RealTimeAudioLab/RTAL-EAI-004-Phoenix-Sound-Sampler/doc/Phoenix_v1_1_0_Arduino_Settings.pdf

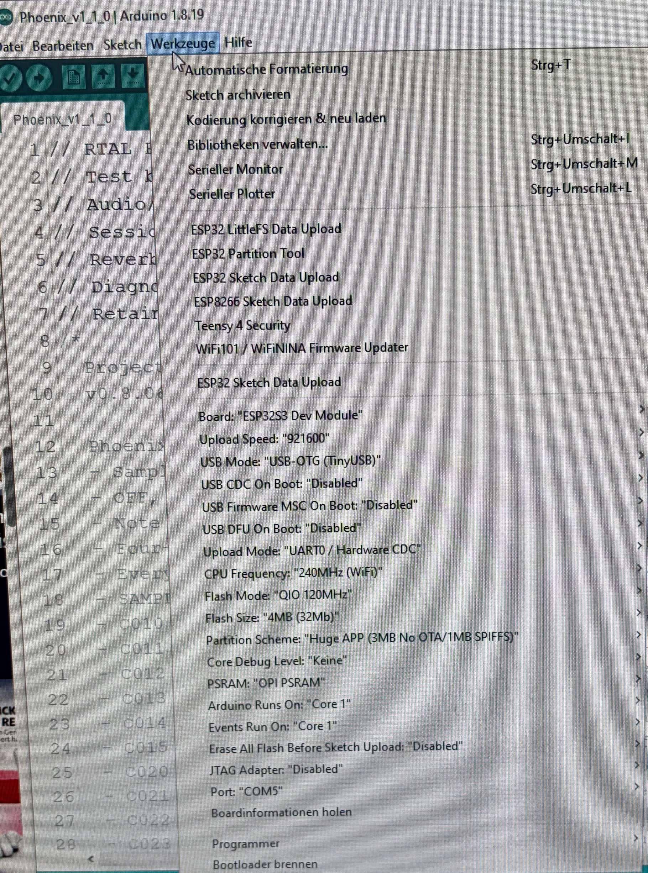
[picture p6: figure]
