RealTimeAudioLab/RTAL-EAI-004-Phoenix-Sound-Sampler/schematic/Phoenix_v1_0_0_Schaltplan.pdf

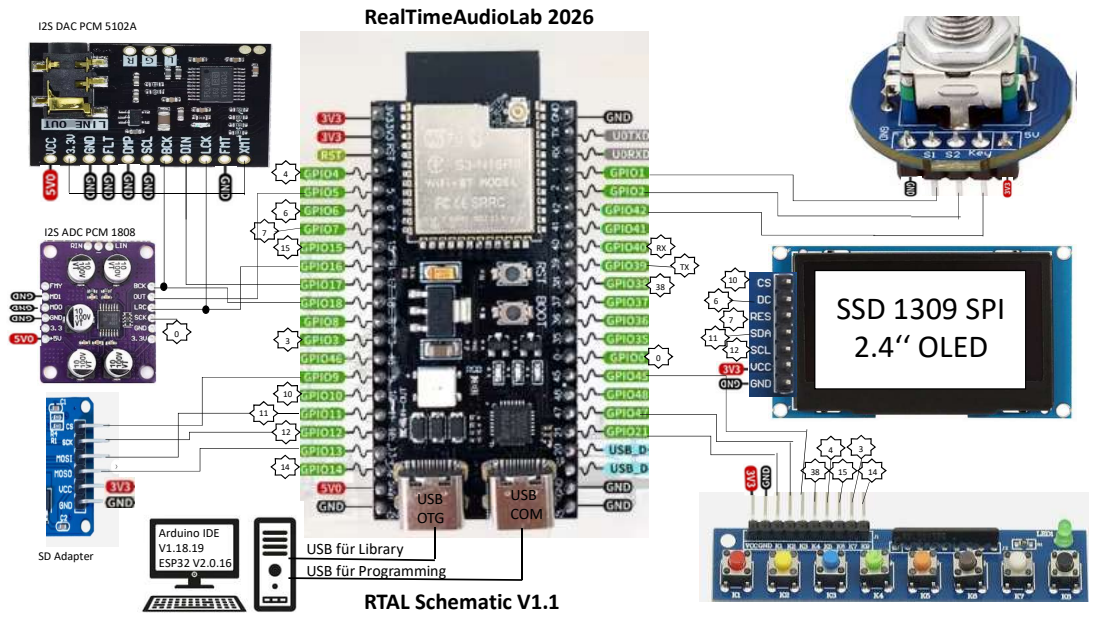
[picture p7: page 1]
Arduino IDE V1.18.19 ESP32 V2.0.16; SSD 1309 SPI 2.4‘‘ OLED; I2S ADC PCM 1808; SD Adapter; USB OTG; USB COM

RealTimeAudioLab 2026 I2S DAC PCM 5102A

USB für Library
USB für Programming
RTAL Schematic V1.1

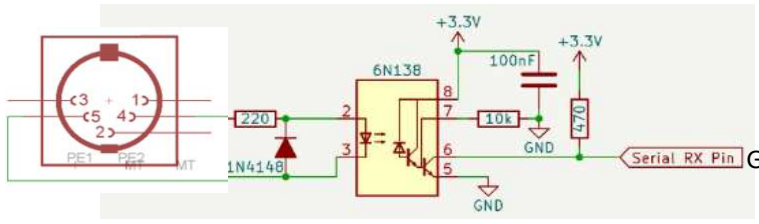
[picture p8: figure]
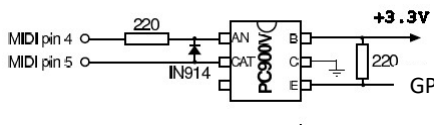
[picture p9: figure]

GPIO 40

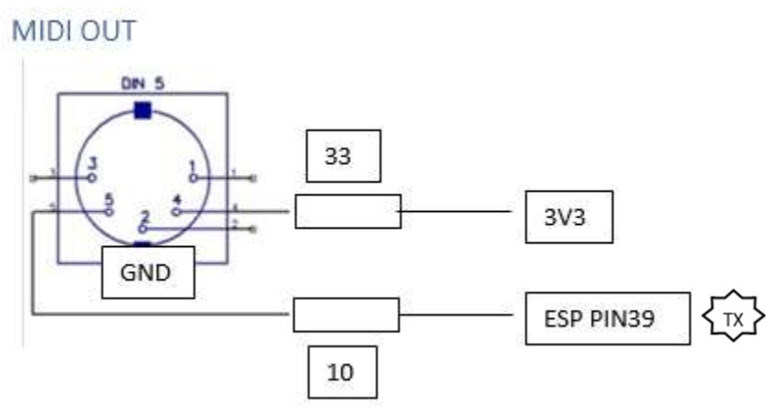
[picture p10: figure]

GPIO 40

MIDI Input mit 6N138 Optokoppler

(alternativ) MIDI Input mit PC900 Optokoppler

MIDI Output
