RealTimeAudioLab/RTAL-EAI-004-Phoenix-Sound-Sampler/sd_card_content/PHOENIX/BANKS/BANK01/BANK.CFG

PROJECT_PHOENIX_BANK=1
BANK_VERSION=15
[GLOBAL]
ECHO_DELAY_MS=375
ECHO_FEEDBACK=30
ECHO_MIX=22
TRIGGER_AUTO=1
TRIGGER_LEVEL=4
REPLAY_REVERSE=0
QUATTRO_MODE=1
[SLOT1]
RECORDED=0
SAMPLE_RATE=32000
FRAME_COUNT=0
SAMPLE_START=0
SAMPLE_END=0
TRIM_ENABLED=0
DC_ENABLED=0
NORMALIZE_ENABLED=0
LOOP=0
LOOP_MODE=0
LOOP_XFADE_MS=0
LOOP_START=0
LOOP_END=0
COARSE=0
FINE=0
ROOT=60
PITCH_BEND_RANGE=2
KEY_LOW=0
KEY_HIGH=127
MIDI_CHANNEL=1
OCTAVE=0
PITCH_TRACK=1
ATTACK_MS=0
DECAY_MS=35
SUSTAIN_PCT=100
RELEASE_MS=35
VINTAGE_PRESET=1
VINTAGE_RATE=4
VINTAGE_BITS=4
VINTAGE_FILTER=1
VINTAGE_JITTER=7
ECHO_SEND=5
SAMPLE_GAIN=100
VELOCITY_AMOUNT=100
LEVEL=92
PAN=0
FILTER_CUTOFF=90
FILTER_RESONANCE=5
FILTER_ENV_AMOUNT=0
FILTER_VELOCITY=0
FILTER_KEYTRACK=0
FILTER_ATTACK_MS=0
FILTER_DECAY_MS=90
FILTER_SUSTAIN=0
FILTER_RELEASE_MS=70
VOICE_MODE=0
VOICE_LIMIT=12
NOTE_PRIORITY=0
GLIDE_MS=0
REPLAY_REVERSE=0
[SLOT2]
RECORDED=0
SAMPLE_RATE=32000
FRAME_COUNT=0
SAMPLE_START=0
SAMPLE_END=0
TRIM_ENABLED=0
DC_ENABLED=0
NORMALIZE_ENABLED=0
LOOP=0
LOOP_MODE=0
LOOP_XFADE_MS=0
LOOP_START=0
LOOP_END=0
COARSE=0
FINE=0
ROOT=60
PITCH_BEND_RANGE=2
KEY_LOW=0
KEY_HIGH=127
MIDI_CHANNEL=2
OCTAVE=0
PITCH_TRACK=1
ATTACK_MS=2
DECAY_MS=60
SUSTAIN_PCT=88
RELEASE_MS=80
VINTAGE_PRESET=2
VINTAGE_RATE=3
VINTAGE_BITS=3
VINTAGE_FILTER=1
VINTAGE_JITTER=3
ECHO_SEND=4
SAMPLE_GAIN=100
VELOCITY_AMOUNT=100
LEVEL=94
PAN=0
FILTER_CUTOFF=56
FILTER_RESONANCE=24
FILTER_ENV_AMOUNT=24
FILTER_VELOCITY=8
FILTER_KEYTRACK=20
FILTER_ATTACK_MS=5
FILTER_DECAY_MS=170
FILTER_SUSTAIN=18
FILTER_RELEASE_MS=250
VOICE_MODE=0
VOICE_LIMIT=12
NOTE_PRIORITY=0
GLIDE_MS=0
REPLAY_REVERSE=0
[SLOT3]
RECORDED=0
SAMPLE_RATE=32000
FRAME_COUNT=0
SAMPLE_START=0
SAMPLE_END=0
TRIM_ENABLED=0
DC_ENABLED=0
NORMALIZE_ENABLED=0
LOOP=0
LOOP_MODE=0
LOOP_XFADE_MS=0
LOOP_START=0
LOOP_END=0
COARSE=0
FINE=0
ROOT=60
PITCH_BEND_RANGE=2
KEY_LOW=0
KEY_HIGH=127
MIDI_CHANNEL=3
OCTAVE=0
PITCH_TRACK=1
ATTACK_MS=5
DECAY_MS=90
SUSTAIN_PCT=85
RELEASE_MS=210
VINTAGE_PRESET=0
VINTAGE_RATE=0
VINTAGE_BITS=0
VINTAGE_FILTER=0
VINTAGE_JITTER=0
ECHO_SEND=34
SAMPLE_GAIN=100
VELOCITY_AMOUNT=100
LEVEL=78
PAN=-8
FILTER_CUTOFF=62
FILTER_RESONANCE=14
FILTER_ENV_AMOUNT=24
FILTER_VELOCITY=8
FILTER_KEYTRACK=16
FILTER_ATTACK_MS=12
FILTER_DECAY_MS=250
FILTER_SUSTAIN=40
FILTER_RELEASE_MS=360
VOICE_MODE=0
VOICE_LIMIT=12
NOTE_PRIORITY=0
GLIDE_MS=0
REPLAY_REVERSE=0
[SLOT4]
RECORDED=0
SAMPLE_RATE=32000
FRAME_COUNT=0
SAMPLE_START=0
SAMPLE_END=0
TRIM_ENABLED=0
DC_ENABLED=0
NORMALIZE_ENABLED=0
LOOP=0
LOOP_MODE=0
LOOP_XFADE_MS=0
LOOP_START=0
LOOP_END=0
COARSE=0
FINE=0
ROOT=60
PITCH_BEND_RANGE=2
KEY_LOW=0
KEY_HIGH=127
MIDI_CHANNEL=4
OCTAVE=0
PITCH_TRACK=1
ATTACK_MS=1
DECAY_MS=55
SUSTAIN_PCT=82
RELEASE_MS=110
VINTAGE_PRESET=3
VINTAGE_RATE=5
VINTAGE_BITS=4
VINTAGE_FILTER=2
VINTAGE_JITTER=9
ECHO_SEND=46
SAMPLE_GAIN=100
VELOCITY_AMOUNT=100
LEVEL=82
PAN=16
FILTER_CUTOFF=78
FILTER_RESONANCE=18
FILTER_ENV_AMOUNT=20
FILTER_VELOCITY=14
FILTER_KEYTRACK=12
FILTER_ATTACK_MS=2
FILTER_DECAY_MS=120
FILTER_SUSTAIN=25
FILTER_RELEASE_MS=220
VOICE_MODE=0
VOICE_LIMIT=12
NOTE_PRIORITY=0
GLIDE_MS=0
REPLAY_REVERSE=0
