RealTimeAudioLab/RTAL-EAI-004-Phoenix-Sound-Sampler/sd_card_content/PHOENIX/BANKS/BANK01/MULTISAMPLE.CFG

VERSION=10

[SLOT1_GROUP1]
LOW=36
HIGH=36
ROOT=36
TRANSPOSE=0
FINE_CENT=0
KEYTRACK_PCT=100
CHOKE=0
ONE_SHOT=1
CHOKE_FADE_MS=8
PLAY_MODE=0
EXCLUSIVE_GROUP=0
RETRIGGER=0
START_PCT=0
END_PCT=100
REVERSE=0
ENABLED=1

[SLOT1_GROUP1_LAYER1]
VEL_LOW=1
VEL_HIGH=127
LEVEL=94
PAN=0
ENABLED=1
RR_MODE=0
LOOP_MODE=0
LOOP_START_PCT=0
LOOP_END_PCT=100
LOOP_XFADE_MS=0
VEL_TO_LEVEL=30
VEL_TO_FILTER=0
RR1_FILE=/PHOENIX/BANKS/BANK01/Kick.wav

[SLOT1_GROUP2]
LOW=38
HIGH=38
ROOT=38
TRANSPOSE=0
FINE_CENT=0
KEYTRACK_PCT=100
CHOKE=0
ONE_SHOT=1
CHOKE_FADE_MS=8
PLAY_MODE=0
EXCLUSIVE_GROUP=0
RETRIGGER=0
START_PCT=0
END_PCT=100
REVERSE=0
ENABLED=1

[SLOT1_GROUP2_LAYER1]
VEL_LOW=1
VEL_HIGH=127
LEVEL=84
PAN=-8
ENABLED=1
RR_MODE=0
LOOP_MODE=0
LOOP_START_PCT=0
LOOP_END_PCT=100
LOOP_XFADE_MS=0
VEL_TO_LEVEL=30
VEL_TO_FILTER=0
RR1_FILE=/PHOENIX/BANKS/BANK01/Snare.wav

[SLOT1_GROUP3]
LOW=46
HIGH=46
ROOT=46
TRANSPOSE=0
FINE_CENT=0
KEYTRACK_PCT=100
CHOKE=0
ONE_SHOT=1
CHOKE_FADE_MS=8
PLAY_MODE=0
EXCLUSIVE_GROUP=0
RETRIGGER=0
START_PCT=0
END_PCT=100
REVERSE=0
ENABLED=1

[SLOT1_GROUP3_LAYER1]
VEL_LOW=1
VEL_HIGH=127
LEVEL=66
PAN=25
ENABLED=1
RR_MODE=0
LOOP_MODE=0
LOOP_START_PCT=0
LOOP_END_PCT=100
LOOP_XFADE_MS=0
VEL_TO_LEVEL=30
VEL_TO_FILTER=0
RR1_FILE=/PHOENIX/BANKS/BANK01/OpenHiHat.wav

[SLOT1_GROUP4]
LOW=56
HIGH=56
ROOT=56
TRANSPOSE=0
FINE_CENT=0
KEYTRACK_PCT=100
CHOKE=0
ONE_SHOT=1
CHOKE_FADE_MS=8
PLAY_MODE=0
EXCLUSIVE_GROUP=0
RETRIGGER=0
START_PCT=0
END_PCT=100
REVERSE=0
ENABLED=1

[SLOT1_GROUP4_LAYER1]
VEL_LOW=1
VEL_HIGH=127
LEVEL=57
PAN=-24
ENABLED=1
RR_MODE=0
LOOP_MODE=0
LOOP_START_PCT=0
LOOP_END_PCT=100
LOOP_XFADE_MS=0
VEL_TO_LEVEL=30
VEL_TO_FILTER=0
RR1_FILE=/PHOENIX/BANKS/BANK01/Cowbell.wav

[SLOT2_GROUP1]
LOW=36
HIGH=72
ROOT=60
TRANSPOSE=0
FINE_CENT=0
KEYTRACK_PCT=100
CHOKE=0
ONE_SHOT=0
CHOKE_FADE_MS=8
PLAY_MODE=0
EXCLUSIVE_GROUP=0
RETRIGGER=0
START_PCT=0
END_PCT=100
REVERSE=0
ENABLED=1

[SLOT2_GROUP1_LAYER1]
VEL_LOW=1
VEL_HIGH=127
LEVEL=100
PAN=0
ENABLED=1
RR_MODE=0
LOOP_MODE=0
LOOP_START_PCT=0
LOOP_END_PCT=100
LOOP_XFADE_MS=0
VEL_TO_LEVEL=30
VEL_TO_FILTER=0
RR1_FILE=/PHOENIX/BANKS/BANK01/Bass_C3.wav

[SLOT3_GROUP1]
LOW=48
HIGH=84
ROOT=60
TRANSPOSE=0
FINE_CENT=0
KEYTRACK_PCT=100
CHOKE=0
ONE_SHOT=0
CHOKE_FADE_MS=8
PLAY_MODE=0
EXCLUSIVE_GROUP=0
RETRIGGER=0
START_PCT=0
END_PCT=100
REVERSE=0
ENABLED=1

[SLOT3_GROUP1_LAYER1]
VEL_LOW=1
VEL_HIGH=80
LEVEL=82
PAN=-15
ENABLED=1
RR_MODE=0
LOOP_MODE=0
LOOP_START_PCT=0
LOOP_END_PCT=100
LOOP_XFADE_MS=0
VEL_TO_LEVEL=30
VEL_TO_FILTER=0
RR1_FILE=/PHOENIX/BANKS/BANK01/Glide_C3.wav

[SLOT3_GROUP1_LAYER2]
VEL_LOW=81
VEL_HIGH=127
LEVEL=72
PAN=12
ENABLED=1
RR_MODE=0
LOOP_MODE=0
LOOP_START_PCT=0
LOOP_END_PCT=100
LOOP_XFADE_MS=0
VEL_TO_LEVEL=30
VEL_TO_FILTER=0
RR1_FILE=/PHOENIX/BANKS/BANK01/Space_C3.wav

[SLOT4_GROUP1]
LOW=48
HIGH=96
ROOT=60
TRANSPOSE=0
FINE_CENT=0
KEYTRACK_PCT=100
CHOKE=0
ONE_SHOT=1
CHOKE_FADE_MS=8
PLAY_MODE=0
EXCLUSIVE_GROUP=0
RETRIGGER=0
START_PCT=0
END_PCT=100
REVERSE=0
ENABLED=1

[SLOT4_GROUP1_LAYER1]
VEL_LOW=1
VEL_HIGH=127
LEVEL=82
PAN=18
ENABLED=1
RR_MODE=0
LOOP_MODE=0
LOOP_START_PCT=0
LOOP_END_PCT=100
LOOP_XFADE_MS=0
VEL_TO_LEVEL=30
VEL_TO_FILTER=0
RR1_FILE=/PHOENIX/BANKS/BANK01/Rave_C3.wav
