RealTimeAudioLab/RTAL-EAI-004-Phoenix-Sound-Sampler/sd_card_content/PHOENIX/BANKS/BANK01/PATTERNS.CFG

VERSION=1
CURRENT_PATTERN=1
CLOCK_MODE=INT
BPM=120

[P1]
TRACK1_LENGTH=16
T1_STEP1=1,36,112,100
T1_STEP2=0,60,100,50
T1_STEP3=1,46,48,100
T1_STEP4=0,60,100,50
T1_STEP5=1,38,88,100
T1_STEP6=0,60,100,50
T1_STEP7=1,46,54,100
T1_STEP8=0,60,100,50
T1_STEP9=1,36,105,100
T1_STEP10=0,60,100,50
T1_STEP11=1,46,50,100
T1_STEP12=0,60,100,50
T1_STEP13=1,38,92,100
T1_STEP14=0,60,100,50
T1_STEP15=1,46,58,100
T1_STEP16=0,60,100,50
TRACK2_LENGTH=16
T2_STEP1=1,48,98,80
T2_STEP2=0,60,100,50
T2_STEP3=0,60,100,50
T2_STEP4=0,60,100,50
T2_STEP5=0,60,100,50
T2_STEP6=0,60,100,50
T2_STEP7=0,60,100,50
T2_STEP8=0,60,100,50
T2_STEP9=1,43,90,80
T2_STEP10=0,60,100,50
T2_STEP11=0,60,100,50
T2_STEP12=0,60,100,50
T2_STEP13=1,46,82,55
T2_STEP14=0,60,100,50
T2_STEP15=0,60,100,50
T2_STEP16=0,60,100,50
TRACK3_LENGTH=16
T3_STEP1=1,60,62,100
T3_STEP2=0,60,100,50
T3_STEP3=0,60,100,50
T3_STEP4=0,60,100,50
T3_STEP5=1,63,66,100
T3_STEP6=0,60,100,50
T3_STEP7=0,60,100,50
T3_STEP8=0,60,100,50
T3_STEP9=1,67,70,100
T3_STEP10=0,60,100,50
T3_STEP11=0,60,100,50
T3_STEP12=0,60,100,50
T3_STEP13=1,58,64,100
T3_STEP14=0,60,100,50
T3_STEP15=0,60,100,50
T3_STEP16=0,60,100,50
TRACK4_LENGTH=16
T4_STEP1=0,60,100,50
T4_STEP2=0,60,100,50
T4_STEP3=0,60,100,50
T4_STEP4=0,60,100,50
T4_STEP5=0,60,100,50
T4_STEP6=0,60,100,50
T4_STEP7=0,60,100,50
T4_STEP8=0,60,100,50
T4_STEP9=0,60,100,50
T4_STEP10=0,60,100,50
T4_STEP11=0,60,100,50
T4_STEP12=0,60,100,50
T4_STEP13=0,60,100,50
T4_STEP14=0,60,100,50
T4_STEP15=0,60,100,50
T4_STEP16=0,60,100,50

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
T4_STEP4=0,60,100,50
T4_STEP5=0,60,100,50
T4_STEP6=0,60,100,50
T4_STEP7=0,60,100,50
T4_STEP8=1,79,92,70
T4_STEP9=0,60,100,50
T4_STEP10=0,60,100,50
T4_STEP11=0,60,100,50
T4_STEP12=0,60,100,50
T4_STEP13=0,60,100,50
T4_STEP14=0,60,100,50
T4_STEP15=0,60,100,50
T4_STEP16=1,72,100,70
