RealTimeAudioLab/RTAL-EAI-004-Phoenix-Sound-Sampler/firmware/Phoenix_v1.1.0/src/PhoenixOS/PhoenixOS.cpp

#include "../PhoenixSystem/PhoenixSerial.h"
#include "../PhoenixSystem/PhoenixFactoryDefaults.h"
#include "PhoenixOS.h"

static constexpr bool PHX_ENABLE_MIDI_CC_DEBUG = false;
static constexpr uint32_t PHX_MIDI_CC_DEBUG_MIN_MS = 100UL;
#include <esp_heap_caps.h>
#include <SD.h>
#include <SPI.h>
#include <stddef.h>
#include <string.h>
#include <strings.h>

static bool phxEnsureSD();
static bool phxBuildBankDir(uint8_t bank, char *out, size_t outSize);


// v1.1.0 DEV1: editable NEW BANK sound template. The format is intentionally
// not BANK.CFG and cannot contain WAV/sample file paths.
static const char *PHX_INIT_SOUND_CFG_PATH = "/PHOENIX/INIT_SOUND.CFG";
static constexpr uint8_t PHX_INIT_SOUND_CFG_VERSION = 1;

struct PhxInitSlotCfg {
  bool multisampleEnabled; uint8_t multisampleLow, multisampleHigh, multisampleRoot;
  int8_t coarse; int16_t fineCent; uint8_t rootNote; int8_t octave; bool pitchTracking; uint8_t pitchBendRange;
  uint16_t attackMs, decayMs; uint8_t sustainPct; uint16_t releaseMs;
  uint8_t level; int8_t pan; uint8_t sampleGainPct, velocityAmountPct;
  uint8_t filterCutoff, filterResonance; int8_t filterEnvAmount; uint8_t filterVelocityAmount, filterKeytrack;
  uint16_t filterAttackMs, filterDecayMs; uint8_t filterSustainPct; uint16_t filterReleaseMs;
  uint8_t vintagePreset, vintageSampleRate, vintageBitDepth, vintageFilter, vintageJitter;
  uint8_t voiceMode, voiceLimit, notePriority; uint16_t glideMs;
  uint8_t echoSend; uint8_t reverbSend; uint8_t quattroLow, quattroHigh, quattroMidiChannel;
};
struct PhxInitSoundCfg {
  uint8_t quattroMode; uint16_t echoDelayMs; uint8_t echoFeedback, echoMix; uint8_t reverbSize,reverbDecay,reverbDamp,reverbMix; PhxInitSlotCfg slot[4];
};

static void phxInitSoundFactory(PhxInitSoundCfg &c) {
  c.quattroMode=PhoenixFactoryDefaults::QUATTRO_MODE;
  c.echoDelayMs=PhoenixFactoryDefaults::ECHO_DELAY_MS; c.echoFeedback=PhoenixFactoryDefaults::ECHO_FEEDBACK; c.echoMix=PhoenixFactoryDefaults::ECHO_MIX; c.reverbSize=PhoenixFactoryDefaults::REVERB_SIZE; c.reverbDecay=PhoenixFactoryDefaults::REVERB_DECAY; c.reverbDamp=PhoenixFactoryDefaults::REVERB_DAMP; c.reverbMix=PhoenixFactoryDefaults::REVERB_MIX;
  for(uint8_t i=0;i<4;++i){ const auto &d=PhoenixFactoryDefaults::SLOT[i]; auto &o=c.slot[i];
    o.multisampleEnabled=d.multisampleEnabled; o.multisampleLow=d.multisampleLow; o.multisampleHigh=d.multisampleHigh; o.multisampleRoot=d.multisampleRoot;
    o.coarse=d.coarse;o.fineCent=d.fineCent;o.rootNote=d.rootNote;o.octave=d.octave;o.pitchTracking=d.pitchTracking;o.pitchBendRange=d.pitchBendRange;
    o.attackMs=d.attackMs;o.decayMs=d.decayMs;o.sustainPct=d.sustainPct;o.releaseMs=d.releaseMs;o.level=d.level;o.pan=d.pan;o.sampleGainPct=d.sampleGainPct;o.velocityAmountPct=d.velocityAmountPct;
    o.filterCutoff=d.filterCutoff;o.filterResonance=d.filterResonance;o.filterEnvAmount=d.filterEnvAmount;o.filterVelocityAmount=d.filterVelocityAmount;o.filterKeytrack=d.filterKeytrack;
    o.filterAttackMs=d.filterAttackMs;o.filterDecayMs=d.filterDecayMs;o.filterSustainPct=d.filterSustainPct;o.filterReleaseMs=d.filterReleaseMs;
    o.vintagePreset=d.vintagePreset;o.vintageSampleRate=d.vintageSampleRate;o.vintageBitDepth=d.vintageBitDepth;o.vintageFilter=d.vintageFilter;o.vintageJitter=d.vintageJitter;
    o.voiceMode=d.voiceMode;o.voiceLimit=d.voiceLimit;o.notePriority=d.notePriority;o.glideMs=d.glideMs;o.echoSend=d.echoSend;o.reverbSend=d.reverbSend;
    o.quattroLow=d.quattroLow;o.quattroHigh=d.quattroHigh;o.quattroMidiChannel=d.quattroMidiChannel;
  }
}
static int phxInitInt(const String &v,int lo,int hi){return constrain(v.toInt(),lo,hi);}
static bool phxLoadInitSoundCfg(PhxInitSoundCfg &c) {
  phxInitSoundFactory(c);
  if(!phxEnsureSD()) return false;
  File f=SD.open(PHX_INIT_SOUND_CFG_PATH,FILE_READ);
  if(!f) return false;
  String section=""; bool versionOk=false;
  while(f.available()){
    String line=f.readStringUntil('\n'); line.trim();
    if(!line.length()||line[0]=='#'||line[0]==';') continue;
    if(line[0]=='[' && line.endsWith("]")){section=line.substring(1,line.length()-1);section.toUpperCase();continue;}
    int eq=line.indexOf('='); if(eq<1) continue;
    String k=line.substring(0,eq); k.trim(); k.toUpperCase(); String v=line.substring(eq+1); v.trim();
    if(section.length()==0){if(k=="VERSION") versionOk=(v.toInt()==PHX_INIT_SOUND_CFG_VERSION); continue;}
    if(section=="GLOBAL"){if(k=="QUATTRO_MODE") c.quattroMode=(uint8_t)phxInitInt(v,0,1); continue;}
    if(section=="FX"){
      if(k=="ECHO_DELAY_MS") c.echoDelayMs=(uint16_t)phxInitInt(v,1,2000);
      else if(k=="ECHO_FEEDBACK") c.echoFeedback=(uint8_t)phxInitInt(v,0,95);
      else if(k=="ECHO_MIX") c.echoMix=(uint8_t)phxInitInt(v,0,100);
      else if(k=="REVERB_SIZE") c.reverbSize=(uint8_t)phxInitInt(v,0,100);
      else if(k=="REVERB_DECAY") c.reverbDecay=(uint8_t)phxInitInt(v,0,100);
      else if(k=="REVERB_DAMP") c.reverbDamp=(uint8_t)phxInitInt(v,0,100);
      else if(k=="REVERB_MIX") c.reverbMix=(uint8_t)phxInitInt(v,0,100);
      continue;
    }
    if(section.startsWith("SLOT")){
      int si=section.substring(4).toInt()-1; if(si<0||si>3) continue; auto &d=c.slot[si];
      if(k=="MULTISAMPLE_ENABLED")d.multisampleEnabled=(v.toInt()!=0); else if(k=="LOW")d.multisampleLow=(uint8_t)phxInitInt(v,0,127); else if(k=="HIGH")d.multisampleHigh=(uint8_t)phxInitInt(v,0,127); else if(k=="ROOT")d.multisampleRoot=(uint8_t)phxInitInt(v,0,127);
      else if(k=="COARSE")d.coarse=(int8_t)phxInitInt(v,-24,24); else if(k=="FINE_CENT")d.fineCent=(int16_t)phxInitInt(v,-100,100); else if(k=="ROOT_NOTE")d.rootNote=(uint8_t)phxInitInt(v,0,127); else if(k=="OCTAVE")d.octave=(int8_t)phxInitInt(v,-2,2); else if(k=="PITCH_TRACKING")d.pitchTracking=(v.toInt()!=0); else if(k=="PITCH_BEND_RANGE")d.pitchBendRange=(uint8_t)phxInitInt(v,0,24);
      else if(k=="ATTACK_MS")d.attackMs=(uint16_t)phxInitInt(v,0,2000); else if(k=="DECAY_MS")d.decayMs=(uint16_t)phxInitInt(v,0,2000); else if(k=="SUSTAIN_PCT")d.sustainPct=(uint8_t)phxInitInt(v,0,100); else if(k=="RELEASE_MS")d.releaseMs=(uint16_t)phxInitInt(v,0,2000);
      else if(k=="LEVEL")d.level=(uint8_t)phxInitInt(v,0,100); else if(k=="PAN")d.pan=(int8_t)phxInitInt(v,-100,100); else if(k=="SAMPLE_GAIN_PCT")d.sampleGainPct=(uint8_t)phxInitInt(v,0,200); else if(k=="VELOCITY_AMOUNT_PCT")d.velocityAmountPct=(uint8_t)phxInitInt(v,0,100);
      else if(k=="FILTER_CUTOFF")d.filterCutoff=(uint8_t)phxInitInt(v,0,100); else if(k=="FILTER_RESONANCE")d.filterResonance=(uint8_t)phxInitInt(v,0,100); else if(k=="FILTER_ENV_AMOUNT")d.filterEnvAmount=(int8_t)phxInitInt(v,-100,100); else if(k=="FILTER_VELOCITY")d.filterVelocityAmount=(uint8_t)phxInitInt(v,0,100); else if(k=="FILTER_KEYTRACK")d.filterKeytrack=(uint8_t)phxInitInt(v,0,100);
      else if(k=="FILTER_ATTACK_MS")d.filterAttackMs=(uint16_t)phxInitInt(v,0,2000); else if(k=="FILTER_DECAY_MS")d.filterDecayMs=(uint16_t)phxInitInt(v,0,2000); else if(k=="FILTER_SUSTAIN_PCT")d.filterSustainPct=(uint8_t)phxInitInt(v,0,100); else if(k=="FILTER_RELEASE_MS")d.filterReleaseMs=(uint16_t)phxInitInt(v,0,2000);
      else if(k=="VINTAGE_PRESET")d.vintagePreset=(uint8_t)phxInitInt(v,0,15); else if(k=="VINTAGE_SAMPLE_RATE")d.vintageSampleRate=(uint8_t)phxInitInt(v,0,100); else if(k=="VINTAGE_BIT_DEPTH")d.vintageBitDepth=(uint8_t)phxInitInt(v,0,100); else if(k=="VINTAGE_FILTER")d.vintageFilter=(uint8_t)phxInitInt(v,0,100); else if(k=="VINTAGE_JITTER")d.vintageJitter=(uint8_t)phxInitInt(v,0,100);
      else if(k=="VOICE_MODE")d.voiceMode=(uint8_t)phxInitInt(v,0,2); else if(k=="VOICE_LIMIT")d.voiceLimit=(uint8_t)phxInitInt(v,1,12); else if(k=="NOTE_PRIORITY")d.notePriority=(uint8_t)phxInitInt(v,0,2); else if(k=="GLIDE_MS")d.glideMs=(uint16_t)phxInitInt(v,0,2000);
      else if(k=="ECHO_SEND")d.echoSend=(uint8_t)phxInitInt(v,0,100); else if(k=="REVERB_SEND")d.reverbSend=(uint8_t)phxInitInt(v,0,100); else if(k=="QUATTRO_LOW")d.quattroLow=(uint8_t)phxInitInt(v,0,127); else if(k=="QUATTRO_HIGH")d.quattroHigh=(uint8_t)phxInitInt(v,0,127); else if(k=="MIDI_CHANNEL")d.quattroMidiChannel=(uint8_t)phxInitInt(v,1,16);
    }
  }
  f.close();
  if(!versionOk){phxInitSoundFactory(c);return false;}
  for(uint8_t i=0;i<4;++i){if(c.slot[i].multisampleHigh<c.slot[i].multisampleLow)c.slot[i].multisampleHigh=c.slot[i].multisampleLow;if(c.slot[i].quattroHigh<c.slot[i].quattroLow)c.slot[i].quattroHigh=c.slot[i].quattroLow;}
  return true;
}

PhoenixOS::PhoenixOS(PhoenixGUI &gui, PhoenixScreenManager &screens, PhoenixInputManager &input, PhoenixAudioManager &audio)
: _gui(gui), _screens(screens), _input(input), _audio(audio), _lastDrawMs(0), _perfWindowStartMs(0), _perfLoopAccumUs(0), _perfLoopCount(0), _perfLoopMaxUs(0), _perfDrawAccumUs(0), _perfDrawCount(0), _perfDrawMaxUs(0), _diagStartMs(0), _diagLoopAvgUs(0), _diagLoopPeakUs(0), _diagDrawAvgUs(0), _diagDrawPeakUs(0), _diagGuiFps10(0), _diagLastPublishMs(0), _midiCounter(nullptr), _seqLastStepMs(0), _seqWasRunning(false), _seqPreviewHeld(false), _seqPreviewTrack(0), _seqPreviewNote(60), _seqPreviewOffMs(0), _seqMidiTransportPending(0), _seqMidiLastClockUs(0), _seqMidiClockPeriodUs(0), _seqExtTickPhase(0), _seqExtLastSeenMs(0), _seqLastPattern(0), _seqDroppedClockTicks(0), _seqIdleClockTicksIgnored(0), _seqTransportStartCount(0), _seqTransportContinueCount(0), _seqTransportStopCount(0), _seqPatternTransitionCount(0), _seqGateRecycleCount(0), _seqForcedGateReleaseCount(0), _seqClockQueueDrops(0), _seqClockBatchMax(0), _seqStepLateMaxUs(0), _seqStepEventCount(0), _seqLastStepClockUs(0), _integrationBankQuiesceCount(0), _integrationBankLoadFailCount(0), _integrationBankSaveFailCount(0), _integrationStaleClockTicksCleared(0), _integrationActiveVoiceGuardCount(0), _songPatternStepCounter(0), _lastProgressPercent(255), _lastProgressDrawMs(0), _bootSessionRestoreActive(false), _bootSessionBank(0), _lastSessionSaveMs(0), _sessionBankCache(0), _sessionScreenCache(255), _sessionSlotCache(255), _sessionPendingBank(0), _sessionPendingScreen(255), _sessionPendingSlot(255), _sessionDirty(false), _sessionLastChangeMs(0) {
  _progressLabel[0] = 0;
  _midiEchoSync = false;
  _midiEchoTimeValue = 32;
  _midiModulationValue = 0;
  _midiLearnActive = false;
  _midiLearnParameter = 0;
  _midiLearnCcPending = -1;
  _sampleAnalysisPending = false;
  _sampleAnalysisSlot = 0;
  memset(_sampleProcessingRecalcDue, 0, sizeof(_sampleProcessingRecalcDue));
  _recordActivePrev = false;
  _recordActiveSlot = 0;
  _newBankPendingSave = false;
  _msConfigDirty = false;
  _msConfigDirtyBank = 1;
  _msConfigLastEditMs = 0;
  _msConfigDeferredSaveCount = 0;
  memset(_waveBins, 0, sizeof(_waveBins));
  memset((void*)_seqClockUs,0,sizeof(_seqClockUs)); _seqClockWrite=_seqClockRead=0;
  memset((void*)_seqRtStepOn,0,sizeof(_seqRtStepOn));
  memset((void*)_seqRtStepNote,60,sizeof(_seqRtStepNote));
  memset((void*)_seqRtStepVelocity,100,sizeof(_seqRtStepVelocity));
  memset((void*)_seqRtStepGate,80,sizeof(_seqRtStepGate));
  memset(_midiNormalizeArmed, 1, sizeof(_midiNormalizeArmed));
}



void PhoenixOS::markMultisampleConfigDirty() {
  _msConfigDirty = true;
  _msConfigDirtyBank = _screens.selectedBank();
  _msConfigLastEditMs = millis();
  _screens.setBankDirty(true);
}

bool PhoenixOS::saveDirtyMultisampleConfig() {
  if (!_msConfigDirty) return true;
  char dir[40];
  if (!phxEnsureSD() || !phxBuildBankDir(_msConfigDirtyBank, dir, sizeof(dir))) return false;
  SD.mkdir(dir);
  const bool ok = _audio.saveMultisampleConfig(dir);
  if (ok) {
    _msConfigDirty = false;
    ++_msConfigDeferredSaveCount;
  }
  return ok;
}

void PhoenixOS::processDeferredMultisampleConfigSave() {
  if (!_msConfigDirty) return;

  // Do not perform FAT/SD writes while either internal or external sequencer
  // transport (or Song playback) is active. The live edit is already applied
  // to the audio engine in RAM, so there is nothing timing-critical to do here.
  const bool sequencerBusy = _screens.sequencerRunning() || _seqRtRunning ||
                             _seqWasRunning || _songManager.playing();
  if (sequencerBusy) return;

  // Coalesce fast encoder detents into one atomic MULTISAMPLE.CFG write.
  // 1200 ms feels immediate after editing, while eliminating write storms.
  const uint32_t now = millis();
  if ((uint32_t)(now - _msConfigLastEditMs) < 1200UL) return;

  (void)saveDirtyMultisampleConfig();
}

void PhoenixOS::progressCallback(uint8_t percent, void *context) {
  if (!context) return;
  static_cast<PhoenixOS*>(context)->showProgress(percent);
}

void PhoenixOS::showProgress(uint8_t percent) {
  const uint32_t now = millis();
  if (percent == _lastProgressPercent && percent != 100) return;
  if (_lastProgressPercent != 255 && percent < _lastProgressPercent && percent != 0) return;
  if (percent != 0 && percent != 100 && (uint32_t)(now - _lastProgressDrawMs) < 60UL) return;
  _lastProgressPercent = percent;
  _lastProgressDrawMs = now;
  char msg[24];
  snprintf(msg, sizeof(msg), "%s %u%%", _progressLabel[0] ? _progressLabel : "WORKING", (unsigned)percent);
  if (_bootSessionRestoreActive) {
    char bootMsg[24];
    snprintf(bootMsg, sizeof(bootMsg), "BANK %02u SAMPLES %u%%", (unsigned)_bootSessionBank, (unsigned)percent);
    // Keep the boot screen authoritative during automatic session restore.
    // The audio loader's percentage now becomes visible instead of drawing a
    // transient Disk Utilities page behind the splash screen.
    const uint8_t activity = (uint8_t)(55U + (((uint16_t)percent * 35U) / 100U));
    _gui.drawBootStatus(bootMsg, activity);
  } else {
    if (!strncmp(_progressLabel, "IMPORTING", 9)) _screens.setBrowserStatus(msg);
    else if (!strncmp(_progressLabel, "MS LOAD", 7)) _screens.setMultisampleLoadStatus(msg);
    else _screens.setDiskStatus(msg);
    drawScreensTimed();
  }
}


static bool phxEnsureSD() {
  // v0.7.36: Do not permanently lock the storage layer into a failed state.
  // A card that was missing during boot can be inserted later and is retried
  // at a deliberately low rate to avoid blocking the control loop.
  static uint32_t lastTryMs = 0;
  const uint32_t now = millis();
  if (SD.cardType() != CARD_NONE) return true;
  if (lastTryMs != 0 && (uint32_t)(now - lastTryMs) < 2000UL) return false;
  lastTryMs = now;
  return SD.begin(9, SPI, 10000000UL);
}


// v1.1.0 FINAL baseline: Phoenix session persistence lives entirely on SD.
// The ESP32 default NVS partition may legitimately belong to another firmware,
// so Phoenix session persistence must not
// create, modify, enumerate or erase NVS for bank/screen/slot restore.
//
// Two alternating fixed-size binary records provide power-loss resilience:
// the newest valid CRC record wins, while an interrupted write can invalidate
// only the target slot. LASTBANK.CFG remains a legacy bank-only fallback.
static const char *PHX_LASTBANK_PATH = "/PHOENIX/LASTBANK.CFG";
static const char *PHX_SESSION_A_PATH = "/PHOENIX/SESSION_A.BIN";
static const char *PHX_SESSION_B_PATH = "/PHOENIX/SESSION_B.BIN";
static constexpr uint32_t PHX_SESSION_SD_MAGIC = 0x31535850UL; // "PXS1" LE
static constexpr uint16_t PHX_SESSION_SD_VERSION = 1U;

struct __attribute__((packed)) PhxSessionSdRecord {
  uint32_t magic;
  uint16_t version;
  uint16_t size;
  uint32_t sequence;
  uint8_t bank;
  uint8_t screen;
  uint8_t slot;
  uint8_t reserved;
  uint32_t crc32;
};
static_assert(sizeof(PhxSessionSdRecord) == 20, "PhxSessionSdRecord size");

static uint32_t phxSessionCrc32Bytes(const uint8_t *data, size_t len) {
  uint32_t crc = 0xFFFFFFFFUL;
  for (size_t i = 0; i < len; ++i) {
    crc ^= (uint32_t)data[i];
    for (uint8_t bit = 0; bit < 8U; ++bit)
      crc = (crc >> 1) ^ (0xEDB88320UL & (uint32_t)-(int32_t)(crc & 1U));
  }
  return ~crc;
}

static uint32_t phxSessionRecordCrc(const PhxSessionSdRecord &r) {
  return phxSessionCrc32Bytes((const uint8_t *)&r, offsetof(PhxSessionSdRecord, crc32));
}

static bool phxSessionSequenceNewer(uint32_t a, uint32_t b) {
  return (int32_t)(a - b) > 0;
}

static bool phxValidateSessionRecord(const PhxSessionSdRecord &r) {
  if (r.magic != PHX_SESSION_SD_MAGIC || r.version != PHX_SESSION_SD_VERSION ||
      r.size != sizeof(PhxSessionSdRecord)) return false;
  if (r.bank < 1U || r.bank > 99U || r.slot > 3U) return false;
  return r.crc32 == phxSessionRecordCrc(r);
}

static bool phxReadSessionRecord(const char *path, PhxSessionSdRecord &out) {
  memset(&out, 0, sizeof(out));
  if (!path || !phxEnsureSD() || !SD.exists(path)) return false;
  File f = SD.open(path, FILE_READ);
  if (!f) return false;
  if ((size_t)f.size() != sizeof(PhxSessionSdRecord)) { f.close(); return false; }
  const size_t got = f.read((uint8_t *)&out, sizeof(out));
  f.close();
  return got == sizeof(out) && phxValidateSessionRecord(out);
}

static bool phxWriteSessionRecord(const char *path, const PhxSessionSdRecord &r) {
  if (!path || !phxEnsureSD()) return false;
  SD.mkdir("/PHOENIX");
  // Remove only the target A/B slot. The other slot remains the rollback copy.
  if (SD.exists(path)) SD.remove(path);
  File f = SD.open(path, FILE_WRITE);
  if (!f) return false;
  const size_t wrote = f.write((const uint8_t *)&r, sizeof(r));
  f.flush();
  const bool ioOk = (wrote == sizeof(r)) && (bool)f;
  f.close();
  if (!ioOk) return false;
  PhxSessionSdRecord verify = {};
  return phxReadSessionRecord(path, verify) &&
         memcmp(&verify, &r, sizeof(r)) == 0;
}

// Cached journal position. It is initialized by phxReadSessionSd() during boot
// or lazily before the first write if no session existed yet.
static bool phxSessionJournalReady = false;
static uint32_t phxSessionLastSequence = 0;
static uint8_t phxSessionNextSlot = 0; // 0=A, 1=B

static bool phxReadSessionSd(uint8_t &bankOut, uint8_t &screenOut,
                             uint8_t &slotOut) {
  bankOut = 0;
  screenOut = 5; // SCR_MAIN
  slotOut = 0;

  PhxSessionSdRecord a = {}, b = {};
  const bool aOk = phxReadSessionRecord(PHX_SESSION_A_PATH, a);
  const bool bOk = phxReadSessionRecord(PHX_SESSION_B_PATH, b);

  const PhxSessionSdRecord *best = nullptr;
  uint8_t bestSlot = 0;
  if (aOk && bOk) {
    if (phxSessionSequenceNewer(b.sequence, a.sequence)) { best = &b; bestSlot = 1; }
    else { best = &a; bestSlot = 0; }
  } else if (aOk) { best = &a; bestSlot = 0; }
  else if (bOk) { best = &b; bestSlot = 1; }

  phxSessionJournalReady = true;
  if (!best) {
    phxSessionLastSequence = 0;
    phxSessionNextSlot = 0;
    PHX_INFO_PRINTF("PHX SESSION SD LOAD A=%s B=%s selected=NONE\n",
                    aOk ? "OK" : "BAD", bOk ? "OK" : "BAD");
    return false;
  }

  phxSessionLastSequence = best->sequence;
  phxSessionNextSlot = bestSlot ^ 1U;
  bankOut = best->bank;
  screenOut = best->screen;
  slotOut = best->slot & 3U;
  PHX_INFO_PRINTF("PHX SESSION SD LOAD A=%s B=%s selected=%c seq=%lu bank=%u screen=%u slot=%u\n",
                  aOk ? "OK" : "BAD", bOk ? "OK" : "BAD",
                  bestSlot ? 'B' : 'A', (unsigned long)best->sequence,
                  (unsigned)bankOut, (unsigned)screenOut, (unsigned)slotOut);
  return true;
}

static bool phxWriteSessionSd(uint8_t bank, uint8_t screen, uint8_t slot) {
  if (bank < 1U || bank > 99U || slot > 3U || !phxEnsureSD()) return false;

  if (!phxSessionJournalReady) {
    uint8_t rb = 0, rs = 5, rl = 0;
    (void)phxReadSessionSd(rb, rs, rl);
  }

  PhxSessionSdRecord r = {};
  r.magic = PHX_SESSION_SD_MAGIC;
  r.version = PHX_SESSION_SD_VERSION;
  r.size = sizeof(PhxSessionSdRecord);
  r.sequence = phxSessionLastSequence + 1U;
  r.bank = bank;
  r.screen = screen;
  r.slot = slot & 3U;
  r.reserved = 0;
  r.crc32 = phxSessionRecordCrc(r);

  const uint8_t target = phxSessionNextSlot & 1U;
  const char *path = target ? PHX_SESSION_B_PATH : PHX_SESSION_A_PATH;
  const bool ok = phxWriteSessionRecord(path, r);
  PHX_INFO_PRINTF("PHX SESSION SD WRITE target=%c seq=%lu bank=%u screen=%u slot=%u crc=0x%08lX verify=%s\n",
                  target ? 'B' : 'A', (unsigned long)r.sequence,
                  (unsigned)bank, (unsigned)screen, (unsigned)(slot & 3U),
                  (unsigned long)r.crc32, ok ? "OK" : "FAIL");
  if (ok) {
    phxSessionLastSequence = r.sequence;
    phxSessionNextSlot = target ^ 1U;
  }
  return ok;
}

static bool phxWriteLastBankFallback(uint8_t bank) {
  if (bank < 1 || bank > 99 || !phxEnsureSD()) return false;
  SD.mkdir("/PHOENIX");
  // Keep the legacy file compact; an old longer file must not leave trailing text.
  if (SD.exists(PHX_LASTBANK_PATH)) SD.remove(PHX_LASTBANK_PATH);
  File f = SD.open(PHX_LASTBANK_PATH, FILE_WRITE);
  if (!f) return false;
  f.printf("VERSION=1\nBANK=%u\n", (unsigned)bank);
  f.flush();
  const bool ok = (bool)f;
  f.close();
  return ok;
}

static bool phxReadLastBankFallback(uint8_t &bankOut) {
  bankOut = 0;
  if (!phxEnsureSD() || !SD.exists(PHX_LASTBANK_PATH)) return false;
  File f = SD.open(PHX_LASTBANK_PATH, FILE_READ);
  if (!f) return false;
  int version = 0, bank = 0;
  while (f.available()) {
    String line = f.readStringUntil('\n');
    line.trim();
    if (line.startsWith("VERSION=")) version = line.substring(8).toInt();
    else if (line.startsWith("BANK=")) bank = line.substring(5).toInt();
  }
  f.close();
  if (version != 1 || bank < 1 || bank > 99) return false;
  bankOut = (uint8_t)bank;
  return true;
}

// v0.7.13c FIX8D:
// All Phoenix project banks now live below /PHOENIX/BANKS.
// The old legacy path /PHXBNK01 is intentionally no longer used.
static bool phxBuildBankDir(uint8_t bank, char *out, size_t outSize) {
  if (!out || outSize == 0) return false;
  if (bank < 1) bank = 1;
  if (bank > 99) bank = 99;

  SD.mkdir("/PHOENIX");
  SD.mkdir("/PHOENIX/BANKS");
  snprintf(out, outSize, "/PHOENIX/BANKS/BANK%02u", (unsigned)bank);
  return true;
}

static bool phxBankExists(const char *dir) {
  if (!dir || !dir[0] || !SD.exists(dir)) return false;

  char path[96];

  // A conventional Phoenix bank is valid when BANK.CFG exists.
  snprintf(path, sizeof(path), "%s/BANK.CFG", dir);
  if (SD.exists(path)) return true;

  // v0.7.24b: A multisample-only bank is valid as well. This allows a bank
  // containing only MULTISAMPLE.CFG and external WAV references to be loaded.
  snprintf(path, sizeof(path), "%s/MULTISAMPLE.CFG", dir);
  if (SD.exists(path)) return true;

  // Legacy / single-sample banks may consist only of SLOT1.WAV ... SLOT4.WAV.
  for (uint8_t i = 1; i <= 4; ++i) {
    snprintf(path, sizeof(path), "%s/SLOT%u.WAV", dir, (unsigned)i);
    if (SD.exists(path)) return true;
  }

  return false;
}


// v1.0.3: RAM cache for Disk Utilities bank occupancy.
// Browsing/selecting banks must not touch SD/FAT while a song is running.
static bool phxBankUsedCache[100] = { false };
static bool phxBankCacheValid = false;

static inline void phxBankCacheSet(uint8_t bank, bool used) {
  if (bank >= 1U && bank <= 99U) phxBankUsedCache[bank] = used;
}

static inline bool phxBankCacheGet(uint8_t bank) {
  return (bank >= 1U && bank <= 99U && phxBankCacheValid) ? phxBankUsedCache[bank] : false;
}

// v1.0.5: inspect the already-open BANKxx directory instead of issuing
// multiple SD.exists() path lookups for BANK.CFG, MULTISAMPLE.CFG and SLOTx.WAV.
// This keeps boot cache construction responsive on cards with many files.
static bool phxBankDirectoryLooksUsed(File &dirEntry) {
  if (!dirEntry || !dirEntry.isDirectory()) return false;

  File child = dirEntry.openNextFile();
  while (child) {
    if (!child.isDirectory()) {
      const char *fullName = child.name();
      const char *name = fullName ? strrchr(fullName, '/') : nullptr;
      name = name ? name + 1 : fullName;
      if (name) {
        if (!strcasecmp(name, "BANK.CFG") || !strcasecmp(name, "MULTISAMPLE.CFG") ||
            !strcasecmp(name, "SLOT1.WAV") || !strcasecmp(name, "SLOT2.WAV") ||
            !strcasecmp(name, "SLOT3.WAV") || !strcasecmp(name, "SLOT4.WAV")) {
          child.close();
          return true;
        }
      }
    }
    child.close();
    vTaskDelay(pdMS_TO_TICKS(1));
    child = dirEntry.openNextFile();
  }
  return false;
}

static bool phxRefreshBankCache(PhoenixGUI *bootGui = nullptr) {
  memset(phxBankUsedCache, 0, sizeof(phxBankUsedCache));
  phxBankCacheValid = false;

  if (!phxEnsureSD()) {
    PHX_ERROR_PRINTLN("V1.0.5 BANK CACHE no SD");
    return false;
  }

  SD.mkdir("/PHOENIX");
  SD.mkdir("/PHOENIX/BANKS");

  File root = SD.open("/PHOENIX/BANKS");
  if (!root || !root.isDirectory()) {
    if (root) root.close();
    PHX_ERROR_PRINTLN("V1.0.5 BANK CACHE open failed");
    return false;
  }

  uint8_t found = 0;
  uint16_t scannedEntries = 0;
  uint32_t lastBootDrawMs = 0;
  File entry = root.openNextFile();
  while (entry) {
    ++scannedEntries;
    if (entry.isDirectory()) {
      const char *fullName = entry.name();
      const char *name = fullName ? strrchr(fullName, '/') : nullptr;
      name = name ? name + 1 : fullName;

      if (name && strlen(name) == 6U &&
          name[0] == 'B' && name[1] == 'A' && name[2] == 'N' && name[3] == 'K' &&
          name[4] >= '0' && name[4] <= '9' && name[5] >= '0' && name[5] <= '9') {
        const uint8_t bank = (uint8_t)((name[4] - '0') * 10 + (name[5] - '0'));
        if (bank >= 1U && bank <= 99U) {
          const bool used = phxBankDirectoryLooksUsed(entry);
          phxBankUsedCache[bank] = used;
          if (used) ++found;
        }
      }
    }

    // v1.0.5 Boot UX: update at a low rate to show activity without turning
    // OLED SPI traffic itself into the dominant part of the directory scan.
    if (bootGui) {
      const uint32_t now = millis();
      if (lastBootDrawMs == 0U || (uint32_t)(now - lastBootDrawMs) >= 120UL) {
        char status[24];
        snprintf(status, sizeof(status), "SCANNING BANKS %u", (unsigned)found);
        const uint8_t activity = (uint8_t)(20U + ((scannedEntries * 7U) % 76U));
        bootGui->drawBootStatus(status, activity);
        lastBootDrawMs = now;
      }
    }

    entry.close();
    vTaskDelay(pdMS_TO_TICKS(1));
    entry = root.openNextFile();
  }
  root.close();

  phxBankCacheValid = true;
  PHX_INFO_PRINTF("V1.0.5 BANK CACHE ready used=%u\n", (unsigned)found);
  return true;
}


void PhoenixOS::syncNewBankStateToScreens() {
  uint8_t lo[4],hi[4],ch[4],send[4];
  for(uint8_t i=0;i<4;++i){lo[i]=_audio.quattroKeyLow(i);hi[i]=_audio.quattroKeyHigh(i);ch[i]=_audio.quattroMidiChannel(i);send[i]=_audio.echoSend(i);}
  _screens.setQuattroStatus(_audio.quattroMode(),lo,hi,ch);
  _screens.setEchoStatus(_audio.echoDelayMs(),_audio.echoFeedback(),_audio.echoMix(),send);
  uint8_t rsend[4]; for(uint8_t i=0;i<4;++i)rsend[i]=_audio.reverbSend(i); _screens.setReverbStatus(_audio.reverbSize(),_audio.reverbDecay(),_audio.reverbDamp(),_audio.reverbMix(),rsend);
  _screens.setPlaybackReverseMode(_audio.lastReplayReverse());
  for(uint8_t i=0;i<4;++i){
    _screens.setPitchSlotStatus(i,_audio.slotCoarse(i),_audio.slotFine(i),_audio.slotRoot(i),_audio.slotOctave(i),_audio.slotPitchTracking(i),_audio.pitchBendRange(i));
    _screens.setEnvelopeSlotStatus(i,_audio.slotAttackMs(i),_audio.slotDecayMs(i),_audio.slotSustainPct(i),_audio.slotReleaseMs(i));
    _screens.setVintageSlotStatus(i,_audio.slotVintagePreset(i),_audio.slotVintageSampleRate(i),_audio.slotVintageBitDepth(i),_audio.slotVintageFilter(i),_audio.slotVintageJitter(i));
    _screens.setVoiceSlotStatus(i,_audio.slotVoiceMode(i),_audio.slotVoiceLimit(i),_audio.slotNotePriority(i),_audio.slotGlideMs(i));
    _screens.setMixerSlotStatus(i,_audio.slotLevel(i),_audio.slotPan(i),_audio.echoSend(i));
    _screens.setFilterSlotStatus(i,_audio.slotFilterCutoff(i),_audio.slotFilterResonance(i),_audio.slotFilterEnvAmount(i),_audio.slotFilterVelocityAmount(i),_audio.slotFilterKeytrack(i),_audio.slotFilterAttackMs(i),_audio.slotFilterDecayMs(i),_audio.slotFilterSustainPct(i),_audio.slotFilterReleaseMs(i));
  }
  for(uint8_t ms=0;ms<4;++ms)for(uint8_t mg=0;mg<16;++mg){
    _screens.setMultisampleKeygroupStatus(ms,mg,_audio.keygroupEnabled(ms,mg),_audio.keygroupLow(ms,mg),_audio.keygroupHigh(ms,mg),_audio.keygroupRoot(ms,mg),_audio.keygroupChokeGroup(ms,mg),_audio.keygroupOneShot(ms,mg),_audio.keygroupChokeFadeMs(ms,mg),_audio.keygroupPlayMode(ms,mg),_audio.keygroupExclusiveGroup(ms,mg),_audio.keygroupRetriggerLegato(ms,mg),_audio.keygroupStartPct(ms,mg),_audio.keygroupEndPct(ms,mg),_audio.keygroupReverse(ms,mg),_audio.keygroupTranspose(ms,mg),_audio.keygroupFineCent(ms,mg),_audio.keygroupKeytrackPct(ms,mg));
    for(uint8_t ml=0;ml<3;++ml){_screens.setMultisampleLayerStatus(ms,mg,ml,_audio.keygroupLayerEnabled(ms,mg,ml),_audio.keygroupLayerVelocityLow(ms,mg,ml),_audio.keygroupLayerVelocityHigh(ms,mg,ml),_audio.keygroupLayerLevel(ms,mg,ml),_audio.keygroupLayerPan(ms,mg,ml),_audio.keygroupLayerPath(ms,mg,ml),_audio.keygroupLayerRoundRobinMode(ms,mg,ml),_audio.keygroupLayerRoundRobinCount(ms,mg,ml),_audio.keygroupLayerLoopMode(ms,mg,ml),_audio.keygroupLayerLoopStartPct(ms,mg,ml),_audio.keygroupLayerLoopEndPct(ms,mg,ml),_audio.keygroupLayerLoopXfadeMs(ms,mg,ml),_audio.keygroupLayerVelocityToLevelPct(ms,mg,ml),_audio.keygroupLayerVelocityToFilterPct(ms,mg,ml));for(uint8_t mr=0;mr<4;++mr)_screens.setMultisampleVariantPath(ms,mg,ml,mr,_audio.keygroupLayerVariantPath(ms,mg,ml,mr));}
  }
  bool rec[4]={false,false,false,false},rcd[4]={false,false,false,false},ply[4]={false,false,false,false}; uint32_t frames[4]={0},ls[4]={0},le[4]={0},ss[4]={0},se[4]={0}; uint8_t lm[4]={0},lx[4]={0}; bool tr[4]={false},dc[4]={false},nm[4]={false};
  for(uint8_t i=0;i<4;++i){rcd[i]=_audio.slotRecorded(i);rec[i]=_audio.slotRecording(i);ply[i]=_audio.slotPlaying(i);frames[i]=_audio.slotFrames(i);lm[i]=_audio.loopMode(i);lx[i]=_audio.loopCrossfadeMs(i);ls[i]=_audio.loopStart(i);le[i]=_audio.loopEnd(i);ss[i]=_audio.sampleStart(i);se[i]=_audio.sampleEnd(i);tr[i]=_audio.trimEnabled(i);dc[i]=_audio.dcCorrectionEnabled(i);nm[i]=_audio.normalizeEnabled(i);}
  _screens.setSlotStatus(rcd,rec,ply,frames);_screens.setLoopModeStatus(lm);_screens.setLoopCrossfadeStatus(lx);_screens.setLoopRangeStatus(ls,le);_screens.setSampleRangeStatus(ss,se);_screens.setSampleProcessingStatus(tr,dc,nm);
}

void PhoenixOS::initializeNewBank() {
  quiesceForBankIo("NEW_BANK");
  _audio.clearBankContent();
  PhxInitSoundCfg init; const bool templateLoaded=phxLoadInitSoundCfg(init);
  uint8_t qlo[4],qhi[4],qch[4];
  for(uint8_t i=0;i<4;++i){const auto &d=init.slot[i];
    _audio.setInstrumentParams(i,d.coarse,d.fineCent,d.rootNote);_audio.setKeyboardParams(i,d.octave,d.pitchTracking);_audio.setPitchBendRange(i,d.pitchBendRange);_audio.setPitchBend(i,0);
    _audio.setEnvelopeParams(i,d.attackMs,d.decayMs,d.sustainPct,d.releaseMs);_audio.setMixerParams(i,d.level,d.pan);_audio.setSampleGain(i,d.sampleGainPct);_audio.setVelocityAmount(i,d.velocityAmountPct);
    _audio.setFilterParams(i,d.filterCutoff,d.filterResonance,d.filterEnvAmount,d.filterVelocityAmount,d.filterKeytrack);_audio.setFilterEnvelopeParams(i,d.filterAttackMs,d.filterDecayMs,d.filterSustainPct,d.filterReleaseMs);
    _audio.setVintageParams(i,d.vintagePreset,d.vintageSampleRate,d.vintageBitDepth,d.vintageFilter,d.vintageJitter);_audio.setVoiceConfig(i,d.voiceMode,d.voiceLimit,d.notePriority,d.glideMs);_audio.setEchoSend(i,d.echoSend);_audio.setReverbSend(i,d.reverbSend);
    _audio.setKeygroupMapping(i,0,d.multisampleEnabled,d.multisampleLow,d.multisampleHigh,d.multisampleRoot,100,0);_audio.setKeygroupKeytrackPct(i,0,100);
    qlo[i]=d.quattroLow;qhi[i]=d.quattroHigh;qch[i]=d.quattroMidiChannel;
  }
  _audio.setQuattroConfig(init.quattroMode,qlo,qhi,qch);_audio.setEchoParams(init.echoDelayMs,init.echoFeedback,init.echoMix);_audio.setReverbParams(init.reverbSize,init.reverbDecay,init.reverbDamp,init.reverbMix);_audio.selectSlot(0);
  _screens.clearSequencerPattern();_songManager.beginEmptySong();syncSongToScreens();refreshRealtimeSequencerSnapshot();syncNewBankStateToScreens();
  _msConfigDirty=false;
  _newBankPendingSave=true;
  _screens.setBankDirty(true);_screens.setDiskStatus(templateLoaded?"NEW BANK: INIT CFG":"NEW BANK: FACTORY");
  PHX_INFO_PRINTF("V1.1 DEV1 NEW BANK source=%s samples=empty multisample_paths=empty\\n",templateLoaded?"INIT_SOUND.CFG":"FACTORY");
}

void PhoenixOS::quiesceForBankIo(const char *reason) {
  const uint8_t voicesBefore = _audio.activeVoiceCount();
  bool sustainBefore = false;
  for (uint8_t s = 0; s < PhoenixAudioManager::SLOT_COUNT; ++s) sustainBefore |= _audio.sustainDown(s);
  const bool seqBefore = _screens.sequencerRunning();
  if (voicesBefore || sustainBefore || seqBefore) ++_integrationActiveVoiceGuardCount;

  stopSequencerVoices();
  _screens.setSequencerRunning(false);
  stopSongTransport();
  _seqWasRunning = false;
  _seqPreviewHeld = false;
  _audio.stopTransport();

  uint32_t staleTicks = 0;
  portENTER_CRITICAL(&_seqMidiMux);
  const uint8_t cw=_seqClockWrite, cr=_seqClockRead;
  staleTicks=(uint8_t)((cw+kSeqClockQueueSize-cr)%kSeqClockQueueSize); _seqClockRead=cw;
  _seqMidiTransportPending = 0;
  _seqRtRunning = false;
  portEXIT_CRITICAL(&_seqMidiMux);
  _integrationStaleClockTicksCleared += staleTicks;
  _seqExtTickPhase = 0;
  ++_integrationBankQuiesceCount;
  PHX_INFO_PRINTF("V1.0 BANK QUIESCE reason=%s voices=%u sustain=%u seq=%u stale_clk=%lu\n",
                reason ? reason : "?", (unsigned)voicesBefore, sustainBefore ? 1U : 0U,
                seqBefore ? 1U : 0U, (unsigned long)staleTicks);
}

bool PhoenixOS::loadBankForSession(uint8_t bank) {
  if (!phxEnsureSD()) return false;
  char bankDir[40];
  if (!phxBuildBankDir(bank, bankDir, sizeof(bankDir)) || !phxBankExists(bankDir)) {
    phxBankCacheSet(bank, false);
    return false;
  }
  phxBankCacheSet(bank, true);
  quiesceForBankIo("SESSION_LOAD");
  _bootSessionRestoreActive = true;
  _bootSessionBank = bank;
  {
    char bootMsg[24];
    snprintf(bootMsg, sizeof(bootMsg), "LOADING BANK %02u", (unsigned)bank);
    _gui.drawBootStatus(bootMsg, 52);
  }
  snprintf(_progressLabel, sizeof(_progressLabel), "LOADING");
  _lastProgressPercent=255; _lastProgressDrawMs=0;
  _audio.setProgressCallback(&PhoenixOS::progressCallback, this);
  bool ok=_audio.loadBankFromSD(bankDir);
  _audio.setProgressCallback(nullptr,nullptr);
  if(ok) {
    char bootMsg[24];
    snprintf(bootMsg, sizeof(bootMsg), "BANK %02u PATTERNS", (unsigned)bank);
    _gui.drawBootStatus(bootMsg, 92);
    ok=_screens.loadSequencerConfig(bankDir);
  }
  if(ok) {
    char bootMsg[24];
    snprintf(bootMsg, sizeof(bootMsg), "BANK %02u SONG", (unsigned)bank);
    _gui.drawBootStatus(bootMsg, 96);
    ok=_songManager.loadConfig(bankDir);
  }
  if(!ok) {
    _bootSessionRestoreActive = false;
    ++_integrationBankLoadFailCount;
    _gui.drawBootStatus("BANK LOAD FAILED", 100);
    vTaskDelay(pdMS_TO_TICKS(120));
    return false;
  }
  // v1.0.12: only a fully successful bank load becomes active.
  _newBankPendingSave = false;
  _screens.setActiveBank(bank);
  syncSongToScreens();
  uint8_t lo[4],hi[4],ch[4],send[4];
  for(uint8_t i=0;i<4;++i){lo[i]=_audio.quattroKeyLow(i);hi[i]=_audio.quattroKeyHigh(i);ch[i]=_audio.quattroMidiChannel(i);send[i]=_audio.echoSend(i);}
  _screens.setQuattroStatus(_audio.quattroMode(),lo,hi,ch);
  _screens.setEchoStatus(_audio.echoDelayMs(),_audio.echoFeedback(),_audio.echoMix(),send);
  uint8_t rsend[4]; for(uint8_t i=0;i<4;++i)rsend[i]=_audio.reverbSend(i); _screens.setReverbStatus(_audio.reverbSize(),_audio.reverbDecay(),_audio.reverbDamp(),_audio.reverbMix(),rsend);
  _screens.setTriggerStatus(_audio.triggerAuto(),_audio.triggerLevel());
  for(uint8_t i=0;i<4;++i){
    _screens.setPitchSlotStatus(i,_audio.slotCoarse(i),_audio.slotFine(i),_audio.slotRoot(i),_audio.slotOctave(i),_audio.slotPitchTracking(i),_audio.pitchBendRange(i));
    _screens.setEnvelopeSlotStatus(i,_audio.slotAttackMs(i),_audio.slotDecayMs(i),_audio.slotSustainPct(i),_audio.slotReleaseMs(i));
    _screens.setVintageSlotStatus(i,_audio.slotVintagePreset(i),_audio.slotVintageSampleRate(i),_audio.slotVintageBitDepth(i),_audio.slotVintageFilter(i),_audio.slotVintageJitter(i));
    _screens.setVoiceSlotStatus(i,_audio.slotVoiceMode(i),_audio.slotVoiceLimit(i),_audio.slotNotePriority(i),_audio.slotGlideMs(i));
    _screens.setMixerSlotStatus(i,_audio.slotLevel(i),_audio.slotPan(i),_audio.echoSend(i));
  }
  {
    char bootMsg[24];
    snprintf(bootMsg, sizeof(bootMsg), "BANK %02u READY", (unsigned)bank);
    _gui.drawBootStatus(bootMsg, 100);
    // Keep the final restore result visible briefly before the normal screen
    // replaces the boot page.
    vTaskDelay(pdMS_TO_TICKS(180));
  }
  _bootSessionRestoreActive = false;
  return true;
}

void PhoenixOS::restoreLastSession() {
  uint8_t sdBank = 0;
  uint8_t screen = 5; // SCR_MAIN
  uint8_t slot = 0;
  const bool sdSessionValid = phxReadSessionSd(sdBank, screen, slot);

  uint8_t fallbackBank = 0;
  const bool fallbackValid = phxReadLastBankFallback(fallbackBank);
  uint8_t bank = sdSessionValid ? sdBank : fallbackBank;
  const bool haveSessionBank = sdSessionValid || fallbackValid;

  if (haveSessionBank) {
    char msg[24];
    snprintf(msg, sizeof(msg), "LAST BANK %02u", (unsigned)bank);
    _gui.drawBootStatus(msg, 50);
    vTaskDelay(pdMS_TO_TICKS(250));
  } else {
    _gui.drawBootStatus("NO LAST BANK", 50);
    vTaskDelay(pdMS_TO_TICKS(250));
  }

  bool loaded = false;
  if (haveSessionBank) loaded = loadBankForSession(bank);

  // If the newest A/B session points to a removed bank, retain screen/slot but
  // try the independent legacy bank-only fallback before giving up.
  if (!loaded && sdSessionValid && fallbackValid && fallbackBank != sdBank) {
    char msg[24];
    snprintf(msg, sizeof(msg), "FALLBACK BANK %02u", (unsigned)fallbackBank);
    _gui.drawBootStatus(msg, 50);
    vTaskDelay(pdMS_TO_TICKS(200));
    bank = fallbackBank;
    loaded = loadBankForSession(bank);
  }

  if (!loaded) {
    _screens.setSelectedBank(1);
    _gui.drawBootStatus(haveSessionBank ? "SESSION LOAD FAILED" : "NO SESSION - DEFAULT", 100);
    vTaskDelay(pdMS_TO_TICKS(600));
  } else {
    const uint8_t restoredBank = _screens.activeBank();
    // First SD-session boot migrates LASTBANK.CFG into the A/B journal. Also repair
    // a valid session whose bank had to fall back to a different existing bank.
    if (!sdSessionValid || restoredBank != sdBank)
      (void)phxWriteSessionSd(restoredBank, screen, slot & 3U);
    (void)phxWriteLastBankFallback(restoredBank);
  }

  _audio.selectSlot(slot & 3U);
  _screens.restoreSessionView(screen, slot);
  _sessionBankCache = _screens.activeBank();
  _sessionScreenCache = _screens.sessionScreen();
  _sessionSlotCache = _screens.sessionSlot() & 3U;
  _sessionPendingBank = _sessionBankCache;
  _sessionPendingScreen = _sessionScreenCache;
  _sessionPendingSlot = _sessionSlotCache;
  _sessionDirty = false;
  _sessionLastChangeMs = millis();
}

void PhoenixOS::saveSessionNow() {
  const uint8_t bank = _screens.activeBank();
  const uint8_t screen = _screens.sessionScreen();
  const uint8_t slot = _screens.sessionSlot() & 3U;

  const bool ok = phxWriteSessionSd(bank, screen, slot);
  if (ok) {
    _sessionBankCache = bank;
    _sessionScreenCache = screen;
    _sessionSlotCache = slot;
    _sessionPendingBank = bank;
    _sessionPendingScreen = screen;
    _sessionPendingSlot = slot;
    _sessionDirty = false;
  } else {
    // Preserve the desired tuple for a later quiet-time retry.
    _sessionPendingBank = bank;
    _sessionPendingScreen = screen;
    _sessionPendingSlot = slot;
    _sessionDirty = true;
    _sessionLastChangeMs = millis();
  }
  _lastSessionSaveMs = millis();
}

void PhoenixOS::saveSessionIfChanged() {
  const uint32_t now = millis();
  const uint8_t bank = _screens.activeBank();
  const uint8_t screen = _screens.sessionScreen();
  const uint8_t slot = _screens.sessionSlot() & 3U;

  // Observe changes cheaply in RAM. Every new detent/view change restarts the
  // quiet-time timer; no SD I/O occurs here.
  if (bank != _sessionPendingBank || screen != _sessionPendingScreen ||
      slot != _sessionPendingSlot) {
    _sessionPendingBank = bank;
    _sessionPendingScreen = screen;
    _sessionPendingSlot = slot;
    _sessionDirty = true;
    _sessionLastChangeMs = now;
  }
  if (!_sessionDirty) return;

  // If the user returned to the already-persisted tuple, cancel the pending write.
  if (_sessionPendingBank == _sessionBankCache &&
      _sessionPendingScreen == _sessionScreenCache &&
      _sessionPendingSlot == _sessionSlotCache) {
    _sessionDirty = false;
    return;
  }

  // Coalesce rapid encoder/navigation changes. Also keep FAT/SD writes away
  // from active sequencer/song transport just like deferred multisample saves.
  if ((uint32_t)(now - _sessionLastChangeMs) < 1500UL) return;
  const bool transportBusy = _screens.sequencerRunning() || _seqRtRunning ||
                             _seqWasRunning || _songManager.playing();
  if (transportBusy) return;
  // Avoid tight retries if the card is absent or an I/O error occurs.
  if ((uint32_t)(now - _lastSessionSaveMs) < 1000UL) return;
  _lastSessionSaveMs = now;

  if (phxWriteSessionSd(_sessionPendingBank, _sessionPendingScreen,
                        _sessionPendingSlot)) {
    const bool bankChanged = (_sessionPendingBank != _sessionBankCache);
    _sessionBankCache = _sessionPendingBank;
    _sessionScreenCache = _sessionPendingScreen;
    _sessionSlotCache = _sessionPendingSlot;
    _sessionDirty = false;
    if (bankChanged) (void)phxWriteLastBankFallback(_sessionBankCache);
  }
}

void PhoenixOS::begin(bool serviceMode) {
  _events.clear();
  _input.begin();

  // v0.7.40b: Initialize and draw the OLED before the longer audio/storage
  // setup. Previously SCR_BOOT was replaced by session restore before the
  // first physical display update, so the splash screen was never visible.
  _gui.begin(190);
  _screens.begin(serviceMode);
  _diagStartMs = millis();

  // v1.0.5 Boot UX: never leave a static splash on screen while Phoenix is
  // doing real initialization work. A short logo phase is enough to make the
  // startup visible; following phases report actual activity.
  _gui.drawBootStatus("STARTING", 5);
  delay(180);

  _gui.drawBootStatus("MIDI SETUP", 15);
  phxMidiMapBegin();

  _gui.drawBootStatus("AUDIO SETUP", 28);
  _audio.begin();

  // v1.0.5: build the bank cache before normal playback/session restore while
  // showing low-rate progress. Runtime cache refreshes remain display-neutral.
  _gui.drawBootStatus("SD / BANK CACHE", 40);
  phxRefreshBankCache(&_gui);
  _gui.drawBootStatus("RESTORING SESSION", 48);
  delay(40);

  refreshRealtimeSequencerSnapshot();
  if (!_seqRtTaskHandle) xTaskCreatePinnedToCore(realtimeSequencerTaskThunk, "PhoenixSeqRT", 6144, this, 8, &_seqRtTaskHandle, 0);
  syncSongToScreens();
  // v0.7.18a: initialize the audio-side Multi-Mode channels from the
  // base-channel-derived defaults prepared by PhoenixScreens.
  {
    uint8_t lo[4], hi[4], ch[4];
    for (uint8_t i = 0; i < 4; ++i) {
      lo[i] = _screens.quattroKeyLow(i);
      hi[i] = _screens.quattroKeyHigh(i);
      ch[i] = _screens.quattroMidiChannel(i);
    }
    _audio.setQuattroConfig(_screens.quattroMode(), lo, hi, ch);
    for(uint8_t i=0;i<4;++i) { _audio.setVoiceConfig(i,0,PhoenixAudioManager::VOICE_COUNT,0,0); _audio.setMixerParams(i,100,0); }
  }
  // v0.7.13c FIX5: persistent system settings are loaded by PhoenixScreens.
  // Apply trigger settings immediately so recorder/levelmeter are correct after boot.
  _audio.setTriggerSettings(_screens.triggerAuto(), _screens.triggerLevel());
  _gui.setMeter(_audio.peakLevel(), _audio.peakHoldLevel(), _audio.highActive(), _audio.clipActive());
  _gui.setTriggerMarker(_audio.triggerAuto() || _screens.triggerTestActive(), _audio.triggerLevel());
  _gui.setRecordStatus(_audio.waitingForTrigger() ? 1 : (_audio.activelyRecording() ? 2 : 0));
  _gui.setRecording(_audio.recording());
  _gui.setPlaying(_audio.playing());
  _screens.setHardwareStatus(_audio.psramOk(), _audio.psramFreeKb(), _audio.audioOk(), 0, _audio.underruns(), _audio.clipCount());
  _screens.setTransportStatus(_audio.recording(), _audio.playing(), _audio.sampleReady(), _audio.sampleFrames(), _audio.recordFrames(), _audio.sampleCapacityFrames(), _audio.playFrames(), _audio.sampleRate(), _audio.dcOffsetL(), _audio.dcOffsetR(), _audio.selectedSlot());
  _screens.setSamplePlayheadStatus(_audio.samplePlayheadActive(_audio.selectedSlot()), _audio.samplePlayheadFrame(_audio.selectedSlot()));
  _screens.setRecorderUxStatus(_audio.waitingForTrigger(), _audio.activelyRecording());
  _screens.setPlaybackReverse(_audio.playingReverse());
  {
    bool rec[4], rcd[4], ply[4]; uint32_t frames[4];
    for (uint8_t i=0;i<4;++i){ rcd[i]=_audio.slotRecorded(i); rec[i]=_audio.slotRecording(i); ply[i]=_audio.slotPlaying(i); frames[i]=_audio.slotFrames(i); }
    _screens.setSlotStatus(rcd, rec, ply, frames);
    uint8_t loopMode[4], loopXfade[4]; uint32_t ls[4], le[4], ss[4], se[4];
    for (uint8_t i=0;i<4;++i){ loopMode[i]=_audio.loopMode(i); loopXfade[i]=_audio.loopCrossfadeMs(i); ls[i]=_audio.loopStart(i); le[i]=_audio.loopEnd(i); ss[i]=_audio.sampleStart(i); se[i]=_audio.sampleEnd(i); }
    bool tr[4], dc[4], nm[4]; for(uint8_t i=0;i<4;++i){tr[i]=_audio.trimEnabled(i);dc[i]=_audio.dcCorrectionEnabled(i);nm[i]=_audio.normalizeEnabled(i);} _screens.setSampleProcessingStatus(tr,dc,nm);
    _screens.setLoopModeStatus(loopMode);
    _screens.setLoopCrossfadeStatus(loopXfade);
    _screens.setLoopRangeStatus(ls, le);
    _screens.setSampleRangeStatus(ss, se);
  }
  if (!serviceMode) restoreLastSession();
  drawScreensTimed();
}

void PhoenixOS::drawScreensTimed() {
  const uint32_t startUs = micros();
  _screens.draw(_gui);
  const uint32_t elapsedUs = (uint32_t)(micros() - startUs);
  _perfDrawAccumUs += elapsedUs;
  ++_perfDrawCount;
  if (elapsedUs > _perfDrawMaxUs) _perfDrawMaxUs = elapsedUs;
}

void PhoenixOS::updatePerformanceAudit(uint32_t loopStartUs) {
  const uint32_t loopUs = (uint32_t)(micros() - loopStartUs);
  _perfLoopAccumUs += loopUs;
  ++_perfLoopCount;
  if (loopUs > _perfLoopMaxUs) _perfLoopMaxUs = loopUs;

  const uint32_t nowMs = millis();
  if (_perfWindowStartMs == 0) _perfWindowStartMs = nowMs;
  if ((uint32_t)(nowMs - _perfWindowStartMs) < 2000UL) return;

  const uint32_t loopAvgUs = _perfLoopCount ? (uint32_t)(_perfLoopAccumUs / _perfLoopCount) : 0;
  const uint32_t drawAvgUs = _perfDrawCount ? (uint32_t)(_perfDrawAccumUs / _perfDrawCount) : 0;
  const uint32_t guiFps10 = ((uint32_t)_perfDrawCount * 10000UL) /
                            max((uint32_t)1UL, (uint32_t)(nowMs - _perfWindowStartMs));
  const uint32_t freeHeap = ESP.getFreeHeap();
  const uint32_t freePsram = ESP.getFreePsram();

  _diagLoopAvgUs = loopAvgUs;
  if (_perfLoopMaxUs > _diagLoopPeakUs) _diagLoopPeakUs = _perfLoopMaxUs;
  _diagDrawAvgUs = drawAvgUs;
  if (_perfDrawMaxUs > _diagDrawPeakUs) _diagDrawPeakUs = _perfDrawMaxUs;
  _diagGuiFps10 = guiFps10;

  const uint32_t rtLateAvg = _seqRtLateCount ? (uint32_t)(_seqRtLateAccumUs / _seqRtLateCount) : 0U;
#if PHX_SERIAL_LEVEL >= 2
  Serial.printf("PERF audio avg=%luus peak=%luus last=%luus load=%.1f%% voices=%u/%u vpeak=%u risk=%lu overrun=%lu underruns=%lu steals=%lu dup_on=%lu orphan_off=%lu sus_def=%lu panic_kill=%lu midi_cmd_drop=%lu midi_ctl_drop=%lu | fx echo_limit=%lu filter_guard=%lu echo_slew=%lu | ms note_miss=%lu vel_miss=%lu rr_fallback=%lu sanitize=%lu | integ bank_q=%lu load_fail=%lu save_fail=%lu stale_clk=%lu guard=%lu | gui avg=%luus peak=%luus fps=%lu.%lu | loop avg=%luus peak=%luus | heap=%luKB psram=%luKB | seq start=%lu cont=%lu stop=%lu pat=%lu tick_drop=%lu idle_clk=%lu gate_recycle=%lu gate_release=%lu clk_batch=%lu clk_qdrop=%lu step_late_max=%luus seq_cmd_drop=%lu note_on_fail=%lu owner_fail=%lu | rt batch=%lu late_max=%luus late_avg=%luus pred_err=%luus sched_miss=%lu frame_off=%lu owner_stale=%lu\n",
                (unsigned long)_audio.audioLoadAvgUs(),
                (unsigned long)_audio.audioLoadPeakUs(),
                (unsigned long)_audio.audioLoadLastUs(),
                ((float)_audio.audioLoadAvgUs() * 100.0f) / 4000.0f,
                (unsigned)_audio.activeVoiceCount(),
                (unsigned)PhoenixAudioManager::VOICE_COUNT,
                (unsigned)_audio.activeVoicePeak(),
                (unsigned long)_audio.audioRiskCount(),
                (unsigned long)_audio.audioOverrunCount(),
                (unsigned long)_audio.underruns(),
                (unsigned long)_audio.voiceStealCount(),
                (unsigned long)_audio.duplicateNoteOnCount(),
                (unsigned long)_audio.orphanNoteOffCount(),
                (unsigned long)_audio.sustainDeferredNoteOffCount(),
                (unsigned long)_audio.panicKillCount(),
                (unsigned long)_audio.midiCommandDrops(),
                (unsigned long)_midiControlDrops,
                (unsigned long)_audio.echoLimitCount(),
                (unsigned long)_audio.filterGuardCount(),
                (unsigned long)_audio.echoParamSlewCount(),
                (unsigned long)_audio.multisampleNoteMissCount(),
                (unsigned long)_audio.multisampleVelocityMissCount(),
                (unsigned long)_audio.multisampleRrFallbackCount(),
                (unsigned long)_audio.multisampleSanitizeCount(),
                (unsigned long)_integrationBankQuiesceCount,
                (unsigned long)_integrationBankLoadFailCount,
                (unsigned long)_integrationBankSaveFailCount,
                (unsigned long)_integrationStaleClockTicksCleared,
                (unsigned long)_integrationActiveVoiceGuardCount,
                (unsigned long)drawAvgUs,
                (unsigned long)_diagDrawPeakUs,
                (unsigned long)(guiFps10 / 10UL),
                (unsigned long)(guiFps10 % 10UL),
                (unsigned long)loopAvgUs,
                (unsigned long)_diagLoopPeakUs,
                (unsigned long)(freeHeap / 1024UL),
                (unsigned long)(freePsram / 1024UL),
                (unsigned long)_seqTransportStartCount, (unsigned long)_seqTransportContinueCount,
                (unsigned long)_seqTransportStopCount, (unsigned long)_seqPatternTransitionCount,
                (unsigned long)_seqDroppedClockTicks, (unsigned long)_seqIdleClockTicksIgnored, (unsigned long)_seqGateRecycleCount,
                (unsigned long)_seqForcedGateReleaseCount,
                (unsigned long)_seqClockBatchMax, (unsigned long)_seqClockQueueDrops, (unsigned long)_seqStepLateMaxUs,
                (unsigned long)_audio.sequencerCommandDrops(), (unsigned long)_audio.sequencerNoteOnFailCount(), (unsigned long)_audio.sequencerOwnerFailCount(),
                (unsigned long)_seqRtBatchMax, (unsigned long)_seqRtLateMaxUs, (unsigned long)rtLateAvg,
                (unsigned long)_seqRtPredictionErrorMaxUs, (unsigned long)_audio.sequencerScheduleMissCount(),
                (unsigned long)_audio.sequencerFrameOffsetMax(), (unsigned long)_audio.sequencerOwnerStaleCount());
#endif

  _perfWindowStartMs = nowMs;
  _perfLoopAccumUs = 0;
  _perfLoopCount = 0;
  _perfLoopMaxUs = 0;
  _perfDrawAccumUs = 0;
  _perfDrawCount = 0;
  _perfDrawMaxUs = 0;
}

void PhoenixOS::analyzeRecordedSlot(uint8_t slot) {
  slot &= 3U;
  const int16_t *buffer = _audio.slotSampleBuffer(slot);
  const uint32_t frames = _audio.slotFrames(slot);
  PhoenixSampleAnalysisResult result;
  if (!PhoenixSampleAnalysis::analyze(buffer, frames, result)) {
    Serial.printf("SMART SAMPLE S%u: analysis failed\n", (unsigned)(slot + 1U));
    return;
  }

  const bool trimApproved = result.valid &&
                            result.trimConfidence >= 90U &&
                            result.startConfirmed &&
                            result.endConfirmed &&
                            result.suggestedEnd > result.suggestedStart + 1U;

  Serial.printf("SMART SAMPLE S%u frames=%lu peak=%u%% rms=%u dc=%d noise=%u noiseValid=%u threshold=%u trim=%lu..%lu lead=%lu tail=%lu confidence=%u start=%s end=%s analysis=%lums quality=%u crest=%u.%02u clip=%u normalize=%u\n",
                (unsigned)(slot + 1U),
                (unsigned long)result.sampleCount,
                (unsigned)result.peakPercent,
                (unsigned)result.rms,
                (int)result.dcOffset,
                (unsigned)result.noiseFloor,
                result.noiseValid ? 1U : 0U,
                (unsigned)result.detectionThreshold,
                (unsigned long)result.suggestedStart,
                (unsigned long)result.suggestedEnd,
                (unsigned long)result.leadingSilenceFrames,
                (unsigned long)result.trailingSilenceFrames,
                (unsigned)result.trimConfidence,
                result.startConfirmed ? "confirmed" : "open",
                result.endConfirmed ? "confirmed" : "open",
                (unsigned long)result.analysisTimeMs,
                (unsigned)result.qualityScore,
                (unsigned)(result.crestFactorX100 / 100U),
                (unsigned)(result.crestFactorX100 % 100U),
                result.clipped ? 1U : 0U,
                result.normalizeRecommended ? 1U : 0U);

  // v0.7.43b: runtime Smart Processing mode loaded from /PHOENIX/CONFIG.TXT.
  // 0 SAFE, 1 SMART, 2 FORCE. Default is SAFE.
  const uint8_t mode = _screens.smartProcessingMode();
  const char *modeName = (mode == 0U) ? "SAFE" : ((mode == 1U) ? "SMART" : "FORCE");

  bool applyTrim = false;
  bool removeDc = false;
  bool normalize = false;
  bool processAllowed = true;

  if (mode == 0U) { // SAFE
    processAllowed = trimApproved;
    applyTrim = trimApproved;
    removeDc = trimApproved;
    normalize = trimApproved && result.normalizeRecommended;
  } else if (mode == 1U) { // SMART
    applyTrim = trimApproved;
    removeDc = true;
    normalize = result.normalizeRecommended;
  } else { // FORCE
    applyTrim = result.valid &&
                result.suggestedEnd > result.suggestedStart + 1U &&
                (result.suggestedStart > 0U || result.suggestedEnd < frames);
    removeDc = true;
    normalize = result.peakPercent > 0U && !result.clipped;
  }

  const char *qualityName;
  if (result.clipped) qualityName = "CLIPPED";
  else if (!result.startConfirmed || !result.endConfirmed) qualityName = "OPEN";
  else if (result.qualityScore >= 5U) qualityName = "STUDIO";
  else if (result.qualityScore >= 4U) qualityName = "GOOD";
  else if (result.qualityScore >= 3U) qualityName = "FAIR";
  else qualityName = "CHECK";

  if (!processAllowed) {
    _audio.setSampleRange(slot, 0, frames);
    _screens.setSampleAnalysisSummary(result.peakPercent,
                                      result.dcDetected,
                                      result.suggestedStart,
                                      result.suggestedEnd,
                                      false);
    Serial.printf("SMART PROCESSING S%u mode=%s action=protected quality=%s trim=skipped dc=skipped normalize=skipped frames=%lu->%lu dataChanged=0\n",
                  (unsigned)(slot + 1U), modeName, qualityName,
                  (unsigned long)frames, (unsigned long)frames);
    PhoenixSmartReport smartReport;
    smartReport.buildProtected(slot, modeName, qualityName, result);
    smartReport.printSerial();
    return;
  }

  PhoenixAudioManager::SmartProcessResult processed;
  const bool processingOk = _audio.smartProcessSlot(slot,
                                                     result.suggestedStart,
                                                     result.suggestedEnd,
                                                     applyTrim,
                                                     removeDc,
                                                     normalize,
                                                     processed);
  if (!processingOk) {
    _audio.setSampleRange(slot, 0, frames);
    _screens.setSampleAnalysisSummary(result.peakPercent,
                                      result.dcDetected,
                                      result.suggestedStart,
                                      result.suggestedEnd,
                                      false);
    Serial.printf("SMART PROCESSING S%u mode=%s failed quality=%s dataChanged=0\n",
                  (unsigned)(slot + 1U), modeName, qualityName);
    PhoenixSmartReport smartReport;
    smartReport.buildFailed(slot, modeName, qualityName, result);
    smartReport.printSerial();
    return;
  }

  _screens.setSampleAnalysisSummary(result.peakPercent,
                                    processed.dcRemoved,
                                    0,
                                    processed.finalFrames,
                                    processed.trimApplied);

  Serial.printf("SMART PROCESSING S%u mode=%s quality=%s trim=%s removedLead=%lu removedTail=%lu dc=%s dcValue=%d normalize=%s normalizeGain=%lu.%03lux frames=%lu->%lu peak=%u%% dataChanged=%u\n",
                (unsigned)(slot + 1U),
                modeName,
                qualityName,
                processed.trimApplied ? "applied" : "skipped",
                (unsigned long)processed.removedLeadingFrames,
                (unsigned long)processed.removedTrailingFrames,
                processed.dcRemoved ? "removed" : "skipped",
                (int)processed.removedDcOffset,
                processed.normalized ? "applied" : "skipped",
                (unsigned long)(processed.normalizeGainX1000 / 1000U),
                (unsigned long)(processed.normalizeGainX1000 % 1000U),
                (unsigned long)processed.originalFrames,
                (unsigned long)processed.finalFrames,
                (unsigned)((processed.finalPeak * 100UL + 16383UL) / 32767UL),
                processed.dataChanged ? 1U : 0U);

  PhoenixSmartReport smartReport;
  smartReport.buildProcessed(slot, modeName, qualityName, result, processed);
  smartReport.printSerial();

}

void PhoenixOS::routeEvents() {
  PhoenixEvent ev;
  while (_events.poll(ev)) {
    (void)ev;
  }
}


bool PhoenixOS::queueMidiControlChange(uint8_t slot, uint8_t cc, uint8_t value) {
  const uint8_t write = __atomic_load_n(&_midiControlWrite, __ATOMIC_RELAXED);
  const uint8_t next = (uint8_t)((write + 1U) % kMidiControlQueueSize);
  const uint8_t read = __atomic_load_n(&_midiControlRead, __ATOMIC_ACQUIRE);
  if (next == read) {
    __atomic_add_fetch(&_midiControlDrops, 1U, __ATOMIC_RELAXED);
    return false;
  }
  _midiControlQueue[write] = { (uint8_t)(slot & 3U), cc, value };
  __atomic_store_n(&_midiControlWrite, next, __ATOMIC_RELEASE);
  return true;
}

void PhoenixOS::processMidiControlQueue() {
  for (;;) {
    const uint8_t read = __atomic_load_n(&_midiControlRead, __ATOMIC_RELAXED);
    const uint8_t write = __atomic_load_n(&_midiControlWrite, __ATOMIC_ACQUIRE);
    if (read == write) break;
    const MidiControlEvent ev = _midiControlQueue[read];
    __atomic_store_n(&_midiControlRead, (uint8_t)((read + 1U) % kMidiControlQueueSize), __ATOMIC_RELEASE);
    notifyMidiControlChange(ev.slot, ev.cc, ev.value);
  }
}

void PhoenixOS::notifyMidiControlChange(uint8_t slot, uint8_t cc, uint8_t value) {
  slot &= 3U;
  if (_midiLearnActive) { _midiLearnCcPending=(int16_t)cc; return; }
  uint8_t matchStart=0;
  const PhoenixMidiParameterDef *def=nullptr;
  while ((def=phxMidiParameterForCc(cc,matchStart)) != nullptr) {
    matchStart=(uint8_t)def->id+1U;
    switch (def->id) {
    case PHX_PAR_SLOT_VOLUME:
      _audio.setMixerParams(slot, (uint8_t)((value * 100U + 63U) / 127U), _audio.slotPan(slot));
      _screens.setMixerSlotStatus(slot, _audio.slotLevel(slot), _audio.slotPan(slot), _audio.echoSend(slot));
      break;
    case PHX_PAR_SLOT_PAN:
      _audio.setMixerParams(slot, _audio.slotLevel(slot), (int8_t)((int)value * 200 / 127 - 100));
      _screens.setMixerSlotStatus(slot, _audio.slotLevel(slot), _audio.slotPan(slot), _audio.echoSend(slot));
      break;
    case PHX_PAR_SAMPLE_START: {
      const uint32_t frames = _audio.slotFrames(slot); if (!frames) break;
      uint32_t start = (uint32_t)(((uint64_t)value * (frames - 1U)) / 127ULL);
      _audio.setSampleRange(slot, start, _audio.sampleEnd(slot));
      break;
    }
    case PHX_PAR_SAMPLE_END: {
      const uint32_t frames = _audio.slotFrames(slot); if (!frames) break;
      uint32_t end = 1U + (uint32_t)(((uint64_t)value * (frames - 1U)) / 127ULL);
      _audio.setSampleRange(slot, _audio.sampleStart(slot), end);
      break;
    }
    case PHX_PAR_LOOP_START: {
      const uint32_t frames = _audio.slotFrames(slot); if (!frames) break;
      uint32_t start = (uint32_t)(((uint64_t)value * (frames - 1U)) / 127ULL);
      _audio.setLoopRange(slot, start, _audio.loopEnd(slot));
      break;
    }
    case PHX_PAR_LOOP_END: {
      const uint32_t frames = _audio.slotFrames(slot); if (!frames) break;
      uint32_t end = 1U + (uint32_t)(((uint64_t)value * (frames - 1U)) / 127ULL);
      _audio.setLoopRange(slot, _audio.loopStart(slot), end);
      break;
    }
    case PHX_PAR_ROOT_KEY:
      _audio.setInstrumentParams(slot, _audio.slotCoarse(slot), _audio.slotFine(slot), value);
      _screens.setPitchSlotStatus(slot,_audio.slotCoarse(slot),_audio.slotFine(slot),_audio.slotRoot(slot),_audio.slotOctave(slot),_audio.slotPitchTracking(slot),_audio.pitchBendRange(slot));
      break;
    case PHX_PAR_TRANSPOSE:
      _audio.setInstrumentParams(slot, (int8_t)constrain((int)value - 64, -24, 24), _audio.slotFine(slot), _audio.slotRoot(slot));
      _screens.setPitchSlotStatus(slot,_audio.slotCoarse(slot),_audio.slotFine(slot),_audio.slotRoot(slot),_audio.slotOctave(slot),_audio.slotPitchTracking(slot),_audio.pitchBendRange(slot));
      break;
    case PHX_PAR_FINE_TUNE:
      _audio.setInstrumentParams(slot, _audio.slotCoarse(slot), (int16_t)((int)value * 200 / 127 - 100), _audio.slotRoot(slot));
      _screens.setPitchSlotStatus(slot,_audio.slotCoarse(slot),_audio.slotFine(slot),_audio.slotRoot(slot),_audio.slotOctave(slot),_audio.slotPitchTracking(slot),_audio.pitchBendRange(slot));
      break;
    case PHX_PAR_REVERSE:
      _screens.setPlaybackReverseMode(value >= 64);
      break;
    case PHX_PAR_NORMALIZE:
      if (value < 64) _midiNormalizeArmed[slot] = true;
      else if (_midiNormalizeArmed[slot]) { _midiNormalizeArmed[slot] = false; _audio.normalizeSlot(slot); }
      break;
    case PHX_PAR_SAMPLE_GAIN:
      _audio.setSampleGain(slot, (uint8_t)((value * 200U + 63U) / 127U));
      break;
    case PHX_PAR_AMP_ATTACK:
      _audio.setEnvelopeParams(slot, (uint16_t)(((uint32_t)value * 5000U) / 127U), _audio.slotDecayMs(slot), _audio.slotSustainPct(slot), _audio.slotReleaseMs(slot));
      _screens.setEnvelopeSlotStatus(slot,_audio.slotAttackMs(slot),_audio.slotDecayMs(slot),_audio.slotSustainPct(slot),_audio.slotReleaseMs(slot));
      break;
    case PHX_PAR_AMP_DECAY:
      _audio.setEnvelopeParams(slot, _audio.slotAttackMs(slot), (uint16_t)(((uint32_t)value * 5000U) / 127U), _audio.slotSustainPct(slot), _audio.slotReleaseMs(slot));
      _screens.setEnvelopeSlotStatus(slot,_audio.slotAttackMs(slot),_audio.slotDecayMs(slot),_audio.slotSustainPct(slot),_audio.slotReleaseMs(slot));
      break;
    case PHX_PAR_AMP_SUSTAIN:
      _audio.setEnvelopeParams(slot, _audio.slotAttackMs(slot), _audio.slotDecayMs(slot), (uint8_t)((value * 100U + 63U) / 127U), _audio.slotReleaseMs(slot));
      _screens.setEnvelopeSlotStatus(slot,_audio.slotAttackMs(slot),_audio.slotDecayMs(slot),_audio.slotSustainPct(slot),_audio.slotReleaseMs(slot));
      break;
    case PHX_PAR_AMP_RELEASE:
      _audio.setEnvelopeParams(slot, _audio.slotAttackMs(slot), _audio.slotDecayMs(slot), _audio.slotSustainPct(slot), (uint16_t)(((uint32_t)value * 5000U) / 127U));
      _screens.setEnvelopeSlotStatus(slot,_audio.slotAttackMs(slot),_audio.slotDecayMs(slot),_audio.slotSustainPct(slot),_audio.slotReleaseMs(slot));
      break;
    case PHX_PAR_VELOCITY_AMOUNT:
      _audio.setVelocityAmount(slot, (uint8_t)((value * 100U + 63U) / 127U));
      break;
    case PHX_PAR_FILTER_CUTOFF:
      _audio.setFilterParams(slot,(uint8_t)((value*100U+63U)/127U),_audio.slotFilterResonance(slot),_audio.slotFilterEnvAmount(slot),_audio.slotFilterVelocityAmount(slot),_audio.slotFilterKeytrack(slot));
      break;
    case PHX_PAR_FILTER_RESONANCE:
      _audio.setFilterParams(slot,_audio.slotFilterCutoff(slot),(uint8_t)((value*100U+63U)/127U),_audio.slotFilterEnvAmount(slot),_audio.slotFilterVelocityAmount(slot),_audio.slotFilterKeytrack(slot));
      break;
    case PHX_PAR_ECHO_SEND:
      _audio.setEchoSend(slot,(uint8_t)((value*100U+63U)/127U));
      _screens.setMixerSlotStatus(slot,_audio.slotLevel(slot),_audio.slotPan(slot),_audio.echoSend(slot));
      break;
    case PHX_PAR_ECHO_TIME: {
      _midiEchoTimeValue=value;
      uint16_t ms;
      if (_midiEchoSync) {
        static const uint8_t divNum[8]={1,1,1,1,1,1,1,2};
        static const uint8_t divDen[8]={8,6,4,3,2,1,1,1};
        uint8_t idx=(uint8_t)min(7,(int)(value>>4));
        uint32_t quarter=60000UL/max((uint16_t)40,_screens.sequencerBpm());
        ms=(uint16_t)constrain((int)((quarter*divNum[idx])/divDen[idx]),50,1000);
      } else ms=(uint16_t)(50U+((uint32_t)value*950U)/127U);
      _audio.setEchoParams(ms,_audio.echoFeedback(),_audio.echoMix());
      break;
    }
    case PHX_PAR_ECHO_FEEDBACK:
      _audio.setEchoParams(_audio.echoDelayMs(),(uint8_t)((value*90U+63U)/127U),_audio.echoMix());
      break;
    case PHX_PAR_ECHO_MIX:
      _audio.setEchoParams(_audio.echoDelayMs(),_audio.echoFeedback(),(uint8_t)((value*100U+63U)/127U));
      break;
    case PHX_PAR_ECHO_SYNC:
      _midiEchoSync=(value>=64); notifyMidiControlChange(slot,89,_midiEchoTimeValue); break;
    case PHX_PAR_GLIDE:
      _audio.setVoiceConfig(slot,_audio.slotVoiceMode(slot),_audio.slotVoiceLimit(slot),_audio.slotNotePriority(slot),(uint16_t)(((uint32_t)value*2000U)/127U));
      _screens.setVoiceSlotStatus(slot,_audio.slotVoiceMode(slot),_audio.slotVoiceLimit(slot),_audio.slotNotePriority(slot),_audio.slotGlideMs(slot));
      break;
    case PHX_PAR_MODULATION:
      _midiModulationValue=value; // reserved for Phoenix 1.1 modulation system
      break;
      default: break;
    }
    if (PHX_ENABLE_MIDI_CC_DEBUG) {
      static uint32_t lastCcDebugMs = 0;
      const uint32_t nowCcDebugMs = millis();
      if ((uint32_t)(nowCcDebugMs - lastCcDebugMs) >= PHX_MIDI_CC_DEBUG_MIN_MS) {
        lastCcDebugMs = nowCcDebugMs;
        Serial.printf("MIDI CC%03u -> %s value=%u slot=%u\n", (unsigned)cc, def->name, (unsigned)value, (unsigned)(slot+1));
      }
    }
  }
}

void PhoenixOS::notifyMidiClock() {
  const uint32_t nowUs = micros();
  portENTER_CRITICAL(&_seqMidiMux);
  if (_seqMidiLastClockUs != 0) {
    const uint32_t period = nowUs - _seqMidiLastClockUs;
    if (period >= 1000U && period <= 200000U) {
      if (_seqMidiClockPeriodUs == 0) _seqMidiClockPeriodUs = period;
      else _seqMidiClockPeriodUs = (_seqMidiClockPeriodUs * 7U + period) / 8U;
    }
  }
  _seqMidiLastClockUs = nowUs;
  const uint8_t write=_seqClockWrite, next=(uint8_t)((write+1U)%kSeqClockQueueSize);
  if(next==_seqClockRead) ++_seqClockQueueDrops; else { _seqClockUs[write]=nowUs; _seqClockWrite=next; }
  portEXIT_CRITICAL(&_seqMidiMux);
  if (_seqRtTaskHandle) xTaskNotifyGive(_seqRtTaskHandle);
}

void PhoenixOS::notifyMidiStart() {
  portENTER_CRITICAL(&_seqMidiMux);
  // C034b: clocks that arrived before FA belong to STOP/idle time and must not
  // be replayed after START. F8 bytes arriving after FA accumulate normally.
  _seqClockRead = _seqClockWrite;
  _seqMidiTransportPending = 1U;
  portEXIT_CRITICAL(&_seqMidiMux);
  if (_seqRtTaskHandle) xTaskNotifyGive(_seqRtTaskHandle);
}

void PhoenixOS::notifyMidiContinue() {
  portENTER_CRITICAL(&_seqMidiMux);
  // C034b: discard idle clocks before FB; only clocks after CONTINUE advance.
  _seqClockRead = _seqClockWrite;
  _seqMidiTransportPending = 2U;
  portEXIT_CRITICAL(&_seqMidiMux);
  if (_seqRtTaskHandle) xTaskNotifyGive(_seqRtTaskHandle);
}

void PhoenixOS::notifyMidiStop() {
  portENTER_CRITICAL(&_seqMidiMux);
  // C034b: make STOP a hard clock-domain boundary. Pending pre-STOP ticks are
  // irrelevant once transport is stopped and must never become a later burst.
  _seqClockRead = _seqClockWrite;
  _seqMidiTransportPending = 3U;
  portEXIT_CRITICAL(&_seqMidiMux);
  if (_seqRtTaskHandle) xTaskNotifyGive(_seqRtTaskHandle);
}



void PhoenixOS::syncSongToScreens() {
  for (uint8_t i=0;i<PhoenixSongManager::kMaxEntries;++i) {
    const PhoenixSongManager::SongEntry &e=_songManager.entry(i);
    _screens.setSongEntryStatus(i,e.pattern,e.repeats,e.end);
  }
  _screens.setSongLoopStatus(_songManager.loopMode(),_songManager.loopStart(),_songManager.loopEnd());
  _screens.setSongPlaybackStatus(_songManager.playing(),_songManager.position(),_songManager.repeatIndex(),_songManager.currentRepeatTarget());
}

void PhoenixOS::syncScreensToSong() {
  for (uint8_t i=0;i<PhoenixSongManager::kMaxEntries;++i) {
    _songManager.setEntry(i,_screens.songPattern(i),_screens.songRepeats(i),_screens.songEnd(i));
  }
  _songManager.setLoopMode(_screens.songLoopMode(),_screens.songLoopStart(),_screens.songLoopEnd());
}

void PhoenixOS::setSequencerPatternRobust(uint8_t pattern, bool releaseOldGates) {
  const uint8_t next = pattern & 3U;
  const uint8_t old = _screens.sequencerPattern();
  if (releaseOldGates && old != next) stopSequencerVoices();
  _screens.setSequencerPattern(next);
  _seqLastPattern = next;
  if (old != next) ++_seqPatternTransitionCount;
}

void PhoenixOS::startSongTestTransport() {
  _songManager.start();
  _songPatternStepCounter = 0;
  setSequencerPatternRobust(_songManager.currentPattern(), true);
  _screens.setSequencerPlayhead(0);
  syncSongToScreens();
}

void PhoenixOS::pauseSongTransport() {
  _songManager.pause();
  syncSongToScreens();
}

void PhoenixOS::stopSongTransport() {
  _songManager.stop();
  _songPatternStepCounter = 0;
  syncSongToScreens();
}

void PhoenixOS::advanceSongPatternCycle() {
  if (!_songManager.playing()) return;
  uint8_t cycleLength = _screens.sequencerMaxTrackLength();
  if (cycleLength < 1U) cycleLength = 1U;
  if (++_songPatternStepCounter < cycleLength) return;

  _songPatternStepCounter = 0;
  uint8_t nextPattern = _screens.sequencerPattern();
  if (_songManager.onPatternFinished(nextPattern)) {
    setSequencerPatternRobust(nextPattern, true);
    syncSongToScreens();
  } else {
    _screens.setSequencerRunning(false);
    stopSequencerVoices();
    _seqWasRunning = false;
    syncSongToScreens();
  }
}

void PhoenixOS::stopSequencerVoices() {
  if (!_audio.queueSequencerStop()) ++_seqForcedGateReleaseCount;
}

void PhoenixOS::triggerSequencerStep(uint8_t /*globalStep*/, uint32_t stepUs) {
  stepUs=constrain(stepUs,20000UL,2000000UL);
  for(uint8_t t=0;t<4;++t){ const uint8_t length=(uint8_t)constrain((int)_screens.sequencerTrackLength(t),1,16); const uint8_t st=_screens.sequencerTrackPlayhead(t)%length; if(_screens.sequencerStepOn(t,st)){ const uint8_t note=(uint8_t)constrain((int)_screens.sequencerStepNote(t,st),0,127); const uint8_t vel=(uint8_t)constrain((int)_screens.sequencerStepVelocity(t,st),1,127); const uint8_t gate=(uint8_t)constrain((int)_screens.sequencerStepGate(t,st),1,100); uint32_t gateUs=(uint32_t)(((uint64_t)stepUs*gate)/100ULL); if(gateUs<4000UL)gateUs=4000UL; const uint32_t gateFrames=(uint32_t)(((uint64_t)gateUs*32000ULL+999999ULL)/1000000ULL); if(!_audio.queueSequencerNote(t,note,vel,gateFrames)) ++_seqGateRecycleCount; } _screens.setSequencerTrackPlayhead(t,(uint8_t)((st+1U)%length)); } ++_seqStepEventCount; advanceSongPatternCycle();
}

void PhoenixOS::processSequencerMidiTransport() {
  // C036d: external F8/transport is owned by PhoenixSeqRT/P8. Control only
  // mirrors status into the UI; it never drains the realtime clock queue.
  uint32_t periodUs=0,lastClockUs=0;
  portENTER_CRITICAL(&_seqMidiMux);
  periodUs=_seqMidiClockPeriodUs; lastClockUs=_seqMidiLastClockUs;
  portEXIT_CRITICAL(&_seqMidiMux);
  const uint32_t nowUs=micros();
  const bool present=lastClockUs!=0 && (uint32_t)(nowUs-lastClockUs)<600000UL;
  uint16_t extBpm=120;
  if(periodUs){ const uint32_t denom=periodUs*24UL; if(denom) extBpm=(uint16_t)constrain((int)(60000000UL/denom),20,300); }
  _screens.setSequencerExternalStatus(present,extBpm);
}

void PhoenixOS::refreshRealtimeSequencerSnapshot() {
  const bool ext=_screens.sequencerExternalClock();
  uint8_t len[4], on[4][16], note[4][16], vel[4][16], gate[4][16];
  for(uint8_t t=0;t<4;++t){
    len[t]=(uint8_t)constrain((int)_screens.sequencerTrackLength(t),1,16);
    for(uint8_t st=0;st<16;++st){
      on[t][st]=_screens.sequencerStepOn(t,st)?1U:0U;
      note[t][st]=(uint8_t)constrain((int)_screens.sequencerStepNote(t,st),0,127);
      vel[t][st]=(uint8_t)constrain((int)_screens.sequencerStepVelocity(t,st),1,127);
      gate[t][st]=(uint8_t)constrain((int)_screens.sequencerStepGate(t,st),1,100);
    }
  }
  portENTER_CRITICAL(&_seqMidiMux);
  _seqRtExternalEnabled=ext;
  for(uint8_t t=0;t<4;++t){
    _seqRtTrackLength[t]=len[t];
    for(uint8_t st=0;st<16;++st){ _seqRtStepOn[t][st]=on[t][st]; _seqRtStepNote[t][st]=note[t][st]; _seqRtStepVelocity[t][st]=vel[t][st]; _seqRtStepGate[t][st]=gate[t][st]; }
  }
  ++_seqRtConfigGeneration;
  portEXIT_CRITICAL(&_seqMidiMux);
}

void PhoenixOS::scheduleRealtimeSequencerStep(uint32_t targetUs, uint32_t stepUs) {
  struct E { uint8_t t,n,v,g; bool on; uint32_t id; } e[4];
  stepUs=constrain(stepUs,20000UL,2000000UL);
  portENTER_CRITICAL(&_seqMidiMux);
  for(uint8_t t=0;t<4;++t){
    const uint8_t length=(uint8_t)constrain((int)_seqRtTrackLength[t],1,16);
    const uint8_t st=_seqRtPlayhead[t]%length;
    e[t].t=t; e[t].on=_seqRtStepOn[t][st]!=0; e[t].n=_seqRtStepNote[t][st]; e[t].v=_seqRtStepVelocity[t][st]; e[t].g=_seqRtStepGate[t][st]; e[t].id=++_seqRtEventId;
    _seqRtPlayhead[t]=(uint8_t)((st+1U)%length);
  }
  portEXIT_CRITICAL(&_seqMidiMux);
  for(uint8_t i=0;i<4;++i){
    if(!e[i].on) continue;
    uint32_t gateUs=(uint32_t)(((uint64_t)stepUs*e[i].g)/100ULL); if(gateUs<1000UL)gateUs=1000UL;
    const uint32_t gateFrames=(uint32_t)(((uint64_t)gateUs*32000ULL+999999ULL)/1000000ULL);
    if(!_audio.queueSequencerNoteScheduled(e[i].t,e[i].n,e[i].v,gateFrames,targetUs,e[i].id)) ++_seqGateRecycleCount;
  }
  ++_seqStepEventCount;
}

void PhoenixOS::realtimeSequencerTaskThunk(void *arg) { static_cast<PhoenixOS*>(arg)->realtimeSequencerTask(); }

void PhoenixOS::realtimeSequencerTask() {
  PHX_INFO_PRINTF("V1.0 SEQRT task core=%d priority=%u\n", xPortGetCoreID(), (unsigned)uxTaskPriorityGet(nullptr));
  uint8_t phase=0; uint32_t lastStepClockUs=0; bool preScheduled=false; uint32_t predictedTargetUs=0;
  for(;;){
    ulTaskNotifyTake(pdTRUE,pdMS_TO_TICKS(5));
    uint32_t ticks[32]; uint8_t count=0, transport=0; uint32_t periodUs=0;
    portENTER_CRITICAL(&_seqMidiMux);
    transport=_seqMidiTransportPending; _seqMidiTransportPending=0U;
    while(_seqClockRead!=_seqClockWrite && count<32U){ ticks[count++]=_seqClockUs[_seqClockRead]; _seqClockRead=(uint8_t)((_seqClockRead+1U)%kSeqClockQueueSize); }
    periodUs=_seqMidiClockPeriodUs;
    portEXIT_CRITICAL(&_seqMidiMux);
    if(count>_seqRtBatchMax)_seqRtBatchMax=count;

    if(transport==3U){
      _seqRtRunning=false; preScheduled=false; lastStepClockUs=0; phase=0; _audio.queueSequencerStop(); ++_seqTransportStopCount;
    } else if(transport==1U){
      _audio.queueSequencerStop();
      portENTER_CRITICAL(&_seqMidiMux); for(uint8_t t=0;t<4;++t)_seqRtPlayhead[t]=0; portEXIT_CRITICAL(&_seqMidiMux);
      _seqRtRunning=true; phase=5; preScheduled=false; lastStepClockUs=0; ++_seqTransportStartCount;
    } else if(transport==2U){
      _seqRtRunning=true; phase=5; preScheduled=false; lastStepClockUs=0; ++_seqTransportContinueCount;
    }

    if(!_seqRtExternalEnabled){ continue; }
    for(uint8_t i=0;i<count;++i){
      const uint32_t tickUs=ticks[i];
      const uint32_t late=(uint32_t)(micros()-tickUs);
      if(late>_seqRtLateMaxUs)_seqRtLateMaxUs=late; _seqRtLateAccumUs+=late; ++_seqRtLateCount;
      if(!_seqRtRunning){ ++_seqIdleClockTicksIgnored; continue; }
      phase=(uint8_t)((phase+1U)%6U);
      if(phase==0U){
        ++_seqRtCompletedSteps;
        if(preScheduled){
          const int32_t err=(int32_t)(tickUs-predictedTargetUs); const uint32_t ae=(uint32_t)(err<0?-err:err); if(ae>_seqRtPredictionErrorMaxUs)_seqRtPredictionErrorMaxUs=ae;
          preScheduled=false;
        } else {
          uint32_t stepUs=periodUs?periodUs*6UL:125000UL;
          if(lastStepClockUs){ const uint32_t m=tickUs-lastStepClockUs; if(m>=20000UL&&m<=2000000UL)stepUs=m; }
          scheduleRealtimeSequencerStep(tickUs,stepUs);
        }
        lastStepClockUs=tickUs;
      } else if(phase==5U && periodUs>=1000U && periodUs<=200000U){
        // One F8 early: enough lead time for AudioTask to place the onset at
        // the exact frame of the block containing the predicted sixth tick.
        predictedTargetUs=tickUs+periodUs;
        scheduleRealtimeSequencerStep(predictedTargetUs,periodUs*6UL);
        preScheduled=true;
      }
    }
  }
}



void PhoenixOS::resetDiagnostics() {
  _audio.resetDiagnostics();
  _diagStartMs = millis();
  _diagLoopAvgUs = 0;
  _diagLoopPeakUs = 0;
  _diagDrawAvgUs = 0;
  _diagDrawPeakUs = 0;
  _diagGuiFps10 = 0;
  _diagLastPublishMs = 0;
  _perfWindowStartMs = millis();
  _perfLoopAccumUs = 0;
  _perfLoopCount = 0;
  _perfLoopMaxUs = 0;
  _perfDrawAccumUs = 0;
  _perfDrawCount = 0;
  _perfDrawMaxUs = 0;
  _seqDroppedClockTicks = 0; _seqClockQueueDrops=0; _seqClockBatchMax=0; _seqStepLateMaxUs=0; _seqStepEventCount=0; _seqRtLateMaxUs=0; _seqRtLateAccumUs=0; _seqRtLateCount=0; _seqRtBatchMax=0; _seqRtPredictionErrorMaxUs=0;
  _seqIdleClockTicksIgnored = 0;
  _seqTransportStartCount = 0;
  _seqTransportContinueCount = 0;
  _seqTransportStopCount = 0;
  _seqPatternTransitionCount = 0;
  _seqGateRecycleCount = 0;
  _seqForcedGateReleaseCount = 0;
  _integrationBankQuiesceCount = 0;
  _integrationBankLoadFailCount = 0;
  _integrationBankSaveFailCount = 0;
  _integrationStaleClockTicksCleared = 0;
  _integrationActiveVoiceGuardCount = 0;
  printDiagnosticsSnapshot("RESET");
}

void PhoenixOS::printDiagnosticsSnapshot(const char *reason) {
  const uint32_t internalFree = heap_caps_get_free_size(MALLOC_CAP_INTERNAL | MALLOC_CAP_8BIT);
  const uint32_t internalMin = heap_caps_get_minimum_free_size(MALLOC_CAP_INTERNAL | MALLOC_CAP_8BIT);
  const uint32_t internalLargest = heap_caps_get_largest_free_block(MALLOC_CAP_INTERNAL | MALLOC_CAP_8BIT);
  const uint32_t psramFree = ESP.getFreePsram();
  const uint32_t psramLargest = heap_caps_get_largest_free_block(MALLOC_CAP_SPIRAM | MALLOC_CAP_8BIT);
  Serial.printf("V1.0 SNAP reason=%s time=%lus voices=%u/%u vpeak=%u steals=%lu audio_avg=%luus audio_peak=%luus audio_last=%luus risk=%lu overrun=%lu dma=%lu midi_cmd_drop=%lu midi_ctl_drop=%lu gui_avg=%luus gui_peak=%luus fps=%lu.%lu loop_avg=%luus loop_peak=%luus heap_free=%luKB heap_min=%luKB heap_largest=%luKB psram_free=%luKB psram_largest=%luKB | seq_start=%lu seq_cont=%lu seq_stop=%lu seq_pat=%lu seq_tick_drop=%lu seq_idle_clk=%lu seq_gate_recycle=%lu seq_gate_release=%lu | bank_q=%lu load_fail=%lu save_fail=%lu stale_clk=%lu guard=%lu\n",
                reason ? reason : "MANUAL",
                (unsigned long)((millis() - _diagStartMs) / 1000UL),
                (unsigned)_audio.activeVoiceCount(), (unsigned)PhoenixAudioManager::VOICE_COUNT,
                (unsigned)_audio.activeVoicePeak(), (unsigned long)_audio.voiceStealCount(),
                (unsigned long)_audio.audioLoadAvgUs(), (unsigned long)_audio.audioLoadPeakUs(),
                (unsigned long)_audio.audioLoadLastUs(), (unsigned long)_audio.audioRiskCount(),
                (unsigned long)_audio.audioOverrunCount(), (unsigned long)_audio.underruns(),
                (unsigned long)_audio.midiCommandDrops(), (unsigned long)_midiControlDrops,
                (unsigned long)_diagDrawAvgUs, (unsigned long)_diagDrawPeakUs,
                (unsigned long)(_diagGuiFps10 / 10UL), (unsigned long)(_diagGuiFps10 % 10UL),
                (unsigned long)_diagLoopAvgUs, (unsigned long)_diagLoopPeakUs,
                (unsigned long)(internalFree / 1024UL), (unsigned long)(internalMin / 1024UL),
                (unsigned long)(internalLargest / 1024UL), (unsigned long)(psramFree / 1024UL),
                (unsigned long)(psramLargest / 1024UL),
                (unsigned long)_seqTransportStartCount, (unsigned long)_seqTransportContinueCount,
                (unsigned long)_seqTransportStopCount, (unsigned long)_seqPatternTransitionCount,
                (unsigned long)_seqDroppedClockTicks, (unsigned long)_seqIdleClockTicksIgnored, (unsigned long)_seqGateRecycleCount,
                (unsigned long)_seqForcedGateReleaseCount);
}

void PhoenixOS::publishDiagnostics() {
  if (!_screens.diagnosticsVisible()) return;
  const uint32_t now = millis();
  if (_diagLastPublishMs != 0U && (uint32_t)(now - _diagLastPublishMs) < 200UL) return;
  _diagLastPublishMs = now;
  const uint32_t internalFree = heap_caps_get_free_size(MALLOC_CAP_INTERNAL | MALLOC_CAP_8BIT);
  const uint32_t internalMin = heap_caps_get_minimum_free_size(MALLOC_CAP_INTERNAL | MALLOC_CAP_8BIT);
  _screens.setDiagnosticsStatus(now - _diagStartMs,
                                _audio.activeVoiceCount(), PhoenixAudioManager::VOICE_COUNT,
                                _audio.activeVoicePeak(), _audio.audioLoadAvgUs(),
                                _audio.audioLoadPeakUs(), _audio.audioRiskCount(),
                                _audio.audioOverrunCount(), _audio.underruns(),
                                _audio.voiceStealCount(), internalFree / 1024UL,
                                internalMin / 1024UL, ESP.getFreePsram() / 1024UL);
}

void PhoenixOS::updateSequencer() {
  processSequencerMidiTransport();
  refreshRealtimeSequencerSnapshot();
  const uint32_t now = millis();

  const uint8_t currentPattern = _screens.sequencerPattern();
  if (currentPattern != _seqLastPattern) {
    if (_screens.sequencerRunning()) stopSequencerVoices();
    _seqLastPattern = currentPattern;
    portENTER_CRITICAL(&_seqMidiMux); for(uint8_t t=0;t<4;++t)_seqRtPlayhead[t]=0; portEXIT_CRITICAL(&_seqMidiMux);
    _songPatternStepCounter = 0;
    ++_seqPatternTransitionCount;
  }

  if (_screens.sequencerExternalClock()) {
    const bool rtRun=_seqRtRunning;
    _screens.setSequencerRunning(rtRun);
    for(uint8_t t=0;t<4;++t) _screens.setSequencerTrackPlayhead(t,_seqRtPlayhead[t]);
    if(rtRun && !_seqWasRunning){ startSongTestTransport(); _seqWasRunning=true; }
    else if(!rtRun && _seqWasRunning){ pauseSongTransport(); _seqWasRunning=false; }
    const uint32_t done=_seqRtCompletedSteps;
    while(_seqRtLastUiCompletedSteps<done){ ++_seqRtLastUiCompletedSteps; advanceSongPatternCycle(); }
    return;
  }

  const bool running = _screens.sequencerRunning();
  if (!running) {
    if (_seqWasRunning) {
      stopSequencerVoices();
      stopSongTransport();
      _screens.setSequencerPlayhead(0);
    }
    _seqWasRunning = false;
    return;
  }

  uint16_t bpm = _screens.sequencerInternalBpm();
  if (bpm < 40) bpm = 40;
  if (bpm > 240) bpm = 240;
  const uint32_t stepMs = 15000UL / bpm;
  if (!_seqWasRunning) {
    startSongTestTransport();
    _seqLastStepMs = now - stepMs;
    _seqWasRunning = true;
  }
  const uint32_t elapsed = (uint32_t)(now - _seqLastStepMs);
  if (elapsed >= stepMs) {
    // v0.7.36: Recover cleanly after a long blocking operation instead of
    // replaying a burst of overdue steps or carrying permanent timing drift.
    if (elapsed > stepMs * 4UL) _seqLastStepMs = now - stepMs;
    _seqLastStepMs += stepMs;
    const uint8_t st = (uint8_t)(_screens.sequencerPlayhead() & 15U);
    triggerSequencerStep(st, stepMs * 1000UL);
  }
}
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
