RealTimeAudioLab/RTAL-EAI-004-Phoenix-Sound-Sampler/firmware/Phoenix_v1.1.0/src/PhoenixAudio/PhoenixAudioManager.cpp

#include "../PhoenixSystem/PhoenixSerial.h"
#include "PhoenixAudioManager.h"

// C034 keeps the C029e stable O3 audio baseline unchanged.
#pragma GCC optimize ("O3")
#pragma GCC optimize ("fast-math")

static constexpr uint8_t PHX_DEFAULT_POLY_VOICE_LIMIT = 12;
static constexpr bool PHX_ENABLE_VOICE_AUDIT = false;
// C034: production default remains profiler OFF; set to 1 only for targeted DSP profiling.
#ifndef PHX_DSP_PROFILER_ENABLED
#define PHX_DSP_PROFILER_ENABLED 0
#endif
static constexpr bool PHX_ENABLE_DSP_PROFILER = (PHX_DSP_PROFILER_ENABLED != 0);
static constexpr uint8_t PHX_DSP_PROFILE_EVERY_N_BLOCKS = 32;

// v1.1.0 FINAL: Reverb micro-timing is diagnostic-only and is compiled out by default.
// Set to 1 only for targeted measurements. When enabled, exactly one Reverb
// call per 128-frame block is timed instead of every audio frame.
#ifndef PHX_REVERB_TIMING_ENABLED
#define PHX_REVERB_TIMING_ENABLED 0
#endif
#include "driver/i2s.h"
#include <math.h>
#include <SD.h>
#include <new>
#include "esp_cpu.h"
#include "esp_heap_caps.h"
#include "esp_timer.h"

#ifndef I2S_COMM_FORMAT_STAND_I2S
  #define PHX_I2S_COMM_FORMAT ((i2s_comm_format_t)(I2S_COMM_FORMAT_I2S | I2S_COMM_FORMAT_I2S_MSB))
#else
  #define PHX_I2S_COMM_FORMAT I2S_COMM_FORMAT_STAND_I2S
#endif

static inline uint32_t phxAbs32(int32_t v) {
  if (v == INT32_MIN) return 0x7FFFFFFFUL;
  return (v < 0) ? (uint32_t)(-v) : (uint32_t)v;
}

static inline int16_t phxClamp16(int32_t v) {
  if (v > 32767) return 32767;
  if (v < -32768) return -32768;
  return (int16_t)v;
}

// v0.7.19d: soft master limiter with a gentle knee at -2.5 dBFS.
// Signals below the knee pass unchanged. Peaks above the knee are compressed
// smoothly towards full scale instead of being hard-clipped.
static inline int16_t phxSoftLimit16(int32_t v) {
  const uint32_t threshold = 24576U; // 75 % of full scale
  const uint32_t kneeRange = 8192U;

  const bool negative = (v < 0);
  uint32_t magnitude;
  if (v == INT32_MIN) magnitude = 0x7FFFFFFFUL;
  else magnitude = negative ? (uint32_t)(-v) : (uint32_t)v;

  if (magnitude <= threshold) return (int16_t)v;

  const uint32_t over = magnitude - threshold;
  uint32_t limited = threshold + (uint32_t)(((uint64_t)over * kneeRange) / (over + kneeRange));
  if (limited > 32767U) limited = 32767U;

  return negative ? (int16_t)(-(int32_t)limited) : (int16_t)limited;
}

static const int16_t PHX_SINE_1024_Q15[1024] = {
       0,    201,    402,    603,    804,   1005,   1206,   1407,   1608,   1809,   2009,   2210,   2410,   2611,   2811,   3012,
    3212,   3412,   3612,   3811,   4011,   4210,   4410,   4609,   4808,   5007,   5205,   5404,   5602,   5800,   5998,   6195,
    6393,   6590,   6786,   6983,   7179,   7375,   7571,   7767,   7962,   8157,   8351,   8545,   8739,   8933,   9126,   9319,
    9512,   9704,   9896,  10087,  10278,  10469,  10659,  10849,  11039,  11228,  11417,  11605,  11793,  11980,  12167,  12353,
   12539,  12725,  12910,  13094,  13279,  13462,  13645,  13828,  14010,  14191,  14372,  14553,  14732,  14912,  15090,  15269,
   15446,  15623,  15800,  15976,  16151,  16325,  16499,  16673,  16846,  17018,  17189,  17360,  17530,  17700,  17869,  18037,
   18204,  18371,  18537,  18703,  18868,  19032,  19195,  19357,  19519,  19680,  19841,  20000,  20159,  20317,  20475,  20631,
   20787,  20942,  21096,  21250,  21403,  21554,  21705,  21856,  22005,  22154,  22301,  22448,  22594,  22739,  22884,  23027,
   23170,  23311,  23452,  23592,  23731,  23870,  24007,  24143,  24279,  24413,  24547,  24680,  24811,  24942,  25072,  25201,
   25329,  25456,  25582,  25708,  25832,  25955,  26077,  26198,  26319,  26438,  26556,  26674,  26790,  26905,  27019,  27133,
   27245,  27356,  27466,  27575,  27683,  27790,  27896,  28001,  28105,  28208,  28310,  28411,  28510,  28609,  28706,  28803,
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
  return scaled << 16;
}

static inline int32_t phxDbToAmpQ15(int8_t db) {
  if (db > -3) db = -3;
  if (db < -60) db = -60;
  float a = powf(10.0f, (float)db / 20.0f);
  int32_t q = (int32_t)(a * 32767.0f + 0.5f);
  if (q < 1) q = 1;
  if (q > 32767) q = 32767;
  return q;
}

static const uint32_t PHX_PITCH_INC_Q16[49] = {
  16384, 17358, 18390, 19484, 20643, 21870, 23170, 24548,
  26008, 27554, 29193, 30929, 32768, 34716, 36781, 38968,
  41285, 43740, 46341, 49097, 52016, 55109, 58386, 61858,
  65536, 69433, 73562, 77936, 82570, 87481, 92682, 98193,
  104032, 110218, 116772, 123716, 131072, 138866, 147124, 155872,
  165140, 174963, 185364, 196386, 208064, 220436, 233544, 247432,
  262144
};

PhoenixAudioManager::PhoenixAudioManager(int bclkPin, int lrckPin, int doutPin, int dinPin)
: _bclkPin(bclkPin), _lrckPin(lrckPin), _doutPin(doutPin), _dinPin(dinPin),
  _testTone(TONE_THRU), _state(AUDIO_THRU), _peakLevel(0), _peakHoldLevel(0), _lastPeakLevel(0),
  _clipActive(false), _highActive(false), _audioOk(false), _psramOk(false),
  _psramFreeKb(0), _frameCounter(0), _underruns(0), _lastPeakRaw(0), _clipCount(0),
  _dcOffsetL(0), _dcOffsetR(0),
  _lastTickMs(0), _clipHoldUntilMs(0), _highHoldUntilMs(0), _peakHoldUntilMs(0),
  _peakReleaseMs(0), _phase(0), _noise(0x12345678UL), _testFrequencyHz(440), _testLevelDb(-12), _testAmpQ15(PHX_TONE_AMP_Q15),
  _keygroups(nullptr), _selectedSlot(0), _recordSlot(0), _playSlot(0), _recordPos(0), _preTriggerWrite(0), _preTriggerCount(0), _playPos(0),
  _playPosQ16(0), _playIncQ16(65536UL), _playRangeActive(false), _playRangeStart(0), _playRangeEnd(0), _transportLoopForward(true), _lastReplayReverse(false), _triggerAuto(false), _triggerLevel(4), _pitchSemitone(0),
  _previewBuffer(nullptr), _previewCapacityFrames(0), _previewFrames(0), _previewPos(0),
  _activeVoiceCount(0), _activeVoicePeak(0), _voiceAgeCounter(0), _heldAgeCounter(0),
  _voiceStealCount(0), _duplicateNoteOnCount(0), _orphanNoteOffCount(0), _sustainDeferredNoteOffCount(0), _panicKillCount(0), _lastAllocatorScanMax(0), _highestAllocatorScanMax(0), _lastAllocatedVoice(255), _lastAllocationReason(0), _voiceAuditPrintMs(0),
  _audioLoadAvgUs(0), _audioLoadMaxUs(0), _audioLoadLastUs(0), _audioRiskCount(0), _audioOverrunCount(0), _audioLoadPeakUs(0), _audioLoadAccumUs(0), _audioLoadBlocks(0), _audioLoadWindowStartMs(0), _audioStatsPrintMs(0),
  _peakTraceSeq(0), _peakTracePeakUs(0), _peakTraceFrame(0), _peakTraceVoices(0), _peakTraceReleasing(0),
  _peakTraceMultisample(0), _peakTraceFilterActive(0), _peakTraceVintageActive(0),
  _peakTraceSlotMask(0), _peakTraceEchoMix(0), _peakTraceReverbMix(0), _peakTraceReverbSize(0),
  _peakTraceReverbDecay(0), _peakTraceReverbDamp(0), _peakTraceState(0), _peakTraceQuattroMode(0),
  _peakTraceTailActive(0), _peakTracePrintedSeq(0),
  _dspProfileSamples(0), _dspSetupEnvUs(0), _dspPrepUs(0), _dspEnvelopeUs(0), _dspFetchXfadeUs(0),
  _dspVintageUs(0), _dspFilterUs(0), _dspGainMixUs(0), _dspPositionUs(0), _dspMixPosUs(0), _dspEchoOutUs(0), _dspProfilerPrintMs(0), _dspProfileDivider(0),
  _transportVintagePhase(0), _transportVintageHold(0), _transportVintageFilterState(0), _transportVintageNoise(0x13579BDFUL),
  _echoBuffer(nullptr), _echoCapacityFrames(0), _echoDelayMs(250), _echoFeedback(35), _echoMix(20),
  _reverbSize(55), _reverbDecay(55), _reverbDamp(45), _reverbMix(20), _reverbProcessUs(0), _reverbMem(nullptr),
  _reverbCacheReady(false), _reverbCachedSize(255), _reverbCachedDecay(255), _reverbCachedDamp(255),
  _reverbCachedFbQ15(18022), _reverbCachedLpShift(2), _echoWritePos(0),
  _echoDelayFramesCurrent(8000), _echoDelayFramesXfadeTo(8000), _echoDelayXfadePos(0), _echoDelayXfadeActive(false),
  _echoFeedbackQ8Current(35 * 256), _echoMixQ8Current(20 * 256),
  _echoLimitCount(0), _filterGuardCount(0), _echoParamSlewCount(0),
  _msNoteMissCount(0), _msVelocityMissCount(0), _msRrFallbackCount(0), _msSanitizeCount(0),
  _echoTailActive(false), _echoTailQuietFrames(0),
  _progressCallback(nullptr), _progressContext(nullptr), _progressBase(0), _progressSpan(100),
  _audioTaskHandle(nullptr) {
  _quattroMode = 1;
  for (uint8_t i = 0; i < SLOT_COUNT; ++i) { _slotVoicePlayheadActive[i] = false; _slotVoicePlayheadFrame[i] = 0; _slotVoicePlayheadVoice[i] = -1; _slotVoicePlayheadAge[i] = 0; _slotMarkerRevision[i] = 1; _slotCoarse[i] = 0; _slotFine[i] = 0; _slotRoot[i] = 60; _slotPitchBendRange[i] = 2; _slotPitchBend[i] = 0; _slotOctave[i] = 0; _slotPitchTrack[i] = true; _slotAttackMs[i] = 5; _slotDecayMs[i] = 80; _slotSustainPct[i] = 100; _slotReleaseMs[i] = 80; _slotSustainDown[i] = false; _slotVintagePreset[i] = 0; _slotVintageSampleRate[i] = 0; _slotVintageBitDepth[i] = 0; _slotVintageFilter[i] = 0; _slotVintageJitter[i] = 0; _slotEchoSend[i] = 0; _slotReverbSend[i] = 0; _slotSampleGainPct[i]=100; _slotVelocityAmount[i]=100; _slotLevel[i]=100; _slotPan[i]=0; _slotGainLQ15[i]=23170; _slotGainRQ15[i]=23170; _slotFilterCutoff[i]=100; _slotFilterResonance[i]=0; _slotFilterEnvAmount[i]=0; _slotFilterVelocityAmount[i]=0; _slotFilterKeytrack[i]=0; _slotFilterAttackMs[i]=0; _slotFilterDecayMs[i]=250; _slotFilterSustainPct[i]=0; _slotFilterReleaseMs[i]=300; _quattroKeyLow[i] = i * 32; _quattroKeyHigh[i] = (i == 3) ? 127 : (i * 32 + 31); _quattroMidiChannel[i] = i + 1; }
  for (uint8_t i = 0; i < VOICE_COUNT; ++i) { _voices[i] = InstrumentVoice(); _voiceAllocCount[i] = 0; }
  for(uint8_t t=0;t<4;++t) for(uint8_t g=0;g<SEQ_GATES_PER_TRACK;++g){ _seqAudioGate[t][g].active=false; _seqAudioGate[t][g].voiceId=-1; _seqAudioGate[t][g].ownershipToken=0; _seqAudioGate[t][g].framesLeft=0; _seqAudioGate[t][g].eventId=0; }
  for (uint8_t i = 0; i <= VOICE_COUNT; ++i) { _voiceHistCount[i] = 0; _voiceHistSumUs[i] = 0; _voiceHistMaxUs[i] = 0; }
  // Safe defaults before any BANK.CFG is loaded.
  for (uint8_t i = 0; i < SLOT_COUNT; ++i) { _slotVoiceMode[i]=0; _slotVoiceLimit[i]=PHX_DEFAULT_POLY_VOICE_LIMIT; _slotNotePriority[i]=0; _slotGlideMs[i]=0; }
  memset(_heldNotes, 0, sizeof(_heldNotes));
  memset(_heldVelocity, 0, sizeof(_heldVelocity));
  memset(_heldAge, 0, sizeof(_heldAge));
  memset(_noteHoldCount, 0, sizeof(_noteHoldCount));
}


void PhoenixAudioManager::reportProgress(uint8_t percent) {
  if (!_progressCallback) return;
  if (percent > 100) percent = 100;
  uint16_t mapped = (uint16_t)_progressBase + ((uint16_t)_progressSpan * percent) / 100U;
  if (mapped > 100U) mapped = 100U;
  _progressCallback((uint8_t)mapped, _progressContext);
}

void PhoenixAudioManager::begin() {
  _testTone = TONE_THRU;
  _state = AUDIO_THRU;
  _peakLevel = 0;
  _peakHoldLevel = 0;
  _lastPeakLevel = 0;
  _clipActive = false;
  _highActive = false;
  _frameCounter = 0;
  _underruns = 0;
  _lastPeakRaw = 0;
  _clipCount = 0;
  _dcOffsetL = 0;
  _dcOffsetR = 0;
  _recordPos = 0;
  _preTriggerWrite = 0;
  _preTriggerCount = 0;
  _playPos = 0;
  _previewFrames = 0;
  _previewPos = 0;
  _playPosQ16 = 0;
  _playIncQ16 = 65536UL;
  _playRangeActive = false;
  _playRangeStart = 0;
  _playRangeEnd = 0;
  _transportLoopForward = true;
  _lastReplayReverse = false;
  _triggerAuto = false;
  _triggerLevel = 4;
  _pitchSemitone = 0;
  _activeVoiceCount = 0;
  _activeVoicePeak = 0;
  _voiceAgeCounter = 0;
  _voiceStealCount = 0; _duplicateNoteOnCount = 0; _orphanNoteOffCount = 0;
  _sustainDeferredNoteOffCount = 0; _panicKillCount = 0; _lastAllocatorScanMax = 0; _highestAllocatorScanMax = 0;
  _lastAllocatedVoice = 255; _lastAllocationReason = 0; _voiceAuditPrintMs = millis();
  for (uint8_t i=0;i<VOICE_COUNT;++i) _voiceAllocCount[i]=0;
  _audioLoadAvgUs = 0; _audioLoadMaxUs = 0; _audioLoadLastUs = 0; _audioRiskCount = 0; _audioOverrunCount = 0; _audioLoadPeakUs = 0;
  _audioLoadAccumUs = 0; _audioLoadBlocks = 0; _audioLoadWindowStartMs = millis(); _audioStatsPrintMs = millis();
  _transportVintagePhase = 0; _transportVintageHold = 0; _transportVintageFilterState = 0; _transportVintageNoise = 0x13579BDFUL;
  for (uint8_t i = 0; i < VOICE_COUNT; ++i) _voices[i] = InstrumentVoice();
  for (uint8_t i = 0; i < SLOT_COUNT; ++i) { _slotVoicePlayheadActive[i] = false; _slotVoicePlayheadFrame[i] = 0; _slotVoicePlayheadVoice[i] = -1; _slotVoicePlayheadAge[i] = 0; _slotMarkerRevision[i] = 1; _slotCoarse[i] = 0; _slotFine[i] = 0; _slotRoot[i] = 60; _slotPitchBendRange[i] = 2; _slotPitchBend[i] = 0; _slotOctave[i] = 0; _slotPitchTrack[i] = true; _slotAttackMs[i] = 5; _slotDecayMs[i] = 80; _slotSustainPct[i] = 100; _slotReleaseMs[i] = 80; _slotSustainDown[i] = false; _slotVintagePreset[i] = 0; _slotVintageSampleRate[i] = 0; _slotVintageBitDepth[i] = 0; _slotVintageFilter[i] = 0; _slotVintageJitter[i] = 0; _slotEchoSend[i] = 0; _slotReverbSend[i] = 0; _slotSampleGainPct[i]=100; _slotVelocityAmount[i]=100; _slotLevel[i]=100; _slotPan[i]=0; _slotGainLQ15[i]=23170; _slotGainRQ15[i]=23170; _slotFilterCutoff[i]=100; _slotFilterResonance[i]=0; _slotFilterEnvAmount[i]=0; _slotFilterVelocityAmount[i]=0; _slotFilterKeytrack[i]=0; _slotFilterAttackMs[i]=0; _slotFilterDecayMs[i]=250; _slotFilterSustainPct[i]=0; _slotFilterReleaseMs[i]=300; _quattroKeyLow[i] = i * 32; _quattroKeyHigh[i] = (i == 3) ? 127 : (i * 32 + 31); _quattroMidiChannel[i] = i + 1; _slotVoiceMode[i]=0; _slotVoiceLimit[i]=PHX_DEFAULT_POLY_VOICE_LIMIT; _slotNotePriority[i]=0; _slotGlideMs[i]=0; }
  memset(_heldNotes, 0, sizeof(_heldNotes));
  memset(_heldVelocity, 0, sizeof(_heldVelocity));
  memset(_heldAge, 0, sizeof(_heldAge));
  memset(_noteHoldCount, 0, sizeof(_noteHoldCount));
  _heldAgeCounter = 0;
  _echoDelayMs = 250;
  _echoFeedback = 35;
  _echoMix = 20;
  _echoWritePos = 0;
  _echoDelayFramesCurrent = 8000;
  _echoDelayFramesXfadeTo = 8000;
  _echoDelayXfadePos = 0;
  _echoDelayXfadeActive = false;
  _echoFeedbackQ8Current = 35 * 256;
  _echoMixQ8Current = 20 * 256;
  _echoLimitCount = 0;
  _filterGuardCount = 0;
  _echoParamSlewCount = 0;
  _msNoteMissCount = 0; _msVelocityMissCount = 0; _msRrFallbackCount = 0; _msSanitizeCount = 0;
  _seqCmdDrops=0; _seqNoteOnFailCount=0; _seqOwnerFailCount=0; _seqOwnerStaleCount=0; _seqScheduleMissCount=0; _seqFrameOffsetMax=0;
  _echoTailActive = false;
  _echoTailQuietFrames = 0;
  _selectedSlot = 0;
  _recordSlot = 0;
  _playSlot = 0;
  _lastTickMs = millis();
  _phase = 0;
  _noise = 0x12345678UL;

  _psramOk = psramFound();
#if defined(ESP_ARDUINO_VERSION_MAJOR)
  _psramFreeKb = _psramOk ? (ESP.getFreePsram() / 1024UL) : 0;
#else
  _psramFreeKb = 0;
#endif

  const bool keygroupMetaOk = allocateKeygroupMetadata();
  allocateSampleBuffers();
  allocatePreviewBuffer();
  allocateEchoBuffer();
  allocateReverbBuffers();
  _audioOk = keygroupMetaOk && beginI2S();
  if (_audioOk) {
    xTaskCreatePinnedToCore(audioTaskThunk, "PhoenixAudio", 8192, this, 24, &_audioTaskHandle, 1);
  }
}

bool PhoenixAudioManager::allocateKeygroupMetadata() {
  if (_keygroups) return true;

  const size_t count = (size_t)SLOT_COUNT * (size_t)MAX_KEYGROUPS;
  const size_t bytes = count * sizeof(MultisampleKeygroup);
  void *memory = nullptr;
  bool inPsram = false;

  if (psramFound()) {
    memory = ps_malloc(bytes);
    inPsram = (memory != nullptr);
  }
  // Fallback keeps Phoenix functional on an unexpected board/configuration,
  // but the normal ESP32-S3 8 MB PSRAM target always uses external RAM here.
  if (!memory) memory = malloc(bytes);
  if (!memory) {
    Serial.printf("MEM ERROR: multisample metadata allocation failed (%u bytes)\n",
                  (unsigned)bytes);
    return false;
  }

  _keygroups = reinterpret_cast<MultisampleKeygroup (*)[MAX_KEYGROUPS]>(memory);
  MultisampleKeygroup *flat = &_keygroups[0][0];
  for (size_t i = 0; i < count; ++i) {
    new (&flat[i]) MultisampleKeygroup();
  }

  PHX_INFO_PRINTF("MEM: multisample metadata %u bytes in %s\n",
                (unsigned)bytes, inPsram ? "PSRAM" : "internal heap fallback");
  return true;
}


bool PhoenixAudioManager::allocateSampleBuffers() {
  // v0.5.5: four Quattro-ready mono sample slots.
  // 10 seconds per slot at 32 kHz / 16-bit = 640 kB per slot, ~2.5 MB total.
  const uint32_t framesPerSlot = psramFound() ? (32000UL * 10UL) : (32000UL * 1UL);
  const size_t bytesPerSlot = (size_t)framesPerSlot * sizeof(int16_t);

  bool ok = true;
  for (uint8_t i = 0; i < SLOT_COUNT; ++i) {
    if (_slots[i].buffer) continue;
    _slots[i].capacityFrames = framesPerSlot;
    if (psramFound()) _slots[i].buffer = (int16_t*)ps_malloc(bytesPerSlot);
    else _slots[i].buffer = (int16_t*)malloc(bytesPerSlot);
    if (!_slots[i].buffer) {
      _slots[i].capacityFrames = 0;
      ok = false;
    } else {
      memset(_slots[i].buffer, 0, bytesPerSlot);
      _slots[i].frames = 0;
      _slots[i].recorded = false;
      _slots[i].loopEnabled = false;
      _slots[i].sampleStart = 0;
      _slots[i].sampleEnd = framesPerSlot;
      _slots[i].loopStart = 0;
      _slots[i].loopEnd = framesPerSlot;
      _slots[i].loopMode = 0;
      _slots[i].loopXfadeMs = 0;
      _slots[i].trimEnabled = false;
      _slots[i].trimUndoValid = false;
      _slots[i].trimUndoSampleStart = 0; _slots[i].trimUndoLoopStart = 0;
      _slots[i].trimUndoLoopEnd = 0; _slots[i].trimUndoSampleEnd = 0;
    }
  }
  return ok;
}


bool PhoenixAudioManager::allocatePreviewBuffer() {
  // v0.7.13i: non-destructive Sample Browser preview buffer.
  // v0.7.13j: a browser preview should start quickly, not copy a full slot.
  // Three seconds are sufficient for auditioning and reduce PSRAM and SD traffic.
  const uint32_t frames = psramFound() ? (32000UL * 3UL) : (32000UL * 1UL);
  const size_t bytes = (size_t)frames * sizeof(int16_t);
  if (_previewBuffer) return true;
  if (psramFound()) _previewBuffer = (int16_t*)ps_malloc(bytes);
  else _previewBuffer = (int16_t*)malloc(bytes);
  if (!_previewBuffer) {
    _previewCapacityFrames = 0;
    _previewFrames = 0;
    return false;
  }
  _previewCapacityFrames = frames;
  _previewFrames = 0;
  _previewPos = 0;
  memset(_previewBuffer, 0, bytes);
  return true;
}

bool PhoenixAudioManager::allocateEchoBuffer() {
  // v1.1.0 DEV2c: mono classic echo, up to 2000 ms at 32 kHz.
  // INIT_SOUND already allows 2000 ms; keep the DSP/UI/storage range consistent.
  const uint32_t frames = 64000UL;
  const size_t bytes = (size_t)frames * sizeof(int16_t);
  if (_echoBuffer) return true;
  if (psramFound()) _echoBuffer = (int16_t*)ps_malloc(bytes);
  else _echoBuffer = (int16_t*)malloc(bytes);
  if (!_echoBuffer) {
    _echoCapacityFrames = 0;
    return false;
  }
  _echoCapacityFrames = frames;
  memset(_echoBuffer, 0, bytes);
  _echoWritePos = 0;
  return true;
}

// v1.1.0 FINAL: compact integer stereo Schroeder/Moorer reverb.
// O3 + fast-math are intentionally enabled for this translation unit.
// Four damped feedback combs feed decorrelated stereo allpasses. No pow/sin/sqrt/tanh
// is executed in the render path. The complete delay memory is only 6930 int16 samples
// = 13860 bytes (~13.5 KiB), so DEV3a deliberately keeps it in internal 8-bit RAM to
// remove PSRAM/cache latency from the hottest Reverb delay-line accesses. A fallback
// preserves function if internal allocation should ever fail.
bool PhoenixAudioManager::allocateReverbBuffers() {
  if (_reverbMem) return true;
  static const uint32_t total = 1117U + 1277U + 1423U + 1559U + 337U + 421U + 353U + 443U;
  const size_t bytes = (size_t)total * sizeof(int16_t);

  const uint32_t caps = MALLOC_CAP_INTERNAL | MALLOC_CAP_8BIT;
  const size_t internalBefore = heap_caps_get_free_size(caps);
  _reverbMem = (int16_t*)heap_caps_malloc(bytes, caps);
  if (_reverbMem) {
    const size_t internalAfter = heap_caps_get_free_size(caps);
    PHX_INFO_PRINTF("PHX MEM reverb=%u bytes INTERNAL free_before=%u free_after=%u\n",
                    (unsigned)bytes, (unsigned)internalBefore, (unsigned)internalAfter);
  } else {
    _reverbMem = psramFound() ? (int16_t*)ps_malloc(bytes) : (int16_t*)malloc(bytes);
    PHX_INFO_PRINTF("PHX MEM reverb INTERNAL alloc failed; fallback=%s bytes=%u\n",
                    psramFound() ? "PSRAM" : "HEAP", (unsigned)bytes);
  }
  if (!_reverbMem) return false;
  memset(_reverbMem, 0, bytes);
  memset(_reverbCombPos, 0, sizeof(_reverbCombPos));
  memset(_reverbCombLp, 0, sizeof(_reverbCombLp));
  memset(_reverbApPosL, 0, sizeof(_reverbApPosL));
  memset(_reverbApPosR, 0, sizeof(_reverbApPosR));
  _reverbCacheReady = false;
  return true;
}

void PhoenixAudioManager::clearReverbBuffers() {
  if (!_reverbMem) return;
  static const uint32_t total = 1117U + 1277U + 1423U + 1559U + 337U + 421U + 353U + 443U;
  memset(_reverbMem, 0, (size_t)total * sizeof(int16_t));
  memset(_reverbCombPos, 0, sizeof(_reverbCombPos));
  memset(_reverbCombLp, 0, sizeof(_reverbCombLp));
  memset(_reverbApPosL, 0, sizeof(_reverbApPosL));
  memset(_reverbApPosR, 0, sizeof(_reverbApPosR));
}

void PhoenixAudioManager::refreshReverbCache() {
  if (!_reverbMem) { _reverbCacheReady = false; return; }

  // Snapshot volatile UI/control targets once per audio block. The resulting
  // cache is owned by AudioTask/Core1 and therefore cannot tear mid-sample.
  const uint8_t size = _reverbSize;
  const uint8_t decay = _reverbDecay;
  const uint8_t damp = _reverbDamp;
  if (_reverbCacheReady && size == _reverbCachedSize &&
      decay == _reverbCachedDecay && damp == _reverbCachedDamp) return;

  static const uint16_t combMax[4] = {1117,1277,1423,1559};
  static const uint16_t apMaxL[2] = {337,421};
  static const uint16_t apMaxR[2] = {353,443};

  uint32_t off = 0;
  for (uint8_t k=0; k<4; ++k) { _reverbCombMem[k] = _reverbMem + off; off += combMax[k]; }
  for (uint8_t k=0; k<2; ++k) { _reverbApMemL[k] = _reverbMem + off; off += apMaxL[k]; }
  for (uint8_t k=0; k<2; ++k) { _reverbApMemR[k] = _reverbMem + off; off += apMaxR[k]; }

  // Exact DEV2g integer formulas, moved out of the per-sample render path.
  const uint32_t sizePct = 55U + ((uint32_t)size * 45U) / 100U;
  for (uint8_t k=0; k<4; ++k) {
    uint32_t len = ((uint32_t)combMax[k] * sizePct) / 100U;
    if (len < 64U) len = 64U;
    _reverbCombLen[k] = len;
  }
  for (uint8_t k=0; k<2; ++k) {
    uint32_t lenL = ((uint32_t)apMaxL[k] * sizePct) / 100U;
    uint32_t lenR = ((uint32_t)apMaxR[k] * sizePct) / 100U;
    if (lenL < 32U) lenL = 32U;
    if (lenR < 32U) lenR = 32U;
    _reverbApLenL[k] = lenL;
    _reverbApLenR[k] = lenR;
  }

  int32_t fbQ15 = 18022 + ((int32_t)decay * 134);
  if (fbQ15 > 31457) fbQ15 = 31457;
  _reverbCachedFbQ15 = fbQ15;
  _reverbCachedLpShift = (uint8_t)(2U + ((uint32_t)damp * 4U / 101U));
  _reverbCachedSize = size;
  _reverbCachedDecay = decay;
  _reverbCachedDamp = damp;
  _reverbCacheReady = true;
}

void PhoenixAudioManager::processReverb(int16_t send, int16_t &wetL, int16_t &wetR) {
  wetL = wetR = 0;
  if (_reverbMix == 0 || !_reverbMem || !_reverbCacheReady) return;

  int32_t sum=0;
  const int32_t fbQ15 = _reverbCachedFbQ15;
  const uint8_t lpShift = _reverbCachedLpShift;
  for(uint8_t k=0;k<4;k++){
    const uint32_t len = _reverbCombLen[k];
    uint32_t pos=_reverbCombPos[k]; if(pos>=len)pos=0;
    int32_t y=_reverbCombMem[k][pos];
    _reverbCombLp[k] += (y - _reverbCombLp[k]) >> lpShift;
    const int32_t w=(int32_t)send + ((_reverbCombLp[k]*fbQ15)>>15);
    _reverbCombMem[k][pos]=phxClamp16(w); if(++pos>=len)pos=0; _reverbCombPos[k]=pos; sum+=y;
  }
  int32_t l=sum>>2, r=sum>>2;
  const int32_t g=16384; // 0.5 allpass coefficient
  for(uint8_t k=0;k<2;k++){
    const uint32_t lenL = _reverbApLenL[k];
    uint32_t p=_reverbApPosL[k]; if(p>=lenL)p=0; int32_t b=_reverbApMemL[k][p]; int32_t y=b-((l*g)>>15);
    _reverbApMemL[k][p]=phxClamp16(l+((y*g)>>15)); if(++p>=lenL)p=0; _reverbApPosL[k]=p; l=y;
    const uint32_t lenR = _reverbApLenR[k];
    p=_reverbApPosR[k]; if(p>=lenR)p=0; b=_reverbApMemR[k][p]; y=b-((r*g)>>15);
    _reverbApMemR[k][p]=phxClamp16(r+((y*g)>>15)); if(++p>=lenR)p=0; _reverbApPosR[k]=p; r=y;
  }
  wetL=phxClamp16((l*(int32_t)_reverbMix)/100);
  wetR=phxClamp16((r*(int32_t)_reverbMix)/100);
}

void PhoenixAudioManager::clearEchoBuffer() {
  if (_echoBuffer && _echoCapacityFrames > 0) {
    memset(_echoBuffer, 0, (size_t)_echoCapacityFrames * sizeof(int16_t));
  }
  _echoWritePos = 0;
  _echoDelayFramesXfadeTo = _echoDelayFramesCurrent;
  _echoDelayXfadePos = 0;
  _echoDelayXfadeActive = false;
  _echoTailActive = false;
  _echoTailQuietFrames = 0;
}

void PhoenixAudioManager::startEchoTail() {
  // v1.1.0 DEV2c: this flag now represents the shared Echo/Reverb FX tail.
  // The old code only kept processing while Echo was active, which cut a
  // reverb-only tail immediately and could stop a long echo before its first
  // repeat arrived.
  const bool echoPossible = (_echoBuffer && _echoCapacityFrames > 1 && _echoMix > 0);
  const bool reverbPossible = (_reverbMem && _reverbMix > 0);
  _echoTailActive = echoPossible || reverbPossible;
  _echoTailQuietFrames = 0;
}

void PhoenixAudioManager::stopEchoTail() {
  _echoTailActive = false;
  _echoTailQuietFrames = 0;
}

void PhoenixAudioManager::setEchoParams(uint16_t delayMs, uint8_t feedback, uint8_t mix) {
  if (delayMs < 50) delayMs = 50;
  if (delayMs > 2000) delayMs = 2000;
  if (feedback > 90) feedback = 90;
  if (mix > 100) mix = 100;
  _echoDelayMs = delayMs;
  _echoFeedback = feedback;
  _echoMix = mix;
}

void PhoenixAudioManager::setEchoSend(uint8_t slot, uint8_t send) {
  _slotEchoSend[safeSlot(slot)] = (send > 100) ? 100 : send;
}

void PhoenixAudioManager::setReverbParams(uint8_t size, uint8_t decay, uint8_t damp, uint8_t mix) {
  _reverbSize = (uint8_t)constrain((int)size,0,100);
  _reverbDecay = (uint8_t)constrain((int)decay,0,100);
  _reverbDamp = (uint8_t)constrain((int)damp,0,100);
  _reverbMix = (uint8_t)constrain((int)mix,0,100);
}

void PhoenixAudioManager::setReverbSend(uint8_t slot, uint8_t send) {
  _slotReverbSend[safeSlot(slot)] = (uint8_t)constrain((int)send,0,100);
}


void PhoenixAudioManager::setMixerParams(uint8_t slot, uint8_t level, int8_t pan) {
  slot=safeSlot(slot); _slotLevel[slot]=(uint8_t)constrain((int)level,0,100); _slotPan[slot]=(int8_t)constrain((int)pan,-100,100);
  const float pos=((float)_slotPan[slot]+100.0f)*0.005f;
  const float lev=(float)_slotLevel[slot]*0.01f;
  _slotGainLQ15[slot]=(uint16_t)constrain((int)(sqrtf(1.0f-pos)*lev*32767.0f+0.5f),0,32767);
  _slotGainRQ15[slot]=(uint16_t)constrain((int)(sqrtf(pos)*lev*32767.0f+0.5f),0,32767);
}

int16_t PhoenixAudioManager::processEcho(int16_t dry, int16_t send) {
  if (!_echoBuffer || _echoCapacityFrames < 2) return dry;

  // C034a: Control/UI writes only targets. Feedback and mix are slewed as in
  // C034, but DELAY TIME no longer moves one read head through the buffer.
  // A moving read head audibly pitch-shifts/discontinuously jumps through stored
  // audio during fast edits. Instead, keep the old tap fixed, open a second tap
  // at the requested delay and crossfade the two for 256 samples (~8 ms).
  uint32_t targetDelayFrames = ((uint32_t)_echoDelayMs * 32000UL) / 1000UL;
  if (targetDelayFrames < 1U) targetDelayFrames = 1U;
  if (targetDelayFrames >= _echoCapacityFrames) targetDelayFrames = _echoCapacityFrames - 1U;
  if (_echoDelayFramesCurrent < 1U || _echoDelayFramesCurrent >= _echoCapacityFrames) {
    _echoDelayFramesCurrent = targetDelayFrames;
    _echoDelayFramesXfadeTo = targetDelayFrames;
    _echoDelayXfadePos = 0;
    _echoDelayXfadeActive = false;
  }
  if (!_echoDelayXfadeActive && targetDelayFrames != _echoDelayFramesCurrent) {
    _echoDelayFramesXfadeTo = targetDelayFrames;
    _echoDelayXfadePos = 0;
    _echoDelayXfadeActive = true;
  }

  const int32_t targetFeedbackQ8 = (int32_t)_echoFeedback * 256;
  const int32_t targetMixQ8 = (int32_t)_echoMix * 256;
  const int32_t slewQ8 = 8; // full-scale transition is ~100 ms at 32 kHz
  if (_echoFeedbackQ8Current < targetFeedbackQ8) { _echoFeedbackQ8Current += min(slewQ8, targetFeedbackQ8 - _echoFeedbackQ8Current); ++_echoParamSlewCount; }
  else if (_echoFeedbackQ8Current > targetFeedbackQ8) { _echoFeedbackQ8Current -= min(slewQ8, _echoFeedbackQ8Current - targetFeedbackQ8); ++_echoParamSlewCount; }
  if (_echoMixQ8Current < targetMixQ8) { _echoMixQ8Current += min(slewQ8, targetMixQ8 - _echoMixQ8Current); ++_echoParamSlewCount; }
  else if (_echoMixQ8Current > targetMixQ8) { _echoMixQ8Current -= min(slewQ8, _echoMixQ8Current - targetMixQ8); ++_echoParamSlewCount; }

  const uint32_t readPosA = (_echoWritePos + _echoCapacityFrames - _echoDelayFramesCurrent) % _echoCapacityFrames;
  const int16_t delayedA = _echoBuffer[readPosA];
  int16_t delayed = delayedA;
  if (_echoDelayXfadeActive) {
    const uint32_t readPosB = (_echoWritePos + _echoCapacityFrames - _echoDelayFramesXfadeTo) % _echoCapacityFrames;
    const int16_t delayedB = _echoBuffer[readPosB];
    const uint16_t x = _echoDelayXfadePos; // 0..255
    delayed = (int16_t)((((int32_t)delayedA * (int32_t)(256U - x)) +
                         ((int32_t)delayedB * (int32_t)x)) >> 8);
    ++_echoParamSlewCount;
    if (++_echoDelayXfadePos >= 256U) {
      _echoDelayFramesCurrent = _echoDelayFramesXfadeTo;
      _echoDelayXfadePos = 0;
      _echoDelayXfadeActive = false;
    }
  }

  // Dry path stays unchanged. Per-slot send feeds the shared echo and MIX is
  // the global return. Q8 smoothing keeps all arithmetic deterministic/integer.
  const int32_t wet = ((int32_t)delayed * _echoMixQ8Current) / (100 * 256);
  const int32_t feedback = ((int32_t)delayed * _echoFeedbackQ8Current) / (100 * 256);
  const int32_t out = (int32_t)dry + wet;
  const int32_t fb = (int32_t)send + feedback;
  if (out > 32767 || out < -32768 || fb > 32767 || fb < -32768) ++_echoLimitCount;
  _echoBuffer[_echoWritePos] = phxSoftLimit16(fb);
  if (++_echoWritePos >= _echoCapacityFrames) _echoWritePos = 0;

  return phxSoftLimit16(out);
}

bool PhoenixAudioManager::beginI2S() {
  i2s_config_t cfg = {};
  cfg.mode = (i2s_mode_t)(I2S_MODE_MASTER | I2S_MODE_RX | I2S_MODE_TX);
  cfg.sample_rate = 32000;
  cfg.bits_per_sample = I2S_BITS_PER_SAMPLE_32BIT;
  cfg.channel_format = I2S_CHANNEL_FMT_RIGHT_LEFT;
  cfg.communication_format = PHX_I2S_COMM_FORMAT;
  cfg.intr_alloc_flags = ESP_INTR_FLAG_LEVEL1;
  cfg.dma_buf_count = 8;
  cfg.dma_buf_len = 128;
  cfg.use_apll = true;
  cfg.tx_desc_auto_clear = true;
  cfg.fixed_mclk = 0;

  esp_err_t err = i2s_driver_install(I2S_NUM_0, &cfg, 0, nullptr);
  if (err != ESP_OK) return false;

  i2s_pin_config_t pins = {};
  pins.bck_io_num = _bclkPin;
  pins.ws_io_num = _lrckPin;
  pins.data_out_num = _doutPin;
  pins.data_in_num = _dinPin;

  err = i2s_set_pin(I2S_NUM_0, &pins);
  if (err != ESP_OK) return false;

  i2s_zero_dma_buffer(I2S_NUM_0);
  return true;
}

void PhoenixAudioManager::updatePlaybackIncrement(uint8_t slot) {
  slot = safeSlot(slot);
  const int cents = (int)_slotCoarse[slot] * 100 + (int)_slotFine[slot];
  float ratio = powf(2.0f, (float)cents / 1200.0f);
  if (ratio < 0.25f) ratio = 0.25f;
  if (ratio > 4.0f) ratio = 4.0f;
  _playIncQ16 = (uint32_t)(ratio * 65536.0f + 0.5f);
  if (_playIncQ16 == 0) _playIncQ16 = 1;
  _pitchSemitone = _slotCoarse[slot];
}

void PhoenixAudioManager::setInstrumentParams(uint8_t slot, int8_t semitone, int16_t fineCent, uint8_t rootNote) {
  slot = safeSlot(slot);
  if (semitone < -24) semitone = -24;
  if (semitone > 24) semitone = 24;
  if (fineCent < -100) fineCent = -100;
  if (fineCent > 100) fineCent = 100;
  if (rootNote > 127) rootNote = 127;

  _slotCoarse[slot] = semitone;
  _slotFine[slot] = fineCent;
  _slotRoot[slot] = rootNote;
  if (slot == _playSlot || slot == _selectedSlot) updatePlaybackIncrement(slot);
}



void PhoenixAudioManager::setKeyboardParams(uint8_t slot, int8_t octaveOffset, bool pitchTracking) {
  slot = safeSlot(slot);
  if (octaveOffset < -2) octaveOffset = -2;
  if (octaveOffset > 2) octaveOffset = 2;
  _slotOctave[slot] = octaveOffset;
  _slotPitchTrack[slot] = pitchTracking;
}


void PhoenixAudioManager::setFilterParams(uint8_t slot, uint8_t cutoff, uint8_t resonance, int8_t envAmount, uint8_t velocityAmount, uint8_t keytrack) {
  slot=safeSlot(slot);
  _slotFilterCutoff[slot]=(uint8_t)constrain((int)cutoff,0,100);
  _slotFilterResonance[slot]=(uint8_t)constrain((int)resonance,0,100);
  _slotFilterEnvAmount[slot]=(int8_t)constrain((int)envAmount,-100,100);
  _slotFilterVelocityAmount[slot]=(uint8_t)constrain((int)velocityAmount,0,100);
  _slotFilterKeytrack[slot]=(uint8_t)constrain((int)keytrack,0,100);
}

void PhoenixAudioManager::setFilterEnvelopeParams(uint8_t slot, uint16_t attackMs, uint16_t decayMs, uint8_t sustainPct, uint16_t releaseMs) {
  slot=safeSlot(slot);
  _slotFilterAttackMs[slot]=(uint16_t)constrain((int)attackMs,0,2000);
  _slotFilterDecayMs[slot]=(uint16_t)constrain((int)decayMs,0,5000);
  _slotFilterSustainPct[slot]=(uint8_t)constrain((int)sustainPct,0,100);
  _slotFilterReleaseMs[slot]=(uint16_t)constrain((int)releaseMs,0,5000);
}

int16_t PhoenixAudioManager::processVoiceFilter(InstrumentVoice &v, int16_t input) {
  const uint8_t slot=safeSlot(v.slot);
  if (_slotFilterCutoff[slot]>=100 && _slotFilterResonance[slot]==0 && _slotFilterEnvAmount[slot]==0 && _slotFilterVelocityAmount[slot]==0 && _slotFilterKeytrack[slot]==0 && v.velocityFilterAmount==0) return input;
  if (v.releasing) v.filterEnvStage=3;
  if (v.filterEnvStage==0) { uint32_t e=(uint32_t)v.filterEnvQ15+v.filterAttackStepQ15; if(e>=32767UL){v.filterEnvQ15=32767;v.filterEnvStage=1;}else v.filterEnvQ15=(uint16_t)e; }
  else if(v.filterEnvStage==1){ if(v.filterEnvQ15<=v.filterEnvSustainQ15 || v.filterDecayStepQ15>=v.filterEnvQ15-v.filterEnvSustainQ15){v.filterEnvQ15=v.filterEnvSustainQ15;v.filterEnvStage=2;}else v.filterEnvQ15-=v.filterDecayStepQ15; }
  else if(v.filterEnvStage==2) v.filterEnvQ15=v.filterEnvSustainQ15;
  else { if(v.filterEnvQ15<=v.filterReleaseStepQ15)v.filterEnvQ15=0; else v.filterEnvQ15-=v.filterReleaseStepQ15; }
  int32_t c=(int32_t)_slotFilterCutoff[slot]*327;
  c += ((int32_t)_slotFilterEnvAmount[slot]*(int32_t)v.filterEnvQ15*120)/10000;
  c += ((int32_t)_slotFilterVelocityAmount[slot]*(int32_t)v.velocity*80)/100;
  c += ((int32_t)v.velocityFilterAmount*(int32_t)v.velocity*80)/100;
  c += ((int32_t)_slotFilterKeytrack[slot]*((int32_t)v.note-(int32_t)_slotRoot[slot])*70)/100;
  c=constrain(c,250,15500);
  const int32_t damp=30000-((int32_t)_slotFilterResonance[slot]*220);
  // C034: the previous 32-bit products could overflow at high resonance /
  // strong modulation because c*high can exceed INT32 even though the final
  // shifted result is perfectly valid. Keep the filter topology and sound, but
  // perform the two state updates in 64 bit and guard the bounded state.
  int32_t high=(int32_t)input-v.filterLow-(int32_t)(((int64_t)v.filterBand*(int64_t)damp)>>15);
  int64_t nextBand=(int64_t)v.filterBand+(((int64_t)c*(int64_t)high)>>15);
  if (nextBand < -131072LL || nextBand > 131071LL) ++_filterGuardCount;
  if (nextBand < -131072LL) nextBand = -131072LL;
  else if (nextBand > 131071LL) nextBand = 131071LL;
  v.filterBand=(int32_t)nextBand;
  int64_t nextLow=(int64_t)v.filterLow+(((int64_t)c*(int64_t)v.filterBand)>>15);
  if (nextLow < -131072LL || nextLow > 131071LL) ++_filterGuardCount;
  if (nextLow < -131072LL) nextLow = -131072LL;
  else if (nextLow > 131071LL) nextLow = 131071LL;
  v.filterLow=(int32_t)nextLow;
  return phxClamp16(v.filterLow);
}
void PhoenixAudioManager::setVoiceConfig(uint8_t slot, uint8_t mode, uint8_t limit, uint8_t priority, uint16_t glideMs) {
  slot = safeSlot(slot);
  _slotVoiceMode[slot] = (mode > 2) ? 2 : mode;
  _slotVoiceLimit[slot] = (uint8_t)constrain((int)limit, 1, (int)VOICE_COUNT);
  _slotNotePriority[slot] = (priority > 2) ? 2 : priority;
  _slotGlideMs[slot] = (uint16_t)constrain((int)glideMs, 0, 2000);
  if (_slotVoiceMode[slot] != 0) _slotVoiceLimit[slot] = 1;
}

int PhoenixAudioManager::findActiveVoiceForSlot(uint8_t slot) const {
  for (uint8_t i=0;i<VOICE_COUNT;++i) if (_voices[i].active && _voices[i].slot==slot) return i;
  return -1;
}

int PhoenixAudioManager::selectHeldNote(uint8_t slot) const {
  slot = safeSlot(slot); int best=-1;
  if (_slotNotePriority[slot] == 1) { for (int n=0;n<128;++n) if (_heldNotes[slot][n]) return n; }
  else if (_slotNotePriority[slot] == 2) { for (int n=127;n>=0;--n) if (_heldNotes[slot][n]) return n; }
  else { uint32_t age=0; for (int n=0;n<128;++n) if (_heldNotes[slot][n] && _heldAge[slot][n]>=age) { age=_heldAge[slot][n]; best=n; } }
  return best;
}

int PhoenixAudioManager::allocateVoiceForSlot(uint8_t slot) {
  slot = safeSlot(slot);
  uint8_t count=0; int oldest=-1; uint32_t age=0xFFFFFFFFUL;
  for (uint8_t i=0;i<VOICE_COUNT;++i) {
    if (_voices[i].active && _voices[i].slot==slot) {
      ++count;
      if (_voices[i].age<age) {age=_voices[i].age; oldest=i;}
    }
  }
  if (count >= _slotVoiceLimit[slot] && oldest >= 0) {
    _lastAllocatorScanMax = VOICE_COUNT-1;
    if (_lastAllocatorScanMax > _highestAllocatorScanMax) _highestAllocatorScanMax = _lastAllocatorScanMax;
    _lastAllocatedVoice = (uint8_t)oldest;
    _lastAllocationReason = 3;
    ++_voiceStealCount;
    ++_voiceAllocCount[(uint8_t)oldest];
    return oldest;
  }
  return allocateVoice();
}

bool PhoenixAudioManager::enqueueMidiCommand(const MidiAudioCommand &cmd) {
  const uint8_t write = __atomic_load_n(&_midiCmdWrite, __ATOMIC_RELAXED);
  const uint8_t next = (uint8_t)((write + 1U) % MIDI_CMD_CAPACITY);
  const uint8_t read = __atomic_load_n(&_midiCmdRead, __ATOMIC_ACQUIRE);
  if (next == read) {
    __atomic_add_fetch(&_midiCmdDrops, 1U, __ATOMIC_RELAXED);
    return false;
  }
  _midiCmdRing[write] = cmd;
  __atomic_store_n(&_midiCmdWrite, next, __ATOMIC_RELEASE);
  return true;
}

bool PhoenixAudioManager::queueMidiNoteOn(uint8_t slot, uint8_t midiNote, uint8_t velocity, bool reverse) {
  MidiAudioCommand c = { MIDI_CMD_NOTE_ON, safeSlot(slot), midiNote, velocity, 0, (uint8_t)(reverse ? 1U : 0U) };
  return enqueueMidiCommand(c);
}

bool PhoenixAudioManager::queueMidiNoteOff(uint8_t slot, uint8_t midiNote) {
  MidiAudioCommand c = { MIDI_CMD_NOTE_OFF, safeSlot(slot), midiNote, 0, 0, 0 };
  return enqueueMidiCommand(c);
}

bool PhoenixAudioManager::queueMidiPitchBend(uint8_t slot, int16_t bend14) {
  MidiAudioCommand c = { MIDI_CMD_PITCH_BEND, safeSlot(slot), 0, 0, bend14, 0 };
  return enqueueMidiCommand(c);
}

bool PhoenixAudioManager::queueMidiSustain(uint8_t slot, bool down) {
  MidiAudioCommand c = { MIDI_CMD_SUSTAIN, safeSlot(slot), 0, 0, 0, (uint8_t)(down ? 1U : 0U) };
  return enqueueMidiCommand(c);
}

bool PhoenixAudioManager::queueMidiAllNotesOff(uint8_t slot, bool immediate) {
  MidiAudioCommand c = { MIDI_CMD_ALL_NOTES_OFF, safeSlot(slot), 0, 0, 0, (uint8_t)(immediate ? 1U : 0U) };
  return enqueueMidiCommand(c);
}

bool PhoenixAudioManager::enqueueSequencerCommand(const SequencerAudioCommand &cmd) {
  const uint8_t write = __atomic_load_n(&_seqCmdWrite, __ATOMIC_RELAXED);
  const uint8_t next = (uint8_t)((write + 1U) % SEQ_CMD_CAPACITY);
  const uint8_t read = __atomic_load_n(&_seqCmdRead, __ATOMIC_ACQUIRE);
  if (next == read) { __atomic_add_fetch(&_seqCmdDrops, 1U, __ATOMIC_RELAXED); return false; }
  _seqCmdRing[write] = cmd; __atomic_store_n(&_seqCmdWrite, next, __ATOMIC_RELEASE); return true;
}

bool PhoenixAudioManager::queueSequencerNote(uint8_t track, uint8_t note, uint8_t velocity, uint32_t gateFrames) {
  static volatile uint32_t fallbackEventId = 1;
  const uint32_t id = __atomic_add_fetch(&fallbackEventId, 1U, __ATOMIC_RELAXED);
  return queueSequencerNoteScheduled(track,note,velocity,gateFrames,micros(),id);
}

bool PhoenixAudioManager::queueSequencerNoteScheduled(uint8_t track, uint8_t note, uint8_t velocity, uint32_t gateFrames, uint32_t targetUs, uint32_t eventId) {
  SequencerAudioCommand c = { SEQ_CMD_NOTE, (uint8_t)(track & 3U), (uint8_t)(note & 127U),
                              (uint8_t)constrain((int)velocity,1,127), gateFrames < 32U ? 32U : gateFrames,
                              targetUs, eventId };
  return enqueueSequencerCommand(c);
}

bool PhoenixAudioManager::queueSequencerStop() {
  SequencerAudioCommand c = { SEQ_CMD_STOP,0,0,0,0,0,0 };
  return enqueueSequencerCommand(c);
}

void PhoenixAudioManager::releaseAllSequencerGates() {
  for (uint8_t t=0;t<4;++t) for(uint8_t g=0;g<SEQ_GATES_PER_TRACK;++g){
    auto &ev=_seqAudioGate[t][g];
    if(ev.active){
      const uint32_t current = (ev.voiceId>=0) ? voiceOwnershipToken(ev.voiceId) : 0U;
      if(current == ev.ownershipToken && current != 0U) {
        if(!releaseOwnedVoice(ev.voiceId,ev.ownershipToken)) ++_seqOwnerFailCount;
      } else {
        ++_seqOwnerStaleCount; // sample ended/stolen/reassigned: benign stale gate
      }
    }
    ev.active=false; ev.voiceId=-1; ev.ownershipToken=0; ev.framesLeft=0; ev.eventId=0;
  }
}

void PhoenixAudioManager::processSequencerCommandQueue(uint32_t blockStartUs, uint32_t blockFrames) {
  const uint32_t blockUs = (uint32_t)(((uint64_t)blockFrames * 1000000ULL) / 32000ULL);
  const uint32_t blockEndUs = blockStartUs + blockUs;
  // C036d: STOP must cancel already pre-scheduled future notes immediately.
  {
    const uint8_t read=__atomic_load_n(&_seqCmdRead,__ATOMIC_RELAXED), write=__atomic_load_n(&_seqCmdWrite,__ATOMIC_ACQUIRE);
    uint8_t scan=read; bool foundStop=false; uint8_t afterStop=read;
    while(scan!=write){ if(_seqCmdRing[scan].type==SEQ_CMD_STOP){ foundStop=true; afterStop=(uint8_t)((scan+1U)%SEQ_CMD_CAPACITY); } scan=(uint8_t)((scan+1U)%SEQ_CMD_CAPACITY); }
    if(foundStop){ releaseAllSequencerGates(); __atomic_store_n(&_seqCmdRead,afterStop,__ATOMIC_RELEASE); }
  }
  for(;;){
    const uint8_t read=__atomic_load_n(&_seqCmdRead,__ATOMIC_RELAXED);
    const uint8_t write=__atomic_load_n(&_seqCmdWrite,__ATOMIC_ACQUIRE);
    if(read==write) break;
    const SequencerAudioCommand c=_seqCmdRing[read];
    if(c.type==SEQ_CMD_NOTE && (int32_t)(c.targetUs-blockEndUs) > 0) break; // future block: keep queued
    __atomic_store_n(&_seqCmdRead,(uint8_t)((read+1U)%SEQ_CMD_CAPACITY),__ATOMIC_RELEASE);
    if(c.type==SEQ_CMD_STOP){ releaseAllSequencerGates(); continue; }
    if(c.type!=SEQ_CMD_NOTE) continue;

    uint32_t frameOffset=0;
    const int32_t until=(int32_t)(c.targetUs-blockStartUs);
    if(until>0){
      frameOffset=(uint32_t)(((uint64_t)(uint32_t)until*32000ULL)/1000000ULL);
      if(frameOffset>=blockFrames) frameOffset=blockFrames-1U;
    } else {
      const uint32_t late=(uint32_t)(-until);
      if(late>blockUs) ++_seqScheduleMissCount;
    }
    if(frameOffset>_seqFrameOffsetMax) _seqFrameOffsetMax=frameOffset;

    const uint8_t track=c.track&3U;
    const int8_t voiceId=startPlaybackMidiOwned(track,c.note,c.velocity);
    if(voiceId<0){++_seqNoteOnFailCount;continue;}
    const uint32_t token=voiceOwnershipToken(voiceId);
    if(!token){++_seqOwnerFailCount;continue;}
    _voices[(uint8_t)voiceId].seqStartDelayFrames=(uint16_t)frameOffset;

    int8_t freeGate=-1; uint8_t oldest=0; uint32_t least=0xFFFFFFFFUL;
    for(uint8_t g=0;g<SEQ_GATES_PER_TRACK;++g){
      if(!_seqAudioGate[track][g].active){freeGate=(int8_t)g;break;}
      if(_seqAudioGate[track][g].framesLeft<least){least=_seqAudioGate[track][g].framesLeft;oldest=g;}
    }
    const uint8_t gi=freeGate>=0?(uint8_t)freeGate:oldest;
    auto &ev=_seqAudioGate[track][gi];
    if(ev.active){
      const uint32_t current=(ev.voiceId>=0)?voiceOwnershipToken(ev.voiceId):0U;
      if(current==ev.ownershipToken && current!=0U){
        if(!releaseOwnedVoice(ev.voiceId,ev.ownershipToken)) ++_seqOwnerFailCount;
      } else ++_seqOwnerStaleCount;
    }
    ev.active=true; ev.voiceId=voiceId; ev.ownershipToken=token;
    // Gate countdown is sample-accurate and starts at the scheduled onset frame.
    ev.framesLeft=c.gateFrames + frameOffset + 1U; ev.eventId=c.eventId;
  }
}

void PhoenixAudioManager::advanceSequencerGates(uint32_t frames) {
  for(uint8_t t=0;t<4;++t) for(uint8_t g=0;g<SEQ_GATES_PER_TRACK;++g){
    auto &ev=_seqAudioGate[t][g]; if(!ev.active) continue;
    if(ev.framesLeft<=frames){
      const uint32_t current=(ev.voiceId>=0)?voiceOwnershipToken(ev.voiceId):0U;
      if(current==ev.ownershipToken && current!=0U){
        if(!releaseOwnedVoice(ev.voiceId,ev.ownershipToken)) ++_seqOwnerFailCount;
      } else ++_seqOwnerStaleCount;
      ev.active=false;ev.voiceId=-1;ev.ownershipToken=0;ev.framesLeft=0;ev.eventId=0;
    } else ev.framesLeft-=frames;
  }
}

void PhoenixAudioManager::processMidiCommandQueue() {
  for (;;) {
    const uint8_t read = __atomic_load_n(&_midiCmdRead, __ATOMIC_RELAXED);
    const uint8_t write = __atomic_load_n(&_midiCmdWrite, __ATOMIC_ACQUIRE);
    if (read == write) break;
    const MidiAudioCommand c = _midiCmdRing[read];
    __atomic_store_n(&_midiCmdRead, (uint8_t)((read + 1U) % MIDI_CMD_CAPACITY), __ATOMIC_RELEASE);
    switch (c.type) {
      case MIDI_CMD_NOTE_ON: startPlaybackMidi(c.slot, c.note, c.velocity, (c.flags & 1U) != 0U); break;
      case MIDI_CMD_NOTE_OFF: noteOffMidi(c.slot, c.note); break;
      case MIDI_CMD_PITCH_BEND: setPitchBend(c.slot, c.value); break;
      case MIDI_CMD_SUSTAIN: setSustain(c.slot, (c.flags & 1U) != 0U); break;
      case MIDI_CMD_ALL_NOTES_OFF: allNotesOff(c.slot, (c.flags & 1U) != 0U); break;
      default: break;
    }
  }
}

bool PhoenixAudioManager::startPlaybackMidi(uint8_t slot, uint8_t midiNote, uint8_t velocity) {
  return startPlaybackMidiVoice(slot, midiNote, velocity, false, false) >= 0;
}

bool PhoenixAudioManager::startPlaybackMidi(uint8_t slot, uint8_t midiNote, uint8_t velocity, bool reverse) {
  return startPlaybackMidiVoice(slot, midiNote, velocity, reverse, false) >= 0;
}

int8_t PhoenixAudioManager::startPlaybackMidiOwned(uint8_t slot, uint8_t midiNote, uint8_t velocity) {
  return startPlaybackMidiOwned(slot, midiNote, velocity, false);
}

int8_t PhoenixAudioManager::startPlaybackMidiOwned(uint8_t slot, uint8_t midiNote, uint8_t velocity, bool reverse) {
  const int voiceId = startPlaybackMidiVoice(slot, midiNote, velocity, reverse, true);
  return (voiceId >= 0 && voiceId < 128) ? (int8_t)voiceId : (int8_t)-1;
}

uint32_t PhoenixAudioManager::voiceOwnershipToken(int8_t voiceId) const {
  if (voiceId < 0 || voiceId >= (int8_t)VOICE_COUNT) return 0;
  const InstrumentVoice &v = _voices[(uint8_t)voiceId];
  return v.active ? v.age : 0;
}

void PhoenixAudioManager::beginVoiceRelease(InstrumentVoice &v) {
  v.sustained = false;
  v.releasing = true;
  v.envStage = 3;

  // A sustain loop is left immediately on Note Off. For an alternate loop,
  // continue from the current sample position in the forward direction so the
  // release tail always reaches the user-defined Sample End marker.
  if (!v.reverse && v.loopMode == LOOP_ALTERNATE) v.loopForward = true;
}

bool PhoenixAudioManager::releaseOwnedVoice(int8_t voiceId, uint32_t ownershipToken) {
  if (voiceId < 0 || voiceId >= (int8_t)VOICE_COUNT || ownershipToken == 0) return false;
  InstrumentVoice &v = _voices[(uint8_t)voiceId];

  // A stolen/reused voice has a different age token. Never release the new owner.
  if (!v.active || v.age != ownershipToken) return false;

  const uint8_t slot = safeSlot(v.slot);
  const uint8_t note = v.note & 127U;
  if (_noteHoldCount[slot][note] > 0U) --_noteHoldCount[slot][note];
  v.keyHeld = false;

  // One-shot keygroups deliberately ignore gate/note-off and run to sample end,
  // unless transport STOP, choke, exclusive play or panic terminates them.
  if (!(v.keygroup < MAX_KEYGROUPS && _keygroups[slot][v.keygroup].oneShot)) {
    if (_slotSustainDown[slot]) {
      v.sustained = true;
    } else {
      beginVoiceRelease(v);
    }
  }

  // Keep the held-note table true while another independently owned voice of
  // the same slot/note is still held. This preserves overlapping equal notes.
  bool anotherHeld = false;
  for (uint8_t i = 0; i < VOICE_COUNT; ++i) {
    if (i == (uint8_t)voiceId) continue;
    const InstrumentVoice &other = _voices[i];
    if (other.active && other.slot == slot && other.note == note && other.keyHeld) {
      anotherHeld = true;
      break;
    }
  }
  _heldNotes[slot][note] = anotherHeld || (_noteHoldCount[slot][note] != 0U);
  return true;
}

int PhoenixAudioManager::findOldestHeldVoiceForNote(uint8_t slot, uint8_t midiNote) const {
  slot = safeSlot(slot);
  int best = -1;
  uint32_t bestAge = 0xFFFFFFFFUL;
  for (uint8_t i = 0; i < VOICE_COUNT; ++i) {
    const InstrumentVoice &v = _voices[i];
    if (!v.active || v.slot != slot || v.note != midiNote || !v.keyHeld) continue;
    if (v.age < bestAge) { bestAge = v.age; best = (int)i; }
  }
  return best;
}

int PhoenixAudioManager::findVoiceForNote(uint8_t slot, uint8_t midiNote) const {
  slot = safeSlot(slot);
  for (uint8_t i = 0; i < VOICE_COUNT; ++i) {
    if (_voices[i].active && _voices[i].slot == slot && _voices[i].note == midiNote) return (int)i;
  }
  return -1;
}

int PhoenixAudioManager::allocateVoice() {
  _lastAllocatorScanMax = 0;
  _lastAllocationReason = 0;

  // 1. Always use a genuinely free voice first.
  for (uint8_t i = 0; i < VOICE_COUNT; ++i) {
    _lastAllocatorScanMax = i;
    if (!_voices[i].active) {
      _lastAllocatedVoice = i;
      ++_voiceAllocCount[i];
      if (_lastAllocatorScanMax > _highestAllocatorScanMax) _highestAllocatorScanMax = _lastAllocatorScanMax;
      return (int)i;
    }
  }

  // 2. Prefer stealing the oldest voice that is already in its release phase.
  int oldestRelease = -1;
  uint32_t oldestReleaseAge = 0xFFFFFFFFUL;
  for (uint8_t i = 0; i < VOICE_COUNT; ++i) {
    _lastAllocatorScanMax = i;
    if (_voices[i].releasing && _voices[i].age < oldestReleaseAge) {
      oldestRelease = (int)i;
      oldestReleaseAge = _voices[i].age;
    }
  }
  if (_lastAllocatorScanMax > _highestAllocatorScanMax) _highestAllocatorScanMax = _lastAllocatorScanMax;
  if (oldestRelease >= 0) {
    _lastAllocatedVoice = (uint8_t)oldestRelease;
    _lastAllocationReason = 1;
    ++_voiceStealCount;
    ++_voiceAllocCount[(uint8_t)oldestRelease];
    return oldestRelease;
  }

  // 3. All voices are held: replace the globally oldest voice.
  uint8_t oldest = 0;
  uint32_t oldestAge = _voices[0].age;
  for (uint8_t i = 1; i < VOICE_COUNT; ++i) {
    _lastAllocatorScanMax = i;
    if (_voices[i].age < oldestAge) { oldest = i; oldestAge = _voices[i].age; }
  }
  if (_lastAllocatorScanMax > _highestAllocatorScanMax) _highestAllocatorScanMax = _lastAllocatorScanMax;
  _lastAllocatedVoice = oldest;
  _lastAllocationReason = 2;
  ++_voiceStealCount;
  ++_voiceAllocCount[oldest];
  return (int)oldest;
}

void PhoenixAudioManager::refreshActiveVoiceCount() {
  uint8_t n = 0;
  for (uint8_t i = 0; i < VOICE_COUNT; ++i) if (_voices[i].active) ++n;
  _activeVoiceCount = n;
  if (n > _activeVoicePeak) _activeVoicePeak = n;
}

void PhoenixAudioManager::resetDiagnostics() {
  _audioLoadAvgUs = 0;
  _audioLoadMaxUs = 0;
  _audioLoadLastUs = 0;
  _audioLoadPeakUs = 0;
  _audioRiskCount = 0;
  _audioOverrunCount = 0;
  _underruns = 0;
  _peakTracePeakUs = 0;
  _peakTracePrintedSeq = _peakTraceSeq;
  _voiceStealCount = 0;
  _duplicateNoteOnCount = 0;
  _orphanNoteOffCount = 0;
  _sustainDeferredNoteOffCount = 0;
  _panicKillCount = 0;
  _echoLimitCount = 0;
  _filterGuardCount = 0;
  _echoParamSlewCount = 0;
  _msNoteMissCount = 0; _msVelocityMissCount = 0; _msRrFallbackCount = 0; _msSanitizeCount = 0;
  _seqCmdDrops=0; _seqNoteOnFailCount=0; _seqOwnerFailCount=0; _seqOwnerStaleCount=0; _seqScheduleMissCount=0; _seqFrameOffsetMax=0;
  _activeVoicePeak = _activeVoiceCount;
  // The 64-bit audio-window accumulator belongs to AudioTask/Core 1.
  // Leave it untouched here to avoid a cross-core torn write; the next
  // one-second window naturally publishes a fresh average.
  _audioLoadWindowStartMs = millis();
  for (uint8_t i = 0; i < VOICE_COUNT; ++i) _voiceAllocCount[i] = 0;
  _dspProfileSamples = 0; _dspSetupEnvUs = 0; _dspVintageUs = 0; _dspFilterUs = 0; _dspMixPosUs = 0; _dspEchoOutUs = 0;
  for (uint8_t i = 0; i <= VOICE_COUNT; ++i) { _voiceHistCount[i] = 0; _voiceHistSumUs[i] = 0; _voiceHistMaxUs[i] = 0; }
  Serial.println(F("C034 DIAGNOSTICS RESET"));
}

void PhoenixAudioManager::updateSlotVoicePlayheads() {
  for (uint8_t slot = 0; slot < SLOT_COUNT; ++slot) {
    bool haveVoice = false;
    uint32_t newestAge = 0U;
    uint32_t frame = _slotVoicePlayheadFrame[slot];
    int8_t owner = -1;

    // First try the explicitly tracked owner. This is the normal fast path and
    // avoids losing the GUI playhead because of unrelated source-buffer state.
    const int8_t tracked = _slotVoicePlayheadVoice[slot];
    const uint32_t trackedAge = _slotVoicePlayheadAge[slot];
    if (tracked >= 0 && tracked < (int8_t)VOICE_COUNT) {
      const InstrumentVoice &v = _voices[(uint8_t)tracked];
      if (v.active && safeSlot(v.slot) == slot && v.keygroup == 255U && v.age == trackedAge) {
        haveVoice = true;
        newestAge = v.age;
        owner = tracked;
        frame = (uint32_t)(v.posQ16 >> 16);
      }
    }

    // If the tracked voice ended or was stolen, find the newest remaining
    // normal slot-sample voice. Multisample/keygroup voices deliberately do
    // not drive this waveform because they can use a different source sample.
    if (!haveVoice) {
      for (uint8_t vi = 0; vi < VOICE_COUNT; ++vi) {
        const InstrumentVoice &v = _voices[vi];
        if (!v.active || safeSlot(v.slot) != slot || v.keygroup != 255U) continue;
        if (!haveVoice || v.age >= newestAge) {
          haveVoice = true;
          newestAge = v.age;
          owner = (int8_t)vi;
          frame = (uint32_t)(v.posQ16 >> 16);
        }
      }
    }

    const uint32_t frames = _slots[slot].frames;
    if (frames > 0U && frame >= frames) frame = frames - 1U;

    // Publish payload first and validity last. The GUI core therefore never
    // sees an active flag paired with an older owner/frame snapshot.
    _slotVoicePlayheadFrame[slot] = frame;
    _slotVoicePlayheadVoice[slot] = owner;
    _slotVoicePlayheadAge[slot] = haveVoice ? newestAge : 0U;
    _slotVoicePlayheadActive[slot] = haveVoice;
  }
}

void PhoenixAudioManager::printVoiceAudit() {
  if (!PHX_ENABLE_VOICE_AUDIT) return;
  uint8_t active=0, releasing=0, heldVoices=0, freeVoices=0;
  uint16_t heldKeys=0;
  for (uint8_t slot=0; slot<SLOT_COUNT; ++slot)
    for (uint8_t note=0; note<128; ++note) if (_heldNotes[slot][note]) ++heldKeys;

  char map[VOICE_COUNT+1];
  for (uint8_t i=0; i<VOICE_COUNT; ++i) {
    const InstrumentVoice &v=_voices[i];
    if (!v.active) { ++freeVoices; map[i]='.'; }
    else if (v.releasing) { ++active; ++releasing; map[i]='R'; }
    else if (v.keyHeld) { ++active; ++heldVoices; map[i]='H'; }
    else { ++active; map[i]='A'; }
  }
  map[VOICE_COUNT]=0;

  Serial.printf("VOICE CONFIG configured=%u pool=%u active=%u releasing=%u heldVoices=%u free=%u heldKeys=%u maxScan=%u lastScan=%u lastVoice=%d reason=%u steals=%lu\n",
                (unsigned)VOICE_COUNT, (unsigned)(sizeof(_voices)/sizeof(_voices[0])),
                (unsigned)active, (unsigned)releasing, (unsigned)heldVoices, (unsigned)freeVoices,
                (unsigned)heldKeys, (unsigned)_highestAllocatorScanMax, (unsigned)_lastAllocatorScanMax,
                _lastAllocatedVoice==255?-1:(int)_lastAllocatedVoice, (unsigned)_lastAllocationReason,
                (unsigned long)_voiceStealCount);
  Serial.printf("VOICE MAP %s | SLOT LIMITS S1=%u/%s S2=%u/%s S3=%u/%s S4=%u/%s\n", map,
                (unsigned)_slotVoiceLimit[0], _slotVoiceMode[0]==0?"POLY":(_slotVoiceMode[0]==1?"MONO":"LEG"),
                (unsigned)_slotVoiceLimit[1], _slotVoiceMode[1]==0?"POLY":(_slotVoiceMode[1]==1?"MONO":"LEG"),
                (unsigned)_slotVoiceLimit[2], _slotVoiceMode[2]==0?"POLY":(_slotVoiceMode[2]==1?"MONO":"LEG"),
                (unsigned)_slotVoiceLimit[3], _slotVoiceMode[3]==0?"POLY":(_slotVoiceMode[3]==1?"MONO":"LEG"));
  Serial.print("VOICE USAGE");
  for (uint8_t i=0;i<VOICE_COUNT;++i) Serial.printf(" V%02u=%lu", (unsigned)i, (unsigned long)_voiceAllocCount[i]);
  Serial.println();
}

int PhoenixAudioManager::startPlaybackMidiVoice(uint8_t slot, uint8_t midiNote, uint8_t velocity, bool reverse, bool forceNewVoice) {
  slot = safeSlot(slot);
  midiNote = (uint8_t)constrain((int)midiNote, 0, 127);
  // C031: count overlapping equal Note On events.
  if (_noteHoldCount[slot][midiNote] > 0U) ++_duplicateNoteOnCount;
  if (_noteHoldCount[slot][midiNote] < 255U) ++_noteHoldCount[slot][midiNote];
  _heldNotes[slot][midiNote] = true;
  _heldVelocity[slot][midiNote] = velocity;
  _heldAge[slot][midiNote] = ++_heldAgeCounter;
  if (_slotVoiceMode[slot] != 0) {
    const int chosen = selectHeldNote(slot);
    if (chosen >= 0 && chosen != midiNote) { const int heldVoice=findVoiceForNote(slot,(uint8_t)chosen); return heldVoice>=0?heldVoice:0; } // LOW/HIGH priority keeps the preferred held note
  }
  if (keygroupCount(slot) > 0) return startMultisampleMidiOwned(slot, midiNote, velocity, reverse);
  SampleSlot &s = _slots[slot];
  if (!s.buffer || s.frames == 0 || velocity == 0) return -1;

  uint32_t start = 0U, end = 0U, loopStart = 0U, loopEnd = 0U;
  uint8_t resolvedLoopMode = LOOP_OFF;
  resolveSlotPlaybackMarkers(slot, start, end, loopStart, loopEnd, resolvedLoopMode);

  int cents = (int)_slotCoarse[slot] * 100 + (int)_slotFine[slot];
  if (_slotPitchTrack[slot]) {
    int semis = (int)midiNote - (int)_slotRoot[slot] + ((int)_slotOctave[slot] * 12);
    if (semis < -48) semis = -48;
    if (semis > 48) semis = 48;
    cents += semis * 100;
  }
  float ratio = powf(2.0f, (float)cents / 1200.0f);
  if (ratio < 0.25f) ratio = 0.25f;
  if (ratio > 4.0f) ratio = 4.0f;
  uint32_t inc = (uint32_t)(ratio * 65536.0f + 0.5f);
  if (inc == 0) inc = 1;

  // C031: overlapping equal notes in POLY mode must own independent voices.
  // The first instance may reuse an existing matching voice for legacy behavior;
  // a duplicate key-down always allocates a distinct voice so each Note Off can
  // release exactly one instance.
  const bool duplicatePolyNote = (_slotVoiceMode[slot] == 0 && _noteHoldCount[slot][midiNote] > 1U);
  int vi = forceNewVoice ? allocateVoiceForSlot(slot)
                         : ((_slotVoiceMode[slot] == 0)
                              ? (duplicatePolyNote ? allocateVoiceForSlot(slot) : findVoiceForNote(slot, midiNote))
                              : findActiveVoiceForSlot(slot));
  const bool hadMonoVoice = (!forceNewVoice && vi >= 0 && _slotVoiceMode[slot] != 0);
  if (vi < 0) vi = (_slotVoiceMode[slot] == 0) ? allocateVoiceForSlot(slot) : allocateVoice();
  if (PHX_ENABLE_VOICE_AUDIT) {
    Serial.printf("VOICE ALLOC slot=%u note=%u vel=%u voice=%d limit=%u mode=%u scan=%u reason=%u\n",
                  (unsigned)(slot+1), (unsigned)midiNote, (unsigned)velocity, vi,
                  (unsigned)_slotVoiceLimit[slot], (unsigned)_slotVoiceMode[slot],
                  (unsigned)_lastAllocatorScanMax, (unsigned)_lastAllocationReason);
  }
  InstrumentVoice &v = _voices[vi];
  const uint32_t oldInc = v.incQ16;
  const bool legatoNoRetrigger = hadMonoVoice && _slotVoiceMode[slot] == 2 && v.keyHeld;
  v.active = false; // publish all parameters before activating the voice
  v.releasing = false;
  v.keyHeld = true;
  v.sustained = false;
  if (!legatoNoRetrigger) v.envStage = 0;
  v.slot = slot;
  v.note = midiNote;
  v.velocity = velocity;
  v.velocityLevel = (uint8_t)(127U - (((uint32_t)(127U - velocity) * (uint32_t)_slotVelocityAmount[slot]) / 100U));
  v.velocityFilterAmount = 0;
  v.keygroup = 255;
  v.sourceBuffer = s.buffer;
  v.sourceFrames = s.frames;
  v.sourceGainLQ15 = 32767;
  v.sourceGainRQ15 = 32767;
  v.reverse = reverse;
  v.rangeStart = start;
  v.rangeEnd = end;
  v.loopForward = true;
  v.loopStartFrame = loopStart;
  v.loopEndFrame = loopEnd;
  v.loopMode = reverse ? LOOP_OFF : resolvedLoopMode;
  { uint32_t xf=(uint32_t)s.loopXfadeMs*32U; const uint32_t ll=(v.loopEndFrame>v.loopStartFrame)?(v.loopEndFrame-v.loopStartFrame):0U; if(xf>ll/2U)xf=ll/2U; v.loopXfadeFrames=(uint16_t)min((uint32_t)65535U,xf); }
  v.markerRevision = _slotMarkerRevision[slot];
  if (!legatoNoRetrigger) v.posQ16 = ((uint64_t)(reverse ? (end - 1) : start)) << 16;
  v.baseIncQ16 = inc;
  const float bendSemis = ((float)_slotPitchBend[slot] / 8192.0f) * (float)_slotPitchBendRange[slot];
  float bendRatio = powf(2.0f, bendSemis / 12.0f);
  v.targetIncQ16 = (uint32_t)((float)inc * bendRatio + 0.5f);
  if (v.targetIncQ16 == 0) v.targetIncQ16 = 1;
  const uint32_t glideFrames = (uint32_t)_slotGlideMs[slot] * 32UL;
  if (hadMonoVoice && glideFrames > 0) {
    v.incQ16 = oldInc ? oldInc : v.targetIncQ16;
    v.glideFramesLeft = glideFrames;
    v.glideStepQ16 = ((int32_t)v.targetIncQ16 - (int32_t)v.incQ16) / (int32_t)glideFrames;
    if (v.glideStepQ16 == 0 && v.incQ16 != v.targetIncQ16) v.glideStepQ16 = (v.targetIncQ16 > v.incQ16) ? 1 : -1;
  } else { v.incQ16 = v.targetIncQ16; v.glideFramesLeft = 0; v.glideStepQ16 = 0; }
  if (!legatoNoRetrigger) v.envQ15 = 0;
  v.sustainQ15 = (uint16_t)(((uint32_t)_slotSustainPct[slot] * 32767UL) / 100UL);
  const uint32_t attackFrames = (uint32_t)_slotAttackMs[slot] * 32UL;
  const uint32_t decayFrames = (uint32_t)_slotDecayMs[slot] * 32UL;
  const uint32_t releaseFrames = (uint32_t)_slotReleaseMs[slot] * 32UL;
  uint32_t attackStep = (attackFrames == 0U) ? 32767U : (32767U / attackFrames);
  if (attackStep < 1U) attackStep = 1U;
  if (attackStep > 32767U) attackStep = 32767U;
  v.attackStepQ15 = (uint16_t)attackStep;

  const uint32_t decaySpan = 32767U - (uint32_t)v.sustainQ15;
  uint32_t decayStep = (decayFrames == 0U || decaySpan == 0U)
      ? 32767U
      : (decaySpan / decayFrames);
  if (decayStep < 1U) decayStep = 1U;
  if (decayStep > 32767U) decayStep = 32767U;
  v.decayStepQ15 = (uint16_t)decayStep;

  uint32_t releaseStep = (releaseFrames == 0U) ? 32767U : (32767U / releaseFrames);
  if (releaseStep < 1U) releaseStep = 1U;
  if (releaseStep > 32767U) releaseStep = 32767U;
  v.releaseStepQ15 = (uint16_t)releaseStep;
  v.age = ++_voiceAgeCounter;
  v.vintagePhase = 0; v.vintageHold = 0; v.vintageFilterState = 0; v.vintageNoise = 0xA5A55A5AUL ^ ((uint32_t)midiNote << 16) ^ v.age;
  if (!legatoNoRetrigger) {
    v.filterEnvStage = 0;
    v.filterEnvQ15 = 0;
    v.filterLow = 0;
    v.filterBand = 0;
    v.filterEnvSustainQ15 = (uint16_t)(((uint32_t)_slotFilterSustainPct[slot] * 32767UL) / 100UL);
    const uint32_t faf = (uint32_t)_slotFilterAttackMs[slot] * 32UL;
    const uint32_t fdf = (uint32_t)_slotFilterDecayMs[slot] * 32UL;
    const uint32_t frf = (uint32_t)_slotFilterReleaseMs[slot] * 32UL;
    uint32_t fas = faf ? (32767UL / faf) : 32767UL; if (fas < 1UL) fas = 1UL; if (fas > 32767UL) fas = 32767UL;
    uint32_t fspan = 32767UL - v.filterEnvSustainQ15;
    uint32_t fds = (fdf && fspan) ? (fspan / fdf) : 32767UL; if (fds < 1UL) fds = 1UL; if (fds > 32767UL) fds = 32767UL;
    uint32_t frs = frf ? (32767UL / frf) : 32767UL; if (frs < 1UL) frs = 1UL; if (frs > 32767UL) frs = 32767UL;
    v.filterAttackStepQ15 = (uint16_t)fas;
    v.filterDecayStepQ15 = (uint16_t)fds;
    v.filterReleaseStepQ15 = (uint16_t)frs;
  }
  v.seqStartDelayFrames = 0;
  v.active = true;
  // C010: make the SAMPLE EDITOR playhead visible immediately on Note On;
  // the audio task then refreshes the frame once per rendered block.
  _slotVoicePlayheadFrame[slot] = (uint32_t)(v.posQ16 >> 16);
  _slotVoicePlayheadAge[slot] = v.age;
  _slotVoicePlayheadVoice[slot] = (int8_t)vi;
  _slotVoicePlayheadActive[slot] = true;
  _selectedSlot = slot;
  _playSlot = slot;
  _lastReplayReverse = reverse;
  _testTone = TONE_THRU;
  refreshActiveVoiceCount();
  return vi;
}


void PhoenixAudioManager::updateVelocityLayerPan(VelocityLayer &vl) {
  const float p = ((float)vl.pan + 100.0f) / 200.0f;
  const float level = (float)vl.level / 100.0f;
  vl.gainLQ15 = (uint16_t)constrain((int)(sqrtf(1.0f - p) * level * 32767.0f + 0.5f), 0, 32767);
  vl.gainRQ15 = (uint16_t)constrain((int)(sqrtf(p) * level * 32767.0f + 0.5f), 0, 32767);
}

bool PhoenixAudioManager::keygroupEnabled(uint8_t slot, uint8_t group) const { return _keygroups[safeSlot(slot)][group & 15].enabled; }
uint8_t PhoenixAudioManager::keygroupLow(uint8_t slot, uint8_t group) const { return _keygroups[safeSlot(slot)][group & 15].lowNote; }
uint8_t PhoenixAudioManager::keygroupHigh(uint8_t slot, uint8_t group) const { return _keygroups[safeSlot(slot)][group & 15].highNote; }
uint8_t PhoenixAudioManager::keygroupRoot(uint8_t slot, uint8_t group) const { return _keygroups[safeSlot(slot)][group & 15].rootNote; }
uint8_t PhoenixAudioManager::keygroupChokeGroup(uint8_t slot, uint8_t group) const { return _keygroups[safeSlot(slot)][group & 15].chokeGroup; }
bool PhoenixAudioManager::keygroupOneShot(uint8_t slot, uint8_t group) const { return _keygroups[safeSlot(slot)][group & 15].oneShot; }
uint16_t PhoenixAudioManager::keygroupChokeFadeMs(uint8_t slot, uint8_t group) const { return _keygroups[safeSlot(slot)][group & 15].chokeFadeMs; }
uint8_t PhoenixAudioManager::keygroupPlayMode(uint8_t slot, uint8_t group) const { return _keygroups[safeSlot(slot)][group & 15].playMode; }
uint8_t PhoenixAudioManager::keygroupStartPct(uint8_t slot, uint8_t group) const { return _keygroups[safeSlot(slot)][group & 15].startPct; }
uint8_t PhoenixAudioManager::keygroupEndPct(uint8_t slot, uint8_t group) const { return _keygroups[safeSlot(slot)][group & 15].endPct; }
bool PhoenixAudioManager::keygroupReverse(uint8_t slot, uint8_t group) const { return _keygroups[safeSlot(slot)][group & 15].reversePlayback; }
int8_t PhoenixAudioManager::keygroupTranspose(uint8_t slot, uint8_t group) const { return _keygroups[safeSlot(slot)][group & 15].transposeSemitone; }
int16_t PhoenixAudioManager::keygroupFineCent(uint8_t slot, uint8_t group) const { return _keygroups[safeSlot(slot)][group & 15].fineCent; }
uint8_t PhoenixAudioManager::keygroupKeytrackPct(uint8_t slot, uint8_t group) const { return _keygroups[safeSlot(slot)][group & 15].keytrackPct; }
uint8_t PhoenixAudioManager::keygroupLayerLoopMode(uint8_t slot,uint8_t group,uint8_t layer) const { return _keygroups[safeSlot(slot)][group&15].layer[layer%MAX_VELOCITY_LAYERS].loopMode; }
uint8_t PhoenixAudioManager::keygroupLayerLoopStartPct(uint8_t slot,uint8_t group,uint8_t layer) const { return _keygroups[safeSlot(slot)][group&15].layer[layer%MAX_VELOCITY_LAYERS].loopStartPct; }
uint8_t PhoenixAudioManager::keygroupLayerLoopEndPct(uint8_t slot,uint8_t group,uint8_t layer) const { return _keygroups[safeSlot(slot)][group&15].layer[layer%MAX_VELOCITY_LAYERS].loopEndPct; }
uint8_t PhoenixAudioManager::keygroupLayerLoopXfadeMs(uint8_t slot,uint8_t group,uint8_t layer) const { return _keygroups[safeSlot(slot)][group&15].layer[layer%MAX_VELOCITY_LAYERS].loopXfadeMs; }
uint8_t PhoenixAudioManager::keygroupLayerVelocityToLevelPct(uint8_t slot,uint8_t group,uint8_t layer) const { return _keygroups[safeSlot(slot)][group&15].layer[layer%MAX_VELOCITY_LAYERS].velocityToLevelPct; }
uint8_t PhoenixAudioManager::keygroupLayerVelocityToFilterPct(uint8_t slot,uint8_t group,uint8_t layer) const { return _keygroups[safeSlot(slot)][group&15].layer[layer%MAX_VELOCITY_LAYERS].velocityToFilterPct; }
uint8_t PhoenixAudioManager::keygroupExclusiveGroup(uint8_t slot, uint8_t group) const { return _keygroups[safeSlot(slot)][group & 15].exclusiveGroup; }
bool PhoenixAudioManager::keygroupRetriggerLegato(uint8_t slot, uint8_t group) const { return _keygroups[safeSlot(slot)][group & 15].retriggerLegato; }
uint32_t PhoenixAudioManager::keygroupFrames(uint8_t slot, uint8_t group) const { return keygroupLayerFrames(slot,group,0); }
uint8_t PhoenixAudioManager::keygroupLevel(uint8_t slot,uint8_t group) const{return keygroupLayerLevel(slot,group,0);}
int8_t PhoenixAudioManager::keygroupPan(uint8_t slot,uint8_t group) const{return keygroupLayerPan(slot,group,0);}
const char* PhoenixAudioManager::keygroupPath(uint8_t slot, uint8_t group) const { return keygroupLayerPath(slot,group,0); }
bool PhoenixAudioManager::keygroupLayerEnabled(uint8_t slot,uint8_t group,uint8_t layer) const{return _keygroups[safeSlot(slot)][group&15].layer[layer%MAX_VELOCITY_LAYERS].enabled;}
uint8_t PhoenixAudioManager::keygroupLayerVelocityLow(uint8_t slot,uint8_t group,uint8_t layer) const{return _keygroups[safeSlot(slot)][group&15].layer[layer%MAX_VELOCITY_LAYERS].velocityLow;}
uint8_t PhoenixAudioManager::keygroupLayerVelocityHigh(uint8_t slot,uint8_t group,uint8_t layer) const{return _keygroups[safeSlot(slot)][group&15].layer[layer%MAX_VELOCITY_LAYERS].velocityHigh;}
uint32_t PhoenixAudioManager::keygroupLayerFrames(uint8_t slot,uint8_t group,uint8_t layer) const{return _keygroups[safeSlot(slot)][group&15].layer[layer%MAX_VELOCITY_LAYERS].rr[0].frames;}
uint8_t PhoenixAudioManager::keygroupLayerLevel(uint8_t slot,uint8_t group,uint8_t layer) const{return _keygroups[safeSlot(slot)][group&15].layer[layer%MAX_VELOCITY_LAYERS].level;}
int8_t PhoenixAudioManager::keygroupLayerPan(uint8_t slot,uint8_t group,uint8_t layer) const{return _keygroups[safeSlot(slot)][group&15].layer[layer%MAX_VELOCITY_LAYERS].pan;}
const char* PhoenixAudioManager::keygroupLayerPath(uint8_t slot,uint8_t group,uint8_t layer) const{return _keygroups[safeSlot(slot)][group&15].layer[layer%MAX_VELOCITY_LAYERS].rr[0].path;}
uint8_t PhoenixAudioManager::keygroupLayerRoundRobinMode(uint8_t slot,uint8_t group,uint8_t layer) const{return _keygroups[safeSlot(slot)][group&15].layer[layer%MAX_VELOCITY_LAYERS].rrMode;}
uint8_t PhoenixAudioManager::keygroupLayerRoundRobinCount(uint8_t slot,uint8_t group,uint8_t layer) const{const VelocityLayer &vl=_keygroups[safeSlot(slot)][group&15].layer[layer%MAX_VELOCITY_LAYERS];uint8_t n=0;for(uint8_t i=0;i<MAX_RR_VARIANTS;++i)if(vl.rr[i].buffer&&vl.rr[i].frames)++n;return n;}
const char* PhoenixAudioManager::keygroupLayerVariantPath(uint8_t slot,uint8_t group,uint8_t layer,uint8_t variant) const{return _keygroups[safeSlot(slot)][group&15].layer[layer%MAX_VELOCITY_LAYERS].rr[variant%MAX_RR_VARIANTS].path;}
bool PhoenixAudioManager::setKeygroupLayerRoundRobinMode(uint8_t slot,uint8_t group,uint8_t layer,uint8_t mode){if(mode!=0&&mode!=2&&mode!=3&&mode!=4&&mode!=5)return false;VelocityLayer &vl=_keygroups[safeSlot(slot)][group&15].layer[layer%MAX_VELOCITY_LAYERS];vl.rrMode=mode;vl.rrCounter=0;return true;}
uint8_t PhoenixAudioManager::keygroupCount(uint8_t slot) const {
  uint8_t n=0; slot=safeSlot(slot);
  for(uint8_t g=0;g<MAX_KEYGROUPS;++g){
    const MultisampleKeygroup &kg=_keygroups[slot][g];
    bool loaded=false;
    for(uint8_t l=0;l<MAX_VELOCITY_LAYERS&&!loaded;++l){
      if(!kg.layer[l].enabled) continue;
      for(uint8_t r=0;r<MAX_RR_VARIANTS;++r)
        if(kg.layer[l].rr[r].buffer&&kg.layer[l].rr[r].frames){loaded=true;break;}
    }
    if(kg.enabled&&loaded)++n;
  }
  return n;
}

uint32_t PhoenixAudioManager::sanitizeMultisampleSlot(uint8_t slot){
  slot=safeSlot(slot);
  uint32_t fixes=0;
  for(uint8_t g=0;g<MAX_KEYGROUPS;++g){
    MultisampleKeygroup &kg=_keygroups[slot][g];
    if(kg.highNote<kg.lowNote){kg.highNote=kg.lowNote;++fixes;}
    if(kg.endPct<=kg.startPct){kg.endPct=(uint8_t)min(100,(int)kg.startPct+1);++fixes;}
    bool groupPlayable=false;
    for(uint8_t l=0;l<MAX_VELOCITY_LAYERS;++l){
      VelocityLayer &vl=kg.layer[l];
      uint8_t available=0;
      for(uint8_t r=0;r<MAX_RR_VARIANTS;++r) if(vl.rr[r].buffer&&vl.rr[r].frames) ++available;
      if(vl.enabled&&available==0){vl.enabled=false;++fixes;}
      if(vl.enabled&&vl.velocityHigh<vl.velocityLow){vl.velocityHigh=vl.velocityLow;++fixes;}
      if(vl.loopEndPct<=vl.loopStartPct+1){vl.loopMode=0;vl.loopEndPct=(uint8_t)min(100,(int)vl.loopStartPct+2);++fixes;}
      if(vl.rrMode!=0&&vl.rrMode!=2&&vl.rrMode!=3&&vl.rrMode!=4&&vl.rrMode!=5){vl.rrMode=0;vl.rrCounter=0;++fixes;}
      if(vl.rrMode>=2&&vl.rrMode<=4&&available<vl.rrMode){
        const uint8_t fixed=(available>=2)?available:0;
        if(vl.rrMode!=fixed){vl.rrMode=fixed;vl.rrCounter=0;++fixes;}
      }
      if(vl.enabled&&available) groupPlayable=true;
      updateVelocityLayerPan(vl);
    }
    if(kg.enabled&&!groupPlayable){kg.enabled=false;++fixes;}
    else if(!kg.enabled&&groupPlayable){kg.enabled=true;++fixes;}
  }
  _msSanitizeCount+=fixes;
  return fixes;
}

void PhoenixAudioManager::setKeygroupMapping(uint8_t slot,uint8_t group,bool enabled,uint8_t low,uint8_t high,uint8_t root,uint8_t level,int8_t pan){
  slot=safeSlot(slot);group&=15;MultisampleKeygroup &kg=_keygroups[slot][group];const uint8_t oldRoot=kg.rootNote;kg.enabled=enabled;kg.lowNote=constrain((int)low,0,127);kg.highNote=constrain((int)high,0,127);if(kg.highNote<kg.lowNote)kg.highNote=kg.lowNote;kg.rootNote=constrain((int)root,0,127);setKeygroupLayerMapping(slot,group,0,enabled,1,127,level,pan);if(kg.rootNote!=oldRoot)retuneActiveKeygroupVoices(slot,group);
}
void PhoenixAudioManager::setKeygroupChokeGroup(uint8_t slot,uint8_t group,uint8_t chokeGroup){
  _keygroups[safeSlot(slot)][group&15].chokeGroup=constrain((int)chokeGroup,0,8);
}
void PhoenixAudioManager::setKeygroupOneShot(uint8_t slot,uint8_t group,bool oneShot){
  _keygroups[safeSlot(slot)][group&15].oneShot=oneShot;
}
void PhoenixAudioManager::setKeygroupChokeFadeMs(uint8_t slot,uint8_t group,uint16_t fadeMs){
  _keygroups[safeSlot(slot)][group&15].chokeFadeMs=(uint16_t)constrain((int)fadeMs,0,250);
}
void PhoenixAudioManager::setKeygroupPlayMode(uint8_t slot,uint8_t group,uint8_t playMode){
  _keygroups[safeSlot(slot)][group&15].playMode=(uint8_t)constrain((int)playMode,0,2);
}
void PhoenixAudioManager::setKeygroupExclusiveGroup(uint8_t slot,uint8_t group,uint8_t exclusiveGroup){
  _keygroups[safeSlot(slot)][group&15].exclusiveGroup=(uint8_t)constrain((int)exclusiveGroup,0,8);
}
void PhoenixAudioManager::setKeygroupRetriggerLegato(uint8_t slot,uint8_t group,bool legato){
  _keygroups[safeSlot(slot)][group&15].retriggerLegato=legato;
}
void PhoenixAudioManager::setKeygroupStartPct(uint8_t slot,uint8_t group,uint8_t pct){ auto &kg=_keygroups[safeSlot(slot)][group&15]; kg.startPct=(uint8_t)constrain((int)pct,0,99); if(kg.startPct>=kg.endPct)kg.startPct=kg.endPct-1; }
void PhoenixAudioManager::setKeygroupEndPct(uint8_t slot,uint8_t group,uint8_t pct){ auto &kg=_keygroups[safeSlot(slot)][group&15]; kg.endPct=(uint8_t)constrain((int)pct,1,100); if(kg.endPct<=kg.startPct)kg.endPct=kg.startPct+1; }
void PhoenixAudioManager::setKeygroupReverse(uint8_t slot,uint8_t group,bool reverse){ _keygroups[safeSlot(slot)][group&15].reversePlayback=reverse; }
void PhoenixAudioManager::retuneActiveKeygroupVoices(uint8_t slot,uint8_t group,uint16_t smoothFrames){
  slot=safeSlot(slot);group&=15;const MultisampleKeygroup &kg=_keygroups[slot][group];
  const float bendSemis=((float)_slotPitchBend[slot]/8192.0f)*(float)_slotPitchBendRange[slot];
  const float bendRatio=powf(2.0f,bendSemis/12.0f);
  for(uint8_t i=0;i<VOICE_COUNT;++i){
    InstrumentVoice &v=_voices[i];if(!v.active||v.slot!=slot||v.keygroup!=group)continue;
    int cents=(int)_slotCoarse[slot]*100+(int)_slotFine[slot]+(int)kg.transposeSemitone*100+(int)kg.fineCent;
    if(_slotPitchTrack[slot]){int semis=(int)v.note-(int)kg.rootNote+((int)_slotOctave[slot]*12);semis=constrain(semis,-48,48);cents+=(semis*100*(int)kg.keytrackPct)/100;}
    float ratio=powf(2.0f,(float)cents/1200.0f);ratio=constrain(ratio,0.25f,4.0f);
    uint32_t newBase=(uint32_t)(ratio*65536.0f+0.5f);if(!newBase)newBase=1;uint32_t newTarget=(uint32_t)((float)newBase*bendRatio+0.5f);if(!newTarget)newTarget=1;
    v.baseIncQ16=newBase;v.targetIncQ16=newTarget;
    if(smoothFrames>0){v.glideFramesLeft=smoothFrames;v.glideStepQ16=((int32_t)v.targetIncQ16-(int32_t)v.incQ16)/(int32_t)smoothFrames;if(v.glideStepQ16==0&&v.incQ16!=v.targetIncQ16)v.glideStepQ16=(v.targetIncQ16>v.incQ16)?1:-1;}
    else{v.incQ16=v.targetIncQ16;v.glideFramesLeft=0;v.glideStepQ16=0;}
  }
}

void PhoenixAudioManager::setKeygroupTranspose(uint8_t slot,uint8_t group,int8_t semitone){slot=safeSlot(slot);group&=15;auto &kg=_keygroups[slot][group];const int8_t nv=(int8_t)constrain((int)semitone,-24,24);if(kg.transposeSemitone==nv)return;kg.transposeSemitone=nv;retuneActiveKeygroupVoices(slot,group);}
void PhoenixAudioManager::setKeygroupFineCent(uint8_t slot,uint8_t group,int16_t cents){slot=safeSlot(slot);group&=15;auto &kg=_keygroups[slot][group];const int16_t nv=(int16_t)constrain((int)cents,-100,100);if(kg.fineCent==nv)return;kg.fineCent=nv;retuneActiveKeygroupVoices(slot,group);}
void PhoenixAudioManager::setKeygroupKeytrackPct(uint8_t slot,uint8_t group,uint8_t pct){slot=safeSlot(slot);group&=15;auto &kg=_keygroups[slot][group];const uint8_t nv=(uint8_t)constrain((int)pct,0,100);if(kg.keytrackPct==nv)return;kg.keytrackPct=nv;retuneActiveKeygroupVoices(slot,group);}
void PhoenixAudioManager::setKeygroupLayerLoop(uint8_t slot,uint8_t group,uint8_t layer,uint8_t mode,uint8_t startPct,uint8_t endPct,uint8_t xfadeMs){
  VelocityLayer &vl=_keygroups[safeSlot(slot)][group&15].layer[layer%MAX_VELOCITY_LAYERS];
  vl.loopMode=(mode>2)?2:mode; vl.loopStartPct=(uint8_t)constrain((int)startPct,0,98); vl.loopEndPct=(uint8_t)constrain((int)endPct,1,100);
  if(vl.loopEndPct<=vl.loopStartPct+1) vl.loopEndPct=(uint8_t)min(100,(int)vl.loopStartPct+2); vl.loopXfadeMs=(uint8_t)constrain((int)xfadeMs,0,50);
}
void PhoenixAudioManager::setKeygroupLayerVelocityResponse(uint8_t slot,uint8_t group,uint8_t layer,uint8_t velToLevelPct,uint8_t velToFilterPct){
  VelocityLayer &vl=_keygroups[safeSlot(slot)][group&15].layer[layer%MAX_VELOCITY_LAYERS];
  vl.velocityToLevelPct=(uint8_t)constrain((int)velToLevelPct,0,100);
  vl.velocityToFilterPct=(uint8_t)constrain((int)velToFilterPct,0,100);
}
void PhoenixAudioManager::setKeygroupLayerMapping(uint8_t slot,uint8_t group,uint8_t layer,bool enabled,uint8_t velocityLow,uint8_t velocityHigh,uint8_t level,int8_t pan){
  slot=safeSlot(slot);group&=15;layer%=MAX_VELOCITY_LAYERS;VelocityLayer &vl=_keygroups[slot][group].layer[layer];vl.enabled=enabled;vl.velocityLow=constrain((int)velocityLow,1,127);vl.velocityHigh=constrain((int)velocityHigh,0,127);if(vl.enabled&&vl.velocityHigh<vl.velocityLow)vl.velocityHigh=vl.velocityLow;vl.level=constrain((int)level,0,100);vl.pan=constrain((int)pan,-100,100);updateVelocityLayerPan(vl);if(enabled)_keygroups[slot][group].enabled=true;
}

void PhoenixAudioManager::removeKeygroup(uint8_t slot,uint8_t group){slot=safeSlot(slot);group&=15;MultisampleKeygroup &kg=_keygroups[slot][group];for(uint8_t i=0;i<PHX_VOICE_COUNT;++i)if(_voices[i].active&&_voices[i].slot==slot&&_voices[i].keygroup==group)_voices[i].active=false;for(uint8_t l=0;l<MAX_VELOCITY_LAYERS;++l){for(uint8_t r=0;r<MAX_RR_VARIANTS;++r){if(kg.layer[l].rr[r].buffer){free(kg.layer[l].rr[r].buffer);kg.layer[l].rr[r].buffer=nullptr;kg.layer[l].rr[r].frames=0;}}}kg=MultisampleKeygroup();}

void PhoenixAudioManager::clearMultisample(uint8_t slot){slot=safeSlot(slot);allNotesOff(slot,true);for(uint8_t g=0;g<MAX_KEYGROUPS;++g){MultisampleKeygroup &kg=_keygroups[slot][g];for(uint8_t l=0;l<MAX_VELOCITY_LAYERS;++l)for(uint8_t r=0;r<MAX_RR_VARIANTS;++r)if(kg.layer[l].rr[r].buffer){free(kg.layer[l].rr[r].buffer);kg.layer[l].rr[r].buffer=nullptr;kg.layer[l].rr[r].frames=0;}kg=MultisampleKeygroup();}}

bool PhoenixAudioManager::startMultisampleMidi(uint8_t slot,uint8_t midiNote,uint8_t velocity,bool reverse){
  return startMultisampleMidiOwned(slot,midiNote,velocity,reverse) >= 0;
}

int PhoenixAudioManager::startMultisampleMidiOwned(uint8_t slot,uint8_t midiNote,uint8_t velocity,bool reverse){
  int firstVoice=-1; slot=safeSlot(slot); bool noteMapped=false; bool velocityMapped=false;
  for(uint8_t g=0;g<MAX_KEYGROUPS;++g){
    MultisampleKeygroup &kg=_keygroups[slot][g];
    if(!kg.enabled||midiNote<kg.lowNote||midiNote>kg.highNote) continue;
    noteMapped=true;
    int selected=-1;
    for(uint8_t l=0;l<MAX_VELOCITY_LAYERS;++l){
      VelocityLayer &vl=kg.layer[l];
      if(vl.enabled&&keygroupLayerRoundRobinCount(slot,g,l)>0&&velocity>=vl.velocityLow&&velocity<=vl.velocityHigh){selected=l;break;}
    }
    if(selected>=0){
      velocityMapped=true;
      const int voiceId=startKeygroupVoiceOwned(slot,g,(uint8_t)selected,midiNote,velocity,reverse);
      if(firstVoice<0&&voiceId>=0) firstVoice=voiceId;
    }
    if(_slotVoiceMode[slot]!=0) break;
  }
  if(!noteMapped) ++_msNoteMissCount;
  else if(!velocityMapped) ++_msVelocityMissCount;
  return firstVoice;
}

bool PhoenixAudioManager::startKeygroupVoice(uint8_t slot,uint8_t group,uint8_t layer,uint8_t midiNote,uint8_t velocity,bool reverse){
  return startKeygroupVoiceOwned(slot,group,layer,midiNote,velocity,reverse) >= 0;
}

int PhoenixAudioManager::startKeygroupVoiceOwned(uint8_t slot,uint8_t group,uint8_t layer,uint8_t midiNote,uint8_t velocity,bool reverse){
  MultisampleKeygroup &kg=_keygroups[safeSlot(slot)][group&15];VelocityLayer &vl=kg.layer[layer%MAX_VELOCITY_LAYERS];if(!kg.enabled||!vl.enabled||velocity==0)return -1;
  // v0.7.29 Play Modes. LEGATO leaves an already active voice of this keygroup untouched.
  if(kg.retriggerLegato){for(uint8_t i=0;i<PHX_VOICE_COUNT;++i){InstrumentVoice &cv=_voices[i];if(cv.active&&cv.slot==safeSlot(slot)&&cv.keygroup==(group&15))return (int)i;}}
  if(kg.playMode==1){for(uint8_t i=0;i<PHX_VOICE_COUNT;++i){InstrumentVoice &cv=_voices[i];if(cv.active&&cv.slot==safeSlot(slot)&&cv.keygroup==(group&15)){cv.active=false;cv.releasing=false;cv.envQ15=0;}}}
  else if(kg.playMode==2&&kg.exclusiveGroup){for(uint8_t i=0;i<PHX_VOICE_COUNT;++i){InstrumentVoice &cv=_voices[i];if(!cv.active||cv.slot!=safeSlot(slot)||cv.keygroup>=MAX_KEYGROUPS)continue;const MultisampleKeygroup &other=_keygroups[safeSlot(slot)][cv.keygroup];if(other.playMode==2&&other.exclusiveGroup==kg.exclusiveGroup){cv.active=false;cv.releasing=false;cv.envQ15=0;}}}
  // Choke Group: stop matching voices immediately or with a short anti-click fade.
  if(kg.chokeGroup){
    for(uint8_t i=0;i<PHX_VOICE_COUNT;++i){
      InstrumentVoice &cv=_voices[i];
      if(!cv.active||cv.slot!=safeSlot(slot)||cv.keygroup>=MAX_KEYGROUPS)continue;
      if(_keygroups[safeSlot(slot)][cv.keygroup].chokeGroup!=kg.chokeGroup)continue;
      if(kg.chokeFadeMs==0){cv.active=false;cv.releasing=false;cv.envQ15=0;}
      else{uint32_t frames=(uint32_t)kg.chokeFadeMs*32U;uint32_t step=frames?((uint32_t)cv.envQ15/frames):32767U;if(step<1U)step=1U;if(step>32767U)step=32767U;cv.releaseStepQ15=(uint16_t)step;cv.keyHeld=false;cv.sustained=false;cv.releasing=true;cv.envStage=3;}
    }
  }
  uint8_t loaded[MAX_RR_VARIANTS];uint8_t available=0;for(uint8_t r=0;r<MAX_RR_VARIANTS;++r)if(vl.rr[r].buffer&&vl.rr[r].frames)loaded[available++]=r;if(!available)return -1;if(vl.rrMode>=2&&vl.rrMode<=4&&available<vl.rrMode)++_msRrFallbackCount;uint8_t useCount=1;if(vl.rrMode==2||vl.rrMode==3||vl.rrMode==4)useCount=vl.rrMode;else if(vl.rrMode==5)useCount=available;if(useCount>available)useCount=available;uint8_t pick=0;if(vl.rrMode==5&&useCount>1){uint32_t x=(uint32_t)vl.rrCounter*1664525UL+1013904223UL+_voiceAgeCounter;pick=(uint8_t)(x%useCount);vl.rrCounter++;}else if(useCount>1){pick=(uint8_t)(vl.rrCounter%useCount);vl.rrCounter=(uint8_t)((vl.rrCounter+1)%useCount);}uint8_t rrIndex=loaded[pick];RoundRobinVariant *rv=&vl.rr[rrIndex];
  int vi=allocateVoiceForSlot(slot);if(vi<0)vi=allocateVoice();InstrumentVoice &v=_voices[vi];v.active=false;v.releasing=false;v.keyHeld=true;v.sustained=false;v.envStage=0;v.slot=slot;v.note=midiNote;v.velocity=velocity;v.velocityLevel=(uint8_t)(127U-(((uint32_t)(127U-velocity)*(uint32_t)vl.velocityToLevelPct)/100U));v.velocityFilterAmount=vl.velocityToFilterPct;v.keygroup=group&15;v.velocityLayer=layer%MAX_VELOCITY_LAYERS;v.sourceBuffer=rv->buffer;v.sourceFrames=rv->frames;v.sourceGainLQ15=vl.gainLQ15;v.sourceGainRQ15=vl.gainRQ15;v.reverse=(reverse^kg.reversePlayback);v.rangeStart=(uint32_t)(((uint64_t)rv->frames*kg.startPct)/100ULL);v.rangeEnd=(uint32_t)(((uint64_t)rv->frames*kg.endPct)/100ULL);if(v.rangeEnd>rv->frames)v.rangeEnd=rv->frames;if(v.rangeEnd<=v.rangeStart)v.rangeEnd=(v.rangeStart<rv->frames)?v.rangeStart+1:rv->frames;v.loopMode=v.reverse?0:vl.loopMode;v.loopForward=true;const uint32_t span=v.rangeEnd-v.rangeStart;v.loopStartFrame=v.rangeStart+(uint32_t)(((uint64_t)span*vl.loopStartPct)/100ULL);v.loopEndFrame=v.rangeStart+(uint32_t)(((uint64_t)span*vl.loopEndPct)/100ULL);if(v.loopEndFrame>v.rangeEnd)v.loopEndFrame=v.rangeEnd;if(v.loopEndFrame<=v.loopStartFrame+1)v.loopMode=0;uint32_t xf=(uint32_t)vl.loopXfadeMs*32U;if(xf>(v.loopEndFrame-v.loopStartFrame)/2U)xf=(v.loopEndFrame-v.loopStartFrame)/2U;v.loopXfadeFrames=(uint16_t)min((uint32_t)65535U,xf);v.posQ16=((uint64_t)(v.reverse?(v.rangeEnd-1):v.rangeStart))<<16;
  int cents=(int)_slotCoarse[slot]*100+(int)_slotFine[slot]+(int)kg.transposeSemitone*100+(int)kg.fineCent;if(_slotPitchTrack[slot]){int semis=(int)midiNote-(int)kg.rootNote+((int)_slotOctave[slot]*12);semis=constrain(semis,-48,48);cents+=(semis*100*(int)kg.keytrackPct)/100;}float ratio=powf(2.0f,(float)cents/1200.0f);ratio=constrain(ratio,0.25f,4.0f);v.baseIncQ16=(uint32_t)(ratio*65536.0f+0.5f);const float bendSemis=((float)_slotPitchBend[slot]/8192.0f)*(float)_slotPitchBendRange[slot];v.targetIncQ16=(uint32_t)((float)v.baseIncQ16*powf(2.0f,bendSemis/12.0f)+0.5f);if(!v.targetIncQ16)v.targetIncQ16=1;v.incQ16=v.targetIncQ16;v.glideFramesLeft=0;v.glideStepQ16=0;
  v.envQ15=0;v.sustainQ15=(uint16_t)(((uint32_t)_slotSustainPct[slot]*32767U)/100U);const uint32_t af=(uint32_t)_slotAttackMs[slot]*32U,df=(uint32_t)_slotDecayMs[slot]*32U,rf=(uint32_t)_slotReleaseMs[slot]*32U;uint32_t as=af?32767U/af:32767U;if(as<1U)as=1U;if(as>32767U)as=32767U;const uint32_t envSpan=32767U-(uint32_t)v.sustainQ15;uint32_t ds=(df&&envSpan)?envSpan/df:32767U;if(ds<1U)ds=1U;if(ds>32767U)ds=32767U;uint32_t rs=rf?32767U/rf:32767U;if(rs<1U)rs=1U;if(rs>32767U)rs=32767U;v.attackStepQ15=(uint16_t)as;v.decayStepQ15=(uint16_t)ds;v.releaseStepQ15=(uint16_t)rs;
  v.age=++_voiceAgeCounter;v.vintagePhase=0;v.vintageHold=0;v.vintageFilterState=0;v.vintageNoise=0x5A5A1234UL^v.age;v.filterEnvStage=0;v.filterEnvQ15=0;v.filterLow=0;v.filterBand=0;v.filterEnvSustainQ15=(uint16_t)(((uint32_t)_slotFilterSustainPct[slot]*32767UL)/100UL);v.filterAttackStepQ15=32767;v.filterDecayStepQ15=1;v.filterReleaseStepQ15=1;v.seqStartDelayFrames=0;v.active=true;_selectedSlot=slot;_playSlot=slot;_testTone=TONE_THRU;refreshActiveVoiceCount();return vi;
}

void PhoenixAudioManager::setPitchBendRange(uint8_t slot, uint8_t semitones) {
  slot = safeSlot(slot);
  static const uint8_t allowed[] = {1,2,3,5,7,12,24};
  uint8_t best = 2;
  uint8_t bestDiff = 255;
  for (uint8_t i=0;i<sizeof(allowed);++i) {
    uint8_t d = (allowed[i] > semitones) ? (allowed[i]-semitones) : (semitones-allowed[i]);
    if (d < bestDiff) { bestDiff=d; best=allowed[i]; }
  }
  _slotPitchBendRange[slot] = best;
  setPitchBend(slot, _slotPitchBend[slot]);
}

void PhoenixAudioManager::setPitchBend(uint8_t slot, int16_t bend14) {
  slot = safeSlot(slot);
  if (bend14 < -8192) bend14 = -8192;
  if (bend14 > 8191) bend14 = 8191;
  _slotPitchBend[slot] = bend14;
  const float bendSemis = ((float)bend14 / 8192.0f) * (float)_slotPitchBendRange[slot];
  const float ratio = powf(2.0f, bendSemis / 12.0f);
  for (uint8_t i=0;i<VOICE_COUNT;++i) {
    InstrumentVoice &v = _voices[i];
    if (v.active && v.slot == slot) {
      uint32_t inc = (uint32_t)((float)v.baseIncQ16 * ratio + 0.5f);
      v.targetIncQ16 = inc ? inc : 1;
      if (v.glideFramesLeft == 0) v.incQ16 = v.targetIncQ16;
    }
  }
}

void PhoenixAudioManager::noteOffMidi(uint8_t midiNote) {
  for (uint8_t i = 0; i < VOICE_COUNT; ++i) {
    InstrumentVoice &v = _voices[i];
    if (!v.active || v.note != midiNote) continue;
    if (v.keygroup < MAX_KEYGROUPS && _keygroups[safeSlot(v.slot)][v.keygroup].oneShot) continue;
    v.keyHeld = false;
    if (_slotSustainDown[safeSlot(v.slot)]) {
      v.sustained = true;
    } else {
      beginVoiceRelease(v);
    }
  }
}

void PhoenixAudioManager::noteOffMidi(uint8_t slot, uint8_t midiNote) {
  slot = safeSlot(slot);
  midiNote &= 127U;

  // C031: an orphan Note Off must never release a newly stolen/reused voice.
  if (_noteHoldCount[slot][midiNote] == 0U) { ++_orphanNoteOffCount; return; }
  --_noteHoldCount[slot][midiNote];
  _heldNotes[slot][midiNote] = (_noteHoldCount[slot][midiNote] != 0U);

  if (_slotVoiceMode[slot] != 0) {
    int vi = findActiveVoiceForSlot(slot);
    if (vi >= 0 && _voices[vi].note == midiNote) {
      int next = selectHeldNote(slot);
      if (next >= 0) {
        const uint8_t savedDepth = _noteHoldCount[slot][next];
        startPlaybackMidi(slot, (uint8_t)next, _heldVelocity[slot][next], _voices[vi].reverse);
        _noteHoldCount[slot][next] = savedDepth;
        _heldNotes[slot][next] = (savedDepth != 0U);
        return;
      }
    } else return;
  }

  // Poly mode: one Note Off consumes one matching held voice (FIFO).
  const int vi = findOldestHeldVoiceForNote(slot, midiNote);
  if (vi < 0) { ++_orphanNoteOffCount; return; }
  InstrumentVoice &v = _voices[(uint8_t)vi];
  if (v.keygroup < MAX_KEYGROUPS && _keygroups[slot][v.keygroup].oneShot) { v.keyHeld = false; return; }
  v.keyHeld = false;
  if (_slotSustainDown[slot]) { v.sustained = true; ++_sustainDeferredNoteOffCount; }
  else beginVoiceRelease(v);
}

void PhoenixAudioManager::setSustain(uint8_t slot, bool down) {
  slot = safeSlot(slot);
  const bool wasDown = _slotSustainDown[slot];
  _slotSustainDown[slot] = down;
  if (wasDown && !down) {
    for (uint8_t i = 0; i < VOICE_COUNT; ++i) {
      InstrumentVoice &v = _voices[i];
      if (v.active && v.slot == slot && !v.keyHeld && v.sustained && !(v.keygroup < MAX_KEYGROUPS && _keygroups[slot][v.keygroup].oneShot)) {
        v.sustained = false;
        beginVoiceRelease(v);
      }
    }
  }
}

void PhoenixAudioManager::allNotesOff(uint8_t slot, bool immediate) {
  slot = safeSlot(slot);
  for (uint16_t n=0;n<128;++n) { _heldNotes[slot][n]=false; _noteHoldCount[slot][n]=0; }
  _slotSustainDown[slot] = false;
  for (uint8_t i = 0; i < VOICE_COUNT; ++i) {
    InstrumentVoice &v = _voices[i];
    if (!v.active || v.slot != slot) continue;
    if (immediate) ++_panicKillCount;
    v.keyHeld = false;
    v.sustained = false;
    if (immediate) {
      v.active = false;
      v.releasing = false;
      v.envQ15 = 0;
    } else {
      beginVoiceRelease(v);
    }
  }
  refreshActiveVoiceCount();
}

void PhoenixAudioManager::allNotesOff() {
  for (uint8_t slot = 0; slot < SLOT_COUNT; ++slot) allNotesOff(slot, true);
}


void PhoenixAudioManager::setEnvelopeParams(uint8_t slot, uint16_t attackMs, uint16_t decayMs, uint8_t sustainPct, uint16_t releaseMs) {
  slot = safeSlot(slot);
  _slotAttackMs[slot] = constrain((int)attackMs, 0, 2000);
  _slotDecayMs[slot] = constrain((int)decayMs, 0, 5000);
  _slotSustainPct[slot] = constrain((int)sustainPct, 0, 100);
  _slotReleaseMs[slot] = constrain((int)releaseMs, 0, 5000);
}


void PhoenixAudioManager::setQuattroConfig(uint8_t mode, const uint8_t low[4], const uint8_t high[4], const uint8_t channel[4]) {
  _quattroMode = mode ? 1 : 0;
  for (uint8_t i=0;i<SLOT_COUNT;++i) {
    _quattroKeyLow[i] = low ? (uint8_t)constrain((int)low[i],0,127) : (uint8_t)(i*32);
    _quattroKeyHigh[i] = high ? (uint8_t)constrain((int)high[i],0,127) : (uint8_t)((i==3)?127:(i*32+31));
    if (_quattroKeyHigh[i] < _quattroKeyLow[i]) _quattroKeyHigh[i]=_quattroKeyLow[i];
    _quattroMidiChannel[i] = channel ? constrain((int)channel[i],1,16) : (i+2);
  }
}

void PhoenixAudioManager::setVintageParams(uint8_t slot, uint8_t preset, uint8_t sampleRateIndex, uint8_t bitDepthIndex, uint8_t filterMode, uint8_t jitter) {
  slot = safeSlot(slot);
  _slotVintagePreset[slot] = (preset > 7) ? 7 : preset;
  _slotVintageSampleRate[slot] = (sampleRateIndex > 8) ? 8 : sampleRateIndex;
  _slotVintageBitDepth[slot] = (bitDepthIndex > 6) ? 6 : bitDepthIndex;
  _slotVintageFilter[slot] = (filterMode > 3) ? 3 : filterMode;
  _slotVintageJitter[slot] = (jitter > 100) ? 100 : jitter;
}

int16_t PhoenixAudioManager::processVintage(uint8_t slot, int16_t input, uint32_t &phase, int16_t &hold, int32_t &filterState, uint32_t &noise) {
  slot = safeSlot(slot);
  // C029c neutral Vintage fast path. At 32 kHz / 16 bit / FILTER OFF /
  // JITTER 0 the Vintage stage is exactly transparent, so do no per-sample
  // RNG/hold/filter bookkeeping. If Vintage is enabled while a note is already
  // sounding, the Vintage state starts from its last active state/voice default
  // on the next sample; the neutral audio output itself remains bit-identical.
  if (_slotVintageSampleRate[slot] == 0 && _slotVintageBitDepth[slot] == 0 &&
      _slotVintageFilter[slot] == 0 && _slotVintageJitter[slot] == 0) return input;
  static const uint16_t rates[9] = {32000, 24000, 22050, 16000, 12000, 11025, 8000, 6000, 4000};
  static const uint8_t bits[7] = {16, 14, 12, 10, 8, 6, 4};
  const uint16_t targetRate = rates[_slotVintageSampleRate[slot]];
  noise = noise * 1664525UL + 1013904223UL;
  int32_t jitter = 0;
  if (_slotVintageJitter[slot] > 0) {
    int32_t rnd = (int32_t)((noise >> 24) & 0xFF) - 128;
    jitter = (rnd * (int32_t)_slotVintageJitter[slot] * 96) / 100;
  }
  int32_t inc = (int32_t)targetRate * 2048 + jitter;
  if (inc < 1024) inc = 1024;
  if (phase == 0) hold = input;
  phase += (uint32_t)inc;
  if (phase >= 32000UL * 2048UL) {
    phase -= 32000UL * 2048UL;
    hold = input;
  }
  int32_t x = hold;
  const uint8_t bd = bits[_slotVintageBitDepth[slot]];
  if (bd < 16) {
    const uint8_t shift = 16 - bd;
    x = (x >> shift) << shift;
  }
  const uint8_t fm = _slotVintageFilter[slot];
  if (fm > 0) {
    static const uint8_t alphaShift[4] = {0, 2, 3, 4};
    filterState += ((x << 8) - filterState) >> alphaShift[fm];
    x = filterState >> 8;
  } else {
    filterState = x << 8;
  }
  return phxClamp16(x);
}
uint32_t PhoenixAudioManager::effectiveSampleStart(const SampleSlot &s) const {
  // C019: S.START and S.END are always the audible sample boundaries.
  // TRIM is now an automatic marker operation with undo, not a playback gate.
  return (s.sampleStart < s.frames) ? s.sampleStart : 0U;
}

uint32_t PhoenixAudioManager::effectiveSampleEnd(const SampleSlot &s) const {
  uint32_t end = s.sampleEnd;
  if (end == 0U || end > s.frames) end = s.frames;
  return end;
}

void PhoenixAudioManager::resolveSlotPlaybackMarkers(uint8_t slot, uint32_t &sampleStart, uint32_t &sampleEnd,
                                                       uint32_t &loopStart, uint32_t &loopEnd, uint8_t &loopMode) const {
  // C032: one canonical interpretation of S.START/L.START/L.END/S.END for
  // MIDI voices, live marker edits and the Sample Editor transport. End
  // markers are exclusive: audible sample frames are [S.START, S.END), and
  // loop frames are [L.START, L.END).
  slot = safeSlot(slot);
  const SampleSlot &s = _slots[slot];
  sampleStart = effectiveSampleStart(s);
  sampleEnd = effectiveSampleEnd(s);
  if (sampleEnd > s.frames) sampleEnd = s.frames;
  if (sampleStart >= s.frames) sampleStart = 0U;
  if (sampleEnd <= sampleStart + 1U) {
    sampleStart = 0U;
    sampleEnd = s.frames;
  }

  loopStart = s.loopStart;
  loopEnd = s.loopEnd;
  if (loopStart < sampleStart || loopStart >= sampleEnd) loopStart = sampleStart;
  if (loopEnd == 0U || loopEnd > sampleEnd) loopEnd = sampleEnd;

  loopMode = (s.loopEnabled && s.loopMode != LOOP_OFF)
      ? ((s.loopMode <= LOOP_ALTERNATE) ? s.loopMode : LOOP_FORWARD)
      : LOOP_OFF;
  if (loopEnd <= loopStart + 1U) loopMode = LOOP_OFF;
}

void PhoenixAudioManager::calculateSlotProcessing(SampleSlot &s) {
  s.dcOffset = 0;
  s.normalizeGainQ16 = 65536UL;
  if (!s.buffer || s.frames == 0U || (!s.dcCorrectionEnabled && !s.normalizeEnabled)) return;
  uint32_t begin = s.sampleStart;
  uint32_t end = s.sampleEnd;
  if (end == 0U || end > s.frames) end = s.frames;
  if (begin >= end) { begin = 0U; end = s.frames; }
  int64_t sum = 0;
  for (uint32_t i = begin; i < end; ++i) sum += s.buffer[i];
  const uint32_t count = end - begin;
  const int32_t dc = count ? (int32_t)(sum / (int64_t)count) : 0;
  if (s.dcCorrectionEnabled) s.dcOffset = (int16_t)constrain(dc, -32768, 32767);
  if (s.normalizeEnabled) {
    uint32_t peak = 0U;
    const int32_t appliedDc = s.dcCorrectionEnabled ? s.dcOffset : 0;
    for (uint32_t i = begin; i < end; ++i) {
      int32_t v = (int32_t)s.buffer[i] - appliedDc;
      uint32_t a = (uint32_t)(v < 0 ? -v : v);
      if (a > peak) peak = a;
    }
    // -1 dBFS target (29204), Q16 gain, never amplify beyond 16x.
    if (peak > 0U) {
      uint64_t g = (29204ULL << 16) / peak;
      if (g > (16ULL << 16)) g = (16ULL << 16);
      s.normalizeGainQ16 = (uint32_t)g;
    }
  }
}

void PhoenixAudioManager::refreshSlotProcessing(uint8_t slot) {
  slot = safeSlot(slot);
  calculateSlotProcessing(_slots[slot]);
}

void PhoenixAudioManager::setTrimEnabled(uint8_t slot, bool enabled) {
  // Compatibility/state setter. The SAMPLE EDITOR uses applyAutoTrim()/
  // undoAutoTrim() so the previous marker set can be restored exactly.
  slot = safeSlot(slot);
  SampleSlot &s = _slots[slot];
  if (s.trimEnabled == enabled) return;
  s.trimEnabled = enabled;
  bumpSlotMarkerRevision(slot);
  applySlotMarkersToActivePlayback(slot, false);
}

bool PhoenixAudioManager::applyAutoTrim(uint8_t slot, uint32_t detectedStart, uint32_t detectedEnd) {
  slot = safeSlot(slot);
  SampleSlot &s = _slots[slot];
  if (!s.buffer || !s.recorded || s.frames < 3U || s.trimEnabled) return false;

  if (detectedStart >= s.frames) detectedStart = s.frames - 1U;
  if (detectedEnd == 0U || detectedEnd > s.frames) detectedEnd = s.frames;
  if (detectedEnd <= detectedStart + 1U) return false;
  if (detectedStart == s.sampleStart && detectedEnd == s.sampleEnd) return false;

  // Save all four markers, not only S.START/S.END. Cascading boundary changes
  // may also move loop points, and a second F1 press must undo that exactly.
  s.trimUndoSampleStart = s.sampleStart;
  s.trimUndoLoopStart = s.loopStart;
  s.trimUndoLoopEnd = s.loopEnd;
  s.trimUndoSampleEnd = s.sampleEnd;
  s.trimUndoValid = true;

  const uint32_t oldStart = s.sampleStart;
  s.sampleStart = detectedStart;
  s.sampleEnd = detectedEnd;

  // Preserve existing loop points where possible; push them into the newly
  // detected sample range only when they would otherwise become invalid.
  if (s.loopStart < s.sampleStart) s.loopStart = s.sampleStart;
  if (s.loopEnd == 0U || s.loopEnd > s.sampleEnd) s.loopEnd = s.sampleEnd;
  if (s.loopEnd <= s.loopStart + 1U) {
    s.loopStart = s.sampleStart;
    s.loopEnd = s.sampleEnd;
  }

  s.trimEnabled = true;
  normalizeSlotMarkers(s);
  calculateSlotProcessing(s);
  bumpSlotMarkerRevision(slot);
  applySlotMarkersToActivePlayback(slot, s.sampleStart != oldStart);
  return true;
}

bool PhoenixAudioManager::undoAutoTrim(uint8_t slot) {
  slot = safeSlot(slot);
  SampleSlot &s = _slots[slot];
  if (!s.trimEnabled) return false;

  const uint32_t oldStart = s.sampleStart;
  if (s.trimUndoValid) {
    s.sampleStart = s.trimUndoSampleStart;
    s.loopStart = s.trimUndoLoopStart;
    s.loopEnd = s.trimUndoLoopEnd;
    s.sampleEnd = s.trimUndoSampleEnd;
  } else {
    // Migration fallback for C018 banks, which stored no undo snapshot.
    s.sampleStart = 0U;
    s.sampleEnd = s.frames;
    if (s.loopStart >= s.sampleEnd) s.loopStart = 0U;
    if (s.loopEnd == 0U || s.loopEnd > s.sampleEnd) s.loopEnd = s.sampleEnd;
  }

  s.trimEnabled = false;
  s.trimUndoValid = false;
  normalizeSlotMarkers(s);
  calculateSlotProcessing(s);
  bumpSlotMarkerRevision(slot);
  applySlotMarkersToActivePlayback(slot, s.sampleStart != oldStart);
  return true;
}

bool PhoenixAudioManager::getTrimUndoMarkers(uint8_t slot, uint32_t &sampleStart,
                                               uint32_t &loopStart, uint32_t &loopEnd,
                                               uint32_t &sampleEnd) const {
  slot = safeSlot(slot);
  const SampleSlot &s = _slots[slot];
  sampleStart = s.trimUndoSampleStart;
  loopStart = s.trimUndoLoopStart;
  loopEnd = s.trimUndoLoopEnd;
  sampleEnd = s.trimUndoSampleEnd;
  return s.trimUndoValid;
}
void PhoenixAudioManager::setDcCorrectionEnabled(uint8_t slot, bool enabled) {
  slot = safeSlot(slot); SampleSlot &s = _slots[slot];
  s.dcCorrectionEnabled = enabled; calculateSlotProcessing(s);
}
void PhoenixAudioManager::setNormalizeEnabled(uint8_t slot, bool enabled) {
  slot = safeSlot(slot); SampleSlot &s = _slots[slot];
  s.normalizeEnabled = enabled; calculateSlotProcessing(s);
}
bool PhoenixAudioManager::trimEnabled(uint8_t slot) const { return _slots[safeSlot(slot)].trimEnabled; }
bool PhoenixAudioManager::dcCorrectionEnabled(uint8_t slot) const { return _slots[safeSlot(slot)].dcCorrectionEnabled; }
bool PhoenixAudioManager::normalizeEnabled(uint8_t slot) const { return _slots[safeSlot(slot)].normalizeEnabled; }
int16_t PhoenixAudioManager::slotDcOffset(uint8_t slot) const { return _slots[safeSlot(slot)].dcOffset; }
uint32_t PhoenixAudioManager::slotNormalizeGainQ16(uint8_t slot) const { return _slots[safeSlot(slot)].normalizeGainQ16; }

void PhoenixAudioManager::normalizeSlotMarkers(SampleSlot &s) {
  if (s.frames == 0U) {
    s.sampleStart = 0;
    s.sampleEnd = 0;
    s.loopStart = 0;
    s.loopEnd = 0;
    s.loopMode = LOOP_OFF;
    s.loopXfadeMs = 0;
    s.loopEnabled = false;
    return;
  }

  if (s.sampleStart >= s.frames) s.sampleStart = 0;
  if (s.sampleEnd == 0U || s.sampleEnd > s.frames) s.sampleEnd = s.frames;
  if (s.sampleEnd <= s.sampleStart + 1U) {
    s.sampleStart = 0;
    s.sampleEnd = s.frames;
  }

  if (s.loopStart < s.sampleStart || s.loopStart >= s.sampleEnd) s.loopStart = s.sampleStart;
  if (s.loopEnd == 0U || s.loopEnd > s.sampleEnd) s.loopEnd = s.sampleEnd;
  if (s.loopEnd <= s.loopStart + 1U) {
    s.loopStart = s.sampleStart;
    s.loopEnd = s.sampleEnd;
  }

  if (s.loopMode > LOOP_ALTERNATE) s.loopMode = LOOP_FORWARD;
  if (s.loopEnd <= s.loopStart + 1U) s.loopMode = LOOP_OFF;
  s.loopEnabled = (s.loopMode != LOOP_OFF);
}

void PhoenixAudioManager::bumpSlotMarkerRevision(uint8_t slot) {
  slot = safeSlot(slot);
  // Publish the marker payload before the revision token. The audio core reads
  // the token first and then reloads the coherent slot marker set.
  __sync_synchronize();
  uint32_t next = _slotMarkerRevision[slot] + 1U;
  if (next == 0U) next = 1U;
  _slotMarkerRevision[slot] = next;
  __sync_synchronize();
}

void PhoenixAudioManager::syncVoiceMarkersFromSlot(InstrumentVoice &v, bool restartAtSampleStart) {
  if (!v.active || v.keygroup != 255U) return;
  const uint8_t slot = safeSlot(v.slot);
  SampleSlot &s = _slots[slot];
  const uint32_t revision = _slotMarkerRevision[slot];
  __sync_synchronize();

  if (!s.recorded || !s.buffer || s.frames == 0U || s.sampleEnd <= s.sampleStart + 1U) {
    v.active = false;
    v.markerRevision = revision;
    return;
  }

  uint32_t rangeStart = 0U, rangeEnd = 0U, liveLoopStart = 0U, liveLoopEnd = 0U;
  uint8_t liveLoopMode = LOOP_OFF;
  resolveSlotPlaybackMarkers(slot, rangeStart, rangeEnd, liveLoopStart, liveLoopEnd, liveLoopMode);

  v.rangeStart = rangeStart;
  v.rangeEnd = rangeEnd;
  v.loopStartFrame = liveLoopStart;
  v.loopEndFrame = liveLoopEnd;
  v.loopMode = v.reverse ? LOOP_OFF : liveLoopMode;
  {
    uint32_t xf = (uint32_t)s.loopXfadeMs * 32U;
    const uint32_t loopLen = (liveLoopEnd > liveLoopStart) ? (liveLoopEnd - liveLoopStart) : 0U;
    if (xf > loopLen / 2U) xf = loopLen / 2U;
    v.loopXfadeFrames = (uint16_t)min((uint32_t)65535U, xf);
  }
  if (v.loopMode != LOOP_ALTERNATE) v.loopForward = true;

  if (v.reverse) {
    const uint32_t pos = (uint32_t)(v.posQ16 >> 16);
    if (pos < rangeStart || pos >= rangeEnd)
      v.posQ16 = ((uint64_t)(rangeEnd - 1U)) << 16;
    v.markerRevision = revision;
    return;
  }

  if (restartAtSampleStart) {
    // Sample Start is an audible start marker, not merely a clamp. Moving it
    // while a note is held restarts the sample position without retriggering
    // the ADSR envelope.
    v.posQ16 = ((uint64_t)rangeStart) << 16;
    v.loopForward = true;
    v.markerRevision = revision;
    return;
  }

  uint32_t pos = (uint32_t)(v.posQ16 >> 16);
  if (pos < rangeStart) {
    v.posQ16 = ((uint64_t)rangeStart) << 16;
    pos = rangeStart;
  }

  const bool gateActive = !v.releasing && (v.keyHeld || v.sustained);
  if (pos >= rangeEnd) {
    if (gateActive && liveLoopMode != LOOP_OFF) {
      v.posQ16 = ((uint64_t)liveLoopStart) << 16;
      v.loopForward = true;
    } else {
      v.posQ16 = ((uint64_t)(rangeEnd - 1U)) << 16;
      beginVoiceRelease(v);
    }
  } else if (gateActive && liveLoopMode != LOOP_OFF && pos >= liveLoopEnd) {
    v.posQ16 = ((uint64_t)liveLoopStart) << 16;
    v.loopForward = true;
  } else if (liveLoopMode == LOOP_ALTERNATE && !v.loopForward && pos <= liveLoopStart) {
    v.posQ16 = ((uint64_t)liveLoopStart) << 16;
    v.loopForward = true;
  }

  v.markerRevision = revision;
}

void PhoenixAudioManager::applySlotMarkersToActivePlayback(uint8_t slot, bool restartAtSampleStart) {
  slot = safeSlot(slot);
  SampleSlot &s = _slots[slot];
  if (!s.recorded || !s.buffer || s.frames == 0U) return;

  uint32_t rangeStart = 0U, rangeEnd = 0U, liveLoopStart = 0U, liveLoopEnd = 0U;
  uint8_t liveLoopMode = LOOP_OFF;
  resolveSlotPlaybackMarkers(slot, rangeStart, rangeEnd, liveLoopStart, liveLoopEnd, liveLoopMode);

  // C007: Standard slot voices no longer keep stale marker snapshots. Every
  // editor change is copied into already active voices immediately. Keygroup
  // voices are intentionally excluded because their ranges belong to the
  // multisample mapping, not to the four-marker single-sample editor.
  for (uint8_t i = 0; i < VOICE_COUNT; ++i) {
    InstrumentVoice &v = _voices[i];
    if (!v.active || v.slot != slot || v.keygroup != 255U) continue;
    syncVoiceMarkersFromSlot(v, restartAtSampleStart);
  }

  // The F7 audition transport is also live. Explicit playback ranges are used
  // by the Loop Points editor; normal replay follows Sample Start/End directly.
  if ((_state == AUDIO_PLAY || _state == AUDIO_PLAY_REVERSE) && _playSlot == slot) {
    const uint32_t transportStart = _playRangeActive ? _playRangeStart : rangeStart;
    const uint32_t transportEnd = _playRangeActive ? _playRangeEnd : rangeEnd;
    if (transportEnd <= transportStart + 1U) {
      _state = AUDIO_THRU;
      _playRangeActive = false;
      return;
    }

    if (restartAtSampleStart && !_playRangeActive && _state == AUDIO_PLAY) {
      _playPos = rangeStart;
      _playPosQ16 = ((uint64_t)rangeStart) << 16;
      _transportLoopForward = true;
      return;
    }

    if (liveLoopMode != LOOP_ALTERNATE) _transportLoopForward = true;
    uint32_t pos = (uint32_t)(_playPosQ16 >> 16);
    if (pos < transportStart) {
      const uint32_t restart = (_state == AUDIO_PLAY_REVERSE) ? (transportEnd - 1U) : transportStart;
      _playPos = restart;
      _playPosQ16 = ((uint64_t)restart) << 16;
      _transportLoopForward = true;
    } else if (pos >= transportEnd) {
      if (_state == AUDIO_PLAY && liveLoopMode != LOOP_OFF) {
        _playPos = liveLoopStart;
        _playPosQ16 = ((uint64_t)liveLoopStart) << 16;
        _transportLoopForward = true;
      } else {
        _state = AUDIO_THRU;
        _playRangeActive = false;
        _transportLoopForward = true;
      }
    } else if (_state == AUDIO_PLAY && liveLoopMode != LOOP_OFF && pos >= liveLoopEnd) {
      _playPos = liveLoopStart;
      _playPosQ16 = ((uint64_t)liveLoopStart) << 16;
      _transportLoopForward = true;
    } else if (_state == AUDIO_PLAY && liveLoopMode == LOOP_ALTERNATE &&
               !_transportLoopForward && pos <= liveLoopStart) {
      _playPos = liveLoopStart;
      _playPosQ16 = ((uint64_t)liveLoopStart) << 16;
      _transportLoopForward = true;
    }
  }
}

void PhoenixAudioManager::setLoopEnabled(uint8_t slot, bool enabled) {
  slot = safeSlot(slot);
  SampleSlot &s = _slots[slot];
  s.loopMode = enabled ? ((s.loopMode == LOOP_ALTERNATE) ? LOOP_ALTERNATE : LOOP_FORWARD) : LOOP_OFF;
  normalizeSlotMarkers(s);
  bumpSlotMarkerRevision(slot);
  applySlotMarkersToActivePlayback(slot, false);
}

void PhoenixAudioManager::setLoopMode(uint8_t slot, uint8_t mode) {
  slot = safeSlot(slot);
  SampleSlot &s = _slots[slot];
  s.loopMode = (mode > LOOP_ALTERNATE) ? LOOP_ALTERNATE : mode;
  normalizeSlotMarkers(s);
  bumpSlotMarkerRevision(slot);
  applySlotMarkersToActivePlayback(slot, false);
}

uint8_t PhoenixAudioManager::loopMode(uint8_t slot) const {
  slot = safeSlot(slot);
  const SampleSlot &s = _slots[slot];
  if (!s.recorded || s.frames == 0U || !s.loopEnabled) return LOOP_OFF;
  return (s.loopMode <= LOOP_ALTERNATE) ? s.loopMode : LOOP_FORWARD;
}

void PhoenixAudioManager::setLoopCrossfadeMs(uint8_t slot, uint8_t ms) {
  slot = safeSlot(slot);
  static const uint8_t allowed[] = {0,2,4,8,16,32};
  uint8_t best = allowed[0];
  uint8_t bestDiff = 255;
  for (uint8_t i=0;i<sizeof(allowed);++i) { uint8_t d=(allowed[i]>ms)?(allowed[i]-ms):(ms-allowed[i]); if(d<bestDiff){bestDiff=d;best=allowed[i];} }
  _slots[slot].loopXfadeMs = best;
  bumpSlotMarkerRevision(slot);
  applySlotMarkersToActivePlayback(slot, false);
}

uint8_t PhoenixAudioManager::loopCrossfadeMs(uint8_t slot) const {
  return _slots[safeSlot(slot)].loopXfadeMs;
}

bool PhoenixAudioManager::loopEnabled(uint8_t slot) const {
  return loopMode(slot) != LOOP_OFF;
}

uint32_t PhoenixAudioManager::loopStart(uint8_t slot) const {
  slot = safeSlot(slot);
  const SampleSlot &s = _slots[slot];
  if (!s.recorded || s.frames == 0U) return 0;
  uint32_t start = s.loopStart;
  const uint32_t sampleStartFrame = sampleStart(slot);
  const uint32_t sampleEndFrame = sampleEnd(slot);
  if (start < sampleStartFrame || start >= sampleEndFrame) start = sampleStartFrame;
  return start;
}

uint32_t PhoenixAudioManager::loopEnd(uint8_t slot) const {
  slot = safeSlot(slot);
  const SampleSlot &s = _slots[slot];
  if (!s.recorded || s.frames == 0U) return 0;
  uint32_t end = s.loopEnd;
  const uint32_t sampleEndFrame = sampleEnd(slot);
  if (end == 0U || end > sampleEndFrame) end = sampleEndFrame;
  if (end <= loopStart(slot) + 1U) end = sampleEndFrame;
  return end;
}

void PhoenixAudioManager::setLoopRange(uint8_t slot, uint32_t start, uint32_t end) {
  slot = safeSlot(slot);
  SampleSlot &s = _slots[slot];
  if (s.frames == 0U) {
    normalizeSlotMarkers(s);
    return;
  }

  normalizeSlotMarkers(s);
  if (start < s.sampleStart) start = s.sampleStart;
  if (start >= s.sampleEnd) start = s.sampleEnd - 1U;
  if (end == 0U || end > s.sampleEnd) end = s.sampleEnd;
  if (end <= start + 1U) {
    if (start + 2U <= s.sampleEnd) end = start + 2U;
    else {
      start = (s.sampleEnd > s.sampleStart + 2U) ? (s.sampleEnd - 2U) : s.sampleStart;
      end = s.sampleEnd;
    }
  }
  s.loopStart = start;
  s.loopEnd = end;
  normalizeSlotMarkers(s);
  bumpSlotMarkerRevision(slot);

  // startPlaybackRange() is the Loop Points F7 audition path. Keep that
  // explicit audition window synchronized with edited markers.
  if ((_state == AUDIO_PLAY || _state == AUDIO_PLAY_REVERSE) &&
      _playSlot == slot && _playRangeActive) {
    _playRangeStart = s.loopStart;
    _playRangeEnd = s.loopEnd;
  }
  applySlotMarkersToActivePlayback(slot, false);
}

uint32_t PhoenixAudioManager::sampleStart(uint8_t slot) const {
  slot = safeSlot(slot);
  const SampleSlot &s = _slots[slot];
  if (!s.recorded || s.frames == 0U) return 0;
  return (s.sampleStart < s.frames) ? s.sampleStart : 0;
}

uint32_t PhoenixAudioManager::sampleEnd(uint8_t slot) const {
  slot = safeSlot(slot);
  const SampleSlot &s = _slots[slot];
  if (!s.recorded || s.frames == 0U) return 0;
  uint32_t end = s.sampleEnd;
  if (end == 0U || end > s.frames) end = s.frames;
  if (end <= sampleStart(slot) + 1U) end = s.frames;
  return end;
}

void PhoenixAudioManager::setSampleRange(uint8_t slot, uint32_t start, uint32_t end) {
  slot = safeSlot(slot);
  SampleSlot &s = _slots[slot];
  const uint32_t oldStart = s.sampleStart;
  if (s.frames == 0U) {
    normalizeSlotMarkers(s);
    return;
  }
  if (start >= s.frames) start = s.frames - 1U;
  if (end == 0U || end > s.frames) end = s.frames;
  if (end <= start + 1U) {
    if (start + 2U <= s.frames) end = start + 2U;
    else {
      start = (s.frames > 2U) ? s.frames - 2U : 0U;
      end = s.frames;
    }
  }
  s.sampleStart = start;
  s.sampleEnd = end;
  normalizeSlotMarkers(s);
  bumpSlotMarkerRevision(slot);
  applySlotMarkersToActivePlayback(slot, s.sampleStart != oldStart);
}

void PhoenixAudioManager::setSampleMarkers(uint8_t slot, uint32_t newSampleStart,
                                           uint32_t newLoopStart, uint32_t newLoopEnd,
                                           uint32_t newSampleEnd) {
  slot = safeSlot(slot);
  SampleSlot &s = _slots[slot];
  if (s.frames == 0U) {
    normalizeSlotMarkers(s);
    return;
  }

  const uint32_t oldSampleStart = s.sampleStart;
  const uint32_t frames = s.frames;

  if (newSampleStart >= frames) newSampleStart = frames - 1U;
  if (newSampleEnd == 0U || newSampleEnd > frames) newSampleEnd = frames;
  if (newSampleEnd <= newSampleStart + 1U) {
    if (newSampleStart + 2U <= frames) newSampleEnd = newSampleStart + 2U;
    else {
      newSampleStart = (frames > 2U) ? frames - 2U : 0U;
      newSampleEnd = frames;
    }
  }

  if (newLoopStart < newSampleStart) newLoopStart = newSampleStart;
  if (newLoopStart >= newSampleEnd) newLoopStart = newSampleEnd - 1U;
  if (newLoopEnd == 0U || newLoopEnd > newSampleEnd) newLoopEnd = newSampleEnd;
  if (newLoopEnd <= newLoopStart + 1U) {
    if (newLoopStart + 2U <= newSampleEnd) newLoopEnd = newLoopStart + 2U;
    else {
      newLoopStart = (newSampleEnd > newSampleStart + 2U)
          ? (newSampleEnd - 2U) : newSampleStart;
      newLoopEnd = newSampleEnd;
    }
  }

  s.sampleStart = newSampleStart;
  s.loopStart = newLoopStart;
  s.loopEnd = newLoopEnd;
  s.sampleEnd = newSampleEnd;
  normalizeSlotMarkers(s);
  bumpSlotMarkerRevision(slot);
  applySlotMarkersToActivePlayback(slot, s.sampleStart != oldSampleStart);
}

void PhoenixAudioManager::setSampleGain(uint8_t slot, uint8_t gainPct) {
  _slotSampleGainPct[safeSlot(slot)] = (uint8_t)constrain((int)gainPct, 0, 200);
}

void PhoenixAudioManager::setVelocityAmount(uint8_t slot, uint8_t amountPct) {
  _slotVelocityAmount[safeSlot(slot)] = (uint8_t)constrain((int)amountPct, 0, 100);
}

bool PhoenixAudioManager::normalizeSlot(uint8_t slot) {
  slot = safeSlot(slot);
  SampleSlot &s = _slots[slot];
  if (!s.buffer || s.frames == 0) return false;
  int32_t peak = 0;
  for (uint32_t i = 0; i < s.frames; ++i) {
    int32_t a = s.buffer[i]; if (a < 0) a = -a; if (a > peak) peak = a;
  }
  if (peak <= 0 || peak >= 32760) return true;
  for (uint32_t i = 0; i < s.frames; ++i) {
    int32_t v = ((int32_t)s.buffer[i] * 32760L) / peak;
    s.buffer[i] = (int16_t)constrain(v, -32768L, 32767L);
    if ((i & 0x7FFU) == 0) delay(0);
  }
  return true;
}
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
