RealTimeAudioLab/RTAL-EAI-004-Phoenix-Sound-Sampler/firmware/Phoenix_v1.1.0/src/PhoenixApp/PhoenixScreens.cpp

#include "../PhoenixSystem/PhoenixSerial.h"
#include "PhoenixScreens.h"
#include "PhoenixLoopEditorMath.h"
#include <SD.h>
#include <SPI.h>

static uint8_t phxDefaultMultiChannel(uint8_t baseChannel, uint8_t slot) {
  if (baseChannel < 1 || baseChannel > 16) baseChannel = 1;
  return (uint8_t)(((baseChannel - 1U + (slot & 3U)) % 16U) + 1U);
}

// v0.6.8 encoder helpers --------------------------------------------------
static int16_t encSign(int16_t v) {
  return (v > 0) ? 1 : ((v < 0) ? -1 : 0);
}

static uint8_t encAbs16(int16_t v) {
  return (uint8_t)((v < 0) ? -v : v);
}

static int16_t semitoneStepFromEncoder(int16_t v) {
  const int16_t sg = encSign(v);
  if (!sg) return 0;
  return sg * (encAbs16(v) >= 5 ? 2 : 1);
}

static int16_t fineStepFromEncoder(int16_t v) {
  // Directly use encoder acceleration for cent values: 1/2/5/10 cents.
  return v;
}

static int16_t rootStepFromEncoder(int16_t v) {
  const int16_t sg = encSign(v);
  if (!sg) return 0;
  const uint8_t a = encAbs16(v);
  if (a >= 10) return sg * 12; // quick octave jumps
  if (a >= 5)  return sg * 5;
  if (a >= 2)  return sg * 2;
  return sg;
}

static int16_t delayStepMsFromEncoder(int16_t v) {
  const int16_t sg = encSign(v);
  if (!sg) return 0;
  const uint8_t a = encAbs16(v);
  if (a >= 10) return sg * 100;
  if (a >= 5)  return sg * 50;
  if (a >= 2)  return sg * 20;
  return sg * 10;
}

static int16_t percentStepFromEncoder(int16_t v) {
  const int16_t sg = encSign(v);
  if (!sg) return 0;
  const uint8_t a = encAbs16(v);
  if (a >= 10) return sg * 10;
  if (a >= 5)  return sg * 5;
  if (a >= 2)  return sg * 2;
  return sg;
}


static int16_t triggerLevelStepFromEncoder(int16_t v) {
  return encSign(v);
}

static inline uint32_t phxNonZero(uint32_t v) { return v == 0 ? 1UL : v; }

static void phxNoteName(uint8_t note, char *out, size_t n) {
  static const char * const names[12] = {"C", "C#", "D", "D#", "E", "F", "F#", "G", "G#", "A", "A#", "B"};
  int octave = (int)(note / 12) - 2;  // MIDI 60 = C3 for this project
  snprintf(out, n, "%s%d", names[note % 12], octave);
}

static const char* phxAudioWaveName(uint8_t w) {
  switch (w) {
    case 0: return "SINE";
    case 1: return "TRIANGLE";
    case 2: return "SAW";
    case 3: return "SQUARE";
    case 4: return "WHITE NOISE";
    default: return "SINE";
  }
}

static int16_t audioFreqStepFromEncoder(int16_t v) {
  const int16_t sg = encSign(v);
  if (!sg) return 0;
  const uint8_t a = encAbs16(v);
  if (a >= 10) return sg * 1000;
  if (a >= 5)  return sg * 500;
  if (a >= 2)  return sg * 100;
  return sg * 10;
}

static int16_t audioLevelStepFromEncoder(int16_t v) {
  const int16_t sg = encSign(v);
  if (!sg) return 0;
  const uint8_t a = encAbs16(v);
  if (a >= 10) return sg * 10;
  if (a >= 5)  return sg * 5;
  if (a >= 2)  return sg * 2;
  return sg;
}


static const char* const SELF_ITEMS[] = {
  "AUDIO OUTPUT TEST",
  "AUDIO INPUT TEST",
  "BUTTON TEST",
  "SYSTEM DIAGNOSTICS",
  "START SAMPLER"
};

static const char* const AUDIO_OUT_ITEMS[] = {
  "EXIT",
  "440HZ SINE",
  "440HZ SAW",
  "440HZ SQUARE",
  "WHITE NOISE",
  "AUDIO THROUGH"
};

static const char* const MAIN_ITEMS[] = {
  "SOUND SAMPLING",
  "QUATTRO SAMPLING",
  "PITCH CONVERTER",
  "EFFECTS",
  "DISK UTILITIES",
  "VINTAGE SAMPLER",
  "STEP SEQUENCER",
  "MIDI CONTROL"
};

static const char* const MIDI_CONTROL_ITEMS[] = {
  "MIDI INPUT",
  "MIDI CLOCK",
  "NOTE TRIGGER",
  "CC CONTROL",
  "PROGRAM CHG",
  "MIDI CHANNEL",
  "MIDI MONITOR",
  "RESET DEFAULTS"
};

static const char* const SOUND_ITEMS[] = {
  "RECORD",
  "REPLAY FORWARD",
  "REPLAY BACKWARD",
  "DRAW WAVEFORM",
  "SAMPLE EDITOR",
  "TRIGGER LEVEL",
  "LOOP",
  "EXIT"
};

static const char* const DISK_ITEMS[] = {
  "LOAD BANK",
  "SAVE BANK",
  "DELETE BANK",
  "NEW BANK",
  "WAV IMPORT",
  "USB MASS STORAGE"
};



static const char *PHX_ROOT_DIR = "/PHOENIX";
static const char *PHX_BANKS_DIR = "/PHOENIX/BANKS";
static const char *PHX_WAV_DIR = "/PHOENIX/WAV";
static const char *PHX_EXPORT_DIR = "/PHOENIX/EXPORT";
static const char *PHX_CONFIG_PATH = "/PHOENIX/CONFIG.TXT";

static bool phxIsWavName(const char *name) {
  if (!name) return false;
  const char *dot = strrchr(name, '.');
  return dot && !strcasecmp(dot, ".WAV");
}

static const char* phxBaseName(const char *path) {
  if (!path) return "";
  const char *a = strrchr(path, '/');
  return a ? a + 1 : path;
}

static bool phxIsHiddenOrSystemName(const char *name) {
  if (!name || !name[0]) return true;
  if (name[0] == '.') return true;
  if (!strcasecmp(name, "Thumbs.db")) return true;
  return false;
}

static bool phxBrowserShowName(const char *name, bool isDir) {
  if (phxIsHiddenOrSystemName(name)) return false;
  if (isDir) return true;
  return phxIsWavName(name);
}


static uint16_t phxReadLE16(const uint8_t *p) {
  return (uint16_t)p[0] | ((uint16_t)p[1] << 8);
}

static uint32_t phxReadLE32(const uint8_t *p) {
  return (uint32_t)p[0] | ((uint32_t)p[1] << 8) | ((uint32_t)p[2] << 16) | ((uint32_t)p[3] << 24);
}

static void phxFormatDurationTenths(uint16_t tenths, char *out, size_t n) {
  if (!out || n == 0) return;
  uint16_t sec = tenths / 10;
  uint16_t t = tenths % 10;
  snprintf(out, n, "%u.%us", (unsigned)sec, (unsigned)t);
}

static void phxJoinPath(const char *base, const char *name, char *out, size_t outLen) {
  if (!out || outLen == 0) return;
  out[0] = 0;
  if (!base || !base[0]) base = PHX_WAV_DIR;
  snprintf(out, outLen, "%s%s%s", base, (base[strlen(base)-1] == '/') ? "" : "/", name ? name : "");
}

static bool phxIsWavRoot(const char *path) {
  return path && !strcmp(path, PHX_WAV_DIR);
}

static bool phxParentPath(char *path, size_t n) {
  if (!path || !path[0] || phxIsWavRoot(path)) return false;
  char *slash = strrchr(path, '/');
  if (!slash) return false;
  if (slash <= path + strlen(PHX_WAV_DIR)) {
    strncpy(path, PHX_WAV_DIR, n);
    path[n-1] = 0;
    return true;
  }
  *slash = 0;
  if (strlen(path) < strlen(PHX_WAV_DIR)) {
    strncpy(path, PHX_WAV_DIR, n);
    path[n-1] = 0;
  }
  return true;
}

static void phxMakeBreadcrumb(const char *path, char *out, size_t n) {
  if (!out || n == 0) return;
  out[0] = 0;
  if (!path || !path[0] || !strcmp(path, PHX_WAV_DIR)) {
    strncpy(out, "WAV", n);
    out[n-1] = 0;
    return;
  }
  const char *p = path;
  if (!strncmp(p, PHX_WAV_DIR, strlen(PHX_WAV_DIR))) p += strlen(PHX_WAV_DIR);
  while (*p == '/') ++p;
  strncpy(out, "WAV", n);
  out[n-1] = 0;
  char temp[128];
  strncpy(temp, p, sizeof(temp));
  temp[sizeof(temp)-1] = 0;
  char *tok = strtok(temp, "/");
  while (tok) {
    if (strlen(out) + strlen(tok) + 4 >= n) {
      strncpy(out, "...", n);
      out[n-1] = 0;
      // keep last folder when too long
      strncat(out, " > ", n - strlen(out) - 1);
      strncat(out, tok, n - strlen(out) - 1);
    } else {
      strncat(out, " > ", n - strlen(out) - 1);
      strncat(out, tok, n - strlen(out) - 1);
    }
    tok = strtok(NULL, "/");
  }
}

static bool phxSdReadyForConfig() {
  // v0.7.36a: Keep the screen/browser SD state recoverable as well.
  // Previously a failed SD.begin() during boot was cached forever here,
  // even though PhoenixOS could later reinitialize the same card. This made
  // bank access work after hot insertion while WAV IMPORT still reported
  // "SD NOT READY" until reset.
  static bool ok = false;
  static uint32_t lastTryMs = 0;
  const uint32_t now = millis();

  if (SD.cardType() != CARD_NONE) { ok = true; return true; }
  ok = false;
  if (lastTryMs != 0 && (uint32_t)(now - lastTryMs) < 2000UL) return false;

  lastTryMs = now;
  ok = SD.begin(9, SPI, 10000000UL);
  return ok;
}

static void phxEnsureDir(const char *path) {
  if (!SD.exists(path)) SD.mkdir(path);
}

static bool phxBoolFromText(const char *v, bool def) {
  if (!v) return def;
  if (!strcasecmp(v, "1") || !strcasecmp(v, "ON") || !strcasecmp(v, "TRUE") || !strcasecmp(v, "YES")) return true;
  if (!strcasecmp(v, "0") || !strcasecmp(v, "OFF") || !strcasecmp(v, "FALSE") || !strcasecmp(v, "NO")) return false;
  return def;
}

static void phxTrim(char *s) {
  if (!s) return;
  char *p = s;
  while (*p == ' ' || *p == '\t' || *p == '\r' || *p == '\n') ++p;
  if (p != s) memmove(s, p, strlen(p) + 1);
  size_t n = strlen(s);
  while (n && (s[n-1] == ' ' || s[n-1] == '\t' || s[n-1] == '\r' || s[n-1] == '\n')) s[--n] = 0;
}

void PhoenixScreenManager::loadSystemSettings() {
  // v0.7.13c FIX8C: global device settings live in /PHOENIX/CONFIG.TXT.
  // If SD/config is unavailable, constructor defaults remain active.
  if (!phxSdReadyForConfig()) return;

  phxEnsureDir(PHX_ROOT_DIR);
  phxEnsureDir(PHX_BANKS_DIR);
  phxEnsureDir(PHX_WAV_DIR);
  phxEnsureDir(PHX_EXPORT_DIR);

  if (!SD.exists(PHX_CONFIG_PATH)) {
    saveSystemSettings();
    return;
  }

  File f = SD.open(PHX_CONFIG_PATH, FILE_READ);
  if (!f) return;

  char line[96];
  size_t pos = 0;
  while (f.available()) {
    char c = (char)f.read();
    if (c == '\n' || pos >= sizeof(line) - 1) {
      line[pos] = 0;
      pos = 0;
      phxTrim(line);
      if (line[0] && line[0] != '#') {
        char *eq = strchr(line, '=');
        if (eq) {
          *eq = 0;
          char *key = line;
          char *val = eq + 1;
          phxTrim(key);
          phxTrim(val);
          if (!strcasecmp(key, "MIDI_CHANNEL")) {
            int v = atoi(val);
            if (v >= 1 && v <= 16) _midiChannel = (uint8_t)v;
          } else if (!strcasecmp(key, "MIDI_INPUT")) {
            _midiEnabled = phxBoolFromText(val, _midiEnabled);
          } else if (!strcasecmp(key, "MIDI_CLOCK")) {
            _midiClockEnabled = phxBoolFromText(val, _midiClockEnabled);
          } else if (!strcasecmp(key, "NOTE_TRIGGER")) {
            _midiNoteEnabled = phxBoolFromText(val, _midiNoteEnabled);
          } else if (!strcasecmp(key, "CC_CONTROL")) {
            _midiCcEnabled = phxBoolFromText(val, _midiCcEnabled);
          } else if (!strcasecmp(key, "PROGRAM_CHANGE")) {
            _midiPcEnabled = phxBoolFromText(val, _midiPcEnabled);
          } else if (!strcasecmp(key, "TRIGGER_MODE")) {
            _triggerAuto = !strcasecmp(val, "AUTO") || !strcasecmp(val, "1") || !strcasecmp(val, "ON");
          } else if (!strcasecmp(key, "TRIGGER_LEVEL")) {
            int v = atoi(val);
            if (v < 1) v = 1;
            if (v > 8) v = 8;
            _triggerLevel = (uint8_t)v;
          } else if (!strcasecmp(key, "SMART_MODE")) {
            if (!strcasecmp(val, "SMART") || !strcmp(val, "1")) _smartProcessingMode = 1U;
            else if (!strcasecmp(val, "FORCE") || !strcmp(val, "2")) _smartProcessingMode = 2U;
            else _smartProcessingMode = 0U;
          }
        }
      }
    } else if (c != '\r') {
      line[pos++] = c;
    }
  }
  if (pos) {
    line[pos] = 0;
    phxTrim(line);
    if (line[0] && line[0] != '#') {
      char *eq = strchr(line, '=');
      if (eq) {
        *eq = 0;
        char *key = line;
        char *val = eq + 1;
        phxTrim(key);
        phxTrim(val);
        if (!strcasecmp(key, "MIDI_CHANNEL")) {
          int v = atoi(val);
          if (v >= 1 && v <= 16) _midiChannel = (uint8_t)v;
        } else if (!strcasecmp(key, "MIDI_INPUT")) {
          _midiEnabled = phxBoolFromText(val, _midiEnabled);
        } else if (!strcasecmp(key, "MIDI_CLOCK")) {
          _midiClockEnabled = phxBoolFromText(val, _midiClockEnabled);
        } else if (!strcasecmp(key, "NOTE_TRIGGER")) {
          _midiNoteEnabled = phxBoolFromText(val, _midiNoteEnabled);
        } else if (!strcasecmp(key, "CC_CONTROL")) {
          _midiCcEnabled = phxBoolFromText(val, _midiCcEnabled);
        } else if (!strcasecmp(key, "PROGRAM_CHANGE")) {
          _midiPcEnabled = phxBoolFromText(val, _midiPcEnabled);
        } else if (!strcasecmp(key, "TRIGGER_MODE")) {
          _triggerAuto = !strcasecmp(val, "AUTO") || !strcasecmp(val, "1") || !strcasecmp(val, "ON");
        } else if (!strcasecmp(key, "TRIGGER_LEVEL")) {
          int v = atoi(val);
          if (v < 1) v = 1;
          if (v > 8) v = 8;
          _triggerLevel = (uint8_t)v;
        } else if (!strcasecmp(key, "SMART_MODE")) {
          if (!strcasecmp(val, "SMART") || !strcmp(val, "1")) _smartProcessingMode = 1U;
          else if (!strcasecmp(val, "FORCE") || !strcmp(val, "2")) _smartProcessingMode = 2U;
          else _smartProcessingMode = 0U;
        }
      }
    }
  }
  f.close();

  if (_midiChannel < 1 || _midiChannel > 16) _midiChannel = 1;
  if (_triggerLevel < 1) _triggerLevel = 1;
  if (_triggerLevel > 8) _triggerLevel = 8;
}

void PhoenixScreenManager::saveSystemSettings() {
  // v0.7.13c FIX8C: CONFIG.TXT is the single normal persistence backend.
  // No NVS writes. If SD is missing, defaults remain RAM-only for this boot.
  if (!phxSdReadyForConfig()) return;

  phxEnsureDir(PHX_ROOT_DIR);
  phxEnsureDir(PHX_BANKS_DIR);
  phxEnsureDir(PHX_WAV_DIR);
  phxEnsureDir(PHX_EXPORT_DIR);

  if (SD.exists(PHX_CONFIG_PATH)) SD.remove(PHX_CONFIG_PATH);
  File f = SD.open(PHX_CONFIG_PATH, FILE_WRITE);
  if (!f) return;

  f.println("# Project Phoenix Configuration");
  f.println("VERSION=2");
  f.println();
  f.print("MIDI_CHANNEL="); f.println(_midiChannel);
  f.print("MIDI_INPUT="); f.println(_midiEnabled ? "ON" : "OFF");
  f.print("MIDI_CLOCK="); f.println(_midiClockEnabled ? "ON" : "OFF");
  f.print("NOTE_TRIGGER="); f.println(_midiNoteEnabled ? "ON" : "OFF");
  f.print("CC_CONTROL="); f.println(_midiCcEnabled ? "ON" : "OFF");
  f.print("PROGRAM_CHANGE="); f.println(_midiPcEnabled ? "ON" : "OFF");
  f.println();
  f.print("TRIGGER_MODE="); f.println(_triggerAuto ? "AUTO" : "MANUAL");
  f.print("TRIGGER_LEVEL="); f.println(_triggerLevel);
  f.print("SMART_MODE=");
  f.println(_smartProcessingMode == 1U ? "SMART" : (_smartProcessingMode == 2U ? "FORCE" : "SAFE"));
  f.close();
}

void PhoenixScreenManager::saveMidiControlSettings() {
  saveSystemSettings();
}

void PhoenixScreenManager::saveMidiChannelSetting() {
  saveSystemSettings();
}

void PhoenixScreenManager::saveTriggerSettings() {
  saveSystemSettings();
}

PhoenixScreenManager::PhoenixScreenManager()
: _screen(SCR_BOOT), _diagnosticsReturnScreen(SCR_MAIN), _sel(0), _bootStart(0), _about(false), _overwriteConfirm(false), _overwriteSlot(0), _recordReturnScreen(SCR_SOUND), _recordCompleteSlot(0), _recordCompleteSaveState(-1), _serviceMode(false), _toneRequest(-1), _audioTestParam(0), _audioTestEditMode(false), _audioTestWaveform(0), _audioTestFreqHz(440), _audioTestLevelDb(-12), _audioTestOutput(false), _audioTestChanged(false),
  _recordRequest(false), _playRequest(false), _reversePlayRequest(false), _playFromCursorRequest(false), _playFromCursorFrame(0), _stopRequest(false), _selectSlotRequest(-1),
  _pitchParam(0), _pitchEditMode(false), _pitchChanged(false), _envParam(0), _envEditMode(false), _envChanged(false), _echoParam(0), _reverbParam(0), _reverbSize(55), _reverbDecay(55), _reverbDamp(45), _reverbMix(20), _echoDelayMs(250), _echoFeedback(35), _echoMix(20), _echoChanged(false), _echoEditMode(false), _reverbChanged(false), _reverbEditMode(false),
  _vintageParam(0), _vintageEditMode(false), _vintageChanged(false), _quattroMode(1), _quattroParam(0), _quattroEditMode(false), _quattroChanged(false), _voiceParam(0), _voiceEditMode(false), _voiceChanged(false), _mixerParam(0), _mixerEditMode(false), _mixerChanged(false), _filterParam(0), _filterEditMode(false), _filterChanged(false), _filterEnvParam(0), _filterEnvEditMode(false), _filterEnvChanged(false), _msSlot(0), _msGroup(0), _msLayer(0), _msParam(0), _msEditMode(false), _msChanged(false), _msPath(nullptr), _keygroupImportMode(false), _keygroupImportRequest(false), _keygroupDeleteRequest(false), _autoMapBrowserMode(false), _autoMapRequest(false), _autoMapSlot(0), _keygroupTargetSlot(0), _keygroupTargetGroup(0), _keygroupTargetLayer(0), _keygroupTargetVariant(0), _midiType(1), _midiChannel(1), _midiEnabled(true), _midiOmni(false), _midiClockEnabled(true), _midiNoteEnabled(true), _midiCcEnabled(true), _midiPcEnabled(true), _midiEditMode(false), _loopChanged(false), _loopRangeChanged(false), _sampleRangeChanged(false), _sampleMarkerEditPending(false), _sampleMarkerEditSlot(0), _sampleMarkerEditSampleStart(0), _sampleMarkerEditLoopStart(0), _sampleMarkerEditLoopEnd(0), _sampleMarkerEditSampleEnd(0), _zeroCrossSnapPending(false), _sampleProcessingAction(-1), _sampleProcessingSlot(0), _zeroCrossSnapSlot(0), _zeroCrossSnapMarker(0), _zeroCrossSnapFrame(0), _loopParam(0), _loopEditMode(false), _editorCursor(0), _editorMarker(0), _sampleEditorPlayRequest(false), _sampleEditorPlayStart(0), _sampleEditorPlayEnd(0), _sampleEditorPlayReverse(false), _triggerChanged(false), _triggerAuto(false), _triggerLevel(4), _smartProcessingMode(0), _triggerParam(0), _triggerEditMode(false), _triggerTestActive(false), _triggerTestAbove(false), _triggerTestPrevAbove(false), _triggerTestTrigUntilMs(0), _recUxStatus(0), _recUxUntilMs(0), _recUxPrevWaiting(false), _recUxPrevActive(false), _diskAction(-1), _usbStorageAction(-1), _usbStorageActive(false), _usbStorageAvailable(true), _usbStorageWritable(false), _usbStorageEjected(false), _usbStorageReadWriteSelected(false), _usbStorageExitConfirm(false), _activeBank(1), _diskBank(1), _diskBankUsed(false), _diskBankSelectAction(-1), _bankDirty(false), _diskConfirmAction(-1), _browserCount(0), _browserSel(0), _browserCacheValid(false), _browserImportState(0), _browserImportSlot(0), _browserImportRequest(false), _browserPreviewRequest(false), _browserPreviewStopRequest(false),
  _diagnosticsResetRequest(false), _diagnosticsLogRequest(false), _diagnosticsStatusUntilMs(0), _diagnosticsLastAction(0), _diagElapsedMs(0), _diagVoices(0), _diagVoiceCapacity(12), _diagVoicePeak(0), _diagAudioAvgUs(0), _diagAudioPeakUs(0), _diagRiskCount(0), _diagOverrunCount(0), _diagUnderruns(0), _diagVoiceSteals(0), _diagHeapFreeKb(0), _diagHeapMinKb(0), _diagPsramFreeKb(0),
  _psramOk(false), _audioOk(false), _psramKb(0), _midiBytes(0), _underruns(0), _clipCount(0),
  _encSeen(false), _encSwSeen(false),
  _midiLearnActive(false), _midiLearnRequest(false), _midiLearnParam(PHX_PAR_SLOT_VOLUME), _midiLearnResultCc(255), _midiLearnResultAssigned(false), _midiLearnResultUntilMs(0), _midiLearnMenu(false), _midiLearnMenuSel(0), _midiResetConfirm(false), _recording(false), _selectedSlot(0), _playing(false), _playingReverse(false), _sampleReady(false), _sampleFrames(0), _recordFrames(0), _recordCapacityFrames(0), _playFrames(0), _samplePlayheadActive(false), _samplePlayheadFrame(0), _waveCursorFrame(0), _waveZoom(1), _editorZoom(1), _sampleRate(32000), _dcL(0), _dcR(0) {
  for (uint8_t i = 0; i < 4; ++i) { _quattroKeyLow[i] = i * 32; _quattroKeyHigh[i] = (i == 3) ? 127 : (i * 32 + 31); _quattroMidiChannel[i] = phxDefaultMultiChannel(_midiChannel, i); _pitchSemitone[i] = 0; _pitchFineCent[i] = 0; _pitchRootNote[i] = 60; _keyboardOctave[i] = 0; _pitchTrack[i] = true; _pitchBendRange[i] = 2; _envAttackMs[i] = 5; _envDecayMs[i] = 80; _envSustainPct[i] = 100; _envReleaseMs[i] = 80; _vintagePreset[i] = 0; _vintageRate[i] = 0; _vintageBits[i] = 0; _vintageFilter[i] = 0; _vintageJitter[i] = 0; _echoSend[i] = 0; _reverbSend[i] = 0; _mixerLevel[i]=100; _mixerPan[i]=0; _voiceMode[i]=0; _voiceLimit[i]=12; _notePriority[i]=0; _glideMs[i]=0; _slotTrimEnabled[i]=false; _slotDcEnabled[i]=false; _slotNormalizeEnabled[i]=false; }
  memset(_btnSeen, 0, sizeof(_btnSeen));
  _analysisPeakPercent = 0;
  _analysisTrimApplied = false;
  _analysisDcDetected = false;
  _analysisSuggestedStart = 0;
  _analysisSuggestedEnd = 0;
  memset(_slotRecorded, 0, sizeof(_slotRecorded));
  memset(_slotRecording, 0, sizeof(_slotRecording));
  memset(_slotPlaying, 0, sizeof(_slotPlaying));
  memset(_slotFrames, 0, sizeof(_slotFrames));
  memset(_slotLoop, 0, sizeof(_slotLoop));
  memset(_slotLoopMode, 0, sizeof(_slotLoopMode));
  memset(_slotLoopXfadeMs, 0, sizeof(_slotLoopXfadeMs));
  memset(_slotLoopStart, 0, sizeof(_slotLoopStart));
  memset(_slotLoopEnd, 0, sizeof(_slotLoopEnd));
  memset(_slotSampleStart, 0, sizeof(_slotSampleStart));
  memset(_slotSampleEnd, 0, sizeof(_slotSampleEnd));
  strncpy(_usbStorageStatus, "USB STORAGE READY", sizeof(_usbStorageStatus));
  _usbStorageStatus[sizeof(_usbStorageStatus)-1] = 0;
  strncpy(_diskStatus, "BANK 01 CHECK", sizeof(_diskStatus));
  _diskStatus[sizeof(_diskStatus)-1] = 0;
  _browserStatus[0] = 0;
  _msLoadStatus[0] = 0;
  strncpy(_browserPath, PHX_WAV_DIR, sizeof(_browserPath));
  _browserPath[sizeof(_browserPath)-1] = 0;
  _browserImportPath[0] = 0;
  _browserPreviewPath[0] = 0;
  _autoMapFolder[0] = 0;
  for (uint8_t i = 0; i < PHX_BROWSER_MAX; ++i) { _browserEntries[i].name[0] = 0; _browserEntries[i].isDir = false; _browserEntries[i].size = 0; _browserEntries[i].wavInfoValid = false; _browserEntries[i].wavInfoScanned = false; }
  for(uint8_t i=0;i<4;++i){_filterCutoff[i]=100;_filterResonance[i]=0;_filterEnvAmount[i]=0;_filterVelocity[i]=0;_filterKeytrack[i]=0;_filterAttackMs[i]=0;_filterDecayMs[i]=250;_filterSustainPct[i]=0;_filterReleaseMs[i]=300;}
  for(uint8_t s=0;s<4;++s)for(uint8_t g=0;g<16;++g){_msEnabled[s][g]=false;_msLow[s][g]=0;_msHigh[s][g]=127;_msRoot[s][g]=60;_msTranspose[s][g]=0;_msFineCent[s][g]=0;_msKeytrackPct[s][g]=100;for(uint8_t l=0;l<3;++l){_msLayerEnabled[s][g][l]=false;_msVelLow[s][g][l]=(l==0)?1:(uint8_t)(l*43+1);_msVelHigh[s][g][l]=(l==2)?127:(uint8_t)((l+1)*43);_msLevel[s][g][l]=100;_msPan[s][g][l]=0;_msRrMode[s][g][l]=0;_msRrCount[s][g][l]=0;_msLoopMode[s][g][l]=0;_msLoopStartPct[s][g][l]=20;_msLoopEndPct[s][g][l]=80;_msLoopXfadeMs[s][g][l]=0;_msVelToLevel[s][g][l]=100;_msVelToFilter[s][g][l]=0;}}
  _seqPendingClick=0; _seqPendingClickMs=0; _seqQuickTrackUntilMs=0;
    _seqRun=false; _seqEditMode=false; _seqTrack=0; _seqStep=0; _seqParam=0; _seqPattern=0; _patternAction=0; _patternTarget=1; _seqBpm=120; _seqExternalClock=false; _seqExternalClockPresent=false; _seqExternalBpm=120; _seqPreviewRequest=false; _seqPreviewTrack=0; _seqPreviewNote=60; _seqPreviewVelocity=100;
  _songEditPos=0; _songEditField=0; _songAction=0; _songLoopMode=1; _songLoopStart=0; _songLoopEnd=0; _songDataChanged=false; _songPlayRequest=false; _songStopRequest=false; _songSaveRequest=false; _songPlaying=false; _songPlayPos=0; _songPlayRepeat=0; _songPlayRepeatTarget=1;
  for(uint8_t i=0;i<16;++i){_songPattern[i]=0;_songRepeats[i]=1;_songEnd[i]=true;} _songEnd[0]=false;
  for(uint8_t t=0;t<4;++t) _seqPlayhead[t]=0;
  for(uint8_t p=0;p<4;++p) for(uint8_t t=0;t<4;++t){
    _seqLength[p][t]=16;
    for(uint8_t st=0;st<16;++st){_seqOn[p][t][st]=false;_seqNote[p][t][st]=60+(t*2);_seqVelocity[p][t][st]=100;_seqGate[p][t][st]=50;}
  }
  _seqOn[0][0][0]=true; _seqOn[0][0][8]=true;
  _seqOn[0][1][4]=true; _seqOn[0][1][12]=true;
  for(uint8_t st=0;st<16;st+=2) _seqOn[0][2][st]=true;
}

void PhoenixScreenManager::restoreSessionView(uint8_t screen, uint8_t slot) {
  _selectedSlot = slot & 3U;
  // Restore only stable work pages; transient dialogs, boot and service pages fall back to main.
  if (screen >= (uint8_t)SCR_MAIN && screen <= (uint8_t)SCR_SONG_EDITOR &&
      screen != (uint8_t)SCR_SAMPLE_BROWSER && screen != (uint8_t)SCR_PATTERN_MANAGER &&
      screen != (uint8_t)SCR_DIAGNOSTICS) {
    go((ScreenID)screen);
  } else {
    go(SCR_MAIN);
  }
}

void PhoenixScreenManager::selectSequencerTrack(uint8_t track) {
  _seqTrack = track & 3U;
  const uint8_t len = _seqLength[_seqPattern][_seqTrack] ? _seqLength[_seqPattern][_seqTrack] : 1U;
  if (_seqStep >= len) _seqStep = (uint8_t)(len - 1U);
  _seqQuickTrackUntilMs = millis() + 350UL;
}

bool PhoenixScreenManager::consumeSequencerPreviewRequest(uint8_t &track, uint8_t &note, uint8_t &velocity) {
  if (!_seqPreviewRequest) return false;
  track = _seqPreviewTrack & 3;
  note = _seqPreviewNote;
  velocity = _seqPreviewVelocity;
  _seqPreviewRequest = false;
  return true;
}


void PhoenixScreenManager::clearSequencerPattern() {
  _seqRun=false; _seqPattern=0; _seqStep=0; _seqTrack=0; _seqParam=0; _seqBpm=120;
  _seqExternalClock=false; _seqExternalClockPresent=false; _seqExternalBpm=120; _seqPreviewRequest=false;
  for(uint8_t t=0;t<4;++t) _seqPlayhead[t]=0;
  for(uint8_t p=0;p<4;++p) for(uint8_t t=0;t<4;++t){
    _seqLength[p][t]=16;
    for(uint8_t st=0;st<16;++st){
      _seqOn[p][t][st]=false; _seqNote[p][t][st]=(uint8_t)(60+t*2); _seqVelocity[p][t][st]=100; _seqGate[p][t][st]=50;
    }
  }
}

bool PhoenixScreenManager::saveSequencerConfig(const char *bankDir) const {
  if(!bankDir||!*bankDir) return false;
  char path[192],tmp[192],bak[192];
  snprintf(path,sizeof(path),"%s/PATTERNS.CFG",bankDir); snprintf(tmp,sizeof(tmp),"%s/PATTERNS.TMP",bankDir); snprintf(bak,sizeof(bak),"%s/PATTERNS.BAK",bankDir);
  SD.remove(tmp);
  delay(1); // C036b: SD metadata operation must allow IDLE0 to run.
  File f=SD.open(tmp,FILE_WRITE); if(!f) return false;
  f.println("VERSION=1"); f.print("CURRENT_PATTERN=");f.println((unsigned)(_seqPattern+1)); f.print("CLOCK_MODE=");f.println(_seqExternalClock?"EXT":"INT"); f.print("BPM=");f.println((unsigned)_seqBpm);
  uint16_t linesSinceYield = 0;
  for(uint8_t p=0;p<4;++p){ f.println(); f.print("[P");f.print((unsigned)(p+1));f.println("]");
    for(uint8_t t=0;t<4;++t){ f.print("TRACK");f.print((unsigned)(t+1));f.print("_LENGTH=");f.println((unsigned)_seqLength[p][t]);
      for(uint8_t st=0;st<16;++st){ f.print("T");f.print((unsigned)(t+1));f.print("_STEP");if(st<9)f.print('0');f.print((unsigned)(st+1));f.print('=');
        f.print(_seqOn[p][t][st]?1:0);f.print(',');f.print((unsigned)_seqNote[p][t][st]);f.print(',');f.print((unsigned)_seqVelocity[p][t][st]);f.print(',');f.println((unsigned)_seqGate[p][t][st]);
        // C036b: many tiny FAT/SPI writes can monopolize PhoenixControl for seconds
        // on a slow/fragmented card. A real 1-tick sleep every eight step records
        // guarantees IDLE0 gets CPU time and keeps the task watchdog serviced.
        if (++linesSinceYield >= 8U) { linesSinceYield = 0; delay(1); }
      }
      delay(1);
    }
  }
  f.flush();
  delay(1);
  f.close();
  SD.remove(bak); delay(1);
  if(SD.exists(path)){ if(!SD.rename(path,bak)) return false; delay(1); }
  if(!SD.rename(tmp,path)){if(SD.exists(bak))SD.rename(bak,path);return false;}
  delay(1);
  return true;
}

bool PhoenixScreenManager::loadSequencerFile(const char *path) {
  File f = SD.open(path, FILE_READ);
  if (!f) return false;

  clearSequencerPattern();
  uint8_t track = 0xFF;
  bool sawVersion = false;
  bool sawStep = false;
  while (f.available()) {
    String line = f.readStringUntil('\n');
    line.trim();
    if (!line.length() || line[0] == ';' || line[0] == '#') continue;
    if (line == "VERSION=1" || line == "VERSION=2") { sawVersion = true; continue; }
    if (line.startsWith("CLOCK_MODE=")) {
      String v = line.substring(11); v.trim(); v.toUpperCase();
      _seqExternalClock = (v == "EXT");
      continue;
    }
    if (line.startsWith("BPM=")) {
      int v = line.substring(4).toInt();
      _seqBpm = (uint16_t)constrain(v, 40, 240);
      continue;
    }
    if (line.startsWith("[TRACK") && line.endsWith("]")) {
      int n = line.substring(6, line.length() - 1).toInt();
      track = (n >= 1 && n <= 4) ? (uint8_t)(n - 1) : 0xFF;
      continue;
    }
    if (track < 4 && line.startsWith("LENGTH=")) {
      _seqLength[_seqPattern][track] = (uint8_t)constrain(line.substring(7).toInt(), 1, 16);
      continue;
    }
    if (track < 4 && line.startsWith("STEP")) {
      int eq = line.indexOf('=');
      if (eq < 0) continue;
      int n = line.substring(4, eq).toInt();
      if (n < 1 || n > 16) continue;
      String data = line.substring(eq + 1);
      int c1 = data.indexOf(',');
      int c2 = (c1 >= 0) ? data.indexOf(',', c1 + 1) : -1;
      int c3 = (c2 >= 0) ? data.indexOf(',', c2 + 1) : -1;
      if (c1 < 0 || c2 < 0 || c3 < 0) continue;
      const uint8_t st = (uint8_t)(n - 1);
      _seqOn[_seqPattern][track][st] = data.substring(0, c1).toInt() != 0;
      _seqNote[_seqPattern][track][st] = (uint8_t)constrain(data.substring(c1 + 1, c2).toInt(), 0, 127);
      _seqVelocity[_seqPattern][track][st] = (uint8_t)constrain(data.substring(c2 + 1, c3).toInt(), 1, 127);
      _seqGate[_seqPattern][track][st] = (uint8_t)constrain(data.substring(c3 + 1).toInt(), 10, 100);
      sawStep = true;
    }
  }
  f.close();
  _seqRun = false;
  for (uint8_t t = 0; t < 4; ++t) _seqPlayhead[t] = 0;
  return sawVersion && sawStep;
}

bool PhoenixScreenManager::loadSequencerConfig(const char *bankDir) {
  if(!bankDir||!*bankDir) return false; clearSequencerPattern();
  char path[192]; snprintf(path,sizeof(path),"%s/PATTERNS.CFG",bankDir); File f=SD.open(path,FILE_READ);
  if(!f){
    snprintf(path,sizeof(path),"%s/SEQUENCER.CFG",bankDir);
    if (!SD.exists(path)) {
      // Older audio-only and multisample-only banks are valid projects.
      // Missing pattern data means an empty P1..P4 set, not LOAD FAILED.
      _seqRun=false; _seqPattern=0; _seqStep=0; _seqBpm=120; _seqExternalClock=false;
      for(uint8_t t=0;t<4;++t)_seqPlayhead[t]=0;
      return true;
    }
    return loadSequencerFile(path);
  }
  int pat=-1;
  while(f.available()){
    String line=f.readStringUntil('\n');line.trim();if(!line.length()||line[0]=='#')continue;
    if(line.startsWith("[P")&&line.endsWith("]")){pat=constrain(line.substring(2,line.length()-1).toInt()-1,0,3);continue;}
    if(line.startsWith("CURRENT_PATTERN=")){_seqPattern=(uint8_t)constrain(line.substring(16).toInt()-1,0,3);continue;}
    if(line.startsWith("CLOCK_MODE=")){_seqExternalClock=line.substring(11)=="EXT";continue;}
    if(line.startsWith("BPM=")){_seqBpm=(uint16_t)constrain(line.substring(4).toInt(),40,240);continue;}
    if(pat<0)continue;
    if(line.startsWith("TRACK")&&line.indexOf("_LENGTH=")>0){int u=line.indexOf('_');int t=constrain(line.substring(5,u).toInt()-1,0,3);_seqLength[pat][t]=(uint8_t)constrain(line.substring(line.indexOf('=')+1).toInt(),1,16);continue;}
    if(line[0]=='T'){int sep=line.indexOf("_STEP"),eq=line.indexOf('=');if(sep<0||eq<0)continue;int t=constrain(line.substring(1,sep).toInt()-1,0,3),st=constrain(line.substring(sep+5,eq).toInt()-1,0,15);String d=line.substring(eq+1);int c1=d.indexOf(','),c2=d.indexOf(',',c1+1),c3=d.indexOf(',',c2+1);if(c1<0||c2<0||c3<0)continue;_seqOn[pat][t][st]=d.substring(0,c1).toInt()!=0;_seqNote[pat][t][st]=(uint8_t)constrain(d.substring(c1+1,c2).toInt(),0,127);_seqVelocity[pat][t][st]=(uint8_t)constrain(d.substring(c2+1,c3).toInt(),1,127);_seqGate[pat][t][st]=(uint8_t)constrain(d.substring(c3+1).toInt(),10,100);}
  }
  f.close();_seqRun=false;_seqStep=0;for(uint8_t t=0;t<4;++t)_seqPlayhead[t]=0;return true;
}


void PhoenixScreenManager::setSongEntryStatus(uint8_t index,uint8_t pattern,uint8_t repeats,bool end){if(index>=16)return;_songPattern[index]=pattern&3U;_songRepeats[index]=(uint8_t)constrain((int)repeats,1,16);_songEnd[index]=end;}
void PhoenixScreenManager::setSongLoopStatus(uint8_t mode,uint8_t start,uint8_t end){_songLoopMode=(uint8_t)constrain((int)mode,0,2);_songLoopStart=start&15U;_songLoopEnd=end&15U;if(_songLoopEnd<_songLoopStart)_songLoopEnd=_songLoopStart;}
void PhoenixScreenManager::setSongPlaybackStatus(bool playing,uint8_t position,uint8_t repeatIndex,uint8_t repeatTarget){_songPlaying=playing;_songPlayPos=position&15U;_songPlayRepeat=repeatIndex;_songPlayRepeatTarget=repeatTarget<1?1:repeatTarget;}
bool PhoenixScreenManager::consumeSongDataChanged(){bool v=_songDataChanged;_songDataChanged=false;return v;}
bool PhoenixScreenManager::consumeSongPlayRequest(){bool v=_songPlayRequest;_songPlayRequest=false;return v;}
bool PhoenixScreenManager::consumeSongStopRequest(){bool v=_songStopRequest;_songStopRequest=false;return v;}
bool PhoenixScreenManager::consumeSongSaveRequest(){bool v=_songSaveRequest;_songSaveRequest=false;return v;}

bool PhoenixScreenManager::consumeQuattroChanged() { bool v = _quattroChanged; _quattroChanged = false; return v; }
bool PhoenixScreenManager::consumeVoiceChanged() { bool v = _voiceChanged; _voiceChanged = false; return v; }
bool PhoenixScreenManager::consumeMixerChanged() { bool v = _mixerChanged; _mixerChanged = false; return v; }
bool PhoenixScreenManager::consumeFilterChanged(){bool v=_filterChanged;_filterChanged=false;return v;}
bool PhoenixScreenManager::consumeFilterEnvelopeChanged(){bool v=_filterEnvChanged;_filterEnvChanged=false;return v;}
bool PhoenixScreenManager::consumeMultisampleChanged(){ bool v=_msChanged; _msChanged=false; return v; }
bool PhoenixScreenManager::consumeKeygroupImportRequest(char *path,size_t pathLen,uint8_t &slot,uint8_t &group,uint8_t &layer){if(!_keygroupImportRequest)return false;if(path&&pathLen){strncpy(path,_keygroupImportPath,pathLen);path[pathLen-1]=0;}slot=_keygroupTargetSlot;group=_keygroupTargetGroup;layer=_keygroupTargetLayer;_keygroupImportRequest=false;return true;}
bool PhoenixScreenManager::consumeKeygroupDeleteRequest(uint8_t &slot,uint8_t &group){if(!_keygroupDeleteRequest)return false;slot=_keygroupTargetSlot;group=_keygroupTargetGroup;_keygroupDeleteRequest=false;return true;}
bool PhoenixScreenManager::consumeMultisampleAutoMapRequest(char *folder,size_t folderLen,uint8_t &slot){if(!_multisampleAutoMapRequest)return false;if(folder&&folderLen){strncpy(folder,_multisampleAutoMapFolder,folderLen);folder[folderLen-1]=0;}slot=_multisampleAutoMapSlot&3;_multisampleAutoMapRequest=false;return true;}
bool PhoenixScreenManager::consumeAutoMapRequest(char *folder,size_t folderLen,uint8_t &slot){if(!_autoMapRequest)return false;if(folder&&folderLen){strncpy(folder,_autoMapFolder,folderLen);folder[folderLen-1]=0;}slot=_autoMapSlot&3;_autoMapRequest=false;return true;}
void PhoenixScreenManager::setMultisampleKeygroupStatus(uint8_t slot,uint8_t group,bool enabled,uint8_t low,uint8_t high,uint8_t root,uint8_t chokeGroup,bool oneShot,uint16_t chokeFadeMs,uint8_t playMode,uint8_t exclusiveGroup,bool retriggerLegato,uint8_t startPct,uint8_t endPct,bool reversePlayback,int8_t transpose,int16_t fineCent,uint8_t keytrackPct){slot&=3;group&=15;_msEnabled[slot][group]=enabled;_msLow[slot][group]=low;_msHigh[slot][group]=high<low?low:high;_msRoot[slot][group]=root;_msChoke[slot][group]=chokeGroup>8?8:chokeGroup;_msOneShot[slot][group]=oneShot;_msChokeFadeMs[slot][group]=chokeFadeMs>250?250:chokeFadeMs;_msPlayMode[slot][group]=playMode>2?2:playMode;_msExclusiveGroup[slot][group]=exclusiveGroup>8?8:exclusiveGroup;_msRetriggerLegato[slot][group]=retriggerLegato;_msStartPct[slot][group]=startPct>99?99:startPct;_msEndPct[slot][group]=endPct<1?1:(endPct>100?100:endPct);_msReverse[slot][group]=reversePlayback;_msTranspose[slot][group]=(int8_t)constrain((int)transpose,-24,24);_msFineCent[slot][group]=(int16_t)constrain((int)fineCent,-100,100);_msKeytrackPct[slot][group]=keytrackPct>100?100:keytrackPct;}
void PhoenixScreenManager::setMultisampleLayerStatus(uint8_t slot,uint8_t group,uint8_t layer,bool enabled,uint8_t velocityLow,uint8_t velocityHigh,uint8_t level,int8_t pan,const char *path,uint8_t rrMode,uint8_t rrCount,uint8_t loopMode,uint8_t loopStartPct,uint8_t loopEndPct,uint8_t loopXfadeMs,uint8_t velToLevelPct,uint8_t velToFilterPct){slot&=3;group&=15;layer%=3;_msLayerEnabled[slot][group][layer]=enabled;_msVelLow[slot][group][layer]=velocityLow;_msVelHigh[slot][group][layer]=velocityHigh;_msLevel[slot][group][layer]=level;_msPan[slot][group][layer]=pan;_msRrMode[slot][group][layer]=rrMode;_msRrCount[slot][group][layer]=rrCount;_msLoopMode[slot][group][layer]=loopMode>2?2:loopMode;_msLoopStartPct[slot][group][layer]=loopStartPct>98?98:loopStartPct;_msLoopEndPct[slot][group][layer]=loopEndPct<1?1:(loopEndPct>100?100:loopEndPct);_msLoopXfadeMs[slot][group][layer]=loopXfadeMs>50?50:loopXfadeMs;_msVelToLevel[slot][group][layer]=velToLevelPct>100?100:velToLevelPct;_msVelToFilter[slot][group][layer]=velToFilterPct>100?100:velToFilterPct;if(_msPath&&path){strncpy(_msPath[slot][group][layer][0],path,sizeof(_msPath[slot][group][layer][0]));_msPath[slot][group][layer][0][sizeof(_msPath[slot][group][layer][0])-1]=0;}}
void PhoenixScreenManager::setMultisampleVariantPath(uint8_t slot,uint8_t group,uint8_t layer,uint8_t variant,const char*path){slot&=3;group&=15;layer%=3;variant&=3;if(!_msPath)return;if(path){strncpy(_msPath[slot][group][layer][variant],path,sizeof(_msPath[slot][group][layer][variant]));_msPath[slot][group][layer][variant][sizeof(_msPath[slot][group][layer][variant])-1]=0;}else _msPath[slot][group][layer][variant][0]=0;}
void PhoenixScreenManager::setFilterSlotStatus(uint8_t slot,uint8_t c,uint8_t r,int8_t e,uint8_t v,uint8_t k,uint16_t a,uint16_t d,uint8_t su,uint16_t re){slot&=3;_filterCutoff[slot]=c;_filterResonance[slot]=r;_filterEnvAmount[slot]=e;_filterVelocity[slot]=v;_filterKeytrack[slot]=k;_filterAttackMs[slot]=a;_filterDecayMs[slot]=d;_filterSustainPct[slot]=su;_filterReleaseMs[slot]=re;}
void PhoenixScreenManager::setVoiceSlotStatus(uint8_t slot, uint8_t mode, uint8_t limit, uint8_t priority, uint16_t glideMs) {
  slot &= 3; _voiceMode[slot]=mode>2?2:mode; _voiceLimit[slot]=constrain((int)limit,1,12); _notePriority[slot]=priority>2?2:priority; _glideMs[slot]=constrain((int)glideMs,0,2000);
}
void PhoenixScreenManager::setMixerSlotStatus(uint8_t slot, uint8_t level, int8_t pan, uint8_t echoSend) {
  slot &= 3; _mixerLevel[slot]=(uint8_t)constrain((int)level,0,100); _mixerPan[slot]=(int8_t)constrain((int)pan,-100,100); _echoSend[slot]=(uint8_t)constrain((int)echoSend,0,100);
}

void PhoenixScreenManager::setQuattroStatus(uint8_t mode, const uint8_t low[4], const uint8_t high[4], const uint8_t channel[4]) {
  _quattroMode = mode ? 1 : 0;
  for (uint8_t i=0;i<4;++i) {
    _quattroKeyLow[i] = low ? (uint8_t)constrain((int)low[i],0,127) : (uint8_t)(i*32);
    _quattroKeyHigh[i] = high ? (uint8_t)constrain((int)high[i],0,127) : (uint8_t)((i==3)?127:(i*32+31));
    if (_quattroKeyHigh[i] < _quattroKeyLow[i]) _quattroKeyHigh[i] = _quattroKeyLow[i];
    _quattroMidiChannel[i] = channel ? constrain((int)channel[i],1,16) : phxDefaultMultiChannel(_midiChannel, i);
  }
}

bool PhoenixScreenManager::allocateMultisamplePathCache() {
  if (_msPath) return true;

  const size_t bytes = (size_t)4U * 16U * 3U * 4U * 160U;
  void *memory = nullptr;
  bool inPsram = false;

  if (psramFound()) {
    memory = ps_malloc(bytes);
    inPsram = (memory != nullptr);
  }
  if (!memory) memory = malloc(bytes);
  if (!memory) {
    Serial.printf("MEM ERROR: multisample path cache allocation failed (%u bytes)\n",
                  (unsigned)bytes);
    return false;
  }

  _msPath = reinterpret_cast<char (*)[16][3][4][160]>(memory);
  memset(_msPath, 0, bytes);
  PHX_INFO_PRINTF("MEM: multisample path cache %u bytes in %s\n",
                (unsigned)bytes, inPsram ? "PSRAM" : "internal heap fallback");
  return true;
}


void PhoenixScreenManager::begin(bool serviceMode) {
  allocateMultisamplePathCache();
  _screen = SCR_BOOT;
  _sel = 0;
  _about = false;
  _overwriteConfirm = false;
  _overwriteSlot = 0;
  _recordReturnScreen = SCR_SOUND;
  _recordCompleteSlot = 0;
  _recordCompleteSaveState = -1;
  _serviceMode = serviceMode;
  loadSystemSettings();
  // v0.7.18a: Multi-Mode defaults are derived once from the loaded base MIDI channel.
  // The base channel is only a template here; Multi Mode itself still ignores it.
  for (uint8_t i = 0; i < 4; ++i) {
    _quattroMidiChannel[i] = phxDefaultMultiChannel(_midiChannel, i);
  }
  _toneRequest = -1;
  _recordRequest = false;
  _playRequest = false;
  _reversePlayRequest = false;
  _playFromCursorRequest = false;
  _reversePlayFromCursorRequest = false;
  _playFromCursorFrame = 0;
  _waveReverseMode = false;
  _stopRequest = false;
  _selectSlotRequest = -1;
  _pitchChanged = false;
  _pitchParam = 0;
  _pitchEditMode = false;
  _echoEditMode = false;
  _diskAction = 3;
  _diskConfirmAction = -1;
  _browserImportState = 0;
  _browserImportRequest = false;
  _browserPreviewRequest = false;
  _browserPreviewStopRequest = false;
  _loopChanged = false;
  _loopRangeChanged = false;
  _sampleRangeChanged = false;
  _editorCursor = 0;
  _editorMarker = 0;
  _sampleEditorPlayRequest = false;
  _sampleEditorPlayStart = 0;
  _sampleEditorPlayEnd = 0;
  _sampleEditorPlayReverse = false;
  _triggerChanged = false;
  _triggerEditMode = false;
  _triggerTestActive = false;
  _triggerTestAbove = false;
  _triggerTestPrevAbove = false;
  _triggerTestTrigUntilMs = 0;
  _seqRun = false;
  for (uint8_t t = 0; t < 4; ++t) _seqPlayhead[t] = 0;
  _recUxStatus = 0;
  _recUxUntilMs = 0;
  _recUxPrevWaiting = false;
  _recUxPrevActive = false;
  _bootStart = millis();
}

void PhoenixScreenManager::setHardwareStatus(bool psramOk, uint32_t psramKb, bool audioOk, uint32_t midiBytes, uint32_t underruns, uint32_t clipCount) {
  _psramOk = psramOk;
  _psramKb = psramKb;
  _audioOk = audioOk;
  _midiBytes = midiBytes;
  _underruns = underruns;
  _clipCount = clipCount;
}


void PhoenixScreenManager::setDiagnosticsStatus(uint32_t elapsedMs, uint8_t voices, uint8_t voiceCapacity, uint8_t voicePeak,
                                                uint32_t audioAvgUs, uint32_t audioPeakUs, uint32_t riskCount,
                                                uint32_t overrunCount, uint32_t underruns, uint32_t voiceSteals,
                                                uint32_t heapFreeKb, uint32_t heapMinKb, uint32_t psramFreeKb) {
  _diagElapsedMs = elapsedMs;
  _diagVoices = voices;
  _diagVoiceCapacity = voiceCapacity;
  _diagVoicePeak = voicePeak;
  _diagAudioAvgUs = audioAvgUs;
  _diagAudioPeakUs = audioPeakUs;
  _diagRiskCount = riskCount;
  _diagOverrunCount = overrunCount;
  _diagUnderruns = underruns;
  _diagVoiceSteals = voiceSteals;
  _diagHeapFreeKb = heapFreeKb;
  _diagHeapMinKb = heapMinKb;
  _diagPsramFreeKb = psramFreeKb;
}

bool PhoenixScreenManager::consumeDiagnosticsResetRequest() {
  const bool r = _diagnosticsResetRequest;
  _diagnosticsResetRequest = false;
  return r;
}

bool PhoenixScreenManager::consumeDiagnosticsLogRequest() {
  const bool r = _diagnosticsLogRequest;
  _diagnosticsLogRequest = false;
  return r;
}

bool PhoenixScreenManager::diagnosticsVisible() const {
  return _screen == SCR_DIAGNOSTICS;
}

void PhoenixScreenManager::setTransportStatus(bool recording, bool playing, bool sampleReady, uint32_t frames, uint32_t recordFrames, uint32_t recordCapacityFrames, uint32_t playFrames, uint32_t sampleRate, int16_t dcL, int16_t dcR, uint8_t selectedSlot) {
  _recording = recording;
  _playing = playing;
  _sampleReady = sampleReady;
  if (!playing) _playingReverse = false;
  _sampleFrames = frames;
  _recordFrames = recordFrames;
  _recordCapacityFrames = recordCapacityFrames;
  _playFrames = playFrames;
  _sampleRate = sampleRate;
  _dcL = dcL;
  _dcR = dcR;
  _selectedSlot = selectedSlot < 4 ? selectedSlot : 0;
}

void PhoenixScreenManager::setSamplePlayheadStatus(bool active, uint32_t frame) {
  _samplePlayheadActive = active;
  _samplePlayheadFrame = frame;
}

void PhoenixScreenManager::setRecorderUxStatus(bool waitingForTrigger, bool activelyRecording) {
  const uint32_t now = millis();

  if (waitingForTrigger) {
    _recUxStatus = 1;       // WAIT TRIG
    _recUxUntilMs = 0;
  } else if (activelyRecording) {
    if (_recUxPrevWaiting && !_recUxPrevActive) {
      _recUxStatus = 3;     // TRIGGER!
      _recUxUntilMs = now + 450;
    } else if (_recUxStatus != 3 || now >= _recUxUntilMs) {
      _recUxStatus = 2;     // RECORDING
      _recUxUntilMs = 0;
    }
  } else {
    if (_recUxPrevWaiting || _recUxPrevActive) {
      _recUxStatus = (_recordFrames > 0) ? 4 : 5; // DONE / CANCELLED
      _recUxUntilMs = now + 1800;
    } else if (_recUxUntilMs && now >= _recUxUntilMs) {
      _recUxStatus = 0;
      _recUxUntilMs = 0;
    }
  }

  _recUxPrevWaiting = waitingForTrigger;
  _recUxPrevActive = activelyRecording;
}

void PhoenixScreenManager::setTriggerTestInput(bool thresholdReached) {
  if (!_triggerTestActive) {
    _triggerTestAbove = false;
    _triggerTestPrevAbove = false;
    _triggerTestTrigUntilMs = 0;
    return;
  }

  const uint32_t now = millis();
  // Latch short transients long enough to be visible on the 45 ms GUI refresh.
  if (thresholdReached && !_triggerTestPrevAbove) _triggerTestTrigUntilMs = now + 700UL;
  _triggerTestAbove = thresholdReached;
  _triggerTestPrevAbove = thresholdReached;
}

void PhoenixScreenManager::setSampleAnalysisSummary(uint8_t peakPercent, bool dcDetected,
                                                     uint32_t suggestedStart, uint32_t suggestedEnd,
                                                     bool trimApplied) {
  _analysisPeakPercent = peakPercent;
  _analysisDcDetected = dcDetected;
  _analysisSuggestedStart = suggestedStart;
  _analysisSuggestedEnd = suggestedEnd;
  _analysisTrimApplied = trimApplied;
  _recUxStatus = 6; // SMART PROCESSING RESULT
  _recUxUntilMs = millis() + 2500UL;
}


void PhoenixScreenManager::setSlotStatus(const bool recorded[4], const bool recording[4], const bool playing[4], const uint32_t frames[4]) {
  for (uint8_t i = 0; i < 4; ++i) {
    _slotRecorded[i] = recorded ? recorded[i] : false;
    _slotRecording[i] = recording ? recording[i] : false;
    _slotPlaying[i] = playing ? playing[i] : false;
    _slotFrames[i] = frames ? frames[i] : 0;
  }
}


void PhoenixScreenManager::setLoopStatus(const bool loopEnabled[4]) {
  // Compatibility bridge for older callers: enabled means FORWARD unless an
  // already selected ALTERNATE mode should be preserved.
  for (uint8_t i = 0; i < 4; ++i) {
    const bool enabled = loopEnabled ? loopEnabled[i] : false;
    _slotLoop[i] = enabled;
    if (!enabled) _slotLoopMode[i] = 0;
    else if (_slotLoopMode[i] == 0 || _slotLoopMode[i] > 2) _slotLoopMode[i] = 1;
  }
}

void PhoenixScreenManager::setLoopModeStatus(const uint8_t loopMode[4]) {
  for (uint8_t i = 0; i < 4; ++i) {
    const uint8_t mode = loopMode ? (uint8_t)constrain((int)loopMode[i], 0, 2) : 0;
    _slotLoopMode[i] = mode;
    _slotLoop[i] = (mode != 0);
  }
}

void PhoenixScreenManager::setLoopCrossfadeStatus(const uint8_t xfadeMs[4]) {
  for (uint8_t i=0;i<4;++i) _slotLoopXfadeMs[i] = xfadeMs ? xfadeMs[i] : 0U;
}

void PhoenixScreenManager::setLoopRangeStatus(const uint32_t loopStart[4], const uint32_t loopEnd[4]) {
  for (uint8_t i = 0; i < 4; ++i) {
    _slotLoopStart[i] = loopStart ? loopStart[i] : 0;
    _slotLoopEnd[i] = loopEnd ? loopEnd[i] : 0;
  }
}

void PhoenixScreenManager::setSampleRangeStatus(const uint32_t sampleStart[4], const uint32_t sampleEnd[4]) {
  for (uint8_t i = 0; i < 4; ++i) {
    _slotSampleStart[i] = sampleStart ? sampleStart[i] : 0;
    _slotSampleEnd[i] = sampleEnd ? sampleEnd[i] : 0;
  }
}

void PhoenixScreenManager::setEchoStatus(uint16_t delayMs, uint8_t feedback, uint8_t mix, const uint8_t send[4]) {
  if (delayMs < 50) delayMs = 50;
  if (delayMs > 2000) delayMs = 2000;
  if (feedback > 90) feedback = 90;
  if (mix > 100) mix = 100;
  _echoDelayMs = delayMs;
  _echoFeedback = feedback;
  _echoMix = mix;
  for (uint8_t i = 0; i < 4; ++i) _echoSend[i] = send ? constrain((int)send[i], 0, 100) : 0;
}

void PhoenixScreenManager::setReverbStatus(uint8_t size, uint8_t decay, uint8_t damp, uint8_t mix, const uint8_t send[4]) {
  _reverbSize=(uint8_t)constrain((int)size,0,100); _reverbDecay=(uint8_t)constrain((int)decay,0,100);
  _reverbDamp=(uint8_t)constrain((int)damp,0,100); _reverbMix=(uint8_t)constrain((int)mix,0,100);
  for(uint8_t i=0;i<4;++i)_reverbSend[i]=send?(uint8_t)constrain((int)send[i],0,100):0;
}

void PhoenixScreenManager::setTriggerStatus(bool automatic, uint8_t level) {
  if (level < 1) level = 1;
  if (level > 8) level = 8;
  _triggerAuto = automatic;
  _triggerLevel = level;
}

void PhoenixScreenManager::setPitchSlotStatus(uint8_t slot, int8_t semitone, int16_t fineCent, uint8_t rootNote, int8_t octaveOffset, bool pitchTrack, uint8_t bendRange) {
  if (slot >= 4) return;
  if (semitone < -24) semitone = -24;
  if (semitone > 24) semitone = 24;
  if (fineCent < -100) fineCent = -100;
  if (fineCent > 100) fineCent = 100;
  if (octaveOffset < -2) octaveOffset = -2;
  if (octaveOffset > 2) octaveOffset = 2;
  if (rootNote > 127) rootNote = 127;
  _pitchSemitone[slot] = semitone;
  _pitchFineCent[slot] = fineCent;
  _pitchRootNote[slot] = rootNote;
  _keyboardOctave[slot] = octaveOffset;
  _pitchTrack[slot] = pitchTrack;
  _pitchBendRange[slot] = bendRange;
}

void PhoenixScreenManager::setEnvelopeSlotStatus(uint8_t slot, uint16_t attackMs, uint16_t decayMs, uint8_t sustainPct, uint16_t releaseMs) {
  slot &= 3;
  _envAttackMs[slot] = attackMs;
  _envDecayMs[slot] = decayMs;
  _envSustainPct[slot] = sustainPct;
  _envReleaseMs[slot] = releaseMs;
}

void PhoenixScreenManager::setVintageSlotStatus(uint8_t slot, uint8_t preset, uint8_t rate, uint8_t bits, uint8_t filter, uint8_t jitter) {
  slot &= 3; _vintagePreset[slot]=preset; _vintageRate[slot]=rate; _vintageBits[slot]=bits; _vintageFilter[slot]=filter; _vintageJitter[slot]=jitter;
}


void PhoenixScreenManager::setPlaybackReverseMode(bool reverse) {
  _waveReverseMode = reverse;
  _sampleEditorPlayReverse = reverse;
}

int8_t PhoenixScreenManager::consumeToneRequest() {
  int8_t r = _toneRequest;
  _toneRequest = -1;
  return r;
}

bool PhoenixScreenManager::consumeAudioTestChanged() {
  bool r = _audioTestChanged;
  _audioTestChanged = false;
  return r;
}


void PhoenixScreenManager::browserGoRoot() {
  // v1.0.6: Re-entering WAV IMPORT at the root must be instant when the
  // current RAM cache already represents /PHOENIX/WAV. The directory itself
  // is not modified by importing a WAV into a Phoenix slot.
  if (_browserCacheValid && phxIsWavRoot(_browserPath)) {
    _browserSel = 0;
    ensureSelectedBrowserWavInfo();
    snprintf(_browserStatus, sizeof(_browserStatus), "%u ITEM(S) CACHED", (unsigned)_browserCount);
    _browserStatus[sizeof(_browserStatus)-1] = 0;
    return;
  }
  strncpy(_browserPath, PHX_WAV_DIR, sizeof(_browserPath));
  _browserPath[sizeof(_browserPath)-1] = 0;
  scanSampleBrowser();
}

bool PhoenixScreenManager::browserGoUp() {
  if (phxIsWavRoot(_browserPath)) return false;
  bool ok = phxParentPath(_browserPath, sizeof(_browserPath));
  scanSampleBrowser();
  return ok;
}

bool PhoenixScreenManager::browserOpenSelected() {
  if (_browserCount == 0 || _browserSel >= _browserCount) return false;
  if (!_browserEntries[_browserSel].isDir) {
    strncpy(_browserStatus, "FILE SELECTED", sizeof(_browserStatus));
    _browserStatus[sizeof(_browserStatus)-1] = 0;
    return false;
  }

  char nextPath[sizeof(_browserPath)];
  phxJoinPath(_browserPath, _browserEntries[_browserSel].name, nextPath, sizeof(nextPath));
  strncpy(_browserPath, nextPath, sizeof(_browserPath));
  _browserPath[sizeof(_browserPath)-1] = 0;
  _browserPreviewStopRequest = true;
  scanSampleBrowser();
  return true;
}


bool PhoenixScreenManager::consumeWavImportRequest(char *path, size_t pathLen, uint8_t &slot) {
  if (!_browserImportRequest) return false;
  if (path && pathLen > 0) {
    strncpy(path, _browserImportPath, pathLen);
    path[pathLen - 1] = 0;
  }
  slot = _browserImportSlot & 3;
  _browserImportRequest = false;
  _browserPreviewRequest = false;
  _browserPreviewStopRequest = false;
  return true;
}

bool PhoenixScreenManager::consumeWavPreviewRequest(char *path, size_t pathLen) {
  if (!_browserPreviewRequest) return false;
  if (path && pathLen > 0) {
    strncpy(path, _browserPreviewPath, pathLen);
    path[pathLen - 1] = 0;
  }
  _browserPreviewRequest = false;
  return true;
}

bool PhoenixScreenManager::consumeWavPreviewStopRequest() {
  bool r = _browserPreviewStopRequest;
  _browserPreviewStopRequest = false;
  return r;
}

void PhoenixScreenManager::setBrowserStatus(const char *text) {
  if (!text) text = "";
  strncpy(_browserStatus, text, sizeof(_browserStatus));
  _browserStatus[sizeof(_browserStatus)-1] = 0;
}

void PhoenixScreenManager::setMultisampleLoadStatus(const char *text) {
  if (!text) text = "";
  strncpy(_msLoadStatus, text, sizeof(_msLoadStatus));
  _msLoadStatus[sizeof(_msLoadStatus)-1] = 0;
}

void PhoenixScreenManager::invalidateSampleBrowserCache() {
  // v1.0.6: Call this only when external storage contents may have changed
  // (for example writable USB MSC). Normal slot import does not change WAV dir.
  _browserCacheValid = false;
}


bool PhoenixScreenManager::readWavInfo(const char *fullPath, BrowserEntry &entry) {
  entry.wavInfoScanned = true;
  entry.wavInfoValid = false;
  entry.sampleRate = 0;
  entry.bitsPerSample = 0;
  entry.channels = 0;
  entry.dataOffset = 0;
  entry.dataLength = 0;
  entry.sampleCount = 0;
  entry.durationTenths = 0;

  if (!fullPath || !fullPath[0]) return false;
  File f = SD.open(fullPath, FILE_READ);
  if (!f) return false;

  uint8_t hdr[12];
  if (f.read(hdr, 12) != 12) { f.close(); return false; }
  if (memcmp(hdr, "RIFF", 4) != 0 || memcmp(hdr + 8, "WAVE", 4) != 0) { f.close(); return false; }

  bool gotFmt = false;
  bool gotData = false;
  uint16_t audioFormat = 0;
  uint16_t channels = 0;
  uint32_t sampleRate = 0;
  uint16_t bits = 0;
  uint32_t dataOffset = 0;
  uint32_t dataLength = 0;

  while (f.available()) {
    uint8_t ch[8];
    if (f.read(ch, 8) != 8) break;
    uint32_t chunkSize = phxReadLE32(ch + 4);
    uint32_t dataPos = f.position();

    if (memcmp(ch, "fmt ", 4) == 0) {
      uint8_t fmt[40];
      uint32_t toRead = chunkSize;
      if (toRead > sizeof(fmt)) toRead = sizeof(fmt);
      if (f.read(fmt, toRead) != (int)toRead) break;
      if (chunkSize > toRead) f.seek(dataPos + chunkSize + (chunkSize & 1));
      if (chunkSize >= 16) {
        audioFormat = phxReadLE16(fmt + 0);
        channels = phxReadLE16(fmt + 2);
        sampleRate = phxReadLE32(fmt + 4);
        bits = phxReadLE16(fmt + 14);
        gotFmt = true;
      }
    } else if (memcmp(ch, "data", 4) == 0) {
      dataOffset = dataPos;
      dataLength = chunkSize;
      gotData = true;
      // We have enough metadata; do not read the audio data in Phase 1.
      break;
    } else {
      f.seek(dataPos + chunkSize + (chunkSize & 1));
    }
  }
  f.close();

  if (!gotFmt || !gotData) return false;
  if (audioFormat != 1) return false; // PCM only in v0.7.13g.
  if (channels < 1 || channels > 2) return false;
  if (bits != 8 && bits != 16 && bits != 24 && bits != 32) return false;
  if (sampleRate < 8000 || sampleRate > 48000) return false;

  uint32_t bytesPerFrame = ((uint32_t)bits / 8U) * (uint32_t)channels;
  uint32_t frames = (bytesPerFrame > 0) ? (dataLength / bytesPerFrame) : 0;
  uint32_t tenths = (sampleRate > 0) ? ((frames * 10UL) / sampleRate) : 0;
  if (tenths > 65535UL) tenths = 65535UL;

  entry.wavInfoValid = true;
  entry.sampleRate = sampleRate;
  entry.bitsPerSample = bits;
  entry.channels = channels;
  entry.dataOffset = dataOffset;
  entry.dataLength = dataLength;
  entry.sampleCount = frames;
  entry.durationTenths = (uint16_t)tenths;
  return true;
}

void PhoenixScreenManager::scanSampleBrowser() {
  _browserCount = 0;
  _browserSel = 0;
  _browserCacheValid = false;
  strncpy(_browserStatus, "SCANNING...", sizeof(_browserStatus));
  _browserStatus[sizeof(_browserStatus)-1] = 0;

  for (uint8_t i = 0; i < PHX_BROWSER_MAX; ++i) {
    _browserEntries[i].name[0] = 0;
    _browserEntries[i].isDir = false;
    _browserEntries[i].size = 0;
    _browserEntries[i].wavInfoValid = false;
    _browserEntries[i].wavInfoScanned = false;
    _browserEntries[i].sampleRate = 0;
    _browserEntries[i].bitsPerSample = 0;
    _browserEntries[i].channels = 0;
    _browserEntries[i].dataOffset = 0;
    _browserEntries[i].dataLength = 0;
    _browserEntries[i].sampleCount = 0;
    _browserEntries[i].durationTenths = 0;
  }

  if (!_browserPath[0]) {
    strncpy(_browserPath, PHX_WAV_DIR, sizeof(_browserPath));
    _browserPath[sizeof(_browserPath)-1] = 0;
  }

  if (!phxSdReadyForConfig()) {
    strncpy(_browserStatus, "SD NOT READY", sizeof(_browserStatus));
    _browserStatus[sizeof(_browserStatus)-1] = 0;
    return;
  }
  phxEnsureDir(PHX_ROOT_DIR);
  phxEnsureDir(PHX_WAV_DIR);

  File dir = SD.open(_browserPath);
  if (!dir || !dir.isDirectory()) {
    strncpy(_browserStatus, "DIR ERROR", sizeof(_browserStatus));
    _browserStatus[sizeof(_browserStatus)-1] = 0;
    if (dir) dir.close();
    return;
  }

  while (_browserCount < PHX_BROWSER_MAX) {
    File entry = dir.openNextFile();
    if (!entry) break;
    const char *bn = phxBaseName(entry.name());
    bool isDir = entry.isDirectory();
    if (phxBrowserShowName(bn, isDir)) {
      strncpy(_browserEntries[_browserCount].name, bn, sizeof(_browserEntries[_browserCount].name));
      _browserEntries[_browserCount].name[sizeof(_browserEntries[_browserCount].name)-1] = 0;
      _browserEntries[_browserCount].isDir = isDir;
      _browserEntries[_browserCount].size = isDir ? 0 : (uint32_t)entry.size();
      // v1.0.6: Do NOT open every WAV here. With large libraries this was the
      // main multi-second pause when entering/leaving WAV IMPORT. Metadata is
      // loaded lazily only for the currently selected WAV.
      _browserEntries[_browserCount].wavInfoValid = false;
      _browserEntries[_browserCount].wavInfoScanned = isDir;
      ++_browserCount;
    }
    entry.close();
  }
  dir.close();

  // v0.7.13f: sort RAM cache only. Folders first, then WAV files, alphabetically.
  for (uint8_t i = 0; i < _browserCount; ++i) {
    for (uint8_t j = i + 1; j < _browserCount; ++j) {
      bool swapIt = false;
      if (_browserEntries[i].isDir != _browserEntries[j].isDir) {
        swapIt = !_browserEntries[i].isDir && _browserEntries[j].isDir;
      } else if (strcasecmp(_browserEntries[i].name, _browserEntries[j].name) > 0) {
        swapIt = true;
      }
      if (swapIt) {
        BrowserEntry tmp = _browserEntries[i];
        _browserEntries[i] = _browserEntries[j];
        _browserEntries[j] = tmp;
      }
    }
  }

  _browserCacheValid = true;
  ensureSelectedBrowserWavInfo();
  if (_browserCount == 0) strncpy(_browserStatus, "EMPTY FOLDER", sizeof(_browserStatus));
  else snprintf(_browserStatus, sizeof(_browserStatus), "%u ITEM(S)", (unsigned)_browserCount);
  _browserStatus[sizeof(_browserStatus)-1] = 0;
}

void PhoenixScreenManager::ensureSelectedBrowserWavInfo() {
  if (_browserCount == 0 || _browserSel >= _browserCount) return;
  BrowserEntry &e = _browserEntries[_browserSel];
  if (e.isDir || e.wavInfoScanned) return;
  char fullPath[sizeof(_browserPath) + 72];
  phxJoinPath(_browserPath, e.name, fullPath, sizeof(fullPath));
  e.wavInfoScanned = true;
  readWavInfo(fullPath, e);
}

void PhoenixScreenManager::moveBrowserSel(int8_t d) {
  if (_browserCount == 0) return;
  int ns = (int)_browserSel + d;
  if (ns < 0) ns = _browserCount - 1;
  if (ns >= (int)_browserCount) ns = 0;
  _browserSel = (uint8_t)ns;
  _browserPreviewStopRequest = true;
  _browserStatus[0] = 0;
  ensureSelectedBrowserWavInfo();
}

bool PhoenixScreenManager::consumeRecordRequest() { bool r = _recordRequest; _recordRequest = false; return r; }
bool PhoenixScreenManager::consumePlayRequest()   { bool r = _playRequest;   _playRequest = false;   return r; }
bool PhoenixScreenManager::consumePlayFromCursorRequest(uint32_t &frame) { bool r = _playFromCursorRequest; frame = _playFromCursorFrame; _playFromCursorRequest = false; return r; }
bool PhoenixScreenManager::consumeReversePlayFromCursorRequest(uint32_t &frame) { bool r = _reversePlayFromCursorRequest; frame = _playFromCursorFrame; _reversePlayFromCursorRequest = false; return r; }
bool PhoenixScreenManager::consumeReversePlayRequest() { bool r = _reversePlayRequest; _reversePlayRequest = false; return r; }
bool PhoenixScreenManager::consumeStopRequest()   { bool r = _stopRequest;   _stopRequest = false;   return r; }
int8_t PhoenixScreenManager::consumeSelectSlotRequest() { int8_t r = _selectSlotRequest; _selectSlotRequest = -1; return r; }
bool PhoenixScreenManager::consumePitchChanged() { bool r = _pitchChanged; _pitchChanged = false; return r; }
bool PhoenixScreenManager::consumeEnvelopeChanged() { bool r = _envChanged; _envChanged = false; return r; }
bool PhoenixScreenManager::consumeVintageChanged() { bool r = _vintageChanged; _vintageChanged = false; return r; }
bool PhoenixScreenManager::consumeEchoChanged() { bool r = _echoChanged; _echoChanged = false; return r; }
bool PhoenixScreenManager::consumeReverbChanged() { bool r=_reverbChanged; _reverbChanged=false; return r; }
bool PhoenixScreenManager::consumeLoopChanged() { bool r = _loopChanged; _loopChanged = false; return r; }
bool PhoenixScreenManager::consumeLoopRangeChanged() { bool r = _loopRangeChanged; _loopRangeChanged = false; return r; }
bool PhoenixScreenManager::consumeSampleRangeChanged() { bool r = _sampleRangeChanged; _sampleRangeChanged = false; return r; }
int8_t PhoenixScreenManager::consumeSampleProcessingAction(uint8_t &slot) {
  const int8_t a = _sampleProcessingAction;
  if (a < 0) return -1;
  slot = _sampleProcessingSlot & 3U;
  _sampleProcessingAction = -1;
  return a;
}

void PhoenixScreenManager::setSampleProcessingStatus(const bool trim[4], const bool dc[4], const bool norm[4]) {
  for (uint8_t i = 0; i < 4U; ++i) {
    _slotTrimEnabled[i] = trim ? trim[i] : false;
    _slotDcEnabled[i] = dc ? dc[i] : false;
    _slotNormalizeEnabled[i] = norm ? norm[i] : false;
  }
}

bool PhoenixScreenManager::consumeSampleMarkerEdit(uint8_t &slot, uint32_t &sampleStart,
                                                    uint32_t &loopStart, uint32_t &loopEnd,
                                                    uint32_t &sampleEnd) {
  if (!_sampleMarkerEditPending) return false;
  slot = _sampleMarkerEditSlot & 3U;
  sampleStart = _sampleMarkerEditSampleStart;
  loopStart = _sampleMarkerEditLoopStart;
  loopEnd = _sampleMarkerEditLoopEnd;
  sampleEnd = _sampleMarkerEditSampleEnd;
  _sampleMarkerEditPending = false;
  return true;
}
bool PhoenixScreenManager::consumeZeroCrossSnapRequest(uint8_t &slot, uint8_t &marker, uint32_t &frame) {
  if (!_zeroCrossSnapPending) return false;
  slot = _zeroCrossSnapSlot & 3U;
  marker = _zeroCrossSnapMarker & 3U;
  frame = _zeroCrossSnapFrame;
  _zeroCrossSnapPending = false;
  return true;
}
void PhoenixScreenManager::applyZeroCrossSnap(uint8_t slot, uint8_t marker, uint32_t frame) {
  slot &= 3U; marker &= 3U;
  const uint32_t frames = _slotFrames[slot];
  if (frames == 0U) return;
  uint32_t ss = _slotSampleStart[slot], ls = _slotLoopStart[slot];
  uint32_t le = _slotLoopEnd[slot], se = _slotSampleEnd[slot];
  const uint32_t cur = (marker == 0U) ? ss : (marker == 1U) ? ls : (marker == 2U) ? (le ? le - 1U : 0U) : (se ? se - 1U : 0U);
  int64_t d64 = (int64_t)frame - (int64_t)cur;
  if (d64 > 2147483647LL) d64 = 2147483647LL;
  if (d64 < -2147483647LL) d64 = -2147483647LL;
  PhoenixSampleMarkerEditResult edit = phxMoveSampleMarker(frames, ss, ls, le, se, marker, cur, (int32_t)d64);
  _editorMarker = marker;
  _editorCursor = edit.cursor;
  _slotSampleStart[slot] = edit.sampleStart;
  _slotLoopStart[slot] = edit.loopStart;
  _slotLoopEnd[slot] = edit.loopEnd;
  _slotSampleEnd[slot] = edit.sampleEnd;
  _sampleMarkerEditSlot = slot;
  _sampleMarkerEditSampleStart = edit.sampleStart;
  _sampleMarkerEditLoopStart = edit.loopStart;
  _sampleMarkerEditLoopEnd = edit.loopEnd;
  _sampleMarkerEditSampleEnd = edit.sampleEnd;
  _sampleMarkerEditPending = true;
  if (edit.sampleChanged) _sampleRangeChanged = true;
  if (edit.loopChanged) _loopRangeChanged = true;
}
bool PhoenixScreenManager::consumeSampleEditorPlayRequest(uint32_t &start, uint32_t &end, bool &reverse) {
  bool r = _sampleEditorPlayRequest;
  start = _sampleEditorPlayStart;
  end = _sampleEditorPlayEnd;
  reverse = _sampleEditorPlayReverse;
  _sampleEditorPlayRequest = false;
  return r;
}
void PhoenixScreenManager::showRecordingComplete(uint8_t slot) {
  _bankDirty = true;
  _recordCompleteSlot = slot & 3U;
  _selectedSlot = _recordCompleteSlot;
  _selectSlotRequest = (int8_t)_selectedSlot;
  _recordCompleteSaveState = -1;
  go(SCR_RECORD_COMPLETE);
}

void PhoenixScreenManager::setRecordingCompleteSaveResult(bool ok) {
  if (_screen == SCR_RECORD_COMPLETE) _recordCompleteSaveState = ok ? 1 : 0;
}

bool PhoenixScreenManager::consumeTriggerChanged() { bool r = _triggerChanged; _triggerChanged = false; return r; }
int8_t PhoenixScreenManager::consumeDiskAction() { int8_t r = _diskAction; _diskAction = -1; return r; }
int8_t PhoenixScreenManager::consumeUsbStorageAction() { int8_t r = _usbStorageAction; _usbStorageAction = -1; return r; }
void PhoenixScreenManager::setUsbStorageStatus(bool active, bool available, bool writable, bool ejected, const char *status) {
  _usbStorageActive = active;
  _usbStorageAvailable = available;
  _usbStorageWritable = writable;
  _usbStorageEjected = ejected;
  if (!active || ejected) _usbStorageExitConfirm = false;
  // Do not overwrite the explicit fallback confirmation prompt while it is open.
  if (status && !_usbStorageExitConfirm) {
    strncpy(_usbStorageStatus, status, sizeof(_usbStorageStatus));
    _usbStorageStatus[sizeof(_usbStorageStatus)-1]=0;
  }
}
void PhoenixScreenManager::finishUsbStorageExit(bool remountOk, bool mediaChanged) {
  _usbStorageActive = false;
  _usbStorageWritable = false;
  _usbStorageEjected = false;
  _usbStorageExitConfirm = false;
  strncpy(_usbStorageStatus,
          remountOk ? (mediaChanged ? "SD UPDATED - RELOAD" : "SD READY") : "SD REMOUNT FAILED",
          sizeof(_usbStorageStatus));
  _usbStorageStatus[sizeof(_usbStorageStatus)-1] = 0;
  if (remountOk) go(SCR_DISK, 5);
}
void PhoenixScreenManager::setDiskBankUsed(bool used) {
  _diskBankUsed = used;
}

void PhoenixScreenManager::setDiskStatus(const char *text) {
  if (!text) text = "";
  strncpy(_diskStatus, text, sizeof(_diskStatus));
  _diskStatus[sizeof(_diskStatus)-1] = 0;
}

int PhoenixScreenManager::itemCountFor(ScreenID s) const {
  switch (s) {
    case SCR_SELFTEST: return 5;
    case SCR_AUDIO_OUT: return 4;
    case SCR_MAIN: return 8;
    case SCR_SOUND: return 8;
    case SCR_PITCH: return 5;
    case SCR_ENVELOPE: return 4;
    case SCR_EFFECTS: return 2;
    case SCR_ECHO: return 7;
    case SCR_REVERB: return 8;
    case SCR_LOOP: return 2;
    case SCR_SAMPLE_EDITOR: return 4;
    case SCR_TRIGGER: return 3;
    case SCR_DISK: return 6;
    case SCR_SAMPLE_BROWSER: return (_browserCount > 0) ? _browserCount : 1;
    case SCR_VINTAGE: return 5;
    case SCR_MIDI_TYPE: return 8;
    case SCR_MIDI_CH: return 1;
    case SCR_MIDI_MONITOR: return 1;
    case SCR_QUATTRO: return 8;
    case SCR_KEYBOARD: return 1;
    case SCR_VOICE: return 4;
    case SCR_MIXER: return 3;
    case SCR_FILTER: return 5;
    case SCR_FILTER_ENV: return 4;
    case SCR_MULTISAMPLE: return 13;
    case SCR_SEQUENCER: return 7;
    case SCR_PATTERN_MANAGER: return 3;
    default: return 1;
  }
}

void PhoenixScreenManager::moveSel(int8_t d) {
  int n = itemCountFor(_screen);
  int ns = (int)_sel + d;
  if (ns < 0) ns = n - 1;
  if (ns >= n) ns = 0;
  _sel = (uint8_t)ns;
}

void PhoenixScreenManager::go(ScreenID s, uint8_t sel) {
  if (_screen == SCR_TRIGGER && s != SCR_TRIGGER) {
    _triggerTestActive = false;
    _triggerTestAbove = false;
    _triggerTestPrevAbove = false;
    _triggerTestTrigUntilMs = 0;
  }
  _screen = s;
  _sel = sel;
}

void PhoenixScreenManager::requestRecordingForSelectedSlot() {
  const uint8_t slot = _selectedSlot & 3U;
  _recordReturnScreen = (_screen == SCR_QUATTRO) ? SCR_QUATTRO : SCR_SOUND;
  _recordCompleteSaveState = -1;
  if (_slotRecorded[slot]) {
    _overwriteSlot = slot;
    _overwriteConfirm = true;
  } else {
    _recordRequest = true;
  }
}

void PhoenixScreenManager::enterSelection() {
  if (_screen == SCR_SELFTEST) {
    if (_sel == 0) { go(SCR_AUDIO_OUT); return; }
    if (_sel == 1) { go(SCR_AUDIO_IN); return; }
    if (_sel == 2) { go(SCR_BUTTONS); return; }
    if (_sel == 3) { _diagnosticsReturnScreen = SCR_SELFTEST; go(SCR_DIAGNOSTICS); return; }
    if (_sel == 4) { go(SCR_MAIN); return; }
  }

  if (_screen == SCR_AUDIO_OUT) {
    // v0.7.13b Audio Test Generator is handled in update().
    return;
  }

  if (_screen == SCR_AUDIO_IN || _screen == SCR_BUTTONS) {
    go(SCR_SELFTEST);
    return;
  }

  if (_screen == SCR_MAIN) {
    if (_sel == 0) { go(SCR_SOUND); return; }
    if (_sel == 1) { go(SCR_QUATTRO); return; }
    if (_sel == 2) { go(SCR_PITCH); return; }
    if (_sel == 3) { go(SCR_EFFECTS); return; }
    if (_sel == 4) {
      go(SCR_DISK);
      _diskBankSelectAction = -1;
      _diskConfirmAction = -1;
      _diskBank = _activeBank;
      _diskAction = 3;
      return;
    }
    if (_sel == 5) { go(SCR_VINTAGE); return; }
    if (_sel == 6) { go(SCR_SEQUENCER); return; }
    if (_sel == 7) { go(SCR_MIDI_TYPE); _midiEditMode = false; return; }
    return;
  }

  if (_screen == SCR_EFFECTS) { if(_sel==0){go(SCR_ECHO);_echoEditMode=false;} else {go(SCR_REVERB);_reverbEditMode=false;} return; }

  if (_screen == SCR_VINTAGE) { _vintageEditMode = !_vintageEditMode; return; }

  if (_screen == SCR_MIDI_TYPE) {
    if (_sel == 0) _midiEnabled = !_midiEnabled;
    else if (_sel == 1) _midiClockEnabled = !_midiClockEnabled;
    else if (_sel == 2) _midiNoteEnabled = !_midiNoteEnabled;
    else if (_sel == 3) _midiCcEnabled = !_midiCcEnabled;
    else if (_sel == 4) _midiPcEnabled = !_midiPcEnabled;
    else if (_sel == 5) {
      _midiEditMode = !_midiEditMode;
      if (!_midiEditMode) saveMidiChannelSetting();
      return;
    } else if (_sel == 6) {
      go(SCR_MIDI_MONITOR); return;
    } else if (_sel == 7) {
      _midiResetConfirm = true; return;
    }
    saveMidiControlSettings();
    return;
  }

  if (_screen == SCR_MIDI_CH) {
    _midiEditMode = !_midiEditMode;
    if (!_midiEditMode) saveSystemSettings();
    return;
  }

  if (_screen == SCR_SOUND) {
    if (_sel == 0) { // RECORD
      if (_recording || _playing) _stopRequest = true;
      else requestRecordingForSelectedSlot();
      return;
    }
    if (_sel == 1) { // REPLAY FORWARD
      _waveReverseMode = false;
      if (_playing || _recording) _stopRequest = true;
      else _playRequest = true;
      return;
    }
    if (_sel == 2) { // REPLAY BACKWARD
      _waveReverseMode = true;
      if (_playing || _recording) _stopRequest = true;
      else _reversePlayRequest = true;
      return;
    }
    if (_sel == 3) { go(SCR_WAVE); return; }
    if (_sel == 4) {
      const uint8_t sl = _selectedSlot & 3;
      _editorCursor = _slotSampleStart[sl];
      if (_slotFrames[sl] > 0 && _editorCursor >= _slotFrames[sl]) _editorCursor = 0;
      _editorMarker = 0;
      go(SCR_SAMPLE_EDITOR);
      return;
    }
    if (_sel == 5) { go(SCR_TRIGGER); _triggerEditMode = false; _triggerParam = 0; return; }
    if (_sel == 6) { go(SCR_LOOP); return; }
    if (_sel == 7) { go(SCR_MAIN); return; }
  }

  if (_screen == SCR_PITCH) {
    // Parameter editing is handled in update(const PhoenixInputState&).
    return;
  }


  if (_screen == SCR_ECHO) {
    // Echo parameter browsing/editing is handled in update(const PhoenixInputState&).
    return;
  }


  if (_screen == SCR_DISK) {
    // v1.0.12: first press on LOAD/SAVE/DELETE enters bank-number selection.
    // While selecting, encoder chooses BANK01..99 and a second press executes.
    if (_diskBankSelectAction < 0) {
      if (_sel <= 2) {
        _diskBankSelectAction = (_sel == 0) ? 1 : ((_sel == 1) ? 0 : 2);
        _diskBank = _activeBank;
        _diskConfirmAction = -1;
        _diskAction = 3;
        char msg[24];
        snprintf(msg, sizeof(msg), "BANK %02u CHECK", (unsigned)_diskBank);
        setDiskStatus(msg);
        return;
      }
      if (_sel == 3) {
        if (_diskConfirmAction != 4) { _diskConfirmAction = 4; setDiskStatus("NEW BANK? PUSH YES"); return; }
        _diskConfirmAction = -1; _diskAction = 4; return;
      }
      if (_sel == 4) { _diskConfirmAction = -1; browserGoRoot(); go(SCR_SAMPLE_BROWSER); return; }
      if (_sel == 5) { _diskConfirmAction = -1; go(SCR_USB_STORAGE); return; }
      return;
    }

    const int8_t action = _diskBankSelectAction;
    if (action == 1) {
      if (!_diskBankUsed) { setDiskStatus("BANK EMPTY"); return; }
      _diskConfirmAction = -1;
      _diskAction = 1;
      return;
    }
    if (action == 0) {
      if (_diskBankUsed && _diskConfirmAction != 0) {
        _diskConfirmAction = 0;
        setDiskStatus("OVERWRITE? PUSH YES");
        return;
      }
      _diskConfirmAction = -1;
      _diskAction = 0;
      return;
    }
    if (action == 2) {
      if (!_diskBankUsed) { setDiskStatus("BANK EMPTY"); return; }
      if (_diskConfirmAction != 2) {
        _diskConfirmAction = 2;
        setDiskStatus("DELETE? PUSH YES");
        return;
      }
      _diskConfirmAction = -1;
      _diskAction = 2;
      return;
    }
  }


  if (_screen == SCR_WAVE) {
    go(SCR_SOUND, 2);
    return;
  }



  if (_screen == SCR_QUATTRO) {
    if (_sel < 4) {
      // Slot rows are safe play/select actions.
      // If the slot is READY, F7/Enter plays it. Empty slots start recording.
      // Overwrite is deliberately moved to the separate action row below so
      // an existing sample cannot be erased by accident.
      _selectedSlot = _sel;
      _selectSlotRequest = (int8_t)_sel;
      if (_recording || _playing) _stopRequest = true;
      else if (_slotRecorded[_selectedSlot]) _playRequest = true;
      else requestRecordingForSelectedSlot();
      return;
    }
    if (_sel == 4) {
      // Action row: RECORD for empty slots, OVERWRITE for occupied slots, STOP during transport.
      if (_recording || _playing) {
        _stopRequest = true;
      } else {
        requestRecordingForSelectedSlot();
      }
      return;
    }
    if (_sel == 5) { go(SCR_KEYBOARD); return; }
    if (_sel == 6) { _msSlot=_selectedSlot&3; _msEditMode=false; go(SCR_MULTISAMPLE); return; }
    if (_sel == 7) { go(SCR_MAIN, 1); return; }
  }
}

bool PhoenixScreenManager::currentMidiLearnParameter(PhoenixParameterId &id) const {
  if (_screen == SCR_MIXER) {
    if (_mixerParam == 1) id=PHX_PAR_SLOT_VOLUME;
    else if (_mixerParam == 2) id=PHX_PAR_SLOT_PAN;
    else if (_mixerParam == 3) id=PHX_PAR_ECHO_SEND;
    else return false;
    return true;
  }
  if (_screen == SCR_FILTER) {
    if (_filterParam == 1) id=PHX_PAR_FILTER_CUTOFF;
    else if (_filterParam == 2) id=PHX_PAR_FILTER_RESONANCE;
    else return false;
    return true;
  }
  if (_screen == SCR_ENVELOPE) {
    static const PhoenixParameterId ids[4]={PHX_PAR_AMP_ATTACK,PHX_PAR_AMP_DECAY,PHX_PAR_AMP_SUSTAIN,PHX_PAR_AMP_RELEASE};
    if(_envParam<4){id=ids[_envParam];return true;} return false;
  }
  if (_screen == SCR_ECHO) {
    if (_echoParam==0) id=PHX_PAR_ECHO_TIME;
    else if (_echoParam==1) id=PHX_PAR_ECHO_FEEDBACK;
    else if (_echoParam==2) id=PHX_PAR_ECHO_MIX;
    else if (_echoParam<=6) id=PHX_PAR_ECHO_SEND;
    else return false;
    return true;
  }
  if (_screen == SCR_PITCH) {
    if (_pitchParam==0) id=PHX_PAR_TRANSPOSE;
    else if (_pitchParam==1) id=PHX_PAR_FINE_TUNE;
    else if (_pitchParam==2) id=PHX_PAR_ROOT_KEY;
    else return false;
    return true;
  }
  if (_screen == SCR_SAMPLE_EDITOR) {
    static const PhoenixParameterId ids[4] = { PHX_PAR_SAMPLE_START, PHX_PAR_LOOP_START, PHX_PAR_LOOP_END, PHX_PAR_SAMPLE_END };
    id = ids[_editorMarker & 3U];
    return true;
  }
  if (_screen == SCR_VOICE && _voiceParam==4) { id=PHX_PAR_GLIDE; return true; }
  return false;
}

bool PhoenixScreenManager::consumeMidiLearnRequest(PhoenixParameterId &id) {
  if(!_midiLearnRequest) return false; _midiLearnRequest=false; id=_midiLearnParam; return true;
}
void PhoenixScreenManager::setMidiLearnResult(uint8_t cc, bool assigned) {
  _midiLearnResultCc=cc; _midiLearnResultAssigned=assigned; _midiLearnResultUntilMs=millis()+900UL;
}
void PhoenixScreenManager::cancelMidiLearn() { _midiLearnActive=false; _midiLearnRequest=false; _midiLearnResultUntilMs=0; _midiLearnMenu=false; }

void PhoenixScreenManager::drawMidiLearnPopup(PhoenixGUI &gui) {
  const int x=18,y=10,w=92,h=44; gui.fill(x,y,w,h,false); gui.drawWindow(x,y,w,h,"MIDI LEARN");
  const PhoenixMidiParameterDef *def=phxMidiParameterById(_midiLearnParam);
  gui.text(x+6,y+11,def?def->name:"PARAMETER",false);
  if(_midiLearnResultUntilMs && (int32_t)(millis()-_midiLearnResultUntilMs)<0){
    char line[20]; snprintf(line,sizeof(line),"CC%03u %s",(unsigned)_midiLearnResultCc,_midiLearnResultAssigned?"ASSIGNED":"BLOCKED"); gui.text(x+6,y+25,line,false);
    return;
  }
  if(_midiLearnMenu){
    static const char* opts[4]={"REPLACE","CLEAR","DEFAULT","CANCEL"};
    for(uint8_t i=0;i<4;++i){ const int yy=y+19+(i&1)*8; const int xx=x+6+(i/2)*43; gui.text(xx,yy,(i==_midiLearnMenuSel)?">":" ",false); gui.text(xx+5,yy,opts[i],false); }
  } else {
    gui.text(x+6,y+25,"WAITING FOR CC...",false);
    gui.text(x+6,y+34,"F8 CANCEL",false);
  }
}

void PhoenixScreenManager::update(const PhoenixInputState &in) {
  if (_screen == SCR_BOOT && millis() - _bootStart > 1100) go(_serviceMode ? SCR_SELFTEST : SCR_MAIN);
  if (_screen == SCR_BOOT) return;

  if (_screen == SCR_USB_STORAGE) {
    // Core 2.0.16/Windows does not always report the LoEj bit when Explorer
    // ejects a removable drive. If automatic detection did not arrive, offer
    // an explicit second-step confirmation rather than leaving Phoenix locked.
    if (_usbStorageActive && _usbStorageExitConfirm) {
      if (in.f[7]) {
        _usbStorageExitConfirm = false;
        _usbStorageAction = 3; // user confirms that Windows has ejected the drive
        return;
      }
      if (in.f[8]) {
        _usbStorageExitConfirm = false;
        strncpy(_usbStorageStatus, "EJECT ON PC FIRST", sizeof(_usbStorageStatus));
        _usbStorageStatus[sizeof(_usbStorageStatus)-1] = 0;
        return;
      }
      return;
    }
    if (!_usbStorageActive && in.f[5]) {
      _usbStorageReadWriteSelected = !_usbStorageReadWriteSelected;
      strncpy(_usbStorageStatus,
              _usbStorageReadWriteSelected ? "EJECT REQUIRED" : "USB STORAGE READY",
              sizeof(_usbStorageStatus));
      _usbStorageStatus[sizeof(_usbStorageStatus)-1] = 0;
      return;
    }
    if (in.f[7] && !_usbStorageActive) {
      if (_usbStorageReadWriteSelected && _bankDirty) {
        strncpy(_usbStorageStatus, "SAVE BANK FIRST", sizeof(_usbStorageStatus));
        _usbStorageStatus[sizeof(_usbStorageStatus)-1] = 0;
        return;
      }
      _usbStorageAction = _usbStorageReadWriteSelected ? 2 : 0;
      return;
    }
    if (in.f[8]) {
      if (_usbStorageActive) {
        // Read-only sessions and automatically detected ejects can exit directly.
        if (!_usbStorageWritable || _usbStorageEjected) {
          _usbStorageAction = 1;
        } else {
          // Fallback for Windows hosts that stop/remove the drive without a
          // callback Phoenix can distinguish. The user must confirm with F7.
          _usbStorageExitConfirm = true;
          strncpy(_usbStorageStatus, "PC EJECTED? F7 YES", sizeof(_usbStorageStatus));
          _usbStorageStatus[sizeof(_usbStorageStatus)-1] = 0;
        }
      } else go(SCR_DISK, 5);
      return;
    }
    return;
  }

  if (_screen == SCR_DIAGNOSTICS) {
    if (in.f[8]) { go(_diagnosticsReturnScreen); return; }
    if (in.f[1] || in.encPress) {
      _diagnosticsResetRequest = true;
      _diagnosticsLastAction = 1;
      _diagnosticsStatusUntilMs = millis() + 900UL;
      return;
    }
    if (in.f[7]) {
      _diagnosticsLogRequest = true;
      _diagnosticsLastAction = 2;
      _diagnosticsStatusUntilMs = millis() + 900UL;
      return;
    }
    return;
  }

  if (_screen == SCR_MAIN && in.f[2]) {
    _diagnosticsReturnScreen = SCR_MAIN;
    go(SCR_DIAGNOSTICS);
    return;
  }

  for (uint8_t i = 1; i <= 8; ++i) if (in.f[i]) _btnSeen[i - 1] = true;
  if (in.encoderStep != 0) _encSeen = true;
  if (in.encPress || in.encLong) _encSwSeen = true;

  // Modal overwrite confirmation has priority over global help/about handling.
  // F1/ F8 = NO, F7 / Encoder press = YES.
  if (_overwriteConfirm) {
    if (in.f[1] || in.f[8]) {
      _overwriteConfirm = false;
      return;
    }
    if (in.f[7] || in.encPress) {
      _selectedSlot = _overwriteSlot;
      _selectSlotRequest = (int8_t)_selectedSlot;
      _recordRequest = true;
      _overwriteConfirm = false;
      return;
    }
    return;
  }

  // C024: direct post-record workflow. The new recording remains selected.
  if (_screen == SCR_RECORD_COMPLETE) {
    if (in.f[5]) { go(SCR_SAMPLE_EDITOR); return; }
    if (in.f[6]) {
      if (_playing) _stopRequest = true;
      else _playRequest = true;
      return;
    }
    if (in.f[7]) { _diskAction = 0; _recordCompleteSaveState = -1; return; }
    if (in.f[8]) { go(_recordReturnScreen); return; }
    return;
  }

  // C022: in both sampling screens F7 is always transport STOP/CANCEL,
  // independent of which menu row the encoder currently highlights.
  if ((_screen == SCR_SOUND || _screen == SCR_QUATTRO) && (_recording || _playing) && in.f[7]) {
    _stopRequest = true;
    return;
  }

  if (_midiLearnActive) {
    if (in.f[8]) { cancelMidiLearn(); return; }
    if (_midiLearnResultUntilMs && (int32_t)(millis()-_midiLearnResultUntilMs)>=0) { cancelMidiLearn(); return; }
    if (_midiLearnMenu) {
      int16_t d=in.encoderStep; if(in.f[1])d=-1; if(in.f[3])d=1;
      if(d<0) _midiLearnMenuSel=(uint8_t)((_midiLearnMenuSel+3U)%4U);
      if(d>0) _midiLearnMenuSel=(uint8_t)((_midiLearnMenuSel+1U)%4U);
      if(in.f[7] || in.encPress){
        if(_midiLearnMenuSel==0){ _midiLearnMenu=false; _midiLearnRequest=true; }
        else if(_midiLearnMenuSel==1){ const bool ok=phxMidiMapClear(_midiLearnParam); setMidiLearnResult(255,ok); _midiLearnMenu=false; }
        else if(_midiLearnMenuSel==2){ const bool ok=phxMidiMapResetParameter(_midiLearnParam); const PhoenixMidiParameterDef* dfn=phxMidiParameterById(_midiLearnParam); setMidiLearnResult(dfn?dfn->defaultCc:255,ok); _midiLearnMenu=false; }
        else cancelMidiLearn();
      }
      return;
    }
    return;
  }
  if (in.encLong) {
    PhoenixParameterId id;
    if (currentMidiLearnParameter(id)) {
      const PhoenixMidiParameterDef *def=phxMidiParameterById(id);
      if(def && def->learnable){
        _midiLearnParam=id; _midiLearnActive=true; _midiLearnResultUntilMs=0; _midiLearnMenuSel=0;
        const uint8_t current=phxMidiMapCc(id);
        _midiLearnMenu=(current<=127U);
        _midiLearnRequest=!_midiLearnMenu;
        return;
      }
    }
    _about = true; return;
  }
  if (_about) {
    // RTAL GUI standard: F8 always leaves information/about screens.
    if (in.f[8]) _about = false;
    return;
  }


  if (_screen == SCR_AUDIO_IN || _screen == SCR_BUTTONS) {
    if (in.f[8]) enterSelection();
    return;
  }

  if (_screen == SCR_AUDIO_OUT) {
    if (in.f[8]) {
      _audioTestOutput = false;
      _audioTestChanged = true;
      go(SCR_SELFTEST, 0);
      return;
    }

    if (in.f[7]) {
      _audioTestOutput = !_audioTestOutput;
      _audioTestChanged = true;
      return;
    }

    if (in.encPress) {
      _audioTestEditMode = !_audioTestEditMode;
      return;
    }

    int16_t delta = 0;
    if (in.encoderStep != 0) delta = in.encoderStep;
    if (in.f[1]) delta = -1;
    if (in.f[3]) delta = 1;

    if (delta != 0) {
      if (!_audioTestEditMode) {
        int p = (int)_audioTestParam + encSign(delta);
        if (p < 0) p = 3;
        if (p > 3) p = 0;
        _audioTestParam = (uint8_t)p;
        return;
      }

      if (_audioTestParam == 0) {
        int w = (int)_audioTestWaveform + encSign(delta);
        if (w < 0) w = 4;
        if (w > 4) w = 0;
        if (w != (int)_audioTestWaveform) { _audioTestWaveform = (uint8_t)w; _audioTestChanged = true; }
      } else if (_audioTestParam == 1) {
        int v = (int)_audioTestFreqHz + audioFreqStepFromEncoder(delta);
        if (v < 20) v = 20;
        if (v > 20000) v = 20000;
        if (v != (int)_audioTestFreqHz) { _audioTestFreqHz = (uint16_t)v; _audioTestChanged = true; }
      } else if (_audioTestParam == 2) {
        int v = (int)_audioTestLevelDb + audioLevelStepFromEncoder(delta);
        if (v < -60) v = -60;
        if (v > -3) v = -3;
        if (v != (int)_audioTestLevelDb) { _audioTestLevelDb = (int8_t)v; _audioTestChanged = true; }
      } else {
        bool next = _audioTestOutput;
        if (delta != 0) next = !next;
        if (next != _audioTestOutput) { _audioTestOutput = next; _audioTestChanged = true; }
      }
      return;
    }
    return;
  }



  if (_screen == SCR_SONG_EDITOR) {
    if (in.f[8]) { _songSaveRequest = true; go(SCR_PATTERN_MANAGER); return; }
    if (in.f[1]) { _songEditPos = (uint8_t)((_songEditPos + 15U) & 15U); return; }
    if (in.f[2]) { _songEditPos = (uint8_t)((_songEditPos + 1U) & 15U); return; }
    if (in.f[3]) { _songEditField = (uint8_t)((_songEditField + 1U) % 5U); return; }
    if (in.f[4]) { _songLoopMode = (uint8_t)((_songLoopMode + 1U) % 3U); _songDataChanged = true; return; }
    if (in.f[7]) { if (_songPlaying) _songStopRequest=true; else _songPlayRequest=true; return; }

    int16_t delta=in.encoderStep; if(in.f[5])delta=-1; if(in.f[6])delta=1;
    const int8_t d=delta>0?1:(delta<0?-1:0);
    if(d){
      const uint8_t pos=_songEditPos&15U;
      if(_songEditField==0){
        int v=_songEnd[pos]?4:(int)_songPattern[pos]; v=constrain(v+d,0,4);
        if(v==4){_songEnd[pos]=true;}else{_songEnd[pos]=false;_songPattern[pos]=(uint8_t)v;}
      }else if(_songEditField==1&&!_songEnd[pos]){
        _songRepeats[pos]=(uint8_t)constrain((int)_songRepeats[pos]+d,1,16);
      }else if(_songEditField==2){_songAction=(uint8_t)((_songAction+(d>0?1:1))&1U);
      }else if(_songEditField==3){_songLoopStart=(uint8_t)constrain((int)_songLoopStart+d,0,15);if(_songLoopEnd<_songLoopStart)_songLoopEnd=_songLoopStart;
      }else if(_songEditField==4){_songLoopEnd=(uint8_t)constrain((int)_songLoopEnd+d,(int)_songLoopStart,15);}
      _songDataChanged=true;return;
    }
    if(in.encPress){
      if(_songEditField==2){
        const uint8_t pos=_songEditPos&15U;
        if(_songAction==0){for(int i=15;i>(int)pos;--i){_songPattern[i]=_songPattern[i-1];_songRepeats[i]=_songRepeats[i-1];_songEnd[i]=_songEnd[i-1];}_songPattern[pos]=0;_songRepeats[pos]=1;_songEnd[pos]=false;}
        else{for(uint8_t i=pos;i<15;++i){_songPattern[i]=_songPattern[i+1];_songRepeats[i]=_songRepeats[i+1];_songEnd[i]=_songEnd[i+1];}_songPattern[15]=0;_songRepeats[15]=1;_songEnd[15]=true;if(_songEnd[0]){_songEnd[0]=false;_songEnd[1]=true;}}
        _songDataChanged=true;
      }else _songEditField=(uint8_t)((_songEditField+1U)%5U);
      return;
    }
    return;
  }

  if (_screen == SCR_SEQUENCER) {
    if (in.f[8]) { go(SCR_MAIN, 6); return; }
    if (in.f[7]) {
      if (_seqExternalClock) {
        // EXT mode is started only by MIDI FA. F7 is a local STOP/PANIC request.
        _seqRun = false;
        for (uint8_t t = 0; t < 4; ++t) _seqPlayhead[t] = 0;
      } else {
        _seqRun = !_seqRun;
        if (!_seqRun) for (uint8_t t = 0; t < 4; ++t) _seqPlayhead[t] = 0;
      }
      return;
    }
    // v0.7.40: F1..F4 double-click selects tracks 1..4 directly.
    // First clicks are deferred briefly so F3/F4 do not execute their normal
    // actions before a possible second click is known.
    const uint32_t clickNow = millis();
    if (_seqPendingClick && (uint32_t)(clickNow - _seqPendingClickMs) > 285UL) {
      const uint8_t b = _seqPendingClick; _seqPendingClick = 0;
      if (b == 1) _seqTrack = (_seqTrack + 3) & 3;
      else if (b == 2) _seqTrack = (_seqTrack + 1) & 3;
      else if (b == 3) _seqParam = (uint8_t)((_seqParam + 1) % 6);
      else if (b == 4) { _seqRun=false; for(uint8_t t=0;t<4;++t)_seqPlayhead[t]=0; _patternAction=0; _patternTarget=_seqPattern; go(SCR_PATTERN_MANAGER,0); return; }
    }
    for (uint8_t b=1; b<=4; ++b) if (in.f[b]) {
      if (_seqPendingClick == b && (uint32_t)(clickNow - _seqPendingClickMs) <= 285UL) {
        _seqPendingClick = 0; selectSequencerTrack((uint8_t)(b-1)); return;
      }
      if (_seqPendingClick) {
        const uint8_t oldb=_seqPendingClick; _seqPendingClick=0;
        if(oldb==1)_seqTrack=(_seqTrack+3)&3; else if(oldb==2)_seqTrack=(_seqTrack+1)&3; else if(oldb==3)_seqParam=(uint8_t)((_seqParam+1)%6);
      }
      _seqPendingClick=b; _seqPendingClickMs=clickNow; return;
    }

    uint8_t tr = _seqTrack & 3;
    uint8_t st = _seqStep & 15;

    if (in.encPress) {
      if (_seqParam == 0) {
        _seqOn[_seqPattern][tr][st] = !_seqOn[_seqPattern][tr][st];
        if (_seqOn[_seqPattern][tr][st]) {
          _seqPreviewTrack = tr;
          _seqPreviewNote = _seqNote[_seqPattern][tr][st];
          _seqPreviewVelocity = _seqVelocity[_seqPattern][tr][st];
          _seqPreviewRequest = true;
        }
      } else if (_seqParam == 5) {
        _seqExternalClock=!_seqExternalClock; _seqRun=false; for(uint8_t t=0;t<4;++t)_seqPlayhead[t]=0;
      } else {
        _seqParam = (uint8_t)((_seqParam + 1) % 6);
      }
      return;
    }

    int16_t delta = in.encoderStep;
    if (in.f[5]) delta = -1;
    if (in.f[6]) delta = 1;
    if (delta != 0) {
      const int16_t d = encSign(delta);
      const uint8_t accel = encAbs16(delta);
      if (_seqParam == 0) {
        const uint8_t len = _seqLength[_seqPattern][tr];
        _seqStep = (uint8_t)((_seqStep + (d > 0 ? 1 : (len - 1))) % len);
      } else if (_seqParam == 1) {
        const int nstep = (accel >= 5) ? 12 : 1;
        _seqNote[_seqPattern][tr][st] = (uint8_t)constrain((int)_seqNote[_seqPattern][tr][st] + d * nstep, 0, 127);
      } else if (_seqParam == 2) {
        const int vstep = (accel >= 5) ? 8 : ((accel >= 2) ? 4 : 1);
        _seqVelocity[_seqPattern][tr][st] = (uint8_t)constrain((int)_seqVelocity[_seqPattern][tr][st] + d * vstep, 1, 127);
      } else if (_seqParam == 3) {
        const int gstep = (accel >= 5) ? 10 : ((accel >= 2) ? 5 : 1);
        _seqGate[_seqPattern][tr][st] = (uint8_t)constrain((int)_seqGate[_seqPattern][tr][st] + d * gstep, 10, 100);
      } else if (_seqParam == 4) {
        _seqLength[_seqPattern][tr] = (uint8_t)constrain((int)_seqLength[_seqPattern][tr] + d, 1, 16);
        if (_seqStep >= _seqLength[_seqPattern][tr]) _seqStep = (uint8_t)(_seqLength[_seqPattern][tr] - 1);
        if (_seqPlayhead[tr] >= _seqLength[_seqPattern][tr]) _seqPlayhead[tr] = 0;
      } else if (!_seqExternalClock) {
        const int bstep = (accel >= 5) ? 10 : ((accel >= 2) ? 5 : 1);
        _seqBpm = (uint16_t)constrain((int)_seqBpm + d * bstep, 40, 240);
      }
      return;
    }
    return;
  }

  if (_screen == SCR_PATTERN_MANAGER) {
    if(in.f[8]){go(SCR_SEQUENCER);return;}
    if(in.f[4]){go(SCR_SONG_EDITOR);return;}
    if(in.f[3]){_patternAction=(uint8_t)((_patternAction+1)%3);return;}
    int16_t d=in.encoderStep;if(in.f[1]||in.f[5])d=-1;if(in.f[2]||in.f[6])d=1;if(d)_patternTarget=(uint8_t)((_patternTarget+(d>0?1:3))&3);
    if(in.f[7]||in.encPress){
      const uint8_t src=_seqPattern&3,dst=_patternTarget&3;
      if(_patternAction==0){_seqPattern=dst;_seqStep=0;for(uint8_t t=0;t<4;++t)_seqPlayhead[t]=0;go(SCR_SEQUENCER);}
      else if(_patternAction==1&&src!=dst){for(uint8_t t=0;t<4;++t){_seqLength[dst][t]=_seqLength[src][t];for(uint8_t st=0;st<16;++st){_seqOn[dst][t][st]=_seqOn[src][t][st];_seqNote[dst][t][st]=_seqNote[src][t][st];_seqVelocity[dst][t][st]=_seqVelocity[src][t][st];_seqGate[dst][t][st]=_seqGate[src][t][st];}}}
      else if(_patternAction==2){for(uint8_t t=0;t<4;++t){_seqLength[dst][t]=16;for(uint8_t st=0;st<16;++st){_seqOn[dst][t][st]=false;_seqNote[dst][t][st]=(uint8_t)(60+t*2);_seqVelocity[dst][t][st]=100;_seqGate[dst][t][st]=50;}}}
      return;
    }
    return;
  }

  if (_screen == SCR_QUATTRO) {
    if (in.f[8]) {
      // v0.7.13c FIX7: F8 behaves like the EXIT row and returns to the
      // main menu with the cursor still on QUATTRO SAMPLING.
      go(SCR_MAIN, 1);
      return;
    }
  }


  if (_screen == SCR_LOOP) {
    if (in.f[8]) {
      _loopEditMode = false;
      go(SCR_SAMPLE_EDITOR);
      return;
    }

    // v1.1.0 DEV1b: standard Phoenix encoder workflow.
    // TURN = select parameter, PUSH = enter/leave edit mode, TURN while
    // editing = change value. The encoder push must never change a value.
    if (in.encPress) {
      _loopEditMode = !_loopEditMode;
      return;
    }

    if (in.f[7]) {
      if (_playing || _recording) _stopRequest = true; else _playRequest = true;
      return;
    }

    int16_t d = in.encoderStep;
    // F1/F3 remain harmless legacy fallbacks for previous/next.
    if (in.f[1]) d = -1;
    if (in.f[3]) d = 1;
    if (d != 0) {
      if (!_loopEditMode) {
        int p = (int)_loopParam + encSign(d);
        if (p < 0) p = 1;
        if (p > 1) p = 0;
        _loopParam = (uint8_t)p;
        return;
      }

      const uint8_t sl = _selectedSlot & 3U;
      if (_loopParam == 0U) {
        uint8_t mode = (_slotLoopMode[sl] <= 2U) ? _slotLoopMode[sl] : 0U;
        mode = (uint8_t)((mode + (d > 0 ? 1U : 2U)) % 3U);
        _slotLoopMode[sl] = mode;
        _slotLoop[sl] = (mode != 0U);
      } else {
        static const uint8_t values[6] = {0,2,4,8,16,32};
        uint8_t idx=0; for(uint8_t i=0;i<6;++i) if(values[i]==_slotLoopXfadeMs[sl]) { idx=i; break; }
        idx = (uint8_t)((idx + (d > 0 ? 1U : 5U)) % 6U);
        _slotLoopXfadeMs[sl] = values[idx];
      }
      _loopChanged = true;
      return;
    }
    return;
  }

  if (_screen == SCR_TRIGGER) {
    if (in.f[8]) {
      saveSystemSettings();
      _triggerEditMode = false;
      _triggerTestActive = false;
      _triggerTestAbove = false;
      _triggerTestPrevAbove = false;
      _triggerTestTrigUntilMs = 0;
      go(SCR_SOUND, 5);
      return;
    }

    if (in.encPress) {
      _triggerEditMode = !_triggerEditMode;
      return;
    }

    if (in.f[7]) {
      if (_playing || _recording) {
        _stopRequest = true;
      } else {
        // C021: F7 is a read-only threshold test. No record request is issued,
        // so the active slot, PCM data, markers and processing state are safe.
        _triggerTestActive = !_triggerTestActive;
        _triggerTestAbove = false;
        _triggerTestPrevAbove = false;
        _triggerTestTrigUntilMs = 0;
      }
      return;
    }

    int16_t delta = 0;
    if (in.encoderStep != 0) delta = in.encoderStep;
    if (in.f[1]) delta = -1;
    if (in.f[3]) delta = 1;

    if (delta != 0) {
      if (!_triggerEditMode) {
        int p = (int)_triggerParam + encSign(delta);
        if (p < 0) p = 1;
        if (p > 1) p = 0;
        _triggerParam = (uint8_t)p;
        return;
      }

      if (_triggerParam == 0) {
        bool next = _triggerAuto;
        if (delta != 0) next = !next;
        if (next != _triggerAuto) { _triggerAuto = next; _triggerChanged = true; saveTriggerSettings(); }
      } else if (_triggerParam == 1) {
        int v = (int)_triggerLevel + triggerLevelStepFromEncoder(delta);
        if (v < 1) v = 1;
        if (v > 8) v = 8;
        if (v != (int)_triggerLevel) { _triggerLevel = (uint8_t)v; _triggerChanged = true; saveTriggerSettings(); }
      }
      return;
    }
    return;
  }

  if (_screen == SCR_DISK) {
    if (in.f[8]) {
      _diskConfirmAction = -1;
      if (_diskBankSelectAction >= 0) {
        _diskBankSelectAction = -1;
        _diskBank = _activeBank;
        _diskAction = 3;
        setDiskStatus("SELECT OPERATION");
      } else {
        go(SCR_MAIN, 4);
      }
      return;
    }
    if (_diskBankSelectAction >= 0) {
      int16_t d = in.encoderStep;
      if (in.f[5]) d = -1;
      if (in.f[6]) d = 1;
      if (d != 0) {
        // Encoder is the primary bank selector. Preserve magnitude so a fast
        // turn can move several banks while still wrapping BANK01..99.
        int bank = (int)_diskBank + (int)d;
        while (bank < 1) bank += 99;
        while (bank > 99) bank -= 99;
        _diskBank = (uint8_t)bank;
        _diskBankUsed = false;
        _diskConfirmAction = -1;
        _diskAction = 3;
        char msg[24];
        snprintf(msg, sizeof(msg), "BANK %02u CHECK", (unsigned)_diskBank);
        setDiskStatus(msg);
        return;
      }
      if (in.f[7] || in.encPress) { enterSelection(); return; }
      return;
    }
    // Menu mode: encoder moves LOAD/SAVE/DELETE/...; push opens selection.
    // Any navigation cancels a pending two-push confirmation (e.g. NEW BANK),
    // so a confirmation can never survive after the cursor moved elsewhere.
    if (in.encoderStep != 0 || in.f[1] || in.f[3]) {
      _diskConfirmAction = -1;
      setDiskStatus("SELECT OPERATION");
    }
  }

  if (_screen == SCR_SAMPLE_BROWSER) {
    if (_browserImportState == 1) {
      if (in.f[8]) { _browserImportState = 0; strncpy(_browserStatus, "IMPORT CANCEL", sizeof(_browserStatus)); _browserStatus[sizeof(_browserStatus)-1] = 0; return; }
      int16_t d = 0;
      if (in.encoderStep != 0) d = encSign(in.encoderStep);
      if (in.f[1]) d = -1;
      if (in.f[3]) d = 1;
      if (d != 0) { int v = (int)_browserImportSlot + d; if (v < 0) v = 3; if (v > 3) v = 0; _browserImportSlot = (uint8_t)v; return; }
      if (in.f[7] || in.encPress) {
        if (_slotRecorded[_browserImportSlot & 3]) { _browserImportState = 2; return; }
        _browserImportRequest = true;
        _browserImportState = 0;
        snprintf(_browserStatus, sizeof(_browserStatus), "IMPORT S%u", (unsigned)(_browserImportSlot + 1));
        return;
      }
      return;
    }
    if (_browserImportState == 2) {
      if (in.f[1] || in.f[8]) { _browserImportState = 1; return; }
      if (in.f[7] || in.encPress) {
        _browserImportRequest = true;
        _browserImportState = 0;
        snprintf(_browserStatus, sizeof(_browserStatus), "IMPORT S%u", (unsigned)(_browserImportSlot + 1));
        return;
      }
      return;
    }

    if (in.f[8]) {
      _browserPreviewStopRequest = true;
      if (!browserGoUp()) { if(_keygroupImportMode||_autoMapBrowserMode){_keygroupImportMode=false;_autoMapBrowserMode=false;go(SCR_MULTISAMPLE);} else go(SCR_DISK,4); }
      return;
    }
    if (in.f[1]) { _browserPreviewStopRequest = true; browserGoRoot(); return; }
    if (in.f[3] || in.encoderStep > 0) { moveBrowserSel(1); return; }
    if (in.encoderStep < 0) { moveBrowserSel(-1); return; }
    if (in.f[5] && _autoMapBrowserMode) {
      strncpy(_autoMapFolder,_browserPath,sizeof(_autoMapFolder)); _autoMapFolder[sizeof(_autoMapFolder)-1]=0;
      _autoMapSlot=_msSlot&3; _autoMapRequest=true; strncpy(_browserStatus,"AUTO MAPPING...",sizeof(_browserStatus)); _browserStatus[sizeof(_browserStatus)-1]=0; return;
    }
    if (in.f[6]) {
      if (_multisampleAutoMapMode) {
        strncpy(_multisampleAutoMapFolder,_browserPath,sizeof(_multisampleAutoMapFolder));
        _multisampleAutoMapFolder[sizeof(_multisampleAutoMapFolder)-1]=0;
        _multisampleAutoMapSlot=_msSlot&3;
        _multisampleAutoMapRequest=true;
        _multisampleAutoMapMode=false;
        strncpy(_browserStatus,"AUTO MAP...",sizeof(_browserStatus));
        _browserStatus[sizeof(_browserStatus)-1]=0;
        go(SCR_MULTISAMPLE);
        return;
      }
      if (_keygroupImportMode) {
        if (_browserCount == 0 || _browserSel >= _browserCount || _browserEntries[_browserSel].isDir || !_browserEntries[_browserSel].wavInfoValid) { strncpy(_browserStatus,"SELECT WAV",sizeof(_browserStatus)); _browserStatus[sizeof(_browserStatus)-1]=0; }
        else { phxJoinPath(_browserPath,_browserEntries[_browserSel].name,_keygroupImportPath,sizeof(_keygroupImportPath)); _keygroupTargetSlot=_msSlot&3; _keygroupTargetGroup=_msGroup&15; _keygroupTargetLayer=_msLayer%3; _keygroupTargetVariant=_msRrVariant&3; _keygroupImportRequest=true; _keygroupImportMode=false; go(SCR_MULTISAMPLE); }
        return;
      }
      if (_browserCount == 0 || _browserSel >= _browserCount || _browserEntries[_browserSel].isDir) {
        strncpy(_browserStatus, "SELECT WAV", sizeof(_browserStatus));
        _browserStatus[sizeof(_browserStatus)-1] = 0;
      } else if (!_browserEntries[_browserSel].wavInfoValid) {
        strncpy(_browserStatus, "UNSUPPORTED", sizeof(_browserStatus));
        _browserStatus[sizeof(_browserStatus)-1] = 0;
      } else {
        phxJoinPath(_browserPath, _browserEntries[_browserSel].name, _browserImportPath, sizeof(_browserImportPath));
        _browserImportSlot = _selectedSlot & 3;
        _browserImportState = 1;
      }
      return;
    }
    if (in.f[7] || in.encPress) {
      if (_browserCount == 0) {
        strncpy(_browserStatus, "NO FILE", sizeof(_browserStatus));
        _browserStatus[sizeof(_browserStatus)-1] = 0;
      } else if (_browserEntries[_browserSel].isDir) {
        browserOpenSelected();
      } else if (!_browserEntries[_browserSel].wavInfoValid) {
        strncpy(_browserStatus, "UNSUPPORTED", sizeof(_browserStatus));
        _browserStatus[sizeof(_browserStatus)-1] = 0;
      } else {
        phxJoinPath(_browserPath, _browserEntries[_browserSel].name, _browserPreviewPath, sizeof(_browserPreviewPath));
        _browserPreviewRequest = true;
        strncpy(_browserStatus, "PREVIEW...", sizeof(_browserStatus));
        _browserStatus[sizeof(_browserStatus)-1] = 0;
      }
      return;
    }
    return;
  }

  if (_screen == SCR_VINTAGE) {
    if (in.f[8]) { _vintageEditMode = false; go(SCR_MAIN, 5); return; }
    if (in.f[7]) { if (_playing || _recording) _stopRequest = true; else _playRequest = true; return; }
    if (in.encPress) { _vintageEditMode = !_vintageEditMode; return; }
    int16_t d = in.encoderStep;
    if (in.f[1]) d = -1;
    if (in.f[3]) d = 1;
    if (d != 0) {
      const int step = (d > 0) ? 1 : -1;
      if (!_vintageEditMode) {
        int p = (int)_vintageParam + step; if (p < 0) p = 4; if (p > 4) p = 0; _vintageParam = (uint8_t)p;
      } else {
        const uint8_t sl = _selectedSlot & 3;
        if (_vintageParam == 0) {
          int v=(int)_vintagePreset[sl]+step; if(v<0)v=7; if(v>7)v=0; _vintagePreset[sl]=(uint8_t)v;
          static const uint8_t pr[8][4]={{0,0,0,0},{4,4,1,8},{3,3,1,4},{5,4,2,12},{6,5,2,18},{7,5,3,28},{8,6,3,45},{2,2,1,3}};
          if (_vintagePreset[sl] < 7) { _vintageRate[sl]=pr[_vintagePreset[sl]][0]; _vintageBits[sl]=pr[_vintagePreset[sl]][1]; _vintageFilter[sl]=pr[_vintagePreset[sl]][2]; _vintageJitter[sl]=pr[_vintagePreset[sl]][3]; }
        } else if (_vintageParam == 1) { int v=(int)_vintageRate[sl]+step; if(v<0)v=8; if(v>8)v=0; _vintageRate[sl]=(uint8_t)v; _vintagePreset[sl]=7; }
        else if (_vintageParam == 2) { int v=(int)_vintageBits[sl]+step; if(v<0)v=6; if(v>6)v=0; _vintageBits[sl]=(uint8_t)v; _vintagePreset[sl]=7; }
        else if (_vintageParam == 3) { int v=(int)_vintageFilter[sl]+step; if(v<0)v=3; if(v>3)v=0; _vintageFilter[sl]=(uint8_t)v; _vintagePreset[sl]=7; }
        else { int v=(int)_vintageJitter[sl]+step*2; if(v<0)v=0; if(v>100)v=100; _vintageJitter[sl]=(uint8_t)v; _vintagePreset[sl]=7; }
        _vintageChanged = true;
      }
      return;
    }
    return;
  }

  if (_screen == SCR_MIDI_MONITOR) {
    if (in.f[8]) { go(SCR_MIDI_TYPE,6); return; }
    // v0.7.41d: F7 toggles MIDI Clock events in the monitor. The setting is
    // stored in NVS and defaults to HIDE for continuously clocked setups.
    if (in.f[7] || in.encPress) { phxMidiMonitorToggleClockVisible(); return; }
    return;
  }

  if (_screen == SCR_MIDI_TYPE) {
    if (_midiResetConfirm) {
      if (in.f[8]) { _midiResetConfirm=false; return; }
      if (in.f[7] || in.encPress) { phxMidiMapResetDefaults(); _midiResetConfirm=false; return; }
      return;
    }
    if (in.f[8]) {
      saveMidiControlSettings();
      saveMidiChannelSetting();
      _midiEditMode = false;
      go(SCR_MAIN, 7);
      return;
    }

    // MIDI CHANNEL is edited in place; all other rows remain simple toggles.
    if (_midiEditMode && _sel == 5) {
      if (in.f[7] || in.encPress) {
        _midiEditMode = false;
        saveMidiChannelSetting();
        return;
      }
      int16_t d = in.encoderStep;
      if (in.f[1]) d = -1;
      if (in.f[3]) d = 1;
      if (d != 0) {
        int step = (d > 0) ? d : -d;
        if (step < 1) step = 1;
        int ch = (int)_midiChannel + ((d > 0) ? step : -step);
        while (ch < 1) ch += 16;
        while (ch > 16) ch -= 16;
        _midiChannel = (uint8_t)ch;
        saveMidiChannelSetting();
      }
      return;
    }

    if (in.f[1] || in.encoderStep < 0) { moveSel(-1); return; }
    if (in.f[3] || in.encoderStep > 0) { moveSel(1); return; }
    if (in.f[7] || in.encPress) { enterSelection(); return; }
    return;
  }

  if (_screen == SCR_MIDI_CH) {
    if (in.f[8]) { saveSystemSettings(); _midiEditMode = false; go(SCR_MAIN, 7); return; }
    if (in.f[7] || in.encPress) { _midiEditMode = !_midiEditMode; return; }
    int16_t d = in.encoderStep;
    if (in.f[1]) d = -1;
    if (in.f[3]) d = 1;
    if (d != 0) {
      // v0.7.13c FIX8A: Keep MIDI CHANNEL consistent with other editors.
      // Encoder/F1/F3 change the value only after PUSH/F7 has entered EDIT mode.
      if (!_midiEditMode) return;
      int step = (d > 0) ? d : -d;
      if (step < 1) step = 1;
      int ch = (int)_midiChannel + ((d > 0) ? step : -step);
      while (ch < 1) ch += 16;
      while (ch > 16) ch -= 16;
      _midiChannel = (uint8_t)ch;
      saveMidiChannelSetting();
      return;
    }
  }

  if (_screen == SCR_PITCH) {
    if (in.f[6]) { _pitchEditMode = false; _envEditMode = false; go(SCR_ENVELOPE); return; }
    if (in.f[8]) { _pitchEditMode = false; go(SCR_MAIN, 2); return; }

    // v0.6.8 Instrument Editor Phase 1:
    // Browse mode: encoder selects SEMITONE / FINE / ROOT NOTE.
    // Edit mode: encoder changes selected parameter. Encoder push toggles mode.
    // F1/F3 follow the current mode as shortcuts. F2 resets current slot.
    if (in.encPress) {
      _pitchEditMode = !_pitchEditMode;
      return;
    }

    if (in.f[7]) {
      if (_playing || _recording) _stopRequest = true;
      else _playRequest = true;
      return;
    }

    if (in.f[2]) {
      const uint8_t sl = _selectedSlot & 3;
      _pitchSemitone[sl] = 0;
      _pitchFineCent[sl] = 0;
      _pitchRootNote[sl] = 60;
      _keyboardOctave[sl] = 0;
      _pitchTrack[sl] = true;
      _pitchBendRange[sl] = 2;
      _pitchChanged = true;
      return;
    }

    int16_t delta = 0;
    if (in.encoderStep != 0) delta = in.encoderStep;
    if (in.f[1]) delta = -1;
    if (in.f[3]) delta = 1;
    if (delta != 0) {
      const uint8_t sl = _selectedSlot & 3;
      if (!_pitchEditMode) {
        const int16_t dsel = encSign(delta);
        int p = (int)_pitchParam + dsel;
        if (p < 0) p = 5;
        if (p > 5) p = 0;
        _pitchParam = (uint8_t)p;
        return;
      }

      if (_pitchParam == 0) {
        const int16_t step = (in.encoderStep != 0) ? semitoneStepFromEncoder(delta) : delta;
        int v = (int)_pitchSemitone[sl] + step;
        if (v < -24) v = -24;
        if (v > 24) v = 24;
        if (v != _pitchSemitone[sl]) { _pitchSemitone[sl] = (int8_t)v; _pitchChanged = true; }
      } else if (_pitchParam == 1) {
        const int16_t step = (in.encoderStep != 0) ? fineStepFromEncoder(delta) : delta;
        int v = (int)_pitchFineCent[sl] + step;
        if (v < -100) v = -100;
        if (v > 100) v = 100;
        if (v != _pitchFineCent[sl]) { _pitchFineCent[sl] = (int16_t)v; _pitchChanged = true; }
      } else if (_pitchParam == 2) {
        const int16_t step = (in.encoderStep != 0) ? rootStepFromEncoder(delta) : delta;
        int v = (int)_pitchRootNote[sl] + step;
        if (v < 0) v = 0;
        if (v > 127) v = 127;
        if (v != _pitchRootNote[sl]) { _pitchRootNote[sl] = (uint8_t)v; _pitchChanged = true; }
      } else if (_pitchParam == 3) {
        const int16_t step = encSign(delta);
        int v = (int)_keyboardOctave[sl] + step;
        if (v < -2) v = -2;
        if (v > 2) v = 2;
        if (v != _keyboardOctave[sl]) { _keyboardOctave[sl] = (int8_t)v; _pitchChanged = true; }
      } else if (_pitchParam == 4) {
        bool next = _pitchTrack[sl];
        if (delta != 0) next = !next;
        if (next != _pitchTrack[sl]) { _pitchTrack[sl] = next; _pitchChanged = true; }
      } else {
        static const uint8_t ranges[7] = {1,2,3,5,7,12,24};
        int idx=0; for (int i=0;i<7;++i) if (ranges[i]==_pitchBendRange[sl]) idx=i;
        idx += encSign(delta); if (idx<0) idx=6; if (idx>6) idx=0;
        _pitchBendRange[sl]=ranges[idx]; _pitchChanged=true;
      }
      return;
    }
    return;
  }

  if (_screen == SCR_ENVELOPE) {
    if (in.f[8]) { _envEditMode = false; go(SCR_PITCH); return; }
    if (in.encPress) { _envEditMode = !_envEditMode; return; }
    if (in.f[7]) {
      if (_playing || _recording) _stopRequest = true;
      else _playRequest = true;
      return;
    }
    if (in.f[2]) {
      const uint8_t sl = _selectedSlot & 3;
      _envAttackMs[sl] = 5; _envDecayMs[sl] = 80; _envSustainPct[sl] = 100; _envReleaseMs[sl] = 80;
      _envChanged = true;
      return;
    }
    int16_t delta = 0;
    if (in.encoderStep != 0) delta = in.encoderStep;
    if (in.f[1]) delta = -1;
    if (in.f[3]) delta = 1;
    if (delta != 0) {
      const uint8_t sl = _selectedSlot & 3;
      if (!_envEditMode) {
        int p = (int)_envParam + encSign(delta);
        if (p < 0) p = 3; if (p > 3) p = 0;
        _envParam = (uint8_t)p;
        return;
      }
      int step = (in.encoderStep != 0) ? abs((int)delta) : 1;
      int sign = (delta > 0) ? 1 : -1;
      if (_envParam == 0) { int v = (int)_envAttackMs[sl] + sign * step * 5; v = constrain(v, 0, 2000); if (v != _envAttackMs[sl]) { _envAttackMs[sl] = v; _envChanged = true; } }
      else if (_envParam == 1) { int v = (int)_envDecayMs[sl] + sign * step * 10; v = constrain(v, 0, 5000); if (v != _envDecayMs[sl]) { _envDecayMs[sl] = v; _envChanged = true; } }
      else if (_envParam == 2) { int v = (int)_envSustainPct[sl] + sign * step; v = constrain(v, 0, 100); if (v != _envSustainPct[sl]) { _envSustainPct[sl] = v; _envChanged = true; } }
      else { int v = (int)_envReleaseMs[sl] + sign * step * 10; v = constrain(v, 0, 5000); if (v != _envReleaseMs[sl]) { _envReleaseMs[sl] = v; _envChanged = true; } }
      return;
    }
    return;
  }

  if (_screen == SCR_REVERB) {
    if (in.f[8]) { _reverbEditMode = false; go(SCR_EFFECTS, 1); return; }
    if (in.f[2]) {
      _reverbSize = 55;
      _reverbDecay = 55;
      _reverbDamp = 45;
      _reverbMix = 20;
      for (uint8_t i = 0; i < 4; ++i) _reverbSend[i] = 0;
      _reverbChanged = true;
      return;
    }
    if (in.encPress) {
      _reverbEditMode = !_reverbEditMode;
      return;
    }
    if (in.f[7]) {
      if (_playing || _recording) _stopRequest = true;
      else _playRequest = true;
      return;
    }

    int16_t delta = 0;
    if (in.encoderStep != 0) delta = in.encoderStep;
    if (in.f[1]) delta = -1;
    if (in.f[3]) delta = 1;
    if (delta != 0) {
      if (!_reverbEditMode) {
        int p = (int)_reverbParam + encSign(delta);
        if (p < 0) p = 7;
        if (p > 7) p = 0;
        _reverbParam = (uint8_t)p;
        return;
      }

      const int step = (in.encoderStep != 0) ? percentStepFromEncoder(delta) : delta;
      if (_reverbParam == 0) {
        int v = constrain((int)_reverbSize + step, 0, 100);
        if (v != (int)_reverbSize) { _reverbSize = (uint8_t)v; _reverbChanged = true; }
      } else if (_reverbParam == 1) {
        int v = constrain((int)_reverbDecay + step, 0, 100);
        if (v != (int)_reverbDecay) { _reverbDecay = (uint8_t)v; _reverbChanged = true; }
      } else if (_reverbParam == 2) {
        int v = constrain((int)_reverbDamp + step, 0, 100);
        if (v != (int)_reverbDamp) { _reverbDamp = (uint8_t)v; _reverbChanged = true; }
      } else if (_reverbParam == 3) {
        int v = constrain((int)_reverbMix + step, 0, 100);
        if (v != (int)_reverbMix) { _reverbMix = (uint8_t)v; _reverbChanged = true; }
      } else {
        const uint8_t si = _reverbParam - 4;
        int v = constrain((int)_reverbSend[si] + step, 0, 100);
        if (v != (int)_reverbSend[si]) { _reverbSend[si] = (uint8_t)v; _reverbChanged = true; }
      }
      return;
    }
    return;
  }

  if (_screen == SCR_ECHO) {
    if (in.f[8]) { _echoEditMode = false; go(SCR_EFFECTS, 0); return; }
    if (in.f[2]) { _echoDelayMs = 250; _echoFeedback = 35; _echoMix = 20; for (uint8_t i=0;i<4;++i) _echoSend[i]=0; _echoChanged = true; return; }

    // v0.6.6: Encoder-based parameter workflow.
    // Browse mode: encoder selects DELAY / FEEDBACK / MIX / SEND S1..S4.
    // Edit mode: encoder changes the selected value. Encoder push toggles mode.
    // F1/F3 follow the current mode as shortcuts.
    if (in.encPress) {
      _echoEditMode = !_echoEditMode;
      return;
    }

    if (in.f[7]) {
      if (_playing || _recording) _stopRequest = true;
      else _playRequest = true;
      return;
    }

    int16_t delta = 0;
    if (in.encoderStep != 0) delta = in.encoderStep;
    if (in.f[1]) delta = -1;
    if (in.f[3]) delta = 1;
    if (delta != 0) {
      if (!_echoEditMode) {
        const int16_t dsel = encSign(delta);
        int p = (int)_echoParam + dsel;
        // v0.7.18c: three global parameters plus four per-slot sends.
        if (p < 0) p = 6;
        if (p > 6) p = 0;
        _echoParam = (uint8_t)p;
        return;
      }

      if (_echoParam == 0) {
        const int16_t step = (in.encoderStep != 0) ? delayStepMsFromEncoder(delta) : (delta * 10);
        int v = (int)_echoDelayMs + step;
        if (v < 50) v = 50;
        if (v > 2000) v = 2000;
        if (v != (int)_echoDelayMs) { _echoDelayMs = (uint16_t)v; _echoChanged = true; }
      } else if (_echoParam == 1) {
        const int16_t step = (in.encoderStep != 0) ? percentStepFromEncoder(delta) : delta;
        int v = (int)_echoFeedback + step;
        if (v < 0) v = 0;
        if (v > 90) v = 90;
        if (v != (int)_echoFeedback) { _echoFeedback = (uint8_t)v; _echoChanged = true; }
      } else if (_echoParam == 2) {
        const int16_t step = (in.encoderStep != 0) ? percentStepFromEncoder(delta) : delta;
        int v = (int)_echoMix + step;
        if (v < 0) v = 0;
        if (v > 100) v = 100;
        if (v != (int)_echoMix) { _echoMix = (uint8_t)v; _echoChanged = true; }
      } else {
        const uint8_t sl = _echoParam - 3;
        const int16_t step = (in.encoderStep != 0) ? percentStepFromEncoder(delta) : delta;
        int v = (int)_echoSend[sl] + step;
        if (v < 0) v = 0;
        if (v > 100) v = 100;
        if (v != (int)_echoSend[sl]) { _echoSend[sl] = (uint8_t)v; _echoChanged = true; }
      }
      return;
    }

    return;
  }

  if (_screen == SCR_SAMPLE_EDITOR) {
    const uint8_t sl = _selectedSlot & 3;
    const uint32_t frames = _slotFrames[sl];
    if (in.f[8]) { go(SCR_SOUND, 4); return; }

    if (frames == 0) {
      if (in.f[5]) _editorMarker = (uint8_t)((_editorMarker + 1U) & 3U);
      return;
    }

    uint32_t sampleStart = _slotSampleStart[sl];
    uint32_t sampleEnd = _slotSampleEnd[sl];
    uint32_t loopStart = _slotLoopStart[sl];
    uint32_t loopEnd = _slotLoopEnd[sl];
    if (sampleEnd == 0U || sampleEnd > frames) sampleEnd = frames;
    if (sampleStart >= sampleEnd) sampleStart = 0U;
    if (loopStart < sampleStart) loopStart = sampleStart;
    if (loopEnd == 0U || loopEnd > sampleEnd) loopEnd = sampleEnd;
    if (loopEnd <= loopStart + 1U) {
      loopStart = sampleStart;
      loopEnd = sampleEnd;
    }

    auto markerCursor = [&](uint8_t marker) -> uint32_t {
      if (marker == 0U) return sampleStart;
      if (marker == 1U) return loopStart;
      if (marker == 2U) return loopEnd ? loopEnd - 1U : 0U;
      return sampleEnd ? sampleEnd - 1U : 0U;
    };

    if (_editorCursor >= frames) _editorCursor = frames - 1U;

    if (in.f[1]) { _sampleProcessingSlot = sl; _sampleProcessingAction = 0; return; }
    if (in.f[3]) { _sampleProcessingSlot = sl; _sampleProcessingAction = 1; return; }
    if (in.f[4]) { _sampleProcessingSlot = sl; _sampleProcessingAction = 2; return; }
    if (in.f[2]) {
      _editorZoom = (_editorZoom == 1) ? 2 : (_editorZoom == 2) ? 4 : (_editorZoom == 4) ? 8 : 1;
      return;
    }
    if (in.f[6]) { _loopParam = 0; _loopEditMode = false; go(SCR_LOOP); return; }

    if (in.f[5]) {
      _editorMarker = (uint8_t)((_editorMarker + 1U) & 3U);
      _editorCursor = markerCursor(_editorMarker);
      return;
    }

    // C016: Encoder press snaps the selected marker to the nearest real
    // zero crossing. Turning the encoder remains immediate live editing.
    if (in.encPress) {
      _zeroCrossSnapSlot = sl;
      _zeroCrossSnapMarker = _editorMarker & 3U;
      _zeroCrossSnapFrame = markerCursor(_editorMarker);
      _zeroCrossSnapPending = true;
      return;
    }

    if (in.f[7]) {
      if (_playing || _recording) _stopRequest = true;
      else _playRequest = true; // audition complete Sample Start -> Sustain Loop -> Sample End
      return;
    }

    int32_t move = 0;
    const uint32_t onePixelStep = (frames / 88UL) ? (frames / 88UL) : 1UL;
    const uint32_t buttonStep = onePixelStep * 4UL;
    if (in.encoderStep != 0) {
      const int16_t d = in.encoderStep;
      const int16_t a = d < 0 ? -d : d;
      uint32_t mul = 1U;
      if (a >= 10) mul = 16U;
      else if (a >= 5) mul = 8U;
      else if (a >= 2) mul = 3U;
      const uint32_t step = onePixelStep * mul;
      move = (d > 0) ? (int32_t)step : -(int32_t)step;
    }

    if (move != 0) {
      const PhoenixSampleMarkerEditResult edit = phxMoveSampleMarker(
          frames, sampleStart, loopStart, loopEnd, sampleEnd,
          _editorMarker, _editorCursor, move);
      _editorCursor = edit.cursor;
      _slotSampleStart[sl] = edit.sampleStart;
      _slotLoopStart[sl] = edit.loopStart;
      _slotLoopEnd[sl] = edit.loopEnd;
      _slotSampleEnd[sl] = edit.sampleEnd;
      // C011: publish one coherent four-marker edit with the slot captured at
      // the moment of the encoder movement. The OS must not reconstruct the
      // request later from a mutable selected-slot value.
      _sampleMarkerEditSlot = sl;
      _sampleMarkerEditSampleStart = edit.sampleStart;
      _sampleMarkerEditLoopStart = edit.loopStart;
      _sampleMarkerEditLoopEnd = edit.loopEnd;
      _sampleMarkerEditSampleEnd = edit.sampleEnd;
      _sampleMarkerEditPending = true;
      if (edit.sampleChanged) _sampleRangeChanged = true;
      if (edit.loopChanged) _loopRangeChanged = true;
      return;
    }
    return;
  }

  if (_screen == SCR_WAVE) {
    if (in.f[8]) { go(SCR_SOUND, 3); return; }
    if (in.f[1]) {
      _waveZoom = (_waveZoom == 1) ? 2 : (_waveZoom == 2) ? 4 : (_waveZoom == 4) ? 8 : 1;
      return;
    }

    // v0.6.0 Waveform Editor:
    // F7 toggles Play/Stop directly in Draw Waveform.
    // Encoder moves the edit cursor while stopped; encoder press plays from cursor.
    if (in.encoderStep != 0 && !_playing && _sampleFrames > 0) {
      const uint32_t baseStep = (_sampleFrames / 96UL) ? (_sampleFrames / 96UL) : 1UL;
      const uint32_t step = baseStep * (uint32_t)encAbs16(in.encoderStep);
      if (in.encoderStep > 0) {
        uint32_t nf = _waveCursorFrame + step;
        _waveCursorFrame = (nf >= _sampleFrames) ? (_sampleFrames - 1) : nf;
      } else {
        _waveCursorFrame = (_waveCursorFrame > step) ? (_waveCursorFrame - step) : 0;
      }
    }
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
