RealTimeAudioLab/RTAL-EAI-004-Phoenix-Sound-Sampler/firmware/Phoenix_v1.1.0/src/PhoenixSystem/PhoenixDiagnostics.h

#pragma once
#include <Arduino.h>

// Project Phoenix v1.0.0 FINAL
// Lightweight, serial-only system diagnostics. No permanent buffers are used.
class PhoenixDiagnostics {
public:
  static void printBootSnapshot(const char *stage, uint8_t smartMode);

private:
  static const char *smartModeName(uint8_t mode);
  static void printBytes(const __FlashStringHelper *label, uint32_t bytes);
};
